andrenepomuceno/esp_garden/docs/architecture.md

# Project at a glance

ESP32 firmware for an automatic garden: soil moisture + luminosity + DHT11 + optional water level, a watering relay, a local async web dashboard, ThingsBoard MQTT/TLS telemetry, ThingsBoard RPC for remote commands, and browser OTA. **The ThingSpeak uplink and TalkBack are compiled OUT by default** since 2.12.0 — see [ThingSpeak and TalkBack are behind flags](telemetry.md).

| Layer | Path | Role |
|---|---|---|
| Entry point | `src/main.cpp` (108 lines) | Relay safe-init, device id, filesystem, config, logger backup, `webSetup()`, `tasksSetup()` |
| Orchestration | `src/tasks.cpp` (746) | **The single task-registration site.** Every `DECLARE_TASK`, every handler body, `tasksSetup()`, `tasksLoop()`, schedules, connectivity. **Every `g_*Task` object is `static` here**, so the file holding the registration order is also the only file that can arm, park or re-period a task |
| Task events | `src/task_events.cpp` (305), `include/core/task_events.h` | The asynchronous half of the io tick, and the two relay seams that feed it: `relayStartAllowed()`, `relayStartedHook()`, the relay / float / cloud / ET0 event publishers, and the post-watering response check. No `DECLARE_TASK`, no handler, no registration — it is what a handler DOES, not when it runs |
| Relays | `src/relays.cpp` (300) | Relay state under `g_relayMux`, `startRelay`/`stopRelay`/`startWatering`, the 50 ms critical tick |
| Sensors | `src/sensors.cpp` (547) | Every ADC read, the flow ISR, the float switch, the ambient sensor and its plausibility gate, `moistureState()` |
| Ambient — SHT40 | `src/sht4x.cpp` (I2C transport), `include/core/sht4x_protocol.h` (**pure maths, host-tested**) | The carrier's only temperature/humidity part. Hand-rolled: one command byte, a delay, six bytes, two CRC8s. Feeds the SAME accumulators and the SAME `temperature`/`airHumidity` keys as the DHT |
| Telemetry | `src/telemetry.cpp` (587), `include/core/step_publisher.h` | ThingSpeak field constants, `mqttAddField`, the periodic ThingsBoard payload, the change-based step publisher, the publish queue |
| Config | `src/config.cpp` (940), `include/core/config.h` | `ConfigFile` singleton + `g_*` reference aliases for the non-pin fields |
| Config — pins | `src/config_pins.cpp`, `include/core/pin_rules.h`, `include/core/default_pins.h` | What a GPIO can do, and the boot-time audit that applies it. One place, three consumers. Both headers are **per MCU family** and Arduino-free — the rules, and the compiled DEFAULT map a board uses until its `config.json` says otherwise; `config_pins.cpp` and `config.cpp` each pick one from `CONFIG_IDF_TARGET_*` |
| Config — `io` | `src/config_io.cpp` | Parsers for the `io` block, where every entry accepts several shapes so a field device keeps loading after a firmware update |
| Config — save | `src/config_document.cpp` | Whole-document validation before a write: the save-time counterpart of `loadFile()` |
| Logging | `src/logger.cpp` | Level-filtered singleton, 8 KB rolling RAM buffer, LittleFS backup rotating over 4 files |
| Web | `src/web.cpp` (573) | WiFi events, mDNS, `AsyncWebServer`, **the mode decision and the route table**, `/control`, `/logs`, `/history.json` |
| Web handlers | `src/web_data.cpp`, `web_config.cpp`, `web_ota.cpp`, `web_users.cpp` | `/data.json` cache · masked `GET`/`POST /config.json` · browser OTA · `/users.json` |
| Onboarding | `src/web_onboarding.cpp`, `include/core/onboarding.h`, `include/core/onboarding_templates.h` | The first-boot setup AP: the compiled page, the compiled per-family board templates, the captive-portal DNS and `POST /onboarding`. **WHEN it runs is `onboarding::decide()`, Arduino-free and host-tested**; the templates are a second per-family table selected from `CONFIG_IDF_TARGET_*`, exactly as `pin_rules.h` and `default_pins.h` are. See [First-boot onboarding](onboarding.md) |
| Auth | `src/custom_login.cpp`, `src/user_store.cpp` | Nonce + SHA-256 login, role middleware, per-IP lockout, `/users.json`, `/sessions.json` — ported from fullbot |
| MQTT | `src/mqtt.cpp` | Transport only: `PubSubClient` over TLS or plain, reconnect backoff, buffer sizing. `mqtt.backend` picks ThingSpeak `channels/<id>/publish` or ThingsBoard `v1/devices/me/telemetry`; `mqttBackendSupported()` refuses a backend this BUILD has no code for |
| ThingsBoard | `src/thingsboard.cpp` (791) | The downlink half: client/shared attributes, two-way RPC, the chunked `v2/fw` firmware stream |
| Versions | `src/fw_version.cpp` | Semantic-version compare — the check deciding whether a cloud image is flashed. Host-tested |
| TalkBack | `src/talkback.cpp` | Hand-rolled HTTP/1.1 POST to `api.thingspeak.com` (**plain HTTP, port 80**). **The whole translation unit is behind `USE_TALKBACK`, which ships at 0** — it compiles to nothing |
| History | `src/io_history.cpp`, `include/core/segment_index.h` | Append-only segments of I/O snapshots on LittleFS, served by `/history.json` |
| Moisture model | `src/moisture_classifier.cpp` (pure maths, host-tested), `src/moisture_model.cpp` (869; training, persistence) | Gaussian naive Bayes per probe, labelled by watering events. See [Soil moisture](soil-moisture.md) |
| Cloud cover | `src/cloud_cover.cpp` (pure maths, host-tested), `src/cloud_model.cpp`, `include/core/clear_sky_table.h` (**generated**) | Clearness index against an empirical clear-sky envelope. See [Cloud cover](cloud-cover.md) |
| Evapotranspiration | `src/evapotranspiration.cpp` (pure maths, host-tested), `src/et0_model.cpp` | Daily Hargreaves-Samani ET0 from the device's own temperature extremes. See [Evapotranspiration](evapotranspiration.md) |
| Stats | `src/accumulator_v2.cpp` | Fixed-size ring: rolling window mean + variance, allocating once |
| Web sources | `data/` | Plain, diffable, served as-is by the simulator. `index.*`, `login.*`, `config.*`, `users.*`, `update.*`, `auth.js`; vendored `jquery.js`, `sha256.js`, `spark-md5.js`, `bootstrap.css` (all MIT, shipped `.gz`); `favicon.ico`, `*.pem`, `config.template.json` |
| Filesystem image | `scripts/build_assets.py` → `.pio/assets/` | Bundles each page's scripts into one file and gzips everything the web server serves. `data_dir` points the image here, so `-t buildfs` cannot pack the unbundled sources |
| Partitions | `partitions/esp_garden_4mb.csv` | 1.69 MB per OTA slot, 512 KB LittleFS. **Cannot be changed over OTA** |
| Filesystem | `include/core/filesystem.h` | The one line naming the driver. Everything else says `FILESYSTEM`, never `LittleFS` |
| Tooling | `scripts/` | `dev_server.py` + `sim_state.py` / `sim_moisture.py` / `sim_config.py` / `sim_auth.py` (host simulator of the device HTTP API) · `provision_config.py` (turns a board template into that device's own `data/config.json`, reading the `ID:` boot line off the serial port and **refusing every document that would brick the board**, naming the check that refused) · `check_lines.py` (the file-size gate) · `moisture_calibration.py` · `moisture_fit.py` + `moisture_stats.py` + `moisture_thermal.py` + `moisture_thermal_report.py` (PC-side moisture fit; **refuses to emit a parameter the data cannot support**, naming the check that refused. The `thermal` pair asks whether ambient temperature biases a resistive probe and answers that this archive cannot say — it ships two admission GATES and no correction; see [Temperature IS a plausible confound](soil-moisture.md)) · `drying_fit.py` + `drying_models.py` + `drying_evidence.py` (the same shape aimed at the FALL: isolates genuine drying segments, fits linear / exponential / double-exponential / exponential-plus-linear against each other and **refuses an asymptote the data does not constrain** — it ran on the whole archive and refused every segment. `drying_models.py` is the four models and the fit; `drying_evidence.py` is the model comparison, the profile likelihood, the bootstrap and the trim check — split when the pair crossed the 1000-line gate) · `cloud_fit.py` (fits the clear-sky reference, writes the generated header) · `et0_fit.py` (geocodes `postalCode`, scores the device's ET0 against a public station — allowed to answer "do not enable this", and did) · `feeds_plot.py` · `tb_export.py` (incremental ThingsBoard → SQLite archive in `backups/`) · `tb_import.py` + `tb_client.py` (the WRITER, pointing the other way: that archive into a ThingsBoard instance, for the 2026-09-17 move off the Cloud tenant. Backdates through `POST .../timeseries/ANY`, **refuses to write at or after the archive's own newest point**, verifies by COUNTING both sides per key rather than by an HTTP status, and **reports the seam per key without stitching it**. `tb_client.py` is the session and the request body; split when the pair crossed the 1000-line gate. See [The migration off ThingsBoard Cloud](thingsboard-migration.md)) · `tb_swap_keys.py` + `tb_swap_model.py` (the same discipline aimed at a LABELLING error rather than a move: exchanges two telemetry keys over a closed past window, for the 2026-09-21 crossed probes. **Relabelling, not interpolation** — nothing is created or destroyed, the (timestamp, value) multiset is identical afterwards and `--verify` says so; the operation is a permutation and `--probe` proves on a throwaway device that applying it twice restores the original exactly. **Dry run by default**, re-emits each archived literal verbatim so ThingsBoard repeats its own typing decision, and **refuses a window boundary the stored series does not corroborate** — which is what it did to the boundary it was handed. `tb_swap_model.py` is the permutation, every refusal and the boundary evidence, network-free; split when the pair crossed the 1000-line gate) · `history_export.py` + `history_archive.py` + `history_store.py` (the same shape aimed at the DEVICE's own 60 s record: pages `GET /history.json` into `backups/history.sqlite` without duplicating or dropping a record across a segment rotation, and reports every gap rather than stitching it. `history_archive.py` is the walk, the buffer rule and the fit adapter; `history_store.py` is the SQLite half; split when the pair crossed the 1000-line gate. See [The 60 s record](soil-moisture.md)) · `device_http.py` (the nonce + SHA-256 client, shared by `moisture_fit.py` and `history_export.py` instead of copied) · `telemetry_ui.py` + `telemetry_page.py` (local read-only browser for that archive on **:8090**) · `flash_clone.py` + `flash_image.py` (the same discipline aimed at the WHOLE FLASH over USB, because no web endpoint can read one back: `read_flash 0 ALL` into `backups/flash/` with a sha256 manifest and the partitions split out, and `write_flash` the other way. **`--plan` is the default and a write needs `--yes`**; a backup **refuses without relay-safety evidence**, because download mode stops the app and a reset on a board with a running pump is the one thing not to do. It verifies by **re-reading the flash and comparing hashes**, never by esptool's exit code, and `--patch-id` rewrites the four-character `id` inside the image's LittleFS region so a clone boots as the board it replaces instead of into the setup portal — refusing unless the literal occurs EXACTLY ONCE, the length is unchanged, and the diff is provably surgical. `flash_image.py` is the image format and every refusal that is a pure function of an image: the partition-table parser checked against this repo's own CSVs, the `esp_app_desc_t` reader, the id arithmetic, the otadata slot rule and the LittleFS region scan — it opens no port, runs no subprocess and makes no request, which is why the 125-check `--self-test` lives against it; split when the pair crossed the 1000-line gate) |

**No source file exceeds 1000 lines, and `python scripts/check_lines.py` is what says so.** The rule sat here unenforced long enough that two files crossed it unnoticed — the gate exists because the honour system had already failed. It prints the largest files on success too: a failure arrives when the split is expensive, and the useful signal is the file three commits away from crossing. `tasks.cpp` (1123 and again at 998), `web.cpp` (1004), `config.cpp` (1125) and `devices.js` (1155) were all split at that threshold. `tasks.cpp` kept every `DECLARE_TASK` and every handler and `web.cpp` kept `webSetup()`, in both cases because the ordering *inside* those functions is load-bearing.

**`tasks.cpp` crossed a second time, and the second split says something the first did not.** It reached 998 of 1000 because two sessions grew it independently — one adding the `ambient` task for the SHT40, the other `tasksSetupOnboarding()` — and neither could see the other, so the next change to the file would have broken the build for a reason unrelated to that change. The seam is `src/task_events.cpp`: **the io tick's EVENT half plus the two relay seams**, which is everything in the file that was never about scheduling. Not one `DECLARE_TASK`, handler body or `addTask()` moved, `ioTaskHandler()` and `tasksSetup()` are byte-identical, and the registration order is still one readable list in one file. What the move BUYS beyond lines: `g_moistureBeforeWatering` stopped being a file-scope array visible to nine handlers and became `static` beside the hook that fills it and the check that reads it, and **every `g_*Task` object stayed in `tasks.cpp`** — the one reference that had to cross the seam goes through `armMoistureCheck()`, a named function, rather than reaching for a scheduler object from another translation unit.

Host tests live in `test/` and run under **`[env:native]`** (`pio test -e native`). Coverage is `AccumulatorV2`, the history segment arithmetic, firmware-version comparison, the moisture classifier, the probe-health verdict, the cloud-cover classifier, the evapotranspiration maths, the step-publisher change detection, the per-family pin rules, the SHT4x wire protocol and the onboarding decision plus its compiled templates — everything else reaches WiFi, LittleFS, `Arduino_JSON` or FreeRTOS. **The pattern for making something testable is to put the arithmetic in an Arduino-free header** (`segment_index.h`, `step_publisher.h`, `pin_rules.h`) rather than to stub the platform: a stub is small enough to look obviously right and wrong in a way that produces plausible answers instead of failures. See [test/README.md](../test/README.md).
