andrenepomuceno/esp_garden/docs/soil-moisture-sampling.md

# Soil moisture sampling period

`io.soilMoisturePeriodSec` — seconds between reads of the probe bank.
Default **1**. Editable in `/config.html`, under the **Io** tab.

Added in firmware 2.21.0. The two-phase read and the removal of the 250 ms
settle cap are 2.22.0. Several samples per window, `io.soilMoistureSampleMs` and
`io.soilMoistureTailSamples`, are 2.23.0. The value at exactly the settle and
the `timing` block are 2.24.0.

---

## The value at the settle, not at the wake (2.24.0)

**The problem.** No probe on `cfd0` reaches a plateau within the window. At
2000 ms the reading still climbs 2 to 19 counts per 100 ms, so a final sample
taken late reads drier.

The task is cooperative, and other tasks hold the scheduler:

- **`checkInternet` held it for ~1.06 s every 15 s.** It called
  `Ping.ping(addr, 2)`, and ESP32Ping waits `PING_DEFAULT_INTERVAL` (1 s)
  between the two pings.
- **Something else holds it for 180–400 ms, about every 1.2 s.** Not
  identified yet.

On Espada, 22 % of 2.22.0's published samples sat more than 0.6 points below
their neighbours (median 0.94 points, up to 3.98). A probe repeats to ±1–3
counts, so that is timing, not noise.

**Two fixes.**

- **`Ping.ping(addr, 1)`.** The three addresses are already the retry, so the
  1 s wait between two pings to the same address bought nothing. On a dead
  link the cost is now three of the library's 1 s ping timeouts instead of
  six plus three 1 s waits. That is arithmetic from the library source; a dead
  link has not been timed. A link is declared lost after three missing replies
  instead of six.
- **The published value is read at exactly `settleMs`.** It is the linear
  interpolation between the last sample at or before the settle and the late
  final (`probe_sampling::valueAt`). An on-time final is returned unchanged. A
  window with nothing before the settle cannot be interpolated and is
  published raw, as before. That is the default, `soilMoistureSampleMs` 0; the
  correction needs a window. With a tail above 1, the median runs over the
  last N samples with the final replaced by its value at the settle
  (`settledValue`).

The near-linear creep at the end of the window is what makes a straight line
the right model there. Over a 1 s gap on Espada the error is a few counts,
against the 40–160 the late reading cost.

**What is visible.** Each probe's `capture` block carries `rawAdc`, the
uncorrected final sample, beside `settledAdc`, the published value. A
top-level `timing` block covers the window as a whole:

| key | meaning |
|---|---|
| `settleMs` | the settle the last window was read at |
| `lastLateMs` | how far past it the last final sample landed |
| `windows` | windows completed since boot |
| `lateWindows` | how many of them were late |
| `lateMaxMs` | the latest one |
| `lateTotalMs` | the sum, so a mean is `lateTotalMs / lateWindows` |

**A settle under the 50 ms floor is late on every window, by design.** The
compiled 10 ms is read at 50 ms, so it reports 40 ms late each time. That is
true, and there is nothing to correct it with: there is no sample before the
settle to interpolate from.

**A spike in the bracketing sample leaks in only when the final is late**, and
then in proportion to how late. An on-time window publishes the final sample
alone. A tail above 1 is the guard against spikes.

**Probe health still sees the raw final sample**, for the reason given below.

---

## Several samples per window (2.23.0)

| key | default | meaning |
|---|---|---|
| `io.soilMoistureSampleMs` | **0** | a conversion every N ms while the bank is energised. 0 is a single one at the end of the settle, which is 2.22.0 exactly |
| `io.soilMoistureTailSamples` | **1** | the reading is the MEDIAN of the last N samples of the window. 1 is the last sample, which is 2.22.0 exactly |

With `settleMs` 2000 and a sample every 100 ms the bank is read at 100, 200, …,
2000 ms: twenty samples, the last on the settle. An interval that does not
divide the settle still ends on it (2000 / 300: 300 … 1800, 2000), and one
longer than the settle is a single sample. A bank with no power pin, or held up
by `powerAlways`, has no window and is read once, as before.

**Why it exists.** On `cfd0` every change of the acquisition time stepped all
four probes at once, by up to ~420 ADC counts, and a longer powered time always
read drier (the table is in [What has actually run](verification-log.md),
2026-11-09). Nobody knew where
the output stops moving, and every config experiment cost a reboot and a seam in
the data. The window answers it at every reading for no extra powered time.

**What is reported.** The median of the tail, not the mean of the window: the
reading is still rising during the window, so a mean would mix the transient in
and depend on the curve's shape. With the defaults nothing about the published
value changes. Turning the curve on (`soilMoistureSampleMs` alone) does not start
a new calibration epoch. From 2.24.0 it changes only the windows whose final
sample was late, and moves each back to what an on-time sample would have read. Raising `soilMoistureTailSamples` does. A tail
longer than the window uses every sample it holds, and `/moisture.json` says how
many (`tailUsed`).

**Timing is recorded, not assumed.** The task is cooperative, so a wake can land
late behind a ping or an MQTT drain. Each sample carries the milliseconds since
the bank came up as actually measured; a late wake takes one sample at the late
time and goes on to the next point of the schedule, it does not burst to catch
up, and the window still ends at the first wake at or after the settle. The
50 ms task floor is the finest real spacing: an interval below it is accepted
and simply measured at 50 ms (2000 / 10 is forty samples, not two hundred).
**The final sample is the one wake NOT held to the floor**, when samples came
before it: with a 199 ms grid the last one is at 1990 and the final still lands
on 2000, where a floored wait would have read at ~2040 and moved the published
value. With no window samples the floor applies exactly as in 2.22.0, so a
10 ms settle is still energised for 50 ms. The whole schedule —
`begin`/`step`/`waitMs` in `probe_sampling.h` — is host-tested against the floor;
`moistureTaskHandler()` only calls it.

**Probe health still sees one raw conversion**, the window's last, whatever the
tail. Its 400-count floating-pin threshold was measured on single conversions,
and a median of twenty would shrink a floating pin's spread under it.

**Refusals.** Either key that is not a JSON number, or out of range, is a boot
warning that names the value received, and the previous value is kept — a
string `"100"` does not become 0 in silence. A tail larger than the window can
produce is accepted and warned about at boot with the count the median will
actually use.

**Capacity is 64 samples per probe**, `probe_sampling::kCapacity`, and it is
storage, not a judgement: 4 probes x 64 x 4 bytes, held twice (the working
window and the snapshot other threads read), is ~2 KB of static RAM. A window
with more samples keeps the NEWEST 64 — the end of the curve, where the reading
is taken — and `dropped` counts the rest. The tail is refused outside 1..64 at
boot, with the previous value kept, because it cannot exceed what is stored.
The interval accepts 0..65535 like `settleMs`.

**`/moisture.json` carries it per probe** under `capture`: `intervalMs`,
`tailSamples`, `tailUsed`, `settledAdc` (the reported value in ADC counts,
before the polarity flip), `rawAdc` (the final sample as read, 2.24.0),
`dropped` and `count`. The window-level `timing` block is described in the
2.24.0 section above. The curve itself — the
parallel arrays `ms` and `adc`, `[]` before the first window — is added only
with **`?capture=1`**: at 64 samples on four probes it is ~512 cJSON nodes, tens
of KB of small allocations on a WROOM-32 whose largest free block is ~53 KB,
and the moisture page polls this endpoint. It is the last completed window,
published under the same spinlock as the reading. Telemetry and the history
record are unchanged: one value per reading.

The boot log now names the acquisition actually performed, e.g. `Soil moisture
every 60 s, settle 2000 ms, 20 sample(s) per window (every 100 ms), median of
the last 1` — the coalesced settle of the pins that switch, not every probe's
configured one, so a bank with no power pin logs `settle 0 ms, 1 sample(s)`.
Until 2.23.0 only the period was logged, so the 10-02 and 10-16 changes on
`cfd0` could not be read back from the device's own logs.

---

## The task sleeps until the next event, and is reentrant

It does **not** tick at the sampling period, and it does not poll. `delay()`
inside a task is forbidden here — background tasks are cooperative, so a
handler that sleeps stalls every other one for its duration — and the probe
bank needs a settle between energising its power pin and reading it.

So the handler carries its state in statics and does a little each call:

| state | what happens |
|---|---|
| the sample is due | energise the bank, note when it came up, return |
| still settling, a window sample is due | read the probes into the window, return |
| still settling, nothing due | return |
| the settle has elapsed | read once more, take the tail median, de-energise, return |
| nothing due | return |

and then sets its own period to the time until whichever deadline is next, so
the scheduler wakes it once per window sample plus once to power up, rather
than polling — twice per reading with the default single sample. **The
reentrancy is the contract and the period is only an optimisation**: woken
early it returns, woken late it acts, and a config change takes effect at the
next wake-up either way.

`g_moistureTaskPeriod` (50 ms, the tick the relays run at) is the floor, which
keeps the task from spinning when something is already overdue.

Measured on the state machine over 600 s, with the scheduler polled every 1 ms:

| period | settle | reads | wake-ups | gap | duty |
|---|---|---|---|---|---|
| 1 s | 50 ms | 600 | 1201 | 1000 ms | 5.00 % |
| 1 s | 10 ms | 600 | 1201 | 1000 ms | 5.00 % |
| 1 s | none | 601 | 601 | 1000 ms | 0 % |
| 5 s | 50 ms | 120 | 241 | 5000 ms | 1.00 % |
| 60 s | 50 ms | 10 | 21 | 60000 ms | 0.08 % |

Two wake-ups per sample, one when the settle is zero, and the gap is exactly
the configured period every time. A fixed 50 ms tick would have been 12 000
wake-ups in each of those rows; at a 60 s period this is **21 instead of
12 000**.

`nextSample` is stamped at the **power-up**, not at the read, which is what
makes the gap exactly `io.soilMoisturePeriodSec` rather than that plus the
settle.

**The 50 ms floor is also the settle's granularity.** A settle below it is
rounded up, so the compiled default of 10 ms energises the bank for 50 ms and
measures 5.00 % duty rather than 1.00 %. It is more settle than asked for,
which harms the reading not at all, and five times the power-on, which is
still twenty times better than the ungated 100 %. The carrier asks for 50 ms,
so the board this runs on is unaffected.

**`setPeriod()` is what the scheduler honours from inside a handler, and
`enableDelayed()` is not** — `Task::run()` calls the callback and then
overwrites `_nextRunTime = endTime + _period`, discarding anything the handler
set through `enableDelayed()`. That is why this sets the period.

## Why it is its own task

The probe read used to live in the `io` task, at 1 Hz. That task also:

- rebuilds the `/data.json` cache,
- publishes the relay, float, cloud and ET0 events,
- runs the step publisher,
- flushes the deferred `/sessions.json` write,
- computes the flow rate, which divides by the io period.

None of that may slow down because somebody wanted the ADC read less often, so
the probe block moved to a `moisture` task that takes its period from the
config. `sensorsReadIo()` keeps luminosity, water level, flow and the float.

Both are background tasks and the scheduler runs at most one per `execute()`,
so `webUpdateDataCache()` reading accumulators the moisture task writes is the
arrangement the `ambient` task has had since 2.14.0 — not a new race.

Background task count went 11 of 16 (12 with `USE_TALKBACK`).

## Accepted range

**1..10000 s.** Zero and negatives are refused because the value divides; the
upper bound only rejects absurd input. Out of range is a boot warning and the
previous value is kept — the same shape `history.periodSec` has. It is **not**
refused at save time, for the same reason the history capacity clamp is not:
the stored document is the operator's intent.

## What follows the period

The moisture accumulator window is `mqttPublishPeriodMs() / period`, floored
at 1. The floor is load-bearing: `AccumulatorV2::setMaxLen(0)` is a silent
no-op that would leave the window at whatever the constructor set.

`mqtt.publishSec` is clamped to 60..300. A sampling period longer than the
publish period therefore makes the window bottom out at 1, and the published
`moistureN` stops being a mean over a publish interval and becomes a single
sample. That is a consequence to know about, not a refusal.

## `settleMs` is 0..65535 and that is the storage, not a judgement

It used to be capped at 250 ms, on the argument that the delay ran inside the
1 Hz io task and a probe needing more was one to read less often. Moving the
read to its own task made the first half of that false, and removing the delay
made the second half moot. The range is now the one its `uint16_t` holds.

A settle longer than the sampling period is accepted. It degrades rather than
breaking: 2000 ms against a 1 s period measures 292 reads over 600 s, a
2050 ms cadence, and the bank powered 97 % of the time — which is the
continuous-power condition that dissolves a resistive electrode. That is a
consequence to know, not a value to refuse.

## What does NOT follow the period

`g_probeHealthMinSamples` (120) and `g_probeHealthWindow` (600) in
`src/sensors.cpp` are counted in **samples**, not seconds. At 1 Hz they are
2 min and 10 min; at 30 s they are 1 h and 5 h. The statistic is unaffected —
the wait for a first verdict grows, and the evidence ages more slowly.

### The 400-count threshold does not bound this setting

`g_probeHealthMaxSd` = 400 ADC counts flags a probe whose reading jumps further
between consecutive conversions than soil can. A slower period concentrates a
physical event into fewer, larger steps, so it is fair to ask whether a
watering starts to look like a floating pin.

It does not. Measured against the real `src/probe_health.cpp`, a synthetic
1200-count rise over 5 minutes in a 600-sample window:

| period | ramp only | ramp + sd-80 white noise |
|---|---|---|
| 1 s | 2.0 | 113.7 |
| 5 s | 6.0 | 113.8 |
| 10 s | 8.7 | 114.0 |
| 30 s | 15.4 | 114.5 |
| 60 s | 21.8 | 115.3 |
| 100 s | 28.2 | 116.8 |
| 300 s | 49.0 | 122.1 |

Noise alone, no watering: **113.7**. Threshold: **400**.

`probeHealthStepSd()` is the *mean-subtracted* standard deviation of
consecutive differences, so a steady ramp cancels almost entirely; what
survives is its edges, spread across the window.

**A correction worth keeping.** An earlier version of this change capped the
period at 60 s on the argument that a watering contributes `1200/300 = 4`
counts per sample at 1 Hz and `4 × P` at period P, crossing 400 at ~100 s.
That reads the `4` in `probe_health.h`'s table — a mean *step* — as if it were
the statistic. The real figure at 100 s is 28, not 400. The scaling direction
was right; the magnitude was wrong by more than an order of magnitude, and the
cap it justified was invented.

## The snapshot lock

`sensorsFinishMoisture()` computes its values **outside**
`g_moistureSnapshotMux`; the critical section is copies only — 32 bytes of
readings, the health reports, and since 2.23.0 the four windows (~1.1 KB in
all). `moistureCapture()` copies one ~270-byte window out under the same lock.
That is the largest interrupt-off copy on this core, and it is still a copy:
the tail median, the health update and the accumulator all run before it. The first version called
`getAverage()` inside it — four probes at a 60-sample window, walked twice
each, with interrupts disabled on that core — and the board panicked with
`InterruptWDTTimoutCPU1`. `probeHealthVerdict()` and `probeHealthStepSd()` are
outside for the same reason.

## Why `GET /config.json` fills the key in

`/config.html` generates its form from whatever the GET returns rather than
from a schema. A key absent from the stored document has no field, so on a
board provisioned before this key existed the setting would be unreachable
through the UI it was added for. `handleConfigGet()` therefore emits
`io.soilMoisturePeriodSec` with the value in force when the document has none,
and a save writes it back explicitly.

`?secrets=1` is unaffected — it returns the file verbatim, because a backup has
to restore what was actually stored.

## The 1 s every 60 s setting

`io.soilMoisturePeriodSec: 60` with `settleMs: 1000` on every probe energises
the bank for one second a minute: a 1.67 % duty cycle, and the reading taken at
the end of that second, when the module has had a full second to come up. The
old 250 ms cap forbade exactly this.

**Measured on `espgarden-s3` (device `cfd0`), firmware 2.22.0, 2026-09-28:**
`Soil moisture every 60 s` in the boot log, and the probe sample counter moved
at **60.2, 60.8 and 60.5 seconds**. Four probes reading 89.26 / 80.10 / 90.43 /
52.60 with the history intact at 9233/10000 across the update.

**What that does NOT establish is the second of power itself.** Nothing here
watched GPIO 14. The 1.67 % duty is arithmetic from the state machine, and this
project has never put a meter or a scope on that pin — the same gap the
`powerAlways` entry in the verification log records.

**Two consequences of a 60 s period, both real:** every moisture accumulator
window becomes `mqttPublishPeriodMs() / 60000` = **5 samples** at the 300 s
publish period, where a 1 s period gives 300, so the published `moistureN` is a
mean of five readings and `Sd` beside it is correspondingly noisy; and the
probe-health sample counts do not follow the rate, so a first verdict takes
120 samples = **2 hours** and the evidence halves over 600 samples = 10 hours.

## What has run, and what has not

**Not run on hardware. Nothing was flashed and no board was touched.**

Verified on the host and against `scripts/dev_server.py`:

- six envs build, `pio test -e native` 211/211, `check_lines.py` green;
- `GET /config.json` → edit → `POST` → re-read returns the new value;
- the simulator's `DeviceState` takes the period and stops sampling the probes
  on every tick;
- Chrome against the simulator renders a number input labelled
  *Soil Moisture Period Sec* in the `Io` tab.

Not verified:

- **any period other than the 1 s default, on a device.** At 1 s the behaviour
  is identical to 2.20.0 — same tick rate, same window, same health constants;
- the save button from a browser. Three clicks failed to register through the
  automation's coordinate frame and it was abandoned; the save path is covered
  by the HTTP round trip above and by nothing a browser did;
- `handleConfigGet()`'s fill branch on hardware — which is the branch every
  existing board will take.

Cost against 2.20.0: `espgarden2` **+1 004 B flash, +40 B static RAM**;
`espgarden_s3` +1 032 B and the same +40 B.
