andrenepomuceno/esp_garden/docs/filesystem.md

# Filesystem — LittleFS, and why the name appears once

`include/core/filesystem.h` is the only file that says `LittleFS`. Every other source says `FILESYSTEM`, so changing driver again is one line instead of the sixty substitutions across nineteen files it took to leave SPIFFS.

- **`board_build.filesystem = littlefs` in `platformio.ini` is the matching half.** Without it `-t buildfs` still runs mkspiffs, the image is a SPIFFS one, and the device formats it away on first mount — silently, because `begin(true)` formats on failure and the boot then looks normal apart from every file being gone. A build still producing `spiffs.bin` means the flag did not apply.
- **The migration cannot be done over the air, in either order.** Firmware first mounts a SPIFFS partition as LittleFS, fails, formats, and takes `/config.json` — and the WiFi credentials with it — on a device that is now unreachable. Filesystem first is erased by the old firmware's own format at the next boot. It is a USB job with a verified `?secrets=1` backup in hand.
- **It costs space rather than saving it.** Measured on 9e7c: SPIFFS 333 of 463 usable KB (72 %), LittleFS 388 of 512 KB (76 %) — 4 KB blocks against 256 B pages, so thirty small web assets pay ~55 KB of internal slack and free space went 130 → 124 KB. What was bought is the removal of SPIFFS's degradation cliff past ~75 % full, which this partition was about to reach.
- **The URL prefix is still `/spiffs/`** and stays that way. It is a contract with `data/*.js` and with anything scripted against the device; renaming a route to match an internal driver change is a breaking change bought for nothing.

## The ring buffer does not survive the move, and the reason generalises

**`IoHistory::append()` panicked the board every 60 s under LittleFS**, from the first history write after every boot, deterministically — verified 2026-08-24 on 9e7c, three consecutive `IntegerDivideByZero` panics 73-76 s apart with the same PC in `lfs_alloc` under `lfs_file_close`, called from `IoHistory::append`'s `close()`. Block allocation, sequential writes at any size (4 KB and 69 136 B uploaded and read back byte-identical) and the image itself were each measured on the device and were fine.

What IS wrong is the access pattern, and it is a design mismatch rather than a bug to patch. **LittleFS stores file data as a copy-on-write CTZ skip-list, built for appending.** Rewriting bytes in the MIDDLE of a file makes it copy the chain forward from that point: `append()` seeked to `16 + head * 48`, wrote 48 bytes, then seeked to 0 and rewrote the header — so with `head` near the start it rewrote **the whole 69 KB file, every minute, forever**. Fatal twice over: it crashed, and 69 KB of rewrite per 48-byte record is ~100 MB of flash writes a day on blocks rated for ~100 000 erases, which would have destroyed the partition in weeks while looking like it worked. **The design was correct for SPIFFS** (a 256-byte page per in-place overwrite) **and wrong for LittleFS. The lesson is not about littlefs: any copy-on-write filesystem turns random writes into whole-file rewrites, so in-place mutation of a large file is the thing to design out, not a knob to tune.** The fix is append-only segments, below.

`history.records` was set to 0 through `POST /config.json` to stop the panic loop without a reflash — that is what a panicking garden controller costs, because every reset floats the GPIOs and on these active-low boards pulses every pump for the length of a boot. It went back to 1440 the same day, once the rewrite was flashed.
