andrenepomuceno/esp_garden/docs/relays.md

# Relay seams — why `startRelay()` is the only door

`src/relays.cpp` owns switching and nothing else. Two seams connect it to the rest of the firmware, both declared in `include/core/relays.h` and both implemented in **`src/task_events.cpp`** (they were in `tasks.cpp` until that file hit the 1000-line gate a second time; the declarations never moved, so no caller changed):

- **`relayStartAllowed(index, reason)`** — asked BEFORE the relay is claimed. Today it is the reservoir interlock (`io.floatSwitch.interlock`): it refuses a pump while the float reads empty, and exempts `fillRelay`, because blocking the only thing that fixes an empty tank would deadlock the interlock against itself. **Put a new veto here, never at a call site** — there are five paths to a pump (web `/control`, TalkBack, a schedule, a ThingsBoard RPC, `checkMoisture`) and the one that gets forgotten is the one that runs dry.
- **`relayStartedHook(index, duration)`** — called after energising, for the watering bookkeeping (ThingSpeak field 2, the pre-watering moisture snapshot, arming `checkMoisture`) that switching itself knows nothing about. `startRelay()` returns `bool`. A refusal used to be a log line and silence; every caller can now say why nothing happened, which is what makes the RPC answer `{"ok":false,"error":...}` instead of a lie. **The interlock defaults to off** and must stay that way: an unwired float sits at the internal pull-up, which reads as empty, so a default-on interlock would stop every watering on every board that declares `io.floatSwitch` without a sensor wired to it. There is deliberately no auto-refill — one float failing toward "empty" would hold the fill relay on, and that failure mode is a flood.
