andrenepomuceno/esp_garden/docs/sensors.md

# Sensors, accumulators & telemetry

Every sensor compiles into every image; `config.*Fitted` and `config.moistureCount` decide which are read. See [Runtime hardware](configuration.md).

**Adding a sensor KIND = 8 edits** (adding an *instance* of an existing kind is now a web-UI edit): `config.h` pin field + fitted flag → `config.cpp` default, parse and `validatePins()` role → `config.template.json` → `sensors.cpp` accumulator + read → `sensors.h` extern → `telemetry.cpp` payload → `web_data.cpp` `Inputs` block (gated on the fitted flag) → `web_capabilities.cpp` kinds list → `dev_server.py` mock. Miss the last one and the simulator lies.

**A kind on a BUS costs more than that, and the SHT40 is the first one.** It has no pin of its own, so "`config.h` pin field" becomes a bus block shared with every future device on it; `validatePins()` needed a role that permits sharing rather than one that forbids it; and the template slot lands on `templates/config.espgarden_s3.json` rather than `data/config.template.json`, because the generic template declares a DHT and adding an `sht4x` beside it would silently disable that template's own sensor. The two are mutually exclusive by design — see [Two ambient sensors](ambient-sensors.md).

- Accumulator windows are sized as `mqttPublishPeriodMs() / g_<source>TaskPeriod`, so each average covers exactly one publish interval: at the 5 min default that is **300 samples** for luminosity, moisture, water level, flow and the DHT, and 20 for the ping. **`sensorsSetup()` sizes EVERY accumulator, scalars included**, and `tasksSetup()` sizes `g_pingTime`; see the `mqtt.publishSec` trap under Configuration. Arithmetic, not a measurement: the windows cost ~**10.6 KB of heap at 300 s against 2.1 KB at 60 s**, allocated once at setup.
- Conversions live in macros at the top of **`sensors.cpp`**: `ADC_TO_PERCENT(x) = x*100/4095`, and the water level uses a fitted curve `9 - 12*sin(4.04 - 1.61*V)`. Moisture is **inverted per probe, not per board** — `100 - pct` only when `moisture[i].invert` is set, which it is by default. It used to be unconditional, and that was one sign for a board that can carry a capacitive probe and a resistive one at once.
- **`AccumulatorV2` is a fixed-size ring buffer** and allocates exactly once, when its window is sized. It used to be a `std::list<float>` doing a push/pop per sample at 1 Hz forever, contradicting the "no dynamic allocation in steady state" rule and fragmenting the heap without end; `test_steady_state_does_not_allocate` counts array `operator new` and asserts zero across 5000 samples, so the rule is a red test rather than a note. **`getAverage()` is O(1)** — the running `sum`/`sumSq` are maintained by `add()`. It used to walk the list TWICE per read, and putting that inside a spinlock is what panicked the board with an interrupt watchdog. Incremental sums drift, so `resync()` recomputes once per full window. A non-finite sample is dropped rather than poisoning the sums permanently.
- **A DHT reading outside the part's RATED RANGE is a bad read, not weather, and is counted as one.** The device published `airHumidity` down to **15.1 %** while `dhtErrorRate` read 0.00 throughout: two failures compounding, since the out-of-range sample was averaged into every stored point *and* counted as a successful read, so the one counter that exists to say the sensor is misbehaving said the opposite. `sensorsReadDht()` now discards it **and increments `g_dhtReadErrors`** — dropping it silently would fix the first and keep the second. *(The bounds have since been widened to a 5 % humidity floor, because those sub-20 % readings turned out to be real Brasília dry-season air; see the DHT-gate entry under [What has actually run](verification-log.md). A rated range describes ACCURACY, not what the sensor can physically report.)*
- **The DHT is placement-`new`ed into `g_dhtStorage` inside `tasksSetup()`**, not constructed at file scope. `DHT_Unified` copies the pin in its constructor, and at static-init time `config.json` has not been read — a file-scope instance permanently ran on the compiled default and silently ignored `io.dht`. Keep the construction late; the storage buffer exists so this costs no heap.
- The MQTT payload is accumulated into a global `String g_mqttMessage` by `mqttAddField()` / `mqttAddStatus()` **called from several tasks** and flushed by `mqttTaskHandler`. Safe today only because one background task runs at a time; a critical task must not call it without a lock.
- The publish queue holds an hour of buffer at whatever period is configured — **60 messages at the 60 s floor, 12 at the 300 s ceiling** — **in RAM**, dropped oldest-first, lost entirely on reboot. **Backing it to flash was looked at and deliberately NOT done; read this before implementing it.** fullbot's `/telemetry_backup.json` writes to an **SD card**, appends a line per spilled message, and carries its own TODO about being unbounded. None of that transplants: this board has no SD, so the file would land on the same 512 KB LittleFS partition as the web assets, the history segments and the moisture model, with ~124 KB free — and a flash writer on that partition is exactly what [reboot-looped this board](filesystem.md), which is now reachable only over the air. A safe version would have to be **append-only**, **written only while the link is DOWN**, **bounded in bytes** with the oldest dropped, and drained by publishing then deleting the file wholesale. What it buys is 12 payloads of slow-moving levels across a reboot — step values already left the queue — which is a poor trade against a second writer on the partition that has bricked this garden once.
- **TalkBack is plain HTTP on port 80** with the API key in the request body (there is a `// TODO use HTTPS` in `talkback.cpp`). The only command parsed is `watering:<ms>`, capped at 20 000 ms by `startWatering()`.
- **`data/thingspeak.pem` pins the CA for MQTT TLS, and a stale pin fails silently for years.** It used to hold an *intermediate*; ThingSpeak rotated under it, so every connect returned `-9984 X509 - Certificate verification failed` and channel 1348790 received nothing between **2023-03-07 and 2026-08-19**. Nothing surfaced it. It now pins **roots**, not intermediates — roots last until 2038+, intermediates rotate. Verify with `openssl s_client -connect mqtt3.thingspeak.com:8883 -showcerts` before assuming the file is current.
- **There are TWO pem files, one per backend, and crossing them fails silently.** `data/thingspeak.pem` holds ONE root, DigiCert Global Root G2, which is what `mqtt3.thingspeak.com` chains to; `data/thingsboard.pem` holds the five below. A `thingsboard` backend pointed at `/thingspeak.pem` presents DigiCert to validate a Let's Encrypt chain and never connects — `templates/config.espgarden_s3.json` shipped exactly that until 2026-09-16, and the bullet above named the wrong file, which is where it came from.
- **`data/thingsboard.pem` is five roots**: ISRG Root X1 (to 2035), X2 (2040), USERTrust ECC (2038), and ISRG Root YR and YE (both 2045). `mbedtls_x509_crt_parse` accepts a concatenated PEM bundle, which is what makes pinning several roots one file. YR and YE were added because the live `thingsboard.cloud:8883` chain terminates in **`ISRG Root YR` cross-signed by X1**, and that cross-signature is transitional by design: pinning X1 alone worked *because of it*, and would have failed silently the day it was withdrawn — the exact signature of the 2023-2026 outage. **Verified, not assumed** (`openssl s_client -CAfile`): the live chain validates against the new bundle and — the check that matters — against **ISRG Root YR ALONE**. Both new roots are self-signed, so they are trust anchors and not cross-signed copies wearing the same name.
- **`/data.json` reports the LINK, not just the switch.** `MQTT` is the operator's toggle; `MQTT Link` is `connected` or `down (rc=N)` from PubSubClient, and `Last Publish` is the age of the last publish the broker accepted. Conflating the two is what made the three-year outage invisible: the dashboard said `MQTT: enabled` throughout, and only `Packages Sent` staying at 0 gave it away — a counter that resets every boot, so on a device up for an hour it reads the same whether the broker took everything or nothing.

## The `String` churn in the publish path was measured, and it is not there

**One periodic ThingsBoard publish makes 87 heap operations and asks for 5 131 bytes. Three of those operations and 48 of those bytes are the key `String`s.** The premise this was going to fix — "about twenty `String` allocations per publish" — is false, and the reason is that **the ESP32's `String` has a small-string buffer and every telemetry key fits inside it**: `SSOSIZE` is `sizeof(struct _ptr) + 4 - 1` = 15 on a 32-bit chip, so a key of 13 characters or fewer costs nothing at all. The three that do allocate — `temperatureNow`, `airHumidityNow`, `moisture1State` — are each exactly **14** characters and take one 16-byte block apiece, because a freshly constructed `String` is not yet in SSO mode and `changeBuffer(14)` fails `14 < 14`; the concatenation temporary that produced them stays inline. **Nothing in `telemetry.cpp` builds a longer key** (`moistureNFault` and `<key>State` are 14, `relayNRan` is 10, the rest shorter), so the whole key set sits one character inside the free tier — and a channel name two characters longer would quietly leave it.

Measured on the host against device 6224's fitted set (2 probes, luminosity, DHT, ping — 19 keys, a 578-byte payload):

| phase | heap ops | bytes |
|---|---|---|
| key `String`s | 3 (3.4 %) | 48 (**0.9 %**) |
| the `JSONVar` tree | 78 (90 %) | 2 014 (39 %) |
| `JSON.stringify` | 5 (6 %) | 3 037 (59 %) |
| the queue node | 1 | 24 |

**The tree dominates because `telemetry[k] = v` allocates FOUR times per key, not two.** `operator[]` calls `cJSON_AddNullToObject` — one item plus a `strdup` of the key — then `operator=` builds a *second* item and `cJSON_ReplaceItemInObjectCaseSensitive` `strdup`s the key *again* before deleting the first. That is the real inefficiency and it is deliberately not touched: it is inside `Arduino_JSON`, every payload builder goes through it, and that library has already caused one live incident here. The only reallocation-growth is cJSON's print buffer (256 → 534 → 1 076, trimmed to 579), the shape that condemned `AsyncResponseStream` — but three small blocks freed microseconds later, not tens of KB held under parallel load. **And the whole path is noise on this heap.** `webUpdateDataCache()` builds `/data.json` from the same io task on the same heap and measures **592 heap ops / 17 965 bytes** once a *second*, against 87 / 5 131 once per 300 s — 51.1 M allocator operations a day against 25 056, so publishing is **0.06 %** of the io task's own churn and the key `String`s are **0.002 %**. The step heartbeat allocates **no** key `String` at all. (The ThingSpeak branch really is built by concatenation — 13 ops, 720 bytes, 11 of them `String` — and this board does not take it.)

**Method, and what it cannot say.** Not the linked firmware: `buildThingsBoardPayload()` reaches sensors, relays, config and FreeRTOS. A host replay of its statement sequence against the **real** ESP32 `WString.cpp` and the **real** `Arduino_JSON`/cJSON, with `malloc`/`realloc`/`free`/`calloc` wrapped (`-Wl,--wrap=`) and global `operator new` replaced. Two corrections make the byte column the chip's and not the host's: `SSOSIZE` pinned to 15, and `sizeof(cJSON)` counted as **40**, read off the target with `xtensa-esp32-elf-g++`. A realloc counts at its new size, so the column is bytes *requested*, not peak. **Fragmentation is not measurable from here at all** — largest-free-block exists only on the device. **Nothing was changed**: no C++, no `FW_VERSION` bump, no flash.
