andrenepomuceno/esp_garden/tasks-inbox/009-devices-page-cannot-edit-sht40.md

# `/devices.html` cannot add or remove the SHT40

Surfaced by 001 rather than hidden. The page is pin-centric and this kind has no
pin of its own, so `devices_model.js` filters it out via `hasKind()`. Editing it
means `/config.html`.

Not a hazard: a save from that page carries `io.sht4x` / `io.i2c` through
untouched, and a relay wrongly placed on GPIO 8 is still refused at save time by
`documentPinsAreUsable()`. The page just will not *warn* first.

**Done means:** either the page learns to render a bus-attached kind, or the
limitation is accepted and the page says so where an operator will read it — not
only in CLAUDE.md.

Low priority. Nothing is wrong, something is missing.
