andrenepomuceno/esp_garden/docs/imgs/local_server.png

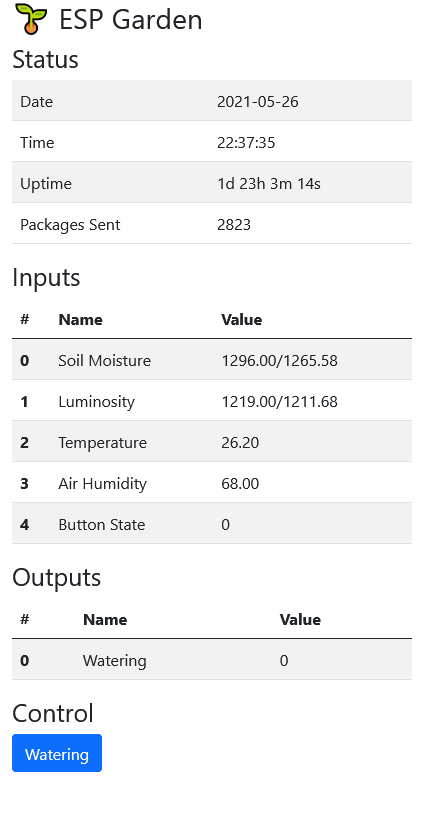
docs/imgs/local_server.png
