andrenepomuceno/esp_garden/docs/imgs/nodemcu_32s_pin.png

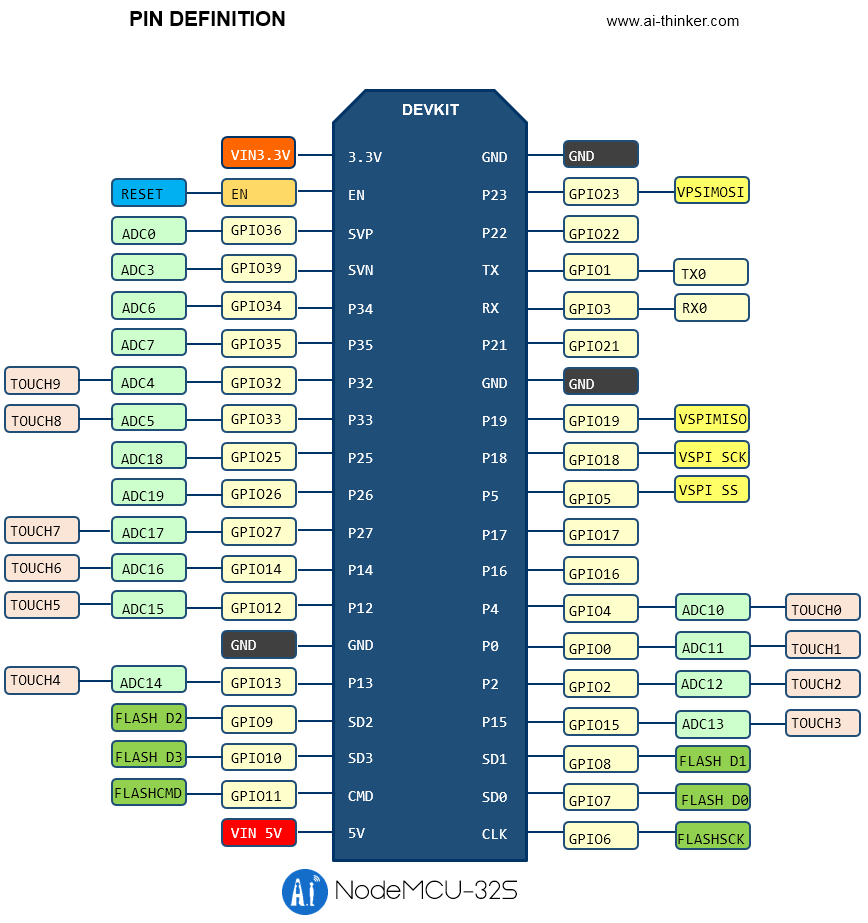
docs/imgs/nodemcu_32s_pin.png
