andrenepomuceno/esp_garden/docs/imgs/prototype0.jpg

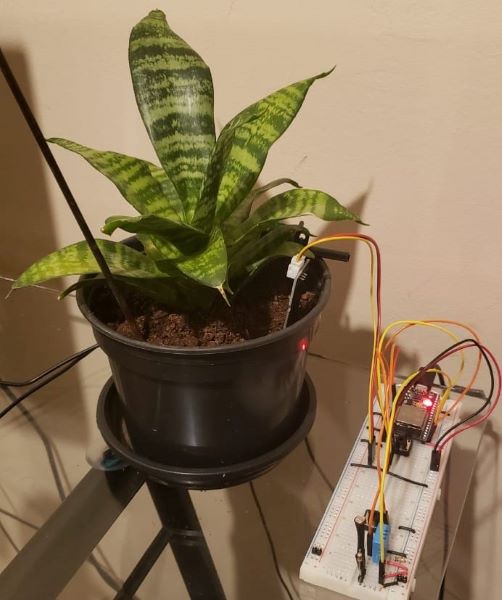
docs/imgs/prototype0.jpg
