andrenepomuceno/esp_garden/docs/imgs/prototype1.jpg

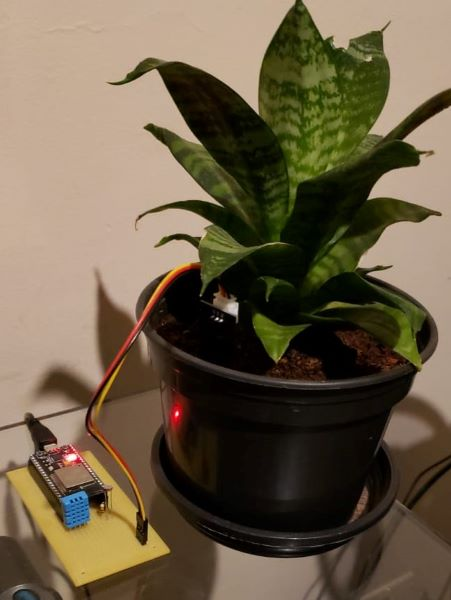
docs/imgs/prototype1.jpg
