andrenepomuceno/esp_garden/docs/imgs/prototype3.jpeg

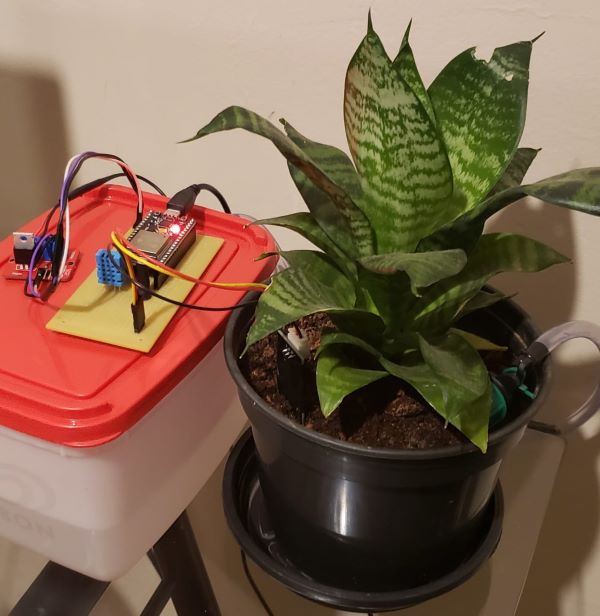
docs/imgs/prototype3.jpeg
