andrenepomuceno/esp_garden/docs/verification-log.md

# What has actually run

Every claim below this line is either **verified** — executed on the hardware or in a test, with the date — or **unverified**, which means it was written and compiles and nothing more. Move a line up only after running it. Adding a section to this file does not promote anything.

This exists because this document has been wrong: it claimed no page loaded a CDN script while all nine pulled Bootstrap from jsdelivr, claimed no source file exceeded 1000 lines while two did, and recorded `FW_VERSION` as `1.1.0` long after it was `2.1.0`. All three were found by a reader, not by the project. **A number without an execution behind it is a guess that has been formatted to look like a fact.**

**A hardware fault worth knowing before blaming firmware:** every boot prints `flash read err, 1000` and reboots once via `rst:0x10 (RTCWDT_RTC_RESET)` before coming up fine. The ROM bootloader fails its first flash read; that is marginal supply — a long USB cable, a hub, a sagging regulator — not code. It costs a few seconds of every boot and becomes a real boot loop if the supply gets worse.

- **Getting the board back after serial work:** `esptool.py --port COM7 run`. Hand-rolled DTR/RTS toggling left it in `DOWNLOAD_BOOT` — off the network, silent on serial, looking exactly like a hang.
- **Reading serial:** `pio device monitor` under a `timeout` truncates its buffer unpredictably, which made one healthy boot look like it stopped at three different places. Read the port directly and flush per line when the answer matters.
- **Keep the ELF of every image you flash** (`backups/elf/`). A core dump only decodes against the exact binary that produced it — a rebuild from the same sources does not match, because the app image embeds its own hash — and without it `espcoredump` refuses and the backtrace is garbage.
- **`open(): /littlefs/<asset> does not exist` on every page load is NOISE.** AsyncFileResponse probes the plain name before falling back to `.gz` and the ESP-IDF VFS logs that miss at error level whatever happens next. Verified on 6224: `/index.html` 200 gzip 1694 B while the log called it missing three times.

**THE S3 MODULE WAS REPLACED ON 2026-09-26, AND EVERYTHING BELOW THAT SAYS `b580` NOW DESCRIBES THE RETIRED ONE.** The garden runs the same carrier with a different ESP32-S3-DevKitC-1 in its socket: **device id `cfd0`**, MAC `d0:cf:13:1e:22:9c`, at **192.168.1.35**, on **COM5** rather than COM12. Address it as **`espgarden-s3.local`**, which is unchanged and is the point — the replacement is a full-flash clone of `b580` with the four-character `id` patched, so the hostname, the ThingsBoard access token, the calibration, the probe and relay names and the stored 60 s history all carried across, and the cloud device and its series are still the same one (confirmed on both sides; see the 2026-09-26 entry). The two modules are the same part — QFN56 rev v0.2, 8 MB flash, 8 MB AP_3v3 PSRAM — so **nothing about the readings, pins or timings changed with it**, exactly as the WROOM-32 swap below. What DID change is the id, the IP and the serial port.

**The board was replaced on 2026-08-31.** The NodeMCU-32S died; the garden now runs an **ESP32 DevKit v1 built by `[env:espgarden2]`, device id `6224`**, at **192.168.1.242** — address it as **`espgarden1.local`**, which is what the device's own mDNS publishes and the only name that survived the DHCP lease moving it off the 192.168.1.55 this line used to give (found 2026-09-17; see the live-archiver entry below). Everything below that says `9e7c` was measured on the dead board and still describes this firmware — same ESP32-WROOM-32, so nothing about the readings, pins or timings changed with it.

## Swapping the board

**No pin changes were needed between the WROOM-32 boards, and that is worth knowing before anyone invents some.** `espgarden1` and `espgarden2` differ by exactly one line — `board = nodemcu-32s` against `esp32doit-devkit-v1` — and the `-D ESPGARDENn` flags they carry are read by nothing in the tree. Same module, same 4 MB, same `LED_BUILTIN` on GPIO 2; every pin the config uses exists on both.

**What DOES have to change is `id`, and getting it wrong bricks the board.** `ConfigFile::loadFile()` rejects the whole document when `id` does not match `ESP.getEfuseMac() % 0x10000`, so the old config on a new chip means compiled defaults, `ssid "undefined"`, and a device that cannot associate or be reached to fix. Read the id from the firmware's own `ID:` boot line rather than deriving it from esptool — that line is by definition the number the check compares against. Every other field carries over, and carrying the ThingsBoard credentials over is what keeps the cloud device, and its telemetry history, the same one. **Do it with the relay board DISCONNECTED**: every reset floats the GPIOs and these relays are active-low.

**Verified on hardware (devices `9e7c` and, from 2026-08-31, `6224`):**

- Nonce + SHA-256 login, roles, per-IP lockout, persistent sessions.
- ThingSpeak *and* ThingsBoard MQTT over TLS. Channel 1348790 entry 304860 was the first publish since 2023-03-07, after the CA pin was corrected (2026-08-23); ThingsBoard connected on `thingsboard.cloud:8883` the same day.
- ThingsBoard downlink **subscriptions** — all four topics confirmed in the device log at debug level (2026-08-24).
- Browser OTA of both firmware and filesystem, including recovery from a half-written filesystem via serial.
- `GET /config.json?secrets=1` → edit → `POST` round trip, verified by byte count (1267 sent, 1267 written). The masked-secret restore path.
- The I/O history **ring** and `/history.json`, under SPIFFS. (The append-only segments that replaced it have since run on the device — see below.)
- Relay switching, the 30 s ceiling, the sticky mask in the history record.
- Probe readings: three probes at 42.9 / 57.0 / 52.6 with variances ≤ 0.10.
- **Heap under load** (2026-08-24, firmware 2.2.1). Six endpoints hammered in parallel — including `/history.json?limit=200` — eight rounds, zero failures. 269 KB free at boot, ~115 KB steady, **76 KB at the low-water mark**. Memory is not the constraint it was assumed to be; the number to watch is the largest free block, which drifts 53 → 49 KB while free stays flat. **A String was NOT enough, and the failure is silent — chunked generation is what fixed it.** With 548 records stored, `GET /history.json?limit=200` — what the history page requests on every load — answered **200 OK with a Content-Length of ZERO**: ~35 KB of String plus the ~35 KB copy `beginResponse` makes do not fit beside a 53 KB largest free block, and the page just shows nothing. The handler now emits one record per filler callback, so peak is independent of `limit`. Verified at 5 / 100 / 200 records and with `window=86400`. **`AsyncResponseStream` was tried as the fix, made it worse, and is withdrawn — do not re-introduce it.** Same eight-round parallel load: largest free block **53 → 33 KB** (once to 16), low-water heap **76 → 60 KB**. Its buffer grows by reallocation and leaves a hole at every step, where one `reserve()` is a single allocation. The double copy costs PEAK; the stream costs FRAGMENTATION, and fragmentation is what bites a device that stays up for months.
- **Runtime hardware.** Firmware 2.2.0 boots off `config.json` alone and logs what it decided: `Sensors: 3 moisture, luminosity, DHT, water level, flow, float switch`, `DHT11 on GPIO 23`, `Flow sensor on GPIO 27`. No `HAS_*` flag exists any more (2026-08-24).
- **`GET /capabilities.json`** — `relayMax 8`, `moistureMax 4`, `analogPins [32,33,34,35,36,39]`, `reservedPins [1,3]`, from the same predicates `validatePins()` uses.
- **`GET /moisture.json`** — answers on the device, reports the gates and `blockedBy: "not trained yet"` for all three probes. The endpoint and the refusal path are exercised; the FIT is not.
- **`POST /spiffs/delete`** (2026-08-24). All four refusals fired: `/users.json`, `/config.json` (use the validating endpoint), `..` in the path, and a 404 for a path that is not there — deliberately, so a wrong path is reported rather than silently succeeding.
- **`POST /spiffs/upload`** (2026-08-24). A 48-byte file written and read back byte-identical, 139 KB still free; all four refusals fired (wrong MD5, `/config.json`, `/users.json`, `..`).
- **The relay guard on the browser OTA** (2026-08-24). With Zona 2 energised, `/updateEnable` answered **409 "Zona 2 is running. Updating reboots the device, and a relay is energised across a reset."**; 200 once the relay expired.
- **The vendored `bootstrap.css.gz`** — served from the device at 29 899 bytes. No page reaches a CDN any more.
- **The moisture classifier's TRAINING pass, on real data** (2026-08-24 08:22). One watering of Zona 2 was detected as a single rising edge and the 33 readings in the 60-minute window before it were labelled DRY (`probe 1: +1 events (1 total), J=0.0, dry/humid/wet = 57.1/0.0/0.0`, `trained on 56 records, 33 samples, 0 outliers dropped`). Humid and wet stayed empty, which is the consumption window working: the cycle is not complete until the NEXT watering bounds it. The gates then refused the probe at 1 of 6 events. **Verified: the labelling, the window, the refusal. Still not: a complete cycle, and with it the first non-empty WET class.**
- **The `IoRecord` layout change** — the 40 → 48 byte growth was detected by the header check and the buffer reformatted rather than misread.
- **The SPIFFS → LittleFS migration** (2026-08-24, firmware 2.5.0, over USB). After it: `/config.json` intact at 1219 masked bytes with `id 9e7c`, all six credentials present, admin login working against the migrated `/users.json`, every asset serving, `/history.json` answering, and the three `/spiffs/` 403 shadows still firing under an ADMIN token. History and moisture model were reformatted, as expected. **A one-off panic on the FIRST boot after it, not reproduced since.** `Core 1 panic'ed (LoadProhibited)`, `EXCVADDR 0x00000028`, return address `0x400933ac` = `multi_heap_internal_lock` — heap corruption raised inside `webSetup()`. Five deliberate resets afterwards produced zero panics. Recorded rather than dismissed because a boot panic on an active-low relay board pulses every pump for the length of a reset. **No cause is established**: one sample, corrupted backtrace, and a board that already prints `flash read err, 1000`. If it recurs, take a core dump (`esptool read_flash 0x3F0000 0x10000`) against `backups/elf/firmware-2.5.0-littlefs.elf`.
- **The append-only history, on the device** (2026-08-24, firmware 2.6.0, over the air). Uptime passed ten minutes where the ring panicked at ~60 s every boot; `hist0.bin` was **492 bytes — a 12-byte header plus exactly 10 records of 48** — while `hist1..7` were still 404 (lazy creation). Deleting the legacy ring freed 69 KB: filesystem 392 → 332 KB. **Flash usage is flat, which is the number that condemned the ring.** Over eight consecutive appends `hist0.bin` grew 972 → 1356 bytes, exactly 48 per record, while the filesystem stayed at 336 KB. Copy-on-write reuses the last block until it fills, so a 48-byte append costs one 4 KB block rewrite rather than the ~69 KB the ring paid — roughly 1440 block erases a day against blocks rated for ~100 000. (That erase count is arithmetic from the measurement; nothing here reads the wear counters.) **A rotation is NOT yet exercised.**
- **The firmware OTA path, end to end** (2026-08-24). 1.2 MB uploaded to a board with no USB attached, `/updateEnable` armed against idle relays, version confirmed by polling until it changed — the upload's own connection timed out after 420 s, which is not a verdict. Two web assets then went up individually through `/spiffs/upload` and read back byte-identical.
- **The page-load fix** (2026-08-25). Before: `devices.html` pulled 7 requests and **1 of 3 loads** returned a truncated asset, largest free block collapsing 45 → 1 KB. After bundling and gzipping: **4 requests, 10/10 clean loads, largest free block steady at 53 KB.** Nine pages were deployed one file at a time through `/spiffs/upload`, so `/config.json` was never at risk; filesystem 392 → 320 KB. **Two reboots were self-inflicted and are recorded as such.** Eight parallel requests in back-to-back rounds tripped an **interrupt watchdog** once; a second reboot logged `software (ESP.restart)`. Between them the board ran **15 hours** unattended with no reboot. Load-testing an active-low relay board is not free: every reset pulses every pump.
- **Firmware 2.6.1, over the air** (2026-08-25): the five-root CA bundle validated **on the device** (uploaded before the OTA on purpose, so the update's own reboot was the test — `mqttSetup()` reads the CA once at boot, so a bad bundle would surface only at the next reset, silently); `MQTT Link` and `Last Publish` answering; the superseded-twin deletion logged four times (`[upload] removed the superseded /config.js`); the exact upload guard unblocking `/config.*` and `/users.*`; all nine pages serving gzipped at 4 requests (5 with a vendored sha256/SparkMD5); and the history surviving the OTA reboot at `1139/1440 records across 7 of 8 segments`.
- **The board swap, end to end** (2026-08-31, device `6224`). A virgin DevKit v1 took the firmware, printed `ID: 6224`, and the config rewritten with that one field loaded: WiFi up, `MQTT Link: connected`, a publish accepted 9 s later — so the ThingsBoard device and its history survived the hardware. Login worked against a `/users.json` seeded from `ota.*` on first boot.
- **The polarity default, against ground truth** (2026-08-31). With the soil reported wet by the operator, both connected capacitive probes read 128 ADC counts (0.10 V) and the dashboard showed 96.87 — the wet end. `invert` true is right for the capacitive v2, confirmed against the pot rather than a datasheet, and it is the first end-to-end check that the conversion, the polarity and the displayed number agree.
- **The probe health check, on the device** (2026-08-25, firmware 2.7.0, over the air). All three unplugged probes flagged within minutes: `/data.json` carries `fault: "noisy"`, `/moisture.json` names the spread — 1113, 1773, 1753 ADC counts in one window. Every connected sensor passed: temperature 4 counts, air humidity 20, luminosity 164 while the light was changing.
- **The probe health check, on a second chip** (2026-08-31). `fault` absent while `samples < 120` — no evidence is not health — and all three unplugged probes flagged `noisy` from 3 minutes in, at sd 885/1745/885 against temperature at 0.00-0.03. One probe read `var 0.00` in the instant it was still flagged, which is the decayed evidence deciding rather than the current window.
- **The OTA fixes and the honest upload report** (2026-08-31, firmware 2.7.3). The three faults below were found because `/update.html` reported `ERR_CONNECTION_RESET` on every attempt while the flash was in fact landing. After 2.7.3 both a firmware image and `update.js.gz` went up through the page (`[upload] wrote /update.js.gz (5085 B)`).
- **Firmware 2.8.0's telemetry change, over the air** (2026-09-03, device 6224). One clean boot, `software (ESP.restart)`, no panic; the board was unreachable for **21 s**. Heap 110 KB free, 93 KB low-water at 16 minutes with the larger accumulator windows already allocated. **`mqtt.publishSec` = 300 holds** — publishes 300 s apart, the first 301 s after boot, so `setPeriod()`/`enableDelayed()` take the configured value and not the compiled 60 s. **The instantaneous twins are stored and the averages kept their meaning.** All six `*Now` keys arrive beside the original names, which still carry `getAverage()`; the ThingsBoard key count went 37 → 43 and no stored series changed meaning. **Step values are off the periodic tick.** A periodic payload carried exactly 12 continuous keys; the nine step keys appeared once at the **900 s heartbeat**, 902 s after boot. `firmware` published once at boot and not since. **Composition, both sides measured:** 12 continuous × 288 ticks + 9 step × 96 heartbeats = **~4 320 datapoints/day**, against the **25 100/day** measured on 2.7.3 — about **-83 %**, on a board with two probes and no water level.
- **The resistive probes' transfer curve, and the first working two-point calibration** (2026-09-03, device 6224). Five conditions measured by hand and converted to raw ADC, the units the physics is in:

  | condition | shown | ADC |
  |---|---|---|
  | wet soil, Zona 3 (archive mean, n=1099, undisturbed) | 75.52 | 1002 |
  | wet soil, Zona 1 (archive mean, n=1099, undisturbed) | 73.48 | 1086 |
  | air — a still-damp probe, mid-transit | 59.32 | 1666 |
  | **dry soil**, Zona 1, a different pot | 53.11 | 1920 |
  | water, submerged | 0.00 | 4095 | **Four of the five are monotonic in the direction physics predicts** — wetter reads lower — which confirms `invert: true` for these resistive probes at both ends of soil rather than by inference. The "air" point is a consistency check, not an anchor: a still-damp probe should land between wet and dry soil, and does. **Submersion is out of domain**: a submerged divider should read the extreme WET end and read the opposite rail; comparator saturation or shorted electrodes are both plausible and neither was established. Soil is never submerged in tap water, so it is excluded by irrelevance, not by mystery. Applied as `moisture[0] = {dry 53.1, wet 73.5, kind "resistive"}`. Sent 1020 bytes, device wrote **1060** — the +40 is five 8-character masks replaced by real credentials, and since the handler REFUSES a document still carrying a mask, the 200 is itself proof the restore worked. After the reboot `/data.json` carries `state: "Wet"` on Zona 1.
 **Zona 3 was deliberately left uncalibrated** (`dry == wet == 0`), so `moistureState()` returns empty and the field is absent rather than invented. Its wet end is measured; its dry end never was. The two wet ends differ by only 2.0 points, so borrowing was tempting — and is exactly what this file forbids, because a threshold is per-probe. **`dry` is an UPPER BOUND, not the dry value.** The probe was still falling at ~0.15 per 30 s when it came out of the dry pot. That narrows the span and makes the badge say "humid" slightly earlier, which for a garden is the right side to err on. Redo it when a zone dries on its own.

- **A segment RECYCLE, and the retention swing** (2026-09-11, device 6224, firmware 2.13.1). Four days of uptime at the 60 s period is ~6 300 records written against a capacity of **3 000**, and `Status.History` reads **2 628 / 3 000** — three records above `7/8 × 3000 = 2625`, i.e. a whole segment has just been truncated and reused and the buffer is starting to refill it. The boot log's `ready, 2712/3000 records across 8 of 8 segments (375 each)` is the same band a reboot earlier. **The oldest unverified item in this file, and the swing between 7/8 and 8/8 was until now tested only on the host.**
- **ThingsBoard RPC, end to end through a dashboard widget** (2026-09-11). A **Command button** on a ThingsBoard Cloud dashboard, target device `espgarden1`, two-way RPC, method `getRelays` — the round trip answered. So the subscription, the request routing, the method dispatch and the response publish all work on the device, which this file recorded as *"no command has been sent"* since the downlink was written. **`getRelays` reads state and energises nothing, which is why it was the first one sent**; which of the WRITE methods have been exercised beyond it is not established here. Two settings matter and are not defaults: the widget must be **two-way**, or `{"ok":false,"error":...}` is invisible and a refused command looks like a successful one; and its **5 000 ms timeout is tight** — the reply leaves from `tbLoop()` inside `loop()`, which a blocking background task (three pings, a model training pass) can stall for seconds, so a timeout there is not a failure.

- **The first boot of ANY esp-garden code on ESP32-S3 silicon** (2026-09-16, a bare ESP32-S3-DevKitC-1-N8R8 on USB, no carrier, nothing wired, firmware 2.15.0). `chip_id` reported **ESP32-S3 (QFN56) revision v0.2, embedded PSRAM 8 MB**; the app flashed at 0x10000, **1 261 200 bytes, hash verified**, and it booted. Six things this file listed as unverified are now measurements:

  - **`partitions/esp_garden_8mb.csv` has been written to a flash and booted from.** It had never been. `SPI_FAST_FLASH_BOOT`, and — unlike every WROOM-32 board here — **no `flash read err, 1000` and no RTCWDT reset**: that fault is those boards' supply, not this firmware.
  - **`ID: b580`**, so `ESP.getEfuseMac() % 0x10000` answers on this family. LittleFS mounted on the 2.375 MB partition and is writable (`Current log: log1.txt`).
  - **`ioHistoryFitCapacity()` ran on a device for the first time, and took the branch that could not be taken before.** The reserve is `max(64 KB, partition/8)`, and on 6224's 512 KB partition both terms are 64 KB so **the "larger of" had never chosen**. Here the partition is 2424 KB, so it chose the proportional term: *"1440 records fit ~96 KB of the 2424 KB available once the 304 KB reserve is taken out"*, then `ready, 0/1440 records across 0 of 8 segments (180 each)`. The arithmetic this file carried as host-only is now a device's own answer.
  - **The onboarding portal's arm 1 fired, end to end.** `SETUP PORTAL: /config.json is missing, unparseable, addressed at another chip, or short of a required field` → `Raising AP 'espgarden-b580'` → `Web setup done (setup portal)`. The AP's security property is stated in the boot log itself, not only here.
  - **`tasksSetup()`'s portal path works and the 120 s block is gone.** `Tasks setup done (setup portal: relays and blink only)` — **boot to portal in 5 s**, where the normal path would have spent up to 60 s pinging and 60 s on NTP with no internet to find.
  - **The `No users defined` FATAL still prints**, which is correct and is now answered by the portal rather than being the end of the road.

  **Three of the four caveats this entry first carried were withdrawn within the hour, and the withdrawal is the interesting part** — see the entry below. The one that stands: **no ADC has been read, no relay switched and no I²C transaction attempted**, because nothing is wired to this module. *(The original text also said this workstation has no WiFi radio, on the strength of `netsh wlan show networks` printing nothing. It has an Intel AX211; the adapter was merely disconnected. A command that returns nothing is not a command that answers no.)*

- **Eleven review findings, fixed (firmware 2.17.0).** Six envs build, 201 host cases pass, `check_lines` green. Flashed to `b580` and `login.js` redeployed through `/spiffs/upload`; `/device.json` re-read from the board, carrying `Cache-Control: no-store` and parsing. **The one that mattered was a guard this session had weakened.** `config_guard()` was relaxed to allow a filesystem image with no `data/config.json`, which is right for `buildfs` and wrong for the other two targets in `FS_TARGETS`: `data/config.json` is gitignored, so "absent" is the normal state of a fresh checkout and says nothing about the board on the cable — and `-t uploadfs` would then have erased a PROVISIONED board's config, history and moisture model and brought it back raising the open setup AP. Previously refused outright. The guard now takes a `deploying` flag; all four paths were exercised (no config + buildfs ALLOWED, no config + uploadfs REFUSED, WROOM document + buildfs REFUSED, `espgarden2` untouched). **The permission classifier flagged that original edit as a security weakening and was right in spirit; the argument overriding it only covered `buildfs`.**

  The rest: `/device.json` and the onboarding success body **built with `JSONVar` instead of concatenation** — `hostname` and an 802.11 SSID are operator text checked only for length, and a quote in either emitted a body no client could parse; `/device.json` moved OUTSIDE `#if USE_CUSTOM_LOGIN` (the login page it serves is registered unconditionally, and the simulator answered unconditionally — mirror drift), built ONCE per boot rather than per request, and given `Cache-Control: no-store` like every other JSON route, since a cached hostname names the wrong board; `beginResponse()` null checks added to `handleInfo()` and `handleSubmit()`, and **the existing one in `handleCaptive()` changed from a bare return to `request->abort()`** — returning does not avoid the panic, because the library then builds its own 501, allocates again on the same exhausted heap and dereferences the result unconditionally; and `login.js`'s private `setStatus()` replaced by the shared `espUI.setStatus`, so the one page handling credentials is no longer the one page opted out of the escaping rule.

  **Neither escaping fix has been exercised.** No hostname and no SSID containing a quote has been through either path; `JSONVar` is trusted here on the strength of every other payload in this firmware going through it, not on a test. The `abort()` paths are likewise unreached — they need a heap too exhausted to build a 302, which has not happened.

  **And a convention this session broke:** `c540dcb` changed the compiled portal page without bumping `FW_VERSION`, which arrived one commit later. Two different images therefore identify as 2.15.0. Harmless in fact — 2.15.0 only ever reached `b580` over USB and was never offered as a package — but the rule exists because `fwVersionDiffers()` would answer false and the broker would report a successful update that never flashed. History is pushed and is not being rewritten to hide it.

- **The carrier board arrived, and the SHT40 answered** (2026-09-17, device `b580` on COM12, firmware 2.17.0 and then 2.18.0). An ESP32-S3-DevKitC-1 in the `esp-garden-hardware` carrier's socket, on a bench with **nothing on the relay outputs and nothing planted**. Every line below is a serial line or an HTTP response.

  - **`validatePins()` has now run against real carrier wiring, and it said NOTHING.** That is the clean verdict and not a filtered one: the audit logs only at `ERROR` and `WARNING`, this board's `log.level` is 4 (`LOG_INFO`) which prints both, and the call sits between `Loaded 0 schedule(s).` and `Loading done.` — two lines present in every boot log of this session. It covered 4 relays on 10-13, 4 probes on 1/2/4/5, one shared probe power pin on 14, the LDR on 6, flow 15, float 16, the button on 18, and — once declared — the I²C bus on 8/9.
  - **No `flash read err, 1000` and no RTCWDT reset on any of the eight boots.** `rst:0x1 (POWERON)`, `boot:0x8 (SPI_FAST_FLASH_BOOT)`, `Free heap at boot: 299 KB`, `ID: b580` every time. That fault is the WROOM-32 boards' supply and not this firmware — now on eight boots rather than the one 2026-09-16 had.
  - **THE COMPILED ONBOARDING TEMPLATE DID NOT DECLARE THE SHT40, WHICH IS WHY THE PART HAD NEVER BEEN ASKED.** `kJsonCarrier` in `onboarding_templates.h` carried no `io.i2c` and no `io.sht4x` while `templates/config.espgarden_s3.json` carried both, and nothing but that string decides what a portal-onboarded board reads. So `b580` came up `Sensors: 4 moisture, luminosity, flow, float switch` — no `Temperature`, no `Air Humidity`, no `Ambient Sensor` row at all. **The template's own comment said why**: it was written while "this firmware has no driver for" the part, and was not revisited when 2.14.0 added one. Fixed in 2.18.0, and `test_onboarding` now holds the carrier template to declaring both and the WROOM-32 templates to declaring neither (203 host cases, up from 201). The fix costs **+96 B flash and +0 B static RAM** on `espgarden_s3` — a clean A/B against the archived 2.17.0 ELF, `text` byte-identical at 1 019 626 and the whole delta in `.data`, which is the two JSON fragments and a longer summary string.
  - **The SHT40 answers.** With the two blocks added by hand through `GET /config.json?secrets=1` → edit → `POST` and a reboot: `SHT40 at 0x44 on I2C SDA 8 / SCL 9 at 100 kHz`, and `Sensors: 4 moisture, luminosity, SHT40, flow, float switch`. `/data.json` carries `Status."Ambient Sensor": "SHT40"`, `Status."Ambient Error Rate": "0.00"`, and `Temperature` / `Air Humidity` under exactly those unprefixed keys. **30.37–30.79 °C and 35.97–38.21 %RH** over half an hour on an indoor bench in Brasília in September: plausible for the room, and quiet the way a digital part is — temperature `var 0.00` throughout, humidity `var 0.03–1.60`. So `sht4xBegin()`, the `0x94` soft reset, the `0xFD` high-repeatability command, the wait, the six-byte frame and **both CRC8s** have executed against silicon, and the conversions returned numbers a room can have. **What this does NOT establish is ACCURACY**: there was no reference instrument on the bench, so the datasheet's ±0.2 °C and ±1.8 %RH are exactly as untested as before.
  - **The failure paths ran too, and they were the cheap half.** `io.sht4x.address` set to a wrong-but-valid **0x45**: `No I2C device acknowledged address 0x45 on SDA 8 / SCL 9. Temperature and humidity will not be read.` — so `sht4xBegin()`'s false branch and the message naming the address are real. The consequence is the documented "fitted and broken" signature rather than "not fitted": `Ambient Sensor: SHT40` still present, `Temperature` and `Air Humidity` at `0.00`, and **`Ambient Error Rate: 100.00`** once a read had been attempted, which is `kNotReady` climbing on the ambient task. Set to an out-of-range **0x50**: `io.sht4x.address 0x50 is not an SHT4x address (0x44..0x46); keeping 0x44.`, and the part then answered at the kept address — refuse-rather-than-clamp AND its fallback, both exercised. **`kShortRead` and a mid-read `kNoAck` were not reached**, and neither was the ~10 ms read cost, which is still arithmetic: nothing has timed the `ambient` task.
  - **The DHT/SHT40 mutual exclusion has fired on a device.** A document declaring `io.dht` on GPIO 7 beside `io.sht4x` logged `Config declares both io.dht and io.sht4x. Reading the SHT40 and ignoring the DHT on GPIO 7; remove io.dht to silence this.`, was **not refused** — which is the load-bearing half — and cleared `dhtFitted`: the `Sensors:` line still read `SHT40` with no DHT, and `/data.json`'s keys stayed `Temperature` / `Air Humidity` rather than taking the DHT's `Ar` prefix. The SHT40 won the fitted flag, the task, the audit and the label together, from one veto at one place.
  - **`Wire.begin()` has been called and I²C transactions have happened on GPIO 8 and 9**, so this file's "no I²C transaction has happened on any pin" is withdrawn. **`ROLE_I2C`'s sharing exemption is still unreachable**: one bus registers its two pins once, and there is still no second I²C kind to repeat one.
  - **The ADC reads, and the probes are NOT reported as working sensors.** Four channels return four distinct, stable values, so the mux selects individual channels rather than repeating one. `probe_health` calls all four `connected` once past its 120-sample floor, at **stepSd 1.37–4.58 ADC counts** against the 400-count threshold, and `/data.json` carries no `fault` key on any of them. **That is "nothing found", not "a sensor is in soil"** — this file's own rule is that the check deliberately does not catch a disconnected pin that sits quiet, and nothing is planted. Two observations say so out loud: the four readings **drift upward together by about 3 points over the first three minutes of every boot and converge**, and they land in a **different place on each boot** — Zona 1 read 70.40 at 3m16s of one boot and 79.84 at 2m43s of the next, a 9-point difference at comparable uptime with nothing touched in between. That is exactly the floating-input signature this file already records: quiet at any instant and free to be somewhere else later. **The LDR on GPIO 6 is the one analog channel with positive evidence** — its variance moved 0.15 → 35.65 → 0.40 across the session while the probes stayed flat, which is a channel responding to a room.
  - **`/history.json` pages on this family, and the sensor change is visible in the stored record.** `capacity 1440, stored 37, returned 5, offset 32, stride 1`, and `offset=0` reaches the oldest record. Records written before the config change carry `"temp": null, "hum": null`; ones after carry `"temp": 30.63, "hum": 37.15` — the SHT40 feeding the same positional slots a DHT would, with no seam needed in the series.
  - **The 8 MB partition in service, and the heap.** `io_history: 1440 records fit ~96 KB of the 2185 KB available once the 304 KB reserve is taken out` — the proportional reserve term choosing again, now against a filesystem with content on it rather than the empty one of 2026-09-16. `Filesystem 248 / 2432 KB`, `History 42 / 1440 records`, and the 60 s period confirmed by watching the count tick. With the I²C stack started and the bus running: **Free Heap 179–185 KB, Min Free 98–123 KB, Largest Block 151–167 KB.** Still a different machine from the WROOM-32's 53 KB largest block.
  - **The documented restore round trip ran thirty-nine times in one session** and never lost a credential; the seven whose bodies were read all answered `{"saved":true,"restartRequired":true,"reauth":false}`. **`reauth:false` on an unchanged `ota.password` is the check this file listed as not repeated since 2.11.1**, and it is now exercised well past the single 2.16.0 run.
  - **No panic, no watchdog, no core dump** — there was nothing to take one of. *(Of this session. A full flash read on 2026-09-26 found **10 756 bytes of real core dump** in the `coredump` partition, so this board has panicked or tripped a watchdog at some point; nothing read there dates it, so it is not known whether it predates or postdates this session. See the 2026-09-26 entry.)*

  **NOT done, deliberately: no relay was energised, and no relay claim moved.** Nothing is known to be wired to the relay outputs, so `startRelay()`, `POST /control`, `relayStop`, the 30 s ceiling, the sticky mask, `relayStartedHook()`, the relay-idle guard on `/updateEnable`, every ThingsBoard RPC method that writes, and the schedules are all exactly as unverified as they were. **The carrier's inverted relay safe state is likewise still reasoning about a schematic**: eight resets happened with the config's `on: 0` and nobody put a scope on a coil, so what `J200` and the module's own pull-up do through a reset remains read off a netlist.

  **And one anomaly, recorded rather than dismissed.** At some point in this session `/config.json` on this board changed **`cloud.enabled` from `false` to `true`**, and nothing ever sent `true`. What is established: the file held `false` at 17:02:48 and `true` at 17:10:03; every document this session's tooling sent is on disk and every one carries `false`; only `POST /config.json` and the onboarding handler call `saveFile()`, and the portal's routes are not registered on a board in normal mode; and the device log proves no save happened between 17:08:43 and 17:10:13, so the write was one of the three POSTs at 17:03–17:05. **It did not reproduce**: 20 byte-identical round trips plus 12 replays of the exact three candidate documents, 32 in all, flipped nothing. The `Saved /config.json (N bytes)` line that would name the guilty write is gone — the 8 KB RAM buffer rolled, and `/log0..3.txt` hold only boot-time lines because `Logger::backup()` is hourly and this board never stayed up an hour. **A browser on this workstation saving `/config.html` in that window cannot be excluded**, because every session in the log comes from this machine's IP. The consequence was visible and is worth knowing: with the flag true, `/data.json` served `Luminosidade.state: "partly cloudy"` from the compiled clear-sky table — which describes ONE WROOM-32 board's sensor at ONE mounting in one season and means nothing on this LDR. It was set back to `false` and the badge is absent again.

- **The ThingsBoard Cloud archive was migrated into the self-hosted instance, and counted on both sides** (2026-09-17, `scripts/tb_import.py` + `tb_client.py`, ThingsBoard CE **4.3.1.4** at `2.25.232.134.sslip.io`). **No C++ changed, nothing was flashed, and neither board was touched.** Every number below is an HTTP response.

  - **Which device the archive holds, established rather than assumed.** `backups/telemetry.sqlite` has **no device column** — one file is one device by construction — and its `meta` table names `espgarden1`, cloud uuid `cc42e320-9f7d-11f1-bc5c-91593e9e4b18`, with a `CLIENT_SCOPE` attribute `deviceId 6224`. The target's `espgarden1` reports the same `deviceId 6224`, so the archive and the destination are the same WROOM-32 board. **There is no `espgarden2` data and there could not be**: the schema cannot express a second device, and a second device would have been a second file. Nothing was written to `espgarden-s3` (`b580`), whose series starts at the cutover and has no archive behind it.
  - **The archive:** 404 142 datapoints, **60 keys**, 23 792 distinct timestamps, **2026-08-24 04:00:28 .. 2026-09-17 17:19:40** local. 44 of those keys are also live on the new server; **16 are retired** (`moisture3`, `relay4*`, `waterLevel`, `flowRate`, `flowTotalLitres`, `reservoir*`, `et0*`, `relay`, `relay1Event`, `relay3Event`) and end where the hardware or the firmware changed.
  - **The limits were measured against the instance, on a device the tool creates and deletes** (`--probe`), because a limit read off a blog post is not a measurement. **A backdated write is accepted and read back** — 2026-08-24 04:00:28 went in and came out. **A re-write of the same `(entity, key, ts)` is an OVERWRITE**: the same point written three times with two different values left exactly one point holding the last one. **The batch ceiling is far above what this needs** — 200 000 points in one **10.5 MB** body answered 200, and 50 000 points took **2.6-2.9 s**. On the READ side this instance has **no 50 000 threshold** (ThingsBoard Cloud does, and `tb_export.py` records what trusting one costs): `limit=60000` returned 60 000 of 60 000. And **`endTs` is EXCLUSIVE**, printed as a check on every `--census`.
  - **The bulk run: 404 142 datapoints in 21 POSTs (24 requests including the login), 32.3 s, 10.0 MB sent.** Batches of up to 20 000 datapoints, whole timestamps only.
  - **Verified by COUNTING, per key, on both sides — all 60 agree.** 404 142 rows in SQLite inside the migrated window against **404 142** points the server returns for the same window, with **0** points pre-existing there. Plus **240 sampled values fetched back and compared to the archive text character by character** (first, last, middle and the longest literal per key): every one identical. `--verify` exits non-zero on any disagreement and exited 0.
  - **The idempotency claim was tested on the real payload, not only on a probe.** The whole archive was written a second time, all 21 batches, and the counts did not move: still 404 142, still every key equal. The ledger's skip path was exercised too — a third run wrote **0 bytes in 3 requests**.
  - **The seam is measured and empty.** Device level: last archived point **2026-09-17 17:19:40.449**, first self-hosted point **17:21:40.011**, **119.562 s**. Per key it is larger and for a structural reason worth knowing: the 12 continuous keys resume at **17:26:39 (7.0 min)**, because the first periodic payload lands 300 s after boot; the step keys resume at **17:21:40 (15.6 min)** on the boot event; and event keys wait for an event — `relay2Event`, `relayName`, `wateringMs` and `durationMs` gap by **33.8 h to 2.05 days**. **Zero points were written into the seam**, confirmed by counting the window `(last archived, first self-hosted)` for all 44 keys after the import. Nothing was interpolated.
  - **The value TEXT is re-emitted as a raw JSON literal, and that is what keeps the types right.** ThingsBoard types a datapoint from the literal the publisher sent: `0` is a long, `66.62857055664062` a double, and **`0.47609522938728333` — seventeen significant digits — is a STRING**. **74 702 of the 404 142 rows are in that third class**, and the live post-cutover series holds them as strings too, because the same firmware published both. Since the archive stores the server's own stringification, feeding it back verbatim reproduces the original decision without modelling it — whereas `float(text)` then `repr()` shortens 17 digits to 16 and silently turns a string series into a double one. Confirmed on the instance for all six shapes with `useStrictDataTypes=true`, and again by the character-identical read-back above, which is the check that catches it: a 17-digit literal stored as a double would come back 16 digits long.
  - **A ThingsBoard type is a property of the POINT, not of the key**, which is why the verification does not compare types against the live series. 18 of the 60 keys hold both integer and decimal texts in the archive — `luminosity` is a long at one instant and a double at the next — and the live series does the same. Two sampled keys duly disagreed with their live twin's type (`cloudTransientPeak`, `temperatureSd`) and both are the platform reproducing itself faithfully, not a defect.
  - **Attributes: 10 refused, 2 carried.** All five CLIENT_SCOPE keys (`ambient_sensor`, `current_fw_title`, `current_fw_version`, `deviceId`, `hostname`) were **already on the target with identical values**, republished by the device on its first connect — an attribute is current state that overwrites, so backdating one is at best a no-op and after an OTA would put `2.17.0` back over the version that just flashed. The five SERVER_SCOPE platform keys (`active`, `lastActivityTime`, `lastConnectTime`, `lastDisconnectTime`, `inactivityAlarmTime`) are written by ThingsBoard's own device-state rule node; forging them is lying about connectivity. **`wateringMs` (10000) and `wateringTime` (10) were absent on the new server, are operator settings nothing else holds, and were written to SERVER_SCOPE and read back.**
  - **Gates:** `tb_import.py --self-test` **51 checks, 0 failed**, offline and with no credential; `check_lines.py` green at 838 + 332 lines after the pair was split at the 1000-line gate (it reached 1132 as one file). `pio test -e native` is untouched by this change and nothing in `src/` moved, so `FW_VERSION` was deliberately not bumped.

- **`GET /device.json`, the config round trip and `POST /spiffs/upload`, on the S3** (2026-09-16, firmware 2.16.0). `/device.json` answers `{"hostname":"espgarden-s3"}` unauthenticated, and `/login.html` and `/login.js` were replaced **one file at a time** through `/spiffs/upload` — 774 B and 2 040 B, MD5 verified by the device, `{"ok":true,...,"free":2248704}` — so the login page names its board without the filesystem deploy that would have wiped `/config.json` again. The documented `GET /config.json?secrets=1` → edit → `POST` round trip also ran here for the first time on this family (1 609 chars, `{"saved":true,"restartRequired":true,"reauth":false}`), and the `ota.password` push into `UserStore` was confirmed by logging in with the new credential immediately, before any reboot. **`POST /config.json` takes the document in a form parameter named `config`, not as a JSON body** — a raw body answers `400 missing 'config' parameter`, which is worth knowing before writing a client.

- **The onboarding portal, end to end on the S3, driven from this session** (2026-09-16, device `b580`, firmware 2.15.0). The workstation joined the board's own AP over its Wi-Fi adapter and ran the whole flow; **every step below is an HTTP response or a serial line, not an argument.**

  - **`GET /` answered 200, 4 372 B of `text/html`** with the reveal checkbox in it, and **`GET /whatever-does-not-exist` redirected to `http://192.168.4.1/`** — the catch-all works. The AP associated a client **2 s** after `netsh wlan connect` returned.
  - **`GET /onboarding.json` reported `id b580`, `chip esp32s3`, `firmware 2.15.0`** and **exactly one template, `s3-carrier`.** The per-family filter is a chip's answer now, not a `#if` read in a diff: the two WROOM-32 templates are absent from an S3 image.
  - **`POST /onboarding` answered `{"saved":true,"restarting":true,"marker":true,"ssid":"…"}`**, the board rebooted, joined the LAN at **192.168.1.77**, and the next boot logged `open(): /littlefs/provisioned.pending does not exist` — **the marker was written by the POST and deleted by the first successful association.** The whole lifecycle, in one pass.
  - **`validatePins()` HAS now run on an S3.** `Sensors: 4 moisture, luminosity, flow, float switch`, and `/data.json` carries four probes and four relays off the carrier template. **`templates/config.espgarden_s3.json`'s pin map has been through `ConfigFile::loadFile()`** — via the compiled copy of it, with a real `id` rather than the `1a2b` placeholder.
  - **`/capabilities.json` answered from the chip**: `analogPins [1..10]`, `reservedPins [19,20,43,44]`, and `kinds` carrying `sht4x`. This file said of the S3 pin rules that *"a table is not a chip"*. The firmware running on the chip now reports the same table.
  - **Nonce + SHA-256 login worked on this family**, and the normal UI serves from the 2.375 MB LittleFS (`Filesystem 220 / 2432 KB`).
  - **The heap is a different machine.** `Free Heap 294 KB`, **`Largest Block 271 KB`** at idle, settling to 184/159 KB once the network was up — against the WROOM-32's 53 KB largest block, which is the number that forced `/history.json` to stream and killed `AsyncResponseStream`. Those constraints should be re-derived on this board rather than assumed.

  **A 501 that was not a bug, and is worth recording because it will happen again.** With the app flashed and **no filesystem**, every page answered `501 Handler did not handle the request` and MQTT failed at `rc=-1` on `open(): /littlefs/thingsboard.pem does not exist`. `servePublicFile()` cannot build a response from a file that is not there, and ESPAsyncWebServer's `_send()` reports exactly that. It reads like a routing fault and it is an empty partition. **After `-t uploadfs` the same board answered every route, and `MQTT Link` moved `rc=-1` → `rc=5`** — the TLS handshake now completes against the pinned CA and the broker refuses the credentials, because all three templates ship `mqtt.username` EMPTY on purpose. **Still unexercised: a ThingsBoard session from this board**, which needs a device token pasted into `/config.html`.

- **The 60 s history archiver, against the live garden, for the first time** (2026-09-17, device `6224`, firmware 2.13.3). `scripts/history_export.py` had never sent a byte to the board; it has now, and **the first thing it found was that this file's own address for the garden was wrong.**

  - **The board is not at 192.168.1.55, and it moved without anything saying so.** The first run timed out at TCP connect. The workstation was on the right LAN (192.168.1.246 wired, .248 wireless, gateway answering) and there was no ARP entry for .55 at all. What identified the board is arithmetic this file already documents: `ESP.getEfuseMac()` stores `mac[0]` in the LEAST significant byte, so `% 0x10000` is `mac[0] | mac[1] << 8`, and the ARP table's `24-62-AB-FA-08-18` is therefore id **`0x6224`** — the garden — while `80-B5-4E-E8-AC-88` is `0xb580`, the S3. Confirmed two ways: `espgarden1.local` resolves to **192.168.1.242**, and `GET /device.json` there answers **404**, which is exactly right for a board on 2.13.3 since that route landed in 2.16.0 (the S3, at 192.168.1.28, answers it with `{"hostname":"espgarden-s3"}`). **A DHCP lease is a number nobody re-derives**, so `DEFAULT_DEVICE` in `history_export.py` and `moisture_fit.py` is now the mDNS NAME the device publishes itself — measured through Python's own resolver rather than assumed: `socket.getaddrinfo("espgarden1.local", 80)` → 192.168.1.242 in **0.148 s**.
  - **`--plan` predicted the run and was right to the request.** `buffer 3000 records at 60 s, 8 segments of 375`; `retention 2625-3000 records held (43.75 h GUARANTEED, 50.00 h at best)`; `cadence every 6.25 h tolerates 6 consecutive failed runs`; `first run 16 history pages + login + config + logout = 19 requests, ~445 KB`. The run cost **19 requests and 455.4 KB** — 15 history pages rather than 16 because the buffer held 2787 and not 3000, and login is two requests (`/nonce` then `/login`) rather than the one the plan counts. The two errors cancel exactly, which is luck and is said here so nobody reads 19 = 19 as a validated model.
  - **The walk held together on a real buffer at the first attempt.** `device buffer: 2787 / 3000 records at 60 s` · **2787 new, 0 already held, 0 conflicting, 0 refused** · `15 history pages, 0 restarts` · **~4.9 s** from the session row to the commit. **Neither guard fired**: `stored` never decreased, and `_pages_abut()` — the exact-overlap-by-timestamp check that replaced one a fault injector walked straight through — accepted all fourteen page boundaries. That is the guard meeting a real device's eviction and having nothing to say, which is an outcome and not a test of it: **no rotation happened inside the 4.9 s walk**, and at 60 s a rotation is a once-per-6.25-h event, so a clean walk is what the arithmetic predicts rather than evidence the guard works.
  - **`2787 / 3000` is the retention swing again**, between the `7/8 × 3000 = 2625` floor and capacity — the same band 2026-09-11 measured at 2628.
  - **The predicted clock-outage hole is there, and this run can attribute it where the tool declines to.** One gap: **2026-09-15 14:58:13 .. 2026-09-16 08:41:26, 17.72 h (1063 min), ~1062 records.** `coverage_gaps()` prints that it "cannot tell apart" records nobody collected from records the device never wrote — correct in general, and decided here by structure. The archive was EMPTY before this run, so nothing could have gone uncollected; the gap is INTERIOR to one contiguous walk whose every boundary was verified by timestamp; and **a 3000-record buffer at 60 s spans at most 50.00 h with no skipped appends, while the collected span is 64.41 h.** 2787 × 60 s = 46.45 h of record inside 64.41 h leaves **17.96 h unaccounted**, which is that one gap plus 0.24 h of ordinary jitter across 2787 intervals. The device did not write them, and `historyTaskHandler()` skipping the append while the clock is unsynced is the only mechanism in this firmware that produces that shape.
  - **Five relay activations are in the record, and `consumedUntil` is NON-ZERO for the first time.** `relay 1` (Zona 3) at 09-15 09:22:46 and 10:37:06; `relay 0` (Zona 1) at 09-16 09:01:17; `relay 2` (Reservatorio) at 09-16 09:03:18 and 09:06:18. `consumed_until()` answers **1789560077 = 2026-09-16 09:01:17**, the relay-0 edge — correctly ignoring the two NEWER Reservatorio edges, because no probe maps to that pump. This file recorded `0` as *"correct precisely when no edge exists — which is this garden today"*; that is no longer today.

  **The fit still refuses, and the refusal has moved.** `moisture_fit.py --history-db` ends in `Nothing was fitted`. Per probe:

  | | probe 0 `Umidade Zona 1` pin 36 relay 0 | probe 1 `Umidade Zona 3` pin 32 relay 1 |
  |---|---|---|
  | model `blockedBy` | `only 1 watering events, 6 needed` | `only 2 watering events, 6 needed` |
  | dry | n=19 w=15.7 mean **68.22** sd 0.10 | n=103 w=56.8 mean **74.14** sd 0.10 |
  | humid | n=0 | n=0 |
  | wet | n=29 w=27.0 mean **68.15** sd 0.10 | n=58 w=54.0 mean **74.16** sd 0.19 |
  | J | **0.252** (needs 4) | **0.008** (needs 4) |
  | two-point `blockedBy` | `no wet anchor: no settled plateau follows a watering of this probe's own pump` | the same |

  - **The binding gate is the same gate and its number is no longer zero.** The 300 s ThingsBoard archive said *"zero watering events on either probe's own pump"*. The device's own 60 s record says **1 and 2**. The labels exist now; six is still six.
  - **The event count is no longer the interesting refusal, and that is what this record bought.** `wet` sits 0.07 points BELOW `dry` on probe 0 and 0.02 above it on probe 1 — **the pumps move the probes by nothing.** Measured directly against the preceding hour's mean: relay 1 → probe 1 **+0.16** then **-0.21** points; relay 0 → probe 0 **-0.07** points. Against a 20.4-point calibration span and a 6.8-point badge band that is noise with a sign on it. Six more waterings do not repair a J of 0.008: **nothing in this garden currently separates wet soil from dry soil, because the soil is never dry.**
  - **100 % of 2787 records fall in the WET third for both probes**, and 17.1 % (probe 0) and 26.7 % (probe 1) sit **above the wet anchor entirely**. That is the 2026-09-16 ThingsBoard finding — *all three classes above the wet anchors, the pots never dry* — reproduced from an independent source at a different sample rate, and it is the physical reason `humid` is empty on both probes: the consumption window never closes because there is no dry end to close it.
  - **The soil is being wetted by something the relay record cannot see.** Both probes rise monotonically from the moment the record resumes — probe 0 **68.22 → 75.00**, probe 1 **72.17 → 80.78** over ~32 h, with one 2-minute relay-0 run inside it. `moisture_fit` flags the sharpest stretch as a drift segment: probe 1 **+2.73 points over 09-17 15:25..16:39, +0.216 / 5 min**. This file already names the class — *"this garden is also watered by hand, so the relay record is not a complete label source"* — and what is new is watching one happen in the device's own record, at a resolution the 300 s publish blurs.
  - **`moisture[1]` now carries `dry: 53.1`, borrowed from probe 0.** The live document has `{dry 53.1, wet 75.5}` on Zona 3, where this file records it as deliberately left at `dry == wet == 0` because *"a threshold is per-probe"* and borrowing is *"exactly what this file forbids"*. Read off the device by this run, not written by it; recorded because the badge Zona 3 shows today rests on an anchor measured in a different pot.
  - **The thermal pass produced 0 of 4 windows, and one refusal is a first.** `night 2026-09-16: only 0 placebo days are available, 4 needed: the archive cannot supply its own null` — a 64 h archive holding one usable night cannot be its own placebo, and the check says so instead of quoting a rank it has no shifts for. The other three: two whole-span windows refused because a watering ran inside them (slopes **+0.425** and **+0.382** pts/K, the sign ionic conduction predicts and both uninterpretable for it), and one refused as `unstable: the sign flips with the trend order`.
  - **A SECOND sun patch is in the record, two weeks after the first.** Daily maxima from the device's own thermometer: 09-15 **29.50** at 13:36, 09-16 **30.99** at 15:30, 09-17 **43.16 at 15:27, with 60 minutes above 35 °C** against zero minutes on either other day. This file records 2026-09-03's 45.04 °C as *"the only time in the whole archive the device exceeded 35 °C"* and attributes it to *"a patch of direct sun at one solar azimuth"*. A second occurrence at the same hour of the afternoon is what that explanation predicts and what a random fault does not.

  **Read-only, and what it still has not done.** GETs only — no `POST`, no `--push`, no config write, no relay, one login and one logout for one session slot. **Still unexercised against the device**: the INCREMENTAL path, since every record here was new, so `known_newest`, the duplicate count and the `gap_before` report have run only against the mirror; a real identity SEAM, since one session cannot disagree with another; a conflict row outside `:memory:`; a restart, since no rotation landed inside a 4.9 s walk; and `moisture_fit.py --push`, which remains never run.

- **Both boards left ThingsBoard Cloud for a self-hosted instance, and then moved again onto a real domain** (2026-09-17/18). The broker is now **`tb.espgarden.com.br:8883`** — a Hostinger VPS running ThingsBoard CE 4.3.1.4 behind Traefik, deployed from the sibling `thingsboard-deploy` repo. Every claim here is an HTTP response or a certificate read off the wire.

  - **`mqtt.cacert` DID NOT CHANGE, and that was established before either board was touched.** The self-hosted chain is issued by Let's Encrypt **YR1** and terminates in **ISRG Root YR** — which `data/thingsboard.pem` already pins. `openssl s_client -CAfile data/thingsboard.pem` answers **`Verify return code: 0 (ok)`**, and so does the same test against **ISRG Root YR alone**. So the five-root bundle bought for the Cloud outage paid for itself on a broker it was never chosen for; only `mqtt.server`, `mqtt.username` and `mqtt.password` moved.
  - **`tbctl ca-export` emits the FRAGILE pin and this repo's own bundle is the durable one.** It writes **ISRG Root X1**, which validates the live chain only through a transitional cross-signature; `data/thingsboard.pem` carries YR itself. Using the exported file would reintroduce the exact shape of the 2023-2026 outage. Recorded in the deploy repo, not fixed there.
  - **Access token, not MQTT Basic.** The deploy README recommends MQTT Basic; `espgarden1` had been authenticating with an access token in `mqtt.username` for weeks, so the cutover used the proven shape. **MQTT Basic remains unexercised by this firmware.**
  - **The history came across and was counted on both sides**: 404 142 datapoints, 60 keys, 2026-08-24 → the cutover, every key equal. See the `tb_import.py` entries.
  - **The seam is real and is NOT stitched.** Device-level 119.6 s; per key larger, because the 12 continuous keys resume 300 s after boot and event keys wait for an event — up to 2.05 days. 16 keys are retired and have no successor at all.

- **The garden's address moved twice in one day, and the second time nothing said so.** `192.168.1.55` → **`192.168.1.242`** (2026-09-17), and the S3 `192.168.1.77` → **`192.168.1.28`**. Both were DHCP leases expiring, both broke every default that spelled an IP, and the second was found only because a request timed out. **Address these boards by the mDNS name they publish themselves** — `espgarden1.local` and `espgarden-s3.local` — which is what `history_export.py` and `moisture_fit.py` now default to.

- **Firmware 2.18.1 runs on both families, and the `tasks.cpp` split is no longer unproven.** OTA'd to the S3 first — a bench board with nothing wired, so proving the refactor boots cost nothing — then to the garden. `espgarden1` 2.13.3 → 2.17.0 → 2.18.1, `espgarden-s3` → 2.18.1; MQTT reconnected on both, and the garden's history survived at **2870/3000** because an app-only OTA does not touch the partition. **The S3 OTA was also the first over-the-air flash this project has performed on an ESP32-S3**; every earlier one was over USB.

- **A `history.records` change kept every record, and the buffer now runs at 10000** (2026-09-22, device `b580`, firmware **2.20.0**). Editing that number used to empty the buffer at the next boot: `adoptSegmentLocked()` deleted any segment whose header capacity disagreed. Both halves of the fix executed on the garden, in the order that makes the second one meaningful.

  - **The app OTA first, which proves nothing about the change and is the point.** 2.19.0 → 2.20.0, upload 7 s, board down 4 s later, serving again 10 s after that, and `Status.History` read **4385 / 5000 both sides** — an app-only OTA does not touch the partition, so the segments that the new code would later have to adopt were still the ones 2.19.0 wrote.
  - **Then the resize, which is the test: `history.records` 5000 → 10000, reboot, and `4386 of 4386 records were kept`.** Under any earlier firmware that number is zero. `ioHistoryFitCapacity()` granted the request whole — *"10000 records fit — 480 KB of the 2145 KB available once the 304 KB reserve is taken out"* — and the adoption warning fired for the first time, saying in one line what the old behaviour did silently: *"8 of 8 stored segments were written at 625..625 records each against the 1250 a new one gets. They are KEPT and fully readable — a capacity change is an eviction policy, not a format — and each is recycled to the new size when it ages out, so the buffer converges within one full cycle of the 8 slots."*
  - **The failure mode this component actually has is a REORDER, not a loss, and that is what was measured.** All **4386** records were paged out through `/history.json` in 28 requests and checked end to end: **0 out-of-order timestamps, 0 duplicates**, a contiguous span 09-18 22:22 .. 09-22 00:01, and exactly **four** jumps over 120 s — every one of them an event already in the independently collected archive (the 09-20 14:28 hole, and the three 09-21 handling gaps including the 19:05 → 19:16 rewire reboot). So the absolute-ordinal walk is correct **across mixed-size segments**, which is the case `segment_index.h` had never met on a device and the one where a wrong answer gives right results until the first rotation.
  - **`Status.History` reads `4386 / 5000` and not `/ 10000`, and that is the design rather than a bug.** `capacity()` is `liveCapacity()`, the sum of the slots' own ceilings, so it walks up to 10000 as each 625-record segment is recycled at 1250. The product would have printed `12000 / 3000` after a REDUCTION, which is why it was changed — but an operator watching that row sees a denominator drift for hours with nothing in `/data.json` explaining it. **The explanation is only in the boot log, which is an 8 KB rolling buffer**; the `Status.History` suffix mechanism that already exists for the fit clamp is where it belongs, and it is not done.
  - **Still unrun on a device**: the zero-`records` refusal, the "file holds more than its header allows" clamp (now a genuine corruption signal rather than a routine config change, so newly worth logging and newly never seen), and the convergence itself — the eight slots recycle over roughly a full cycle and nothing has watched one complete. **A SHRINK and its second warning are no longer on this list**: both ran on 2026-09-26, on the CLONE, and by an accident worth keeping — see the 2026-09-26 entry. Nobody had to reduce `history.records` to reach it. **And the training cost at 10000 is arithmetic, not a measurement**: `moistureModelTrain()` makes up to three `forEach` passes, so 30 000 seek-and-reads a day against the 4 320 the existing *"stalls other background tasks for seconds"* note describes. Passes 2 and 3 are skipped when no watering cycle completed, which is every run on this garden today — so the common case is one pass and the number has not been reached.

- **A pot finally dried out, the drying fit read the device's own 60 s record for the first time, and it STILL refuses — for a reason this file did not predict** (2026-09-21, `scripts/drying_fit.py --history-db`, against `backups/history-espgarden-s3.sqlite`). **This is an ANALYSIS of a record a device wrote, not something that ran on a device**: no C++ changed, nothing was flashed, no HTTP request was made, no board was touched and `FW_VERSION` did not move. The archive is 4976 records at 60 s, **2026-09-18 08:59 .. 2026-09-21 23:26 (86.4 h)**, four gaps totalling ~190 records, device `b580`.

  - **`Umidade Zona 4 (Arranjo)` fell 43.4 → 9.0 over 71.4 h with nothing watering it, and no dry anchor came out of it.** Six genuine drying segments across the four probes, **six refusals**: `model` x3, `uninformative` x2, `degenerate` x1. Both Arranjo segments are refused by **`model`** — `linear` wins the held-out extrapolation on both, 1.489 against `explin` 1.951 / `exp2` 2.348 / `exp` 4.351 on the 26.0 h piece and 6.171 against 6.574 / 7.052 / 7.359 on the 42.8 h one — and a straight trend does not end anywhere.
  - **THE CURVE BENT THE WRONG WAY, and that is the finding.** This file's standing claim was that *"the profile is flat because the curvature is absent"* and that one zone drying out would make *"the curve bend where the asymptote lives"*. It bent, and it bent AWAY. Least-squares slope over successive fifths of the fall: **-3.70, -4.43, -11.46, -23.07, -18.04 points/day.** The fall accelerates roughly fivefold and is still running at ~18 points/day at the segment's last sample. An exponential fitted to a curve that steepens puts its asymptote off the bottom of the scale: **-11.85** on the 26 h piece (tau 33.9 h, DEGENERATE against a 26 h window) and **-3.02** on the 42.8 h one (tau 171 h). Both profiles are **unbounded to the floor**, and trimming the first fifth moves the 26 h asymptote by **41.4 points**.
  - **And the BOOTSTRAP agrees with the profile here, which is the first time in this project it has.** This file's standing warning is that the block bootstrap is narrow where the model is wrong, because it resamples around the fitted curve — 55x and 189x tighter than an unbounded profile on two segments of this same run. On the Arranjo it is **[-14.41, 36.38], width 50.79** on the 42.8 h piece and **[-70.50, 0.99], width 71.49** on the 26 h one, against profile widths of 43.5 and 30.1. It is WIDER than the profile, and the tool's own "the bootstrap is Nx tighter" warning does not fire on either. A fit so wrong that resampling its own residuals moves the asymptote seventy points is not a fit anybody has to argue about.
  - **It is not an artefact of where the tool cut.** The fall is split in two at a 10-minute device outage on 09-20 14:28, whose reboot drift is a real discontinuity this file already documents (*"the four readings drift upward together by about 3 points over the first three minutes of every boot"*). Refitted BY HAND as one 71.4 h segment it gets worse, not better: `explin` wins at 1.889 held-out, the exponential's asymptote is **-121.49** with a 285 h tau, the profile is unbounded and the trim spread is 6.4 points.
  - **The fall had not stopped when this was fitted, and the orchestrator's brief said it had — a decimated view read as a fact.** The brief handed to the fit said *"8.92, flat since 09-21 14:46"*. That came off a `window=` query, which **decimates and reports its stride**, and the "flat" stretch is a 2.5-point WETTING BUMP between 16:18 and 17:48 sitting inside a continuing decline. Re-read from the device on **2026-09-22 00:12 the Arranjo is at 5.10**, against 29.16 thirty hours earlier — **-19.37 points/day and still running**. The last archived reading, 9.01, is **ADC 3726 of 4095**: nine points above the rail, not at it. So neither half of the equilibrium-or-floor question the fit was asked to settle is what happened, and the `ASYMPTOTE_MIN_EXTRAPOLATION` gate never fired here — `model` refused three gates earlier. **A decimated row is not a timestamp and a decimated stretch is not a plateau**; the same mistake put the probe-crossing boundary at 19:34 when the record puts it in the 19:05-19:16 reboot.

  - **And it is not an artefact of the sample rate.** The same record resampled to 300 s gives the same six segments, the same held-out winners and the same six refusals, with the Arranjo's numbers agreeing to two decimals — held-out 1.506 against 1.489, asymptote -11.76 against -11.85. The decision is a property of the garden, not of the resolution it was read at.
  - **So the pot was NOT at equilibrium and the probe was NOT at its floor**, which is the confusion `ASYMPTOTE_MIN_EXTRAPOLATION` exists to catch and which never arose here — that gate was never reached, because `model` refused three gates earlier. The segment's last reading is 9.01 points, which under `100 - ADC*100/4095` with `invert` is **ADC 3726 of 4095**, nine points above a rail this channel demonstrably reaches. What was read as "flat since 09-21 14:46" is a 2.5-point wetting bump between 16:18 and 17:48 sitting inside a fall that resumes at about -19 points/day after it.
  - **The two segments that DID reach the equilibrium gate are the other pots, and they are the case it was written for.** Zona 1 (23.9 h, `exp` winning at 0.327 held-out, tau **4.70 h**, profile **BOUNDED [71.01, 71.83]** width 0.8, bootstrap [71.22, 71.63] width 0.41 — the two agreeing within a factor of two, which is what a correctly specified model looks like, trim 0.3 points over 4.8 h) fits an asymptote **0.24 points below its last reading**; Zona 3 fits one **0.07** below. Every statistic green, and both refused as `uninformative` — the level a pot settles at between waterings, which the last sample already gave.
  - **One falsification printed, for the first time on real data.** Zona 2 (Espada)'s single-exponential asymptote of 48.43 is **0.87 points above a reading the same probe produced 4.3 h later with no watering in between**. That segment is refused by `model` anyway, so the hit decided nothing — but the function has now returned one, where this file recorded it as *"NEVER fired"*.

  **What the wiring cost, and the three thresholds that had to follow the rate.** `scripts/drying_sources.py` is a new module holding "which archive, which channels, at what period" — the same split `drying_models`/`drying_evidence` and `history_archive`/`history_store` already use, taken because `drying_fit.py` would otherwise have crossed the 1000-line gate. The 60 s side reuses `history_archive.samples_for_probe()`, the adapter `moisture_fit.py --history-db` already consumes, rather than reading the columns again. Both archives are opened **read-only**, deliberately not through `history_store.open_archive()`, which runs `CREATE TABLE IF NOT EXISTS` and takes a write lock on a file this tool only reads.

  - **`--step` was hard-coded at 300** and now defaults to the source's own observed period. That is what carries `TAU_UNRESOLVED_STEPS` with it: the floor under a reportable time constant moves **10 min -> 2 min**.
  - **`handling_windows()` read `STEP_MIN_POINTS` (5.0, the 300 s number) directly**; it now scales through `moisture_stats.step_threshold(period)`, which is 1.0 at 60 s. Measured on the Arranjo: **16 steps at 5.0 against 43 at 1.0**, and the 27 extra include both ends of the 2026-09-21 rewire and the boot drift after every outage. Read at the 300 s number, the device's own record cannot see a re-seated probe at all.
  - **`drying_evidence.effective_samples()` clamped lag-1 rho at 0.99, and that was a correlation TIME expressed in SAMPLES.** `n(1-rho)/(1+rho)` is scale-invariant on its own — for a process with correlation time T sampled every dt, rho = exp(-dt/T) and the ratio tends to span/(2T) whatever dt was — but capping rho at 0.99 asserts a correlation time of at most ~99 dt, which is 8.2 h at 300 s and 99 min at 60 s. Measured: the Arranjo's long fall read n_eff **12.9 at 60 s against 4.0 at 300 s**, F threshold **1.50 against 52.19**, purely from the clamp. An asymptote must not become identifiable because somebody sampled faster. Only the negative side is clamped now; `max(4.0, ...)` is what keeps it finite.
  - **All three are verified a no-op on the 300 s archive.** `drying_fit.py` and `drying_fit.py --stitch-seam` run against `backups/telemetry.sqlite` at HEAD and at this commit are **byte-identical apart from the four new source-header lines** — 13 segments, same winners, same refusals, same numbers.
  - **`--stitch-seam` is REFUSED with `--history-db`, not ignored.** It names one recorded moment in the ThingsBoard archive; the device's record keys probes by SLOT and carries its own identity stamps, so a flag accepted-but-inert would report a join that never happened.
  - **The archive states NO identity seam, and the report says so out loud.** A seam is a disagreement between two collection sessions and this file holds ONE, so the 2026-09-21 rewire below leaves no trace in it — the tool is not confirming there was no swap, it has nothing to compare against, and it prints that sentence rather than staying quiet. **Probe 3, the Arranjo, was not in that swap** (J7 was not touched), so the curve above is clean; probes 0 and 2 span the crossing and segments [1] and [3] have to be read with that in mind.
  - **Gates:** `drying_fit.py --self-test` ok, with three new rate checks (a 2-point-per-sample jump is soil at 300 s and handling at 60 s; the segmentation acts on that; the UNRESOLVED floor follows the step) plus `drying_sources`'s five, and two new ones in `drying_evidence` — one red against the old rho ceiling, one asserting scale invariance. `moisture_fit.py --self-test` **107/107**. **`pio run` and `pio test` were NOT run and are not affected**: no C++, no `data/`, no `test/` file was touched.

- **The PROFILE GATE has now been reached on real data, and this file's claim that it never had is withdrawn** (found 2026-09-21 by the baseline run taken before the change above; it is a property of the ThingsBoard archive having grown to 13 segments, not of that change). `backups/telemetry.sqlite` segment [13], `moisture1` 2026-09-14 19:29 → 09-17 11:42, **64.2 h**: `exp` wins the held-out test at 2.263, asymptote **69.54** with a **non-degenerate** 9.65 h tau, 0.1 points of trim drift over 12.8 h — every cheap gate passed — and the **profile refuses it**, every level from 83.1 down to 0 fitting within 5119 % of the best SSE at n_eff 4. Beside it the block bootstrap says **[68.57, 70.07], width 1.51**: **55x tighter than a profile that is unbounded**, which is exactly the trap [The gate that decided nothing](soil-moisture.md) describes and the reason this tool never prints the bootstrap alone. **The ACCEPT path is still unreached** — 19 refusals across the two archives, and no segment has ever produced a dry anchor.

- **Two probes were plugged into the wrong terminals on the carrier, and the board's own silkscreen is why** (2026-09-21, device `b580`, firmware 2.19.0). The operator suspected `moisture1` and `moisture3` were crossed. They were. **The firmware and the netlist were never wrong**: `production/netlist.ipc` gives the whole chain, J4-2 → R11 → `SOIL1` → U1 pin 26 → GPIO 1 → probe index 0, and J5/J6/J7 likewise to GPIO 2/4/5, matching `config.json` pin for pin. What was wrong is which probe was in which terminal.

  - **The settling evidence is a controlled stimulus, not a value comparison.** Index 0 and index 2 read **71.7 and 73.2** — 1.5 points apart on a ~20-point span — so no reading could have decided this. What decided it: the operator watered the pot he calls Zona 3 while all four channels were sampled at 2 s, and **only index 0 moved**. Over 118 s it rose 72.01 → 74.53 and fell back to 71.67: a coherent excursion with a peak, not a drift.
  - **Amplitude alone would have got it wrong, which is worth keeping.** The raw ranges were index 0 **3.27** and index 1 **2.49** — close enough to argue about. Index 1 is simply a noisy channel: its mean sample-to-sample step is 0.557 against index 0's 0.195. Dividing a 5-sample-smoothed excursion by that per-channel noise separates them by an order of magnitude — **index 0 at 13.0×, index 1 at 1.2×, index 2 at 2.5×, index 3 at 1.4×**. A range is a statistic a noisy channel can fake; a range measured in that channel's own noise is not.
  - **The cause is the layout plus an empty silkscreen, and it generalises to anyone who builds this board.** The four probe terminals carry **no legend but their reference designators** — the only `fp_text` on each footprint is `${REFERENCE}` — and they sit in a 2×2 grid whose numbering runs backwards to reading order: `J7 J6` on the top row and `J5 J4` on the bottom, i.e. Zona 4 / Zona 3 over Zona 2 / Zona 1. Plugging four probes in from the top left gives **exactly the reverse mapping**, and J4 and J6 — Zona 1 and Zona 3 — are the two stacked in the same column, which is the easiest pair of all to cross.
  - **The consequence was worse than a wrong label on a dashboard.** `moisture[0].relay` is 0 and `moisture[2].relay` is 2, so a probe sitting in the pot that pump 2 waters was bound to pump 0. The classifier labels its training windows from that mapping and `reportWateringResponse()` measures a probe against its own pump — both would have been learning from a pump that does not water the pot they are reading. **Fixed in the wiring, deliberately, not in the config**: swapping the names and the relay indices would also have closed the loop, but `moisture1` and `moisture3` are positional ThingsBoard keys with stored history behind them, and redefining one is the `moisture2` defect this file already records. The operator swapped the two plugs.
  - **NOT yet re-confirmed after the rewire.** Both channels read `var` **52.26** and **88.02** immediately afterwards — the unplug and replug still inside the 300-sample accumulator window, against 0.20 and 0.01 on the two untouched channels. A value read there describes the handling, not the probe, which is the same trap that opened this session. The confirmation is the same stimulus test repeated once they settle, with index **2** expected to be the one that moves.
  - **An unattributed relay event sits in the record at 18:46 and is not explained here.** Two consecutive 60 s records carry `relays: 5` — the sticky mask, bits 0 and 2, so **pumps 0 and 2 both ran**. Across the following eight minutes index 0 fell **11 points** (82.93 → 72.02) while index 2 rose 1.5. That is the opposite direction to the controlled test on the same channel, and the two cannot both be water arriving under one polarity. Nobody has said whether the operator triggered it; it was asked twice and not answered, so it is recorded as **unattributed** rather than guessed at. **It was NOT the first relay activation on this carrier, and an earlier draft of this entry guessed that it might be** — the device's own buffer carries relay masks **15** (all four) at 09-18 15:24, **2** twice that evening, **6** on 09-21 14:46, then this **5**, then **8** at 19:34. So the relays have been running since the day the carrier became the garden, and what is unexplained here is one event's direction, not whether relays run at all.

- **A resistive probe read the garden's first real soil on the S3 carrier, and continuous power took ONE probe to the rail — a result that did NOT reproduce hours later on the same board** (2026-09-18, device `b580`, firmware 2.19.0). **Read the correction at the end of this entry before believing the headline**: this was first written as *"continuous power DESTROYS that reading in under a second"*, and the second run falsified that as a general claim. The operator wired a probe to Zona 1 (GPIO 1) and asked for the bank held permanently up so the reading would be steady. `io.soilMoisture[i].powerAlways` was written for it and flashed. What the A/B measured — one config key moved, everything else held constant, reproduced three times — is that the reading does not survive it:

  | `powerAlways` | Zona 1 | variance |
  |---|---|---|
  | **true** — GPIO 14 held high | **0.00** (ADC 4095, the rail) | **0.00**, and `stepSd` 0 across 38 samples |
  | **false** — switched, 50 ms settle | **44.1**, range 42.78-44.20 over 2 min | **0.01-0.29** |

  - **It is pinned from the FIRST sample after boot, not decayed into.** At 25 s uptime `val`, `avg` AND `var` all read 0.00 — a reading that had fallen 44 → 0 across those 25 samples would leave the mean mid-range and the variance enormous. So the probe is at the rail within roughly one second of the pin going up, which is what rules out the slow electrolysis the hardware repo warns about (*"the anode dissolves and the probe is scrap in weeks"*) as the mechanism here. That warning is about the probe's LIFE and still stands, unmeasured; this is about its READING, and it is a different, much faster effect.
  - **So the 50 ms settle is not a compromise, it is the measurement.** The reading is taken at a point on the electrode's polarisation transient where the divider still sees soil resistance. Held up, the double layer charges, the ionic current collapses and the output walks to the rail — in well under one io tick. **That mechanism is an inference and is NOT established here**: what is measured is the rail, the flatness and the reversibility, not the double layer. What would settle it is sweeping `settleMs` from 10 to 250 and watching where the curve breaks.
  - **`powerAlways` itself works exactly as specified** — the coalesced rule held GPIO 14 up against probes 1-3's turn in the power-down loop, which is the subtlety it was written for, and the reading came back the instant it was set false. The feature is not the defect; the request was.
  - **The probe was already stable, and the number that started this was a transient.** `var 502.70` nine minutes after it was plugged in was the connection event still inside the 300-sample accumulator window; by 41 minutes the same probe read `var 0.08`. **Nothing needed fixing.** A statistic read during a step change describes the step, not the sensor.
  - **AN OBSERVATION THAT IS NOT RECONCILED, AND IT IS THE IMPORTANT ONE.** The operator reports the probe module's power LED **blinking** — a 1 Hz switch — which is what the pin being held high should make impossible. He did not watch it during the always-on window, so it is not known whether it blinked THERE or only while the flag was false, and the two readings say opposite things: the flag demonstrably changes behaviour (0.00 against 44.1, three times), so `moisturePowerDown()` is provably skipping pin 14, yet a blinking LED in that state would mean something else drives it. **Nobody has put a meter or a scope on GPIO 14, and until somebody does, "the pin stays up" is an inference from a reading, not an observation of a pin.** If it does blink while `powerAlways` is true, the 0.00 has some other cause and this whole entry's mechanism is wrong.
  - **The board was left on `powerAlways: true` at the operator's instruction — and within the hour a `/devices.html` save silently deleted the key, which is the predicted footgun firing for real.** The operator renamed two probes (`Umidade Zona 2 (Espada)`, `Umidade Zona 4 (Arranjo)`) and the saved document came back with `powerAlways` **absent** from probe 0. That the rename and the deletion arrived in the same document is what `buildDocument()` does — it rebuilds each probe entry from what it renders and carries nothing else through — so the mechanism is the predicted one; it is INFERRED from the two changes arriving together, not observed in the act. **The key was documented as a known footgun one commit earlier and still cost a live setting the same day**, which is the argument for fixing that page rather than writing it down again.
  - **With the key gone the gating came back and all four probes now read.** Zona 1 **81.90 at `var` 0.08**, and Zonas 2/3/4 at 86.95 / 83.84 / 73.71, `var` 0.03-0.16 — where before only Zona 1 was connected and the other three floated at `var` 15-68. So the board is reading four plausible, quiet channels, and **nothing on it is on `powerAlways` any more**. `templates/config.espgarden_s3.json` still ships `true` on probe 0, so a fresh onboard would re-enter the state that pins the reading; that is recorded in task 020 and deliberately not changed without the operator, since he asked for it on.
  - Flash cost, measured: `espgarden2` **+616 B flash, +32 B static RAM**; `espgarden_s3` +612 and +32. Six envs build, 203 host cases pass, `check_lines` green at 941.

  **THE CORRECTION — the same key, the same board, hours later, and it did not reproduce.** The operator asked for `powerAlways` restored after the `/devices.html` save deleted it. It was set true again on probe 0 and the board rebooted, and **Zona 1 did not go to the rail**: 85.15 falling to 82.32 over 2.5 minutes at `var` 0.08-0.43, then 82.12 at `var` 0.54. So the headline above is **false as a general claim** and is corrected rather than deleted, because the 0.00 was real and reproduced three times when it was measured.

  **What is different, and what that costs the conclusion.** Between the two runs the operator rewired: where one probe was connected and three pins floated, four probes now sit in real soil and two are named for plants. Zona 1 itself moved from 44.1 to ~82 on the gated reading, so **it is not the same probe in the same state**, and nothing here can say whether the rail was that probe, that contact, that soil, or a condition nobody recorded. **The polarisation mechanism proposed above is therefore an inference with one supporting run and one contradicting run, and it should not be repeated as fact.**

  **What the second run DOES show, and it is the more useful half: the readings move under continuous power, downward, and had not settled.** Against the gated values taken ten minutes earlier — Zona 1 81.90, Zona 2 86.95, Zona 3 83.84, Zona 4 73.71 at `var` 0.03-0.16 — the always-on board read **82.12 / 49.23 / 75.29 / 45.08** at `var` 0.54 / 8.16 / 5.74 / 0.78. Zona 2 fell ~37 points and Zona 4 ~28, and the raised variances say both were still moving. **That is the same direction as the rail on a slower timescale**, which is what polarisation would look like, and it is also exactly what an operator handling probes would look like — the two are not separated here. **The consequence for the project is concrete and does not depend on the mechanism: a two-point calibration or a trained class taken while the baseline is walking is precise and wrong**, which is the mistake this file already records from 2026-09-03. Let it sit before anchoring anything.

  **The LED contradiction is probably resolved, and probably is the honest word.** The operator reported the module's power LED blinking and, separately, that the `/devices.html` save had destroyed the key — so for an unknown part of that window the flag was simply ABSENT and blinking was correct behaviour. That fits every observation without needing something else to drive GPIO 14. It is not established: nobody looked at the LED with a known flag state, and nobody has put a meter on the pin. Task 020 holds the one-glance check.

- **The whole 8 MB flash of the live garden was read back over USB, and it verifies against this tree** (2026-09-26, device `b580`, firmware 2.20.0, `esptool.py v4.9.0`). **No C++ changed, nothing was written to the board, and `FW_VERSION` did not move** — `read_flash 0 ALL` at 921600 baud, 8 388 608 bytes in 109.9 s, then one `hard_reset`. The artefacts are in `backups/flash/`, which has its own README carrying the restore procedure.

  - **There is no web path to this, and that is the reason for the cable.** The firmware's OTA endpoints only WRITE (`/update`, `/spiffs/upload`); `GET /spiffs/*` serves LittleFS files but reaches neither the app, the bootloader, nor the partition table. A clone needs serial, and so does the restore, for the reason [Hardware v3](hardware.md) already gives: a partition table cannot be delivered over the air.
  - **The dump is trustworthy because one region can be checked against a known artefact.** `app1` is **byte-identical to `.pio/build/espgarden_s3/firmware.bin`** (1 265 920 B, the 2.20.0 image), `app0` holds 2.19.0, and `otadata`'s `ota_seq 3 / 4` says ota_1 is the running slot — all three agree. The partition table parsed out of 0x8000 **matches `partitions/esp_garden_8mb.csv` entry for entry**. Without that app comparison, "the file is 8 MB long" would have said nothing.
  - **The filesystem came across whole**: 608 of 608 blocks written, 44 files including all eight `hist0..7.bin`, `moisture_model.bin`, `users.json`, `sessions.json` and both `.pem` bundles, and **a whole parseable `/config.json` was recovered out of the raw blocks** (`id b580`, `history.records 10000`, four probes, four relays). `provisioned.pending` is absent, which is correct for a board that has associated.
  - **`Status.History` read `7941 / 8125` before and `7952 / 8125` after**, climbing one a minute — so the read did not touch the partition, and this is also the 2.20.0 denominator caught mid-walk from the old 5000 toward 10000 as segments recycle, which is the convergence [that entry](#what-has-actually-run) records as never having been watched.
  - **The garden was down for the read plus a 6 s reboot, and the relay state was checked FIRST.** No relay was energised; the read would have been refused otherwise, because download mode stops the app and a reset on a board with a running pump is the one thing not to do. **That check is a `/data.json` read, not a scope on a coil** — the carrier's released-at-reset safe state is still the netlist argument it has always been.
  - **`mklittlefs` cannot read this image**, both the 0.2.3 and the `@src-` build in this workstation's PlatformIO install: `Corrupted dir pair at {0x0, 0x1}`. The extraction offset is not the problem — block 1 at 0x591000 carries the `littlefs` superblock magic and readable directory entries — it is a LittleFS version mismatch against the ESP32 Arduino core's lfs. So **there is no unpack/repack path here**, and the restore procedure is written so it does not need one.
  - **A byte-identical clone will NOT come up as a working garden, and that is by design.** `ConfigFile::loadFile()` rejects the document when `id` does not match the new chip's efuse MAC, so the clone raises the setup AP instead — the [`id` trap](#swapping-the-board) this file already documents, arriving through a new door. Three more fields have to change before a clone touches a network: `hostname` (two boards answering `espgarden-s3` over mDNS), `mqtt.username` (**the ThingsBoard access token — two devices on one token both write into the garden's own series**), and `ota.password`.
  - **THE IMAGE IS A CREDENTIAL.** Flash encryption is not enabled on this board — established by reading the dump, where the Wi-Fi password, the ThingsBoard token, `users.json`'s hashes and `sessions.json`'s live bearer tokens are all plain text. `backups/` is gitignored, which stops `git add .` and nothing else.
  - **And it found a core dump nobody knew about**: 10 756 bytes with an ELF at offset 20 in the `coredump` partition. Decoding it needs `espcoredump` and the exact ELF that produced it. **Not investigated** — it is captured now either way, and the 2026-09-17 line claiming no core dump has been qualified rather than left standing.

  **THE CLONE WAS THEN WRITTEN TO A SECOND ESP32-S3, AND IT BEHAVED EXACTLY AS PREDICTED** (2026-09-26, same day, a new board on COM5). The part is the same: ESP32-S3 QFN56 **rev v0.2**, embedded PSRAM 8 MB (AP_3v3), 8 MB flash (GigaDevice `c8`/`4017`, quad, 3.3 V by efuse). `write_flash` with the three `keep` flags took **39.9 s** — 8 388 608 bytes compressed to 2 039 017 — and answered `Hash of data verified.`

  - **The id arithmetic was right, and then the firmware confirmed it.** `d0:cf:13:1e:22:9c` predicts `mac[0] | mac[1] << 8` = **`cfd0`**, and the boot line reads `ID: cfd0`. That is now three MACs this arithmetic has been checked against (`b580`, `6224`, `cfd0`), and it is still not the way to get the number: the boot line is by definition what `loadFile()` compares against, and reading it is what confirmed the prediction rather than the other way round.
  - **The predicted refusal fired and the portal came up**: `Device ID does not match config file ID.` → `SETUP PORTAL: /config.json is missing, unparseable, addressed at another chip, or short of a required field` → `Raising AP 'espgarden-cfd0'`. **So a clone is INERT on the network by construction**, which is the reassuring half: the config is rejected, `ssid` falls back to the compiled `"undefined"`, the board cannot associate, and `tasksSetup()` takes the portal path — no MQTT, so the garden's ThingsBoard token cannot be used by the clone even though the clone is carrying it. The four-fields warning still stands for the moment somebody fixes `id`; it just is not urgent before then.
  - **THE STORED HISTORY CROSSED ONTO DIFFERENT SILICON AND IS READABLE.** `io_history: ready, 7942/7942 records across 8 of 8 segments` on a chip that has never written a record. Nothing in the segment format is chip-specific and nothing needed to be — but that was an argument from reading `io_history.cpp`, and it is now an observation. The 7942 also matches the dump: the garden held ~7941 records when the read started.
  - **A SHRINK and its second warning ran, and the mechanism is an accident rather than a design.** The rejected config took `history.records` with it, so the compiled default **1440** is what `ioHistoryFitCapacity()` was asked for — against stored segments written for 10000. Both warnings printed, including the one this file listed as never having run: *"that is a REDUCTION, so until it has converged the buffer holds more than the configured capacity and each rotation drops a whole old segment — up to 1250 records at once rather than 180. Nothing is discarded to make it happen sooner, so if the point was to FREE SPACE, the flash comes back one segment per rotation and not at this boot."* **A rejected config is a cheap way to reach the shrink path**, and it is worth knowing that it is reachable without anybody deliberately reducing the number.
  - **The adoption warning printed a RANGE for the first time — `625..1250` — and that is the mixed-geometry case caught live.** Every earlier firing said a single value. The garden's eight slots were genuinely mid-convergence when the dump was taken: some already recycled at the new 1250, some still at the old 625. So the frozen image is itself the evidence for the convergence this file records as *"nothing has watched one complete"* — a snapshot of it in progress, not a complete cycle.
  - **One number is not explained here and is flagged rather than guessed at.** The boot log grants **1440** (`io_history: 1440 records fit`) and then reports capacity **7942**, so `Status.History` on this board would read `7942 / 7942` against a configured 1440. `capacity()` is `liveCapacity()`, the sum of the slots' own ceilings, and 8 inherited slots at 625..1250 do sum to about that — which would make it the documented moving denominator at its most extreme, converging down to 1440 over one cycle of the slots. **That is an inference from the design and not something measured**: nothing here watched the denominator move, and `stored == capacity` exactly is the part that deserves a second look before anyone quotes this as the mechanism.

  **AND THEN THE CLONE BECAME THE GARDEN, BY PATCHING FOUR CHARACTERS INSTEAD OF WALKING THE PORTAL.** The onboarding route this file documented would have worked and was not used, because a straight replacement wants the cloned identity kept rather than re-entered. `"id":"b580"` was overwritten with `"id":"cfd0"` inside the image's LittleFS region and **only that partition** was rewritten — 2.375 MB in 13 s. The board then came up as the garden on its first boot with nothing to re-enter.

  - **Three facts make the edit safe, and each was checked rather than assumed.** The literal occurs **exactly once in the whole 8 MB** (flash 0x73100D, block 417) — a second hit would mean a stale copy and patching the wrong one changes nothing while looking like it worked. `config.json` is **1806 B against an inline cap of `min(cache_size, block_size/8)` = 512 B**, so it lives in an ordinary data block, and LittleFS CRCs cover metadata commits and **not** file data — a same-length edit is invisible to the filesystem. And `loadFile()` parses the field with `strtol(id, &endPtr, 16)`, so the value is case-insensitive hex. The diff was then asserted surgical before flashing: **three bytes moved**, not four, because `b580` → `cfd0` shares its trailing `0`.
  - **Writing only the filesystem partition is what makes it cheap to be wrong.** The app is untouched, so a bad patch is a failed mount, `LittleFS.begin(true)` reformatting, and 501 on every route — recoverable by writing the pristine `littlefs.bin` back. Nothing about the app or the bootloader is at risk.
  - **Everything crossed and is READABLE, not merely counted.** `io_history: ready, 7942/8125 records` with the configured 10000 granted again; the oldest record pages back to **2026-09-21 02:44:33** and the newest is **2026-09-26 15:50:05**, the instant of the dump — and the new board's own records append straight onto it, so **the 60 s archive is continuous across a hardware swap** with one 39-minute hole for the read, the write and the reboots. `[moisture] model loaded, 0/4 probes usable`, `Restored 6 persistent session(s)`, `Sensors: 4 moisture, luminosity, SHT40, flow, float switch`.
  - **With the config accepted the adoption warning changed its answer, and that is the convergence quantified**: `3 of 8 stored segments were written at 625..625 records each against the 1250 a new one gets`. So five of the garden's eight slots had already been recycled to 1250 and three had not. Under the rejected config the same line said `8 of 8 ... 625..1250`, because the target was then the compiled 180 and every slot differed from it.
  - **The identity was confirmed on the SERVER, not on the device's own say-so** — this project has already paid three years for a dashboard reporting a healthy link over a broker receiving nothing. Device: `Last Publish 89s ago`, `Packages Sent 1`. Server, same minute: seven keys took a new point at **16:37:28** (`moisture1` 73.34, `moisture2` 30.36, `moisture3` 84.40, `moisture4` 59.43, `temperature` 31.56, `airHumidity` 36.52, `luminosity` 59.59), into `espgarden-s3`'s own series, which still holds **51 telemetry keys**.
  - **`/control` takes the WORD, not a number.** `mqtt=0` is silently ignored — the handler compares against `"enable"` and `"disable"` — and `/data.json` went on reading `MQTT: enabled` after it. That matters because it was the brake on a real hazard: **once `id` is correct the board IS the garden wherever it physically is**, so five minutes on a bench publishes floating-pin values and a `100.00` ambient error rate into the live series, and the 60 s history task writes a junk record a minute into the real archive. `mqtt=disable` landed 2 min into the 300 s first-payload delay and the server received nothing (`Last Publish n/a`, `Packages Sent 0`); only **three** bench records reached the buffer. It is a runtime toggle and does not persist, so the power cycle that moves the module into the carrier re-enables it by itself — which is the right default for exactly this operation.
  - **The probes prove the carrier by their VARIANCE, not their value.** On the bench all four sat at `var` 48–77, the floating-pin signature this file already documents; in the carrier they read `var` **0.65–9.81** and the four values separate properly (77.17 / 33.06 / 88.01 / 63.49) instead of clustering. The SHT40 came back at `Ambient Error Rate 0.00`, 31.49 °C, 36.73 %RH. **The stored record carries the seam itself**: `16:31:00 temp=None` (bench) → `16:33:14 temp=31.5` (carrier), the same `null`-to-value transition in the positional slot that 2026-09-17 recorded when the part was first declared.
  - **NO RELAY CLAIM MOVED, and the tempting reading is the wrong one.** Zero non-zero sticky masks in the 40 records around the swap — but the sticky mask is written by `relaysTick()`, and during a reset the firmware is not running, so **the record cannot see the window the carrier's safe state is actually about.** What is established is that nothing energised after the app came up. `J200` and the module's own pull-up through a reset remain read off a netlist. The float switch reads `Lowered` (an unwired-or-empty float at the internal pull-up) and `floatInterlock` is off, so nothing is being vetoed — worth knowing before anyone enables it.
  - **Heap with TLS up: Free 135–139 KB, Min Free 100–106 KB, Largest Block 101 KB**, against the 179–185 / 98–123 / 151–167 measured on the 2026-09-17 bench where the link was down. Still a different machine from the WROOM-32's 53 KB largest block.
  - **What is NOT established**: that the patched filesystem survives long-term wear the way a `mklittlefs`-built one would (it is the same bytes, so there is no reason it should not, and that is an argument rather than a measurement), and the retired `b580` has not been read back since — it was confirmed off the network before the new board went live and then set aside.

- **The acquisition time is a first-order term in the reading** (2026-11-09, device `cfd0`, measured on the self-hosted ThingsBoard archive, 441 298 rows, 09-17 .. 11-09). The operator confirmed the software restarts below were acquisition-time changes; the delta is the 40 min after minus the 40 min before, in ADC counts (higher is drier):

  | restart | change | Z1 | Espada | Z3 | Arranjo |
  |---|---|---|---|---|---|
  | 09-28 19:49 | settle 50 -> 100 ms | +83 | +155 | +81 | +238 |
  | 09-28 21:04-21:30 | settle 100 -> 1000 ms, period 1 -> 60 s | +18 | +183 | +27 | +219 |
  | 10-02 03:54 | acquisition time, values not recorded | +215 | +423 | +234 | +242 |
  | 10-10 17:54 | period 60 -> 120 -> 60 s (boot log) | ~0 | ~0 | ~0 | ~0 |
  | 10-16 01:56 | acquisition time, ending at settle 2000 ms | -53 | -319 | -42 | -222 |

  **Longer powered time reads drier** both times the direction is known, the period alone moves nothing, and no plateau is in evidence up to 1000 ms. Up to ~420 counts is comparable to a week of drying, so a calibration is valid for ONE acquisition protocol only. **Handling a probe is a step too**: every reinsertion of probes 1 and 3 between 10-02 and 10-30 brought them back wetter (+15 points each in total), and an air test on 10-30 12:16 .. 12:51 pinned both at ADC 4095 with Sd 0, proving probe and channel alive. **Queued MQTT payloads are stamped on arrival**: the 10-17 12:07 .. 12:54 outage arrived as 9 points within 0.5 s at 12:54:04.

- **Several samples per acquisition window, on the device** (2026-11-09, `cfd0`, firmware 2.23.0 from `10bf62e`, ELF in `backups/elf/`). `deploy_ota.py --firmware-only` flashed it in **20 s** of upload with every relay idle; history 9 671 -> 9 675 records and the filesystem at 748 KB on both sides. **The defaults change nothing**: the boot log read `settle 2000 ms, 1 sample(s) per window (every 0 ms), median of the last 1`, every probe's single sample landed at **exactly 2000 ms**, and the readings sat where 2.22.0 had them (Zona 1 96.33 against 96.24, Espada 89.26 against 89.28, Zona 3 92.65 against 92.60). `soilMoistureSampleMs` was then set to 100 through a masked `GET` -> `POST /config.json` round trip — `device_http.post_config()`'s first use against the garden, answered `{"saved":true,"restartRequired":true,"reauth":false}` — and `/control reset=1`; the board was back in 4 s. Six consecutive windows in steady state:

  | | slope at 1500..1900 ms (counts / 100 ms) | final ADC, six windows |
  |---|---|---|
  | Zona 1 | 1.5 .. 2.2 | 149 .. 151 |
  | Espada | 14.2 .. 17.8 | 435 .. 441 |
  | Zona 3 | 3.8 .. 7.0 | 299 .. 302 |
  | Arranjo | 15.6 .. 19.8 | 1054 .. 1071 (still absorbing a watering) |

  - **No probe plateaus by 2000 ms.** Median curve on Espada: 65 @100, 171 @500, 279 @1000, 364 @1500, 437 @2000 — a fast rise and then a near-linear creep, electrode polarisation under DC. A settle "past which the reading stops moving" does not exist below 2 s on this hardware.
  - **The final sample landed at exactly 2000 ms in all six**, the floor exemption working; window samples were skipped behind other tasks (gaps up to 410 ms, one window with 10 of 20), which costs nothing because each carries its measured time. **The first window after boot was 212 ms late** and read Espada ~22 counts drier: scheduler lateness reaches the published value, as it always could in 2.22.0, and is now visible.
  - **Window-to-window repeatability is ±1..3 counts**, so the tail median buys little here; what matters is WHEN the reading is taken.
  - Heap with sampling on: 142 KB free, 110 KB low-water, 119 KB largest block.

- **The value at the settle, on the device** (2026-11-09, `cfd0`, firmware 2.24.0 from `12c94a4`, ELF in `backups/elf/`). `deploy_ota.py --firmware-only`, 11.8 s, history 9 003 -> 9 006. Twenty consecutive windows were polled from 13:32 to 13:52, at settle 2000 ms, interval 100, tail 1.
  - **The 1 s hold is gone.** The largest in-window gap was **573 ms** across 39 gaps, median 334 ms. On 2.23.0 one window in six could not start until 1062 ms.
  - **Late finals are still common, and are now corrected.** `timing` read 9 late of 25 windows since boot: max 230 ms, mean 97 ms. In the polled set six were late, by 7 to 171 ms. Corrected late values against on-time windows:

    | Probe | On-time median (n = 14) | Late, raw | Late, corrected |
    |---|---|---|---|
    | Espada | 425.0 | 431.0 | 423.8 |
    | Zona 3 | 285.5 | 291.5 | 286.7 |
    | Arranjo | 1157.5 | 1160.5 | 1154.6 |

    The 171 ms window read Espada 444 raw and published 421.9.
  - **A ~300 ms hold remains**, twice per window, about 1.2–1.3 s apart: a 1 s task taking ~300 ms. The suspect is `webUpdateDataCache()`, not yet proven. It calls `FILESYSTEM.usedBytes()` and `totalBytes()` every second, and in arduino-esp32 2.0.17 both go through `esp_littlefs_info(&total, &used)`, which traverses the whole filesystem (`lfs_fs_size`). That is read in the source and not timed on the device.
  - **Spikes exist but are rare.** Espada's final step was +56 once, against +12..+14 normally, and Arranjo dipped −29 once mid-window. Each was a single sample. A tail above 1 would reject them.

**Unverified — written, compiles, never run on hardware:**

- **The parts of 2.24.0 that have NOT run.** A dead internet link with one ping per address: three 1 s timeouts is library arithmetic, never timed. A tail above 1 with the interpolated final. A settle under the floor reporting 40 ms late every window, which is exercised only in the simulator. Any WROOM-32 board.

- **The parts of firmware 2.23.0 that have NOT run.** A tail above 1, a window past 64 samples (`dropped` > 0), the boot refusal of a non-numeric or out-of-range key, the tail-exceeds-window warning, and any WROOM-32 board (where the ~2 KB of extra static RAM sits beside a ~53 KB largest free block). The whole schedule — begin/step/wait against the 50 ms floor, the late-wake rule, the final sample that escapes the floor, the 64-sample window and the tail median — is host-tested (`test_probe_sampling`, 18 cases); a review pass found the floor delaying the final sample and probe health being fed the median, both fixed before anything flashed.

- **The configurable moisture sampling period (firmware 2.21.0).** `io.soilMoisturePeriodSec`, and the `moisture` task the probe read moved to. Six envs build, `pio test -e native` passes at **211 cases** (unchanged by this change — neither `sensors.cpp` nor `tasks.cpp` is reachable from `[env:native]`), `check_lines.py` green. **Nothing was flashed and no board was touched, and no period other than the 1 s default has run on a device** — at 1 s the behaviour is identical to 2.20.0. `espgarden2` +1 004 B flash and +40 B static RAM; `espgarden_s3` +1 032 B and the same +40 B. What ran on the host and against the simulator, and what did not, is in [docs/soil-moisture-sampling.md](soil-moisture-sampling.md).

- **`scripts/flash_clone.py` + `scripts/flash_image.py` script an operation that was done BY HAND, and only the reading half of the script has been exercised** (2026-09-26). **No C++ changed, `FW_VERSION` did not move, and the tool has never opened a serial port** — the only esptool it has invoked is `version`, which opens none. `--self-test` passes at **125 checks** offline with no credential, `check_lines.py` is green at 996 and 994 (**4 lines of margin**, so the next change there splits a third module — probably the self-test).
  - **What IS exercised, against the real 8 MB dump:** `--verify` independently reproduces every finding the manual run made — family, `ota_seq 3/4 → ota_1`, app0 2.19.0 and app1 2.20.0, 44 filenames, `config.json id b580`, and the coredump FINDING — and `--patch-id cfd0` as a dry run lands on the same offset the hand-patch used, found independently. All 12 checks pass.
  - **What is NOT:** the whole backup and restore paths, the manifest writer, the partition split, the readback compare, the banner parser against a real banner (only synthesized S3 and WROOM-32 text), and the `--patch-id` WRITE. Every one of those ran by hand on 2026-09-26 and none of them has run through this tool.
  - **It found four real errors in the brief it was given, and two are worth keeping.** A filename regex spelling `(?:html|js|css|json|…)` silently truncates every `.json` to `.js`, because `js` precedes `json` in the alternation and the pattern is not end-anchored — so the manual run's own file list reported `users.js` and `sessions.js`, which is "web asset" where the truth is "credential store". (The claim in `backups/flash/README.md` is unaffected: those four names were established by a byte search for the whole filename, not by the regex.) And `\b\d+\.\d+\.\d+\b` matched `55.255.255` out of this firmware's own `255.255.255.0` netmask string, so the version scan now anchors on strings the firmware prints about itself (`Initializing ESP Garden X.Y.Z`, `"firmware":"X.Y.Z"`) and reports a version as **named** rather than merely found. The other two: the coredump ELF sits at offset 20, so its header is 20 bytes and not 24; and `ota_seq == 0` must count as blank, because the bootloader's `(seq - 1) % n` underflows there.
  - **The credential path is deliberately narrower than the other tools'.** `--device` takes `--password` or `ESP_GARDEN_PASSWORD` and will not read `data/config.json` the way `moisture_fit.py` and `history_export.py` do.

- **Changing `history.records` no longer deletes the stored history, and the ceiling is 10000 (firmware 2.20.0).** Six envs build, `pio test -e native` passes at **211 cases** (8 new, all in `test_segment_index`), `check_lines.py` green. **THIS HAS NOW RUN ON THE GARDEN — see the 2026-09-22 entry in the verified list**, which is the record that counts; what stays here is the design and the parts a device has still not exercised. Two changes in one commit, and they are independent: `adoptSegmentLocked()` stopped treating a segment's own per-segment capacity as a reason to `remove()` the file, and `ConfigFile::loadFile()`'s static ceiling went 5000 → 10000. See [I/O history](io-history.md) for the design and [the ring-buffer entry](filesystem.md) for why this component is the one to be careful with.

  **The line between what was tested and what was not is sharper here than usual, and it is the whole of what this entry is for.** `src/io_history.cpp` reaches Arduino, FreeRTOS and LittleFS and is **not reachable from `[env:native]` at all** — not one line of it executed. What the 8 new host cases exercise is `include/core/segment_index.h` and a **second implementation** of `append()`/`rotateLocked()`'s decisions written against it in the test file. A green suite here is a statement about the arithmetic and about the interaction of `locate()`, `slotToRecycle()`, `buildOrder()` and the fill rule; it is not a statement about the firmware's adoption, its file I/O or its mutex.

  - **What the host cases cover**, and they were chosen for the failure mode this component has already had once — a wrong answer that reorders history instead of failing. Every append in every scenario is checked against one invariant: the held records are exactly the contiguous run of ordinals ending at the newest, in order, so a reorder, a duplicate, a hole and a silent loss are all one assertion. On top of that: a **grow** (5 → 12 per segment) across nine rotations, a **shrink** (12 → 3) across nine, a resize **undone before it converges** so three capacities are live in the eight slots at once, `locate()` across mixed-capacity segments with the slots out of sequence order, the **absolute-ordinal walk** `forEach()` uses crossing a rotation that evicts eleven records where the geometry says four, and that no segment is ever written past its own header in any of them. Both directions converge to a uniform geometry within one cycle of the slots and the test asserts that they do.
  - **`segment_index.h` gained two functions and lost none.** `segmentFillLimit(own, target)` — the `min()` whose two halves each have a reason, stated in the header — and `liveCapacity()`, which replaces `segmentRecords * kSegments` in `IoHistory::capacity()`. **The rest of the index arithmetic was NOT touched**, because `locate()` sums per-slot counts and the walk corrects by `evicted()`: neither ever assumed uniform segments. That is a claim from reading and from the new tests, not from a device.
  - **The new state is 16 bytes**, `segmentCapacity[8]`, and the measured static-RAM delta is exactly that.
  - **The ceiling's two answers are arithmetic on numbers read off the two boards**, not measurements taken after the change. A WROOM-32 with device 6224's figures (512 KB partition, 168 KB free, 1298 records on disk) resolves a request of 10000 to **3408 — identical to what it resolves 5000 to**, because there the fit check refuses and the constant never gets a say. The S3 carrier (2432 KB filesystem, 248 KB used) is granted **10000 whole, at 480 KB**, on a partition that would hold 40 952. Both are asserted in `test_what_each_family_actually_resolves_to_at_the_raised_ceiling`; **neither has been computed by a device.**
  - **THE TRAINING COST IS ARITHMETIC AND NOBODY HAS TIMED IT.** `moistureModelTrain()` makes up to **three** `forEach` passes over the whole buffer (read in `src/moisture_model.cpp`: `collectEvents`, then `accumulate` twice), so a daily run is up to `3 × capacity` seek-and-read operations: **4 320 at 1440, 10 224 at 6224's 3408, and 30 000 at 10000**. This file already records that the walk "stalls other background tasks for seconds" at the current capacity, and that sentence is the ONLY anchor — it is a qualitative note, not a measurement, so the scaling above has nothing to multiply. Two mitigations are real and neither is a number: passes 2 and 3 are skipped entirely when no watering cycle completed since the last run, which is **every run on both gardens today**, so the common case is one pass; and `forEach()` releases the mutex every 64 records, so it does not block `async_tcp` for the whole walk. What it does block is the other background tasks, which are cooperative and run one per `execute()`.
  - **A second unmeasured cost, flagged rather than fixed.** `readDecimatedLocked()` reads EVERY record in the requested span in order to OR the sticky relay mask, so `GET /history.json?window=<large>` over a full buffer is now up to 10000 reads on the `async_tcp` task where the old ceiling put it at 5000. The 200-record response cap and the `static IoRecord buffer[200]` are untouched; the read count is not bounded by them.
  - **Specifically NOT exercised, and mostly unreachable from the host:** `adoptSegmentLocked()` reading a real header off LittleFS, so the refusal of a zero `records` field, the "holds more than its header allows" clamp and the two `reportInheritedGeometry()` warnings have been rendered by nothing; a real boot with segments on disk from a previous capacity; the space argument (peak on-disk = `max(old total, storageBytes(granted))`), which is reasoning about the fit check and not a partition anybody watched; and `scripts/sim_state.py`, which **cannot** reach the mixed-geometry case at all — it builds a fresh `SegmentHistory` on every reconfigure and never re-adopts files across a capacity change, which is exactly the boot this change is about. That is recorded in the mirror's own comment rather than papered over.
  - **The one thing the previous behaviour did better**, said out loud: deleting every segment returned the flash instantly. Shrinking to free space now returns it one segment per rotation. The boot log says so.
  - **Flash and static RAM, a clean A/B against `35c14c6` in a separate worktree:** `espgarden2` **1 312 785 → 1 314 737 = +1 952 B flash**, 67 440 → 67 456 = **+16 B static RAM**; `espgarden_s3` 1 263 493 → 1 265 465 = **+1 972 B**, 66 288 → 66 304 = **+16 B**. Per object with `xtensa-esp32-elf-size` on `espgarden2`: `io_history.cpp.o` **+2 084 text and +16 data** — almost all of it the two `reportInheritedGeometry()` warning strings and the `String` concatenation that builds them — `web.cpp.o` +40 and `web_data.cpp.o` +38, which is `capacity()` expanding from one multiply into an eight-slot loop at each call site, and **`config.cpp.o` +0**, because 10000 and 5000 are the same immediate. The per-object sum is 2 178 B against a 1 952 B image delta; the difference is **not attributed** and is most likely literal pooling at link time.

- **The crossed-probe correction is BUILT and DRY-RUN, and the correction itself has NOT been applied** (`scripts/tb_swap_keys.py` + `tb_swap_model.py`, 2026-09-21). **No C++ changed, `FW_VERSION` was deliberately NOT bumped, nothing was flashed and no ESP32 was touched.** `pio run` and `pio test -e native` were not run and nothing in this change can reach them; `check_lines.py` is green at 978, the tool at 604 and the model at 647 after the pair was split at the 1000-line gate (it reached 1164 as one file). `--self-test` passes at **76 checks**, offline and with no credential.

  **The split between what ran and what did not is the whole point of this entry.** What EXECUTED against the live self-hosted instance is real and is not a mirror — every line below is an HTTP response:

  - **`--probe` holds on a throwaway device the tool creates and deletes** (`zz-swap-probe-<epoch>`, gone from the tenant listing afterwards, checked). A **backdated write** to 2026-09-18 15:04:55 was accepted and read back. The same `(entity, key, ts)` written three times with three values left **one point holding the last**, so a re-write is an OVERWRITE and a dead run is simply re-runnable — re-measured here rather than cited from the migration. **The typing round trip held on 8 of 8 shapes**, character-identical, including the 17-significant-digit literal ThingsBoard stores as a STRING and a quoted string with an embedded quote. And **the self-inverse property was measured, not argued**: a seeded pair swapped once CROSSED and swapped twice came back **identical to the original**. That last one is the cheapest possible proof the permutation is clean, and it is why this is safe to authorise at all.
  - **The whole tool ran end to end on a second throwaway** — `--plan --write-plan` → `--apply --yes` → `--verify` → `--apply --yes` again. 60 timestamps, 360 datapoints, one request. `--verify` counted all six keys 60/60/60 with **every point compared, not a sample**, printed the four judged samples per key character by character, and reported the **(timestamp, value) multiset IDENTICAL before and after** — which is the arithmetic of the word *relabelling*. The second `--apply` wrote **nothing**: `0 pending, 60 already swapped`. So idempotence is an observed property of the classify-then-write design, not a flag.
  - **Six refusals fired for real**, four against the garden's own series (reads only) and two on the throwaway: a partial pair (`moisture1` without its `Now` and `Sd` twins), a pair naming a key the device does not hold, a backwards window, `--apply` with no stored plan, `--apply` without `--yes`, and — after the throwaway had been swapped — the **re-plan guard**, which refuses to record an already-swapped series as the `before` state, because applying that plan would swap it straight back. A deliberately corrupted point was then classified **FOREIGN** and `--apply` refused rather than guessing which of the two states it was looking at.

  **WHAT HAS NOT RUN IS THE CORRECTION.** `--apply` has never been pointed at `espgarden-s3`, no byte has been written to either garden device, and the plan file for it has never been stored. The dry run against the real series is a READ.

  **AND THE DRY RUN REFUSED THE WINDOW IT WAS HANDED, WHICH IS THE FINDING.** The window on record — `2026-09-18 15:04:55 .. 2026-09-21 19:34:00`, 909 points per key, 5454 datapoints — has a START the record corroborates (a **174.8 min hole** in front of it, 35x the 300 s cadence, with all four channels reading 0.00–4.8 before it) and an **END the record contradicts**. The end of a crossed window is by definition a CROSSOVER, and at 19:34 the two series are continuous under their OWN names: `moisture1` 72.23 inside against 70.85 after, `moisture3` 79.28 against 83.63 — same-name continuity **5.74**, crossed continuity **19.83**. The exchange is **earlier**: `moisture1` steps 82.89 → 72.39 between 18:44:06 and 18:54:06, `moisture3` rises 71.36 → 83.5 across the **21.1-minute publish gap at 18:59:06–19:20:15**, and the settled levels either side are 82.93/71.49 before and 70.93/83.54 after — a clean exchange of two levels over about fifty minutes, which is what physically swapping two plugs with a reboot in the middle looks like. **The three samples at 19:20:15, 19:25:15 and 19:30:15 are already POST-rewire**, so the given window would have un-corrected them by roughly the 7.6 points it was meant to fix. At `--to "2026-09-21 18:44:06"` the same test reads CROSSOVER at margin **+14.10** and the plan is **903 points per key, 5418 datapoints, one 199 KB request**. Which boundary is right is the operator's call and the tool will not make it: `--boundary-override` exists and has to be typed.

  **Specifically a judgement rather than a measurement:** `EVIDENCE_SAMPLES` = 3 and `EVIDENCE_SETTLE` = 3 — the second skips the samples just after the boundary, where a hand is still on the hardware, and at this boundary the verdict is the same at every setting tried, but nothing says 3 is the right number on a boundary that is genuinely marginal; and `START_GAP_FACTOR` = 3, against a gap that is 35x, so nothing here turns on it. **Also never exercised:** a retry or a re-authentication (zero 429s, zero 5xx, zero 401s, and the longest write took 0.6 s), a window large enough to need more than one batch, and the tool against `espgarden1`, which it has never been pointed at.

- **`/devices.html` no longer deletes the keys it cannot render** (`data/devices_model.js`, `devices_render.js`, `devices.js`, `devices.html`; `scripts/sim_config.py`). **No C++ changed, `FW_VERSION` was deliberately NOT bumped, nothing was flashed and no board was touched.** Six envs build, `pio test -e native` passes at **203** — unchanged BY THIS CHANGE, because nothing the suite covers moved and none of `data/` is reachable from `[env:native]` — and `check_lines.py` is green at 941, the largest in the tree (`devices_model.js` 762, `devices.js` 471, `devices_render.js` 373 — no split was needed). `build_assets.py --list` still resolves the page's bundle in order (`auth.js + devices_model.js + devices_render.js + devices.js`).

  **What EXECUTED is a real browser against `scripts/dev_server.py`, and that is a stronger claim than this file's usual simulator caveat — but only on one side of the wire.** The simulator serves `data/` **verbatim**, so the assets Chrome loaded are byte-for-byte the ones a device serves gzipped; the page, its DOM, `collect()`, the render markup and `buildDocument()` are the firmware's own files, not a mirror. The DEVICE half is the mirror: `sim_config.config_apply()` stood in for `POST /config.json`, and `ConfigFile::loadFile()` was not in the loop at all. What that half rests on instead is that `loadProbePower()` parsing `powerAlways` **did** run on hardware on 2026-09-18 (the A/B above), so the only untested link is this document reaching that parser unchanged.

  - **The decisive run, in Chrome on 127.0.0.1:8080, reproducing exactly what the operator did:** a fixture serving `io.soilMoisture[1] = {pin 34, name "Bed 2", powerPin 25, powerOn 1, powerAlways true, settleMs 30}`, rename two probes, press Save, re-read `/config.json`. **`powerAlways: true` is still there**, the two names landed, `moisture[]` and `io.relays` are byte-identical, and the checkbox comes back ticked after the page's own reload. The checkbox itself was then driven through the DOM: unticked → the key is **deleted** from the stored document; re-ticked → it returns as a **real boolean**; ticked on a probe with no `powerPin` → the page warns *"names no power pin, so the request is dropped on save"* and the save drops it, which is right because `probe_power::pinIsAlwaysOn()` answers false without one.
  - **The same run against `git show HEAD:data/devices_model.js` FAILS**, which is what makes it a regression test rather than a demonstration: 8 of 19 checks red, the headline one being the key vanishing from a save that only renamed probes. That red/green ran through a Node harness (`vm` sandbox, the model loaded from disk, real HTTP to the simulator) whose only stand-in is **three jQuery statics** — `$.each`, `$.trim`, `$.inArray` — written to jQuery's documented semantics. The harness is in a scratchpad and is not committed; the browser run is what covers the DOM it cannot reach.
  - **The audit behind it, and what it found.** `buildDocument()` rebuilt four kinds of entry, and each rebuild was a delete of everything the page has no control for. Checked against what the firmware actually reads: `io.soilMoisture[]` (`loadSensor` + `loadProbePower`: `pin`, `name`, `powerPin`, `powerOn`, `powerAlways`, `settleMs`) — **`powerAlways` was the one real loss**; `moisture[]` (`dry`, `wet`, `relay`, `invert`, `kind`) — all five rendered, **no loss today**, and `kind` is the one whose loss would silently discard a probe's trained model; `io.relays[]` (`pin`, `on`, `name`) — all three rendered; `io.flow` / `io.floatSwitch` / `io.dht` / `io.luminosity` / `io.waterLevel` — every key the firmware reads is rendered. The top-level `io` block (`io.i2c`, `io.sht4x`, `io.button`) was **already** safe and is confirmed so by the synthetic checks. So exactly one key was being destroyed and the rest of the class was luck: the fix is structural — each entry now carries forward every key of the entry the device served that this page does not own, `powerAlways` included, with the owned sets written down as `RELAY_KEYS` / `PROBE_KEYS` / `CALIBRATION_KEYS` and a per-spec `owns` in `SENSORS`. Rows carry their own keys when they MOVE (a `sourceIndex` taken at load, not the row's index now), and the three deletes the page is entitled to still happen: a cleared name, an unticked `powerAlways`, and an unticked single-instance sensor, which takes its whole key by design.
  - **Specifically NOT exercised:** the device's own `POST /config.json`, `ConfigFile::loadFile()` and a boot with a page-written document; a firefox/safari rendering of anything; and **the `powerAlways` warning text is a judgement about wording, not a measurement** — the two facts in it are (the electrolysis line, from the sibling hardware repo, still unmeasured anywhere) and the 0.00/44.1 pair, which is the 2026-09-18 A/B above.

- **`io.soilMoisture[i].powerAlways` (firmware 2.19.0) has RUN, and the result is that nobody should use it on these probes — see the verified entry above.** Opt-in, **default false**, so every existing board is byte-identical: each new branch is behind the flag and the compiled default is off. Coalesced per PIN in `include/core/probe_power.h`, because the carrier's four probes share GPIO 14. **No host test was added and none of this is reachable from `[env:native]`**, so what holds the coalescing rule together is the A/B on the device and nothing else. **The `/devices.html` footgun this entry first recorded as "untouched deliberately" FIRED THE SAME DAY, on a live board, and is now fixed.** `buildDocument()` rebuilt each `io.soilMoisture` entry from the page's own model, which makes a rebuilt entry a silent DELETE of every key the page does not render — the operator renamed two probes, saved, and the document came back without `powerAlways`. The page now renders it as a checkbox on the probe row and carries it, and every entry it rebuilds carries its unrendered keys forward; see the `data/devices*.js` entry in the unverified list. The record stands that it was written down as a known hazard one commit before it cost a real setting. Still unexercised: **a board where only SOME of the probes sharing a pin ask for it** (the carrier set it on probe 0 of 4, which is the interesting case and DID hold the bank up — but the pin never had to stay up against a probe on a DIFFERENT pin powering down), and the skipped settle has never been timed.

- **The `tasks.cpp` split (firmware 2.18.1).** Six envs build, `pio test -e native` passes at **201 cases** — unchanged BY THIS CHANGE, because nothing the suite covers moved, and nothing in either file is reachable from `[env:native]` at all: `tasks.cpp` and `task_events.cpp` both reach FreeRTOS, WiFi, `Arduino_JSON` and LittleFS. `check_lines.py` green at **746** for `tasks.cpp`, 305 for `src/task_events.cpp`. **Nothing was flashed and no board was touched.**

  **The claim this rests on is a diff, not an execution.** `src/task_events.cpp` lines 24-280 are **byte-identical** to the 252 lines they were cut from, and the whole change to `tasks.cpp` is: one include swapped (`network/thingsboard.h` out — the last `tbPublishEvent()` call left with the publishers — `core/task_events.h` in), the moved block deleted, `armMoistureCheck()` added, and `checkMoistureTaskHandler()`'s loop replaced by a call to the function that now holds it. `ioTaskHandler()`, `tasksSetup()`, `tasksSetupOnboarding()`, `tasksLoop()`, every `DECLARE_TASK` and all 17 `addTask` lines are untouched — counted, not eyeballed. Four functions changed linkage (`static void` → `void`) and one statement became a call making the identical statement.

  **The flash cost is measured and it is NOT zero, which is the honest half.** `espgarden2` 1 311 897 → **1 312 153 = +256 B flash**, 67 416 → **67 408 = −8 B static RAM**; `espgarden_s3` 1 262 529 → **1 262 769 = +240 B**, 66 264 → **66 256 = −8 B**. Per object with `xtensa-esp32-elf-size`: `tasks.cpp.o` 11 798 → 8 012 text, `task_events.cpp.o` 4 172, so **+386 B of text** — four publishers that GCC used to inline into `ioTaskHandler()` are now out-of-line cross-TU calls, plus `armMoistureCheck()`. `bss` is 790 before and 772 + 18 after, i.e. the same bytes in a different file; `data` is 9 both times. The −8 B of static RAM is below section-alignment granularity and is **not attributed** — it is reported because it was measured, not because it is understood.

  **What is specifically NOT evidence:** that the boot order still holds is an argument from an unchanged diff, and no board has booted this image. The `checkMoisture` path is the one place behaviour could have moved and it is **unexercised on hardware either way** — this file already records that no watering has run on a probe's own pump, so `armMoistureCheck()`, `reportWateringResponse()` and the `g_moistureBeforeWatering` baseline have never fired on a device before or after the split.
- **What the migration tool did NOT exercise** (`scripts/tb_import.py` + `tb_client.py`, 2026-09-17). The bulk run, the verification, the idempotency test and the seam are measurements and sit in the verified list above. These are not:

  - **That the imported points SURVIVE.** Nothing here can see a nightly cleanup. The tenant profile is SYS_ADMIN-only on this instance, `/api/usage` reports every tenant limit at 0, and what was measured is a write and a read-back inside one session. ThingsBoard CE's timeseries TTL job runs on its own schedule, so **the only honest statement is that the rows were there minutes after they were written**. Re-running `--verify` in a week is the check, and it costs nothing.
  - **The guard that refuses to write underneath live data.** `upper_bound_refusal()` cannot fire against this migration: the seam is positive, so the branch that stops an older value landing on a newer one is dead code here. It was pulled out as a pure function and every branch is covered by `--self-test` for exactly that reason — the `--upper` past the archive's newest point IS exercised live (it refused, exit 1), the live-data branch is not.
  - **The retry and re-authentication paths.** Zero 429s, zero 5xx and zero 401s across every run; the longest write took 33 s, well inside a JWT's life. So the backoff, the `Retry-After` handling and the one-shot re-login are written and unreached. A run against a rate-limited tenant, or one long enough to outlive a token, is what would reach them.
  - **`tb_export.py` has never been pointed at the self-hosted instance**, so the round trip archive → self-hosted → archive has not been closed as a whole tool. It still reads `thingsboard.cloud` and its credential is a Cloud API key, where this writer logs in with an email and password: the two speak to different servers with different auth and nothing tests them against each other.
  - **No browser has drawn the imported series.** No ThingsBoard dashboard, widget or chart was opened; the evidence is REST counts and REST values. That the history and the live series join into one line on a chart is a structural argument from matching types, not a picture anybody looked at.
  - **`--attributes --write` has only ever written the two operator keys.** The `device` and `platform` classifications refuse by table, and those branches have refused — but nothing has tested what happens if a classified-`operator` attribute is ALSO present on the target, because both were absent.
  - **Nothing was written to `espgarden-s3`.** The archive holds no rows for it and the tool was never pointed at it; its series still begins at the cutover, with nothing behind it and nothing that could be.

- **The two 2.15.0 changes were measured SEPARATELY and shipped TOGETHER.** The SHT40's +25 636 B and the onboarding portal's +27 156 B are each a clean A/B against `bac7ad4`, and neither describes the image anybody will flash. Measured on the merged tree, six envs green: `espgarden2` links at **1 310 213 B flash (74.0 % of the 1.69 MB slot) and 67 392 B static RAM**, `espgarden_s3` at **1 260 833 B (43.7 % of 2.75 MB) and 66 240 B**. The app slot went 71.1 % → 74.0 % in one merge, which is the number to watch rather than either half.

- **The whole SHT40 / I²C driver** (firmware 2.14.0). Six envs build, `pio test -e native` passes at **201 cases** on the merged tree (20 new here: 17 in a new `test_sht4x`, 3 in `test_pin_rules`), `check_lines.py` green at 954/1000. **Most of this ran on hardware on 2026-09-17** — an SHT40 on the `esp-garden-hardware` carrier, board b580, answering at 0x44 on GPIO 8/9; see the verified entry above for what executed. **What is left below is what still has not**, and it is worth reading as a shorter list than it was: the accuracy of the part, the plausibility bounds, the read timing, `kShortRead`, the sharing exemption, and every browser and broker consumer of the two new keys. See [SHT40 on I²C](ambient-sensors.md) for the design. What is and is not evidence:

  - **The arithmetic IS executed, and it is the only half that can be.** `test_sht4x` holds `crc8()` to Sensirion's own published check value — `crc8(0xBE, 0xEF) == 0x92`, the one number in this change that comes from outside the repo — and the two conversions to the endpoints their formulae define (`0x0000` → -45.00 °C / -6.00 %RH, `0xFFFF` → 130.00 / 119.00, `0x6666` → exactly 25.00 / 44.00). Every frame test is built with that same `crc8()`, so **without the vendor check value they would only prove the code agrees with itself.** **Everything else about the part is READ FROM A DATASHEET**: that it answers at 0x44, that it ACKs `0xFD`, that 8.2 ms is the high-repeatability maximum, that `0x94` is a soft reset, that the B and C suffixes sit at 0x45 and 0x46. None of it has been confirmed against silicon.
  - **`src/sht4x.cpp` HAS now executed, on board b580 (2026-09-17) — see the entry above.** `sht4xBegin()` both ways, the no-ACK error naming the address, `kNotReady`, the `0x94` soft reset, the `0xFD` command and a CRC-checked frame are all measurements now. **What remains unreached is `kShortRead`, a mid-read `kNoAck`, and the TIMING.** The read cost — ~10 ms, of which ~9.1 is the datasheet's measurement time and ~0.8 is two transactions at 100 kHz — is still **arithmetic from the datasheet and the bus speed**: nothing has timed the `ambient` task on a board with an SHT40 on it, and the claim that this is CHEAPER than the DHT read it replaces still rests on the Adafruit driver's 20-27 ms bit-banged frame, read from that library's source and never timed here.
  - **The plausibility bounds have never rejected anything, and the bounds themselves are a judgement.** `-40..125 °C` is the part's operating range from the datasheet and it can only reject a 5 °C sliver at each rail of a conversion that spans -45..130 — so on any real garden it is dead code, which is exactly the point and exactly why it is unproven. `-5..105 %RH` pre-clip is **arithmetic about the ±1.8 % specification with generous margin, not a fitted threshold**: no part has been observed drifting, and nothing says ±5 is the right amount of room. The clip to 0..100 is Sensirion's own documented instruction, applied to a value the gate already accepted; no reading has been clipped.
  - **The mutual exclusion HAS fired on a device** (b580, 2026-09-17): a document declaring `io.dht` on GPIO 7 beside `io.sht4x` printed `loadFile()`'s warning naming the pin, was not refused, and cleared `dhtFitted` — the SHT40 won the task, the audit and the `/data.json` label together. **What is still a judgement rather than a measurement is that the SHT40 SHOULD win**: that is an argument about intent — a board can only reach that state because somebody added a better part to a board that had a worse one — not a measurement of anything. Deliberately NOT a config refusal, on this file's own record that a rejected document means compiled defaults and an unreachable board; the not-refused half is now observed, the wisdom of the choice is not.
  - **`ROLE_I2C`'s sharing exemption is still unreachable, but the bus is no longer hypothetical.** One bus registers SDA and SCL once, so there is no repeat to exempt until a second I²C KIND exists — the branch that makes two devices on one bus legal has never been taken, by a test or by a board. The rules it enforces are host-tested as a TABLE, and on 2026-09-17 that table was also confirmed against a chip: `validatePins()` ran on b580 with `io.i2c` declared on GPIO 8/9 and reported nothing, and `Wire.begin()` then drove a real transaction on those pins. **This file's earlier claim that no I²C transaction had happened on any pin is withdrawn.**
  - **`Status."Ambient Sensor"` and `Status."Ambient Error Rate"` are now served by a device** — b580, 2026-09-17, reading `SHT40` and `0.00` healthy, and `SHT40` with `100.00` when pointed at an address nothing answers. **The `ambient_sensor` client attribute has still been accepted by no broker**: that board's `mqtt.username` is empty, so the link sits at `down (rc=5)` and `tbOnConnect()` has never run there. **No browser has rendered either row either** — every reading above came from `curl`-shaped HTTP, not from `index.js`. The attribute's key name remains a convention argument (snake_case matches `fw_title`/`fw_version`; named for the question so one key can answer "DHT11"), not a measurement.
  - **The renamed `/data.json` Status label is a contract change nothing has consumed.** `"DHT Error Rate"` → `"Ambient Error Rate"`. `index.js` renders Status generically — verified by reading `formatStatusValue()`, which special-cases only Internet, MQTT, MQTT Link, Last Publish and Signal Strength — so nothing should break; no browser has loaded it. The TELEMETRY key stays `dhtErrorRate` on purpose, so **no stored ThingsBoard series changed**, and that is structural argument rather than a payload diffed against the broker.
  - **`templates/config.espgarden_s3.json`'s `io.i2c` and `io.sht4x` blocks HAVE now been through `ConfigFile::loadFile()`** — byte-for-byte those two blocks (`{"sda":8,"scl":9,"hz":100000}` and `{"name":"","address":68}`), inside b580's own document, on 2026-09-17, and the part answered. **The FILE itself still has not**: its `id` is the `1a2b` placeholder, the one field that bricks a board when wrong, and no filesystem image has been built from it. The guard in `scripts/pio_assets.py` sees the bus (`sda`/`scl` joined `_PIN_KEYS`, and without that a WROOM document's SDA 21 would have passed an S3 template declaring 8); re-verified 2026-09-16 that `espgarden_s3 -t buildfs` still refuses in **0.52 s naming ten foreign pins**, and that `declared_pins()` reads 8 and 9 from the template while reading neither `hz` nor `address` as a pin.
  - **The flash cost IS measured**, a clean A/B on `espgarden2` against `bac7ad4` in a separate worktree: **1 257 533 → 1 283 169 = +25 636 B flash, 66 592 → 66 960 = +368 B static RAM**, taking the app slot 71.1 % → 72.5 %. `espgarden_s3`: 1 209 805 → 1 234 529 = **+24 724 flash**, 65 464 → 65 808 = **+344 static RAM**, 42.0 % → 42.8 %. Attributed from the link map, summing only flash-bearing sections: **18 033 B of the WROOM figure is the Arduino/ESP-IDF I²C stack** — `libdriver.a(i2c.c)` +8 200, `libWire.a(Wire.cpp)` +4 709, `esp32-hal-i2c.c` +2 124, `i2c_hal.c` +1 627 and smaller — against **7 433 B** of this repo's own objects, of which `config_io.cpp.o` +1 923 and `config_document.cpp.o` +1 532 are the two largest and are mostly `String` log and refusal messages. On the S3 the same stack is +17 754. **That five WROOM-32 boards pay 18 KB for a bus they never start is accepted deliberately** and is the same trade the `HAS_*` removal made at 21 KB; that it costs them nothing at RUNTIME is read from the core's `Wire.cpp` — `TwoWire`'s constructor assigns seven fields and touches no hardware — not observed on a board.
- **The whole first-boot onboarding portal (firmware 2.15.0).** Six envs build, `pio test -e native` passes at **201 cases** on the merged tree (12 new here, in `test_onboarding`), `check_lines.py` green. **Superseded in large part on 2026-09-16**, when board `b580` raised its own AP and the whole flow was driven over it — see the verified entry above, which is the record that counts. What is left unverified below is what that run did not touch, and the list is kept because a green mirror is still not a statement about the firmware. See [First-boot onboarding](onboarding.md).

  **What HAS executed is `scripts/dev_server.py --onboarding`, and that is evidence about the simulator**, the same distinction the 2.11.0 and 2.11.2 entries had to be corrected for. Run in process on 2026-09-16: in portal mode `/`, `/onboarding.json` and `POST /onboarding` answered and **`/data.json`, `/config.json`, `/control`, `/users.json`, `/spiffs/config.json`, `/logs`, `/login.html` and `/nonce` all 302'd to `/`** — they are absent, not guarded; all five field refusals fired with their own messages (unknown template, short ssid, short Wi-Fi password, short admin password, short hostname); a good POST merged the template, and the account it created then logged in and read the document back (`id 1a2b`, `hostname horta`, relays 19/16/17/18, probes 36/34, `mqtt.backend thingsboard` with `/thingsboard.pem`). With `ESP_GARDEN_PIN_FAMILY=esp32s3` the dropdown carried **only `s3-carrier`** and `wroom32-v2` was refused by name. The page and the templates the mirror served are **extracted from `src/web_onboarding.cpp` and `include/core/onboarding_templates.h` rather than copied**, so what a browser rendered is the bytes the device would serve; the refusals are a second implementation, which is the point.

  Specifically unexercised, and specifically a judgement rather than a measurement: **`WiFi.softAP()`, WPA2 with a nine-character password, the `DNSServer` wildcard and whether any phone actually opens a sign-in sheet** — none of it has run, and the captive portal is the part with the most platform behaviour in it. **The 60 s probation wait** (`onboarding::kProbationMs`) is `g_bootWaitMaxMs` reused rather than a measured association time; nothing here has timed a DHCP lease on this hardware, and a router still booting after a power cut could exceed it — which on a marked board means one unnecessary portal. **`WiFi.status() == WL_CONNECTED` is taken as "associated with an IP"**; that is what the Arduino core documents and not something observed here. **The marker file has never been written to a real LittleFS partition**, so `markerWrite()`, its 4 KB block cost and the delete on the first successful association are arithmetic and reasoning. **No compiled template has been through `ConfigFile::loadFile()`** — `configDocumentIsUsable()` runs on the merged document at POST time and `test_onboarding` walks every declared pin through its family's rules, but the boot-time parse is a different code path, and all three templates ship `mqtt.username` EMPTY on purpose, so a freshly onboarded board reports `MQTT Link: down (rc=...)` until somebody pastes a token into `/config.html`. **`requestRestart(3000)`**: 3 s rather than `/control`'s 500 ms is a judgement about a client on an AP that is about to disappear, not a measurement of anything.

  **Two changes here touch a board that is NOT being onboarded, and both are behaviour changes to the live path.** `uploadPathIsProtected()` now refuses `/provisioned.pending` — untested on hardware, and unreachable unless somebody deliberately uploads that name. And `main.cpp` no longer passes `config.otaUser`/`config.otaPassword` into `UserStore::load()` when the config did not load; see [the correction below](web-interface.md).
- **The 60 s history archiver, and the fit that reads it** (`scripts/history_export.py` + `history_archive.py` + `history_store.py`, `moisture_fit.py --history-db`, 2026-09-16). **No C++ changed and nothing was flashed.** When this was written not one byte had been sent to the device; **the live run happened on 2026-09-17 and is the verified entry above** — what stays here is the part of it the mirror exercised and the device still has not. `pio test -e native` passes at 201 on the merged tree — unchanged BY THIS CHANGE, because nothing it covers moved; `moisture_fit.py --self-test` went **50 → 107 checks**; `check_lines.py` green, which is why `history_archive.py` was split at 1049 lines. What ran is `scripts/dev_server.py`, and **that is evidence about the simulator, not about the device** — the same distinction the session-persistence entries are worded for.
  - **Against the mirror, over HTTP:** a first run collected **1440 records in 8 pages / 12 requests / 272 KB**; a second immediately after collected **0 new and 200 already held**, which is the primary key doing its job on an ordinary run rather than only in a test; the whole chain (collect → SQLite → `--history-db`) ACCEPTED both probes of a seeded garden at **J = 8.83**; `--csv`, `--stats` and `--identity` answer.
  - **The eviction and gap classes were reproduced deliberately, and needed the mirror to be FIXED first.** `sim_state.py`'s history was a `deque` dropping ONE record per append while the device recycles a whole SEGMENT; its own comment called that "close enough for a frontend mock", and it was, until something had to page the endpoint. It now uses `history_archive.SegmentHistory`. With a 24-record buffer run past the archive, the collector reported `GAP: ... about 16 records were recycled before anything collected them`. With `--history-rotate-every 2` (fault injection, off by default) the walk gave up after 3 restarts, wrote **nothing**, and exited 1; at `--history-rotate-every 9` it restarted once and completed.
  - **A weak guard was caught by that fixture and replaced.** "Do consecutive pages share ANY record" passes a rotate-and-refill — `stored` lands back where it was while every index moved by a segment, and the shifted page overlaps its predecessor by 185 records instead of 5. The walk sailed on, collected a shorter range than the buffer held and reported no gap: the exact silent loss the tool exists to prevent. `_pages_abut()` now checks the EXACT overlap the two responses' own offsets imply, by timestamp.
  - **Specifically a judgement rather than a measurement:** `PAGE_OVERLAP` = 5 (a self-verification device, not a margin — a rotation is bigger than any page); `MAX_RESTARTS` = 3; `GAP_PERIODS` = 3; the recommended cadence's "six tolerated failures", which lands 6224 on 6.25 h against a **43.75 h guaranteed retention** that is itself arithmetic from `recordsPerSegment × 7 × period` and not a measured eviction; and `STEP_MIN_POINTS` scaling to 1.0 point at 60 s, which is arithmetic on the rate the 300 s number already asserted and **is not fitted to 60 s data, because none exists**.
  - **`SegmentHistory` is shared between the mirror and the archiver's own tests**, so a wrong belief about the device's rule would be invisible in both at once. That is taken deliberately and said out loud: `test_segment_index` is what pins the FIRMWARE's arithmetic; this is a second implementation in another language, read off `io_history.cpp` and `segment_index.h`.
  - **Unexercised even against the mirror:** `--history-db` has never met a real identity SEAM (no session has disagreed with another), no conflict row has been written outside `:memory:`, and `moisture_fit.py --push` remains never run.

- **Seven review fixes (firmware 2.13.1).** Six envs build, `pio test -e native` passes at **169 cases** (7 new here), `check_lines.py` green. **Nothing has run on the device**, which is on 2.11.1, and two of the seven change what a board does at boot. **The compiled pin defaults are now ONE per-family table** (`include/core/default_pins.h`) rather than a relay table beside six scalars: `6387c46` made the relay table per-family because *"a table from the wrong chip drives whatever else is on those numbers"* and did not carry that to `dhtPin`, `flowPin` and `floatPin`, which stayed at the WROOM-32's 23, 27 and 26 — **and on an S3, 27 and 26 are SPI_HD and SPI_CS1**, the octal flash/PSRAM bus, reached by `"flow": {"name": "Fluxo"}` alone, because `loadSensor()` only overwrites a pin when the entry carries a `"pin"` key. That hazard is REASONING about a netlist and a datasheet: no S3 exists, nothing has driven those pins, and nothing has confirmed what happens if something does. `luminosityPin`/`waterLevelPin` left the Arduino aliases `A3`/`A6` in the same change — an alias resolves per board VARIANT, which looks chip-relative and is not: on `esp32s3` `A3` is GPIO 4, this firmware's third probe, while the carrier's LDR is GPIO 6. **On a WROOM-32 every value is byte-identical to what shipped**, except that the probe table gains a fourth entry: both tables were three long against a `MOISTURE_MAX` of four, so slot 3 fell through to `A0` — GPIO 36 here and GPIO 1 on an S3, probe 0's own pin on both. It gains **GPIO 33**, the sixth ADC1 channel and the one `espgarden1` leaves free, reachable only by a config declaring a fourth probe with no pin, which no device here does — so **nothing has read that pin**; a `static_assert` makes raising `MOISTURE_MAX` a compile error until somebody names the pins. **The history fit check now runs on a FAILED config load**: `ioHistoryFitCapacity()` sat below `loadFile()`'s four early returns, so the constructor's 1440 reached `ioHistory.begin()` unchecked — exactly the state after a filesystem deploy that dropped `/config.json`, partition at its fullest and the one check against filling it skipped. The call moved up into `loadConfigFile()`; what is tested is the ARITHMETIC and not the move (1440 on a 130 KB-free partition is reduced to 1360), because no host test can reach `loadFile()`. **`IoHistoryFit::checked` was DROPPED rather than rendered** — set on one path, read nowhere, and the case it named (`totalBytes()` 0, request granted unchecked) cannot reach `/data.json` at all: a filesystem that will not answer its own size has no `/users.json`, so no session exists to serve the row to. It is still said in `ioHistoryFitCapacity()`'s own warning on the serial log, which is the only place anyone could read it in that state — an argument, not a measurement, since no mount has failed here. **`validateThingSpeakFields()`'s conflict check now runs with `USE_THINGSPEAK` off**: the `#if` returned above the `claims[]` loop, so the comment's claim that *"the check below survives the flag"* was false and a colliding `thingSpeak.moisture2Field` was never normalised to 0. Unreachable on any config in this repo, where the key is 0. Plus **`mqttSubscribe(long)` deleted** (no declaration, no callers) and **`pinMaxGpio()` hoisted out of `/capabilities.json`'s loop condition** (~49 out-of-line calls per request on `async_tcp`); neither changes an answer, and the endpoint has not been re-fetched from a board. **Measured on `espgarden2`, a clean A/B against `0c4d1b5` in a separate worktree: +836 B flash (1 256 533 → 1 257 369), −8 B static RAM (66 600 → 66 592)**; on `espgarden_s3` +864 and −8 (1 208 757 → 1 209 621; 65 472 → 65 464). Per object with `xtensa-esp32-elf-size`: `config.cpp.o` **+683**, mostly the `claims[]` table and its loop no longer being dead-code-eliminated behind that early return; `config_pins.cpp.o` **+315**, the new "declared with no pin" message; `io_history.cpp.o` −4 flash and −4 RAM; `web_capabilities.cpp.o` −6; `mqtt.cpp.o` **0**, because the deleted function was already inside `#if USE_THINGSPEAK`.
- **The whole `espgarden_s3` board** (firmware 2.13.0). Six envs build, `pio test -e native` passes at 161 cases (23 new), `check_lines.py` green, the LittleFS image builds at exactly its partition size. **No such board has been built, so not one line of this has executed on an ESP32-S3** — see [Hardware v3](hardware.md). What is and is not evidence:

  - **The S3 pin rules are host-tested against a table, and a table is not a chip.** `test_pin_rules` proves the predicates return what this repo believes; it cannot prove the belief. The belief comes from ESP-IDF headers and Espressif's documentation, named per rule, and the hardware repo agrees on both claims it makes — but **no ADC has been read on GPIO 1, no relay switched on GPIO 10, and `validatePins()` has never run on an S3.** **The WROOM-32 half of that suite is the real regression guard** and the one claim with teeth: a golden table over every `uint8_t` for all six predicates, so answers five shipped envs and one live garden depend on cannot move by a pin. It went green on the first run, which means it caught nothing — as intended.
  - **The relay safe-state inversion is REASONING about a schematic, not a measurement.** That the module's own pull-up holds IN high through a reset is read off `J200` and the vendor's documented 3.3 V configuration; nobody has put a scope on a relay coil through a boot. The firmware behaves identically either way, which is precisely why it was safe to leave `relayPinsSafeInit()` alone. **The default-pin-table hazard it replaces is likewise unobserved** — that the WROOM-32 table would drive `BTN_USER` into `SW150`'s short is read from the netlist; it has not happened, and now cannot.
  - **`pinMaxGpio()` fixes three bugs nothing has ever hit**: a literal `39` in `/capabilities.json`'s walk, in `documentPinsAreUsable()` and in the probe power-pin clamp is correct on every board that exists; on an S3 it hides GPIO 40-48, refuses them at save time and silently turns a valid power pin into `kNoPin`. All three are dead code on a WROOM-32 and untested on anything else.
  - **`partitions/esp_garden_8mb.csv` has never been written to a flash.** `mklittlefs` produced exactly 0x260000 bytes, which says the sizes are self-consistent and nothing about whether an S3 boots from it; the 2.75 MB slot and 2.375 MB filesystem are headroom, not measurements — the app would have fitted the 4 MB table. **`templates/config.espgarden_s3.json` has never been loaded by `ConfigFile::loadFile()`**: its `id` is the `1a2b` placeholder, the one field that bricks a board when wrong, and its `invert: true` / `kind: "resistive"` are carried over from 6224's measured probes rather than measured on these modules (`dry`/`wet` are 0, so no badge until somebody calibrates). **No filesystem image has been built from `templates/config.espgarden_s3.json` at all**, so the CI provisioning split's ACCEPT half is unexercised. Its REFUSAL half has run: `-t buildfs` used to pack the *existing* WROOM-32 `data/config.json` into an S3 image — relays on that carrier's `FLOW_PULSE`, `FLOAT_SW` and `BTN_USER`, probes on its flash and PSRAM bus — because the template was wired up only in CI, which is the one place a developer never runs. `config_guard()` in `scripts/pio_assets.py` refuses it now, verified 2026-09-04 on this tree: refused in **0.54 s naming ten foreign pins**, while `espgarden2 -t buildfs` still succeeded. What that does NOT say is that the template is right — nothing has loaded it, and the guard compares it against `data/config.json` rather than judging it.
  - **Two S3 platform behaviours are noted and unexercised.** `LED_BUILTIN` on the `esp32s3` variant is the RGB-LED encoding (`SOC_GPIO_PIN_COUNT + 48`), so the error blink drives an addressable LED through RMT rather than a plain GPIO — and the DevKitC-1 **v1.1** carries that LED on GPIO 38, not 48, so it may simply not light. And the S3's usable ADC range at 12 dB is **2900 mV** against the ESP32's ~3100, which the two-point calibration absorbs but which means a probe spanning the full 3.3 V rail saturates at the dry end; take the dry anchor below 2.9 V rather than in open air.

- **The I/O history fit check** (firmware 2.12.1). *(The ceiling in this entry is superseded: 2.20.0 raised it to **10000**, and every "5000" below describes what was written and measured at 2.12.1. The fit check itself is unchanged.)* `history.records` topped out at **5000** and a runtime check clamps it to what the partition can hold. Host-tested in `test_segment_index` (11 new cases, 138 total pass), built in all five envs, mirrored in `scripts/sim_state.py`. **Nothing here has run on the device**, which is on 2.11.1 — and the interesting half cannot run there, because 6224's configured 1440 fits and the clamp never fires. Specifically unexercised, and specifically a judgement rather than a measurement: **the reserve `max(64 KB, partition/8)`**, where on this 512 KB partition both terms are 64 KB so the "larger of" has never chosen, and the floor is arithmetic over three named consumers rather than a measurement of any of them — **no board has been run down to the reserve**, so nothing says 64 KB is enough or too much; **`segment::kBlockBytes` = 4096**, a constant because LittleFS's erase block is reported by no public API, and it decides whether 5000 records is 235 KB of data or **256 KB** of blocks — that it cannot be under a 4 KB sector is reasoning about the part, not a number read off this chip; **`ioHistoryBytesOnDisk()`**, never called on a device, so ~60 KB for 6224's 1298 records is arithmetic (7 × 8652 + 1836) and not a directory listing, deliberately under-crediting the history by its own block slack; **the clamp itself**, never true outside a test — the `Status.History` row, the boot log and the "holding between 2982 and 3408" warning have been rendered by the simulator and nothing else, and while a configured 5000 resolves on 6224's numbers (344/512 KB, 1298 stored) to **3408 records, 160 KB, leaving 68 KB free**, those inputs were read off `/data.json` by hand and the device has never computed it; **`totalBytes() == 0` granting the request unchanged**, since no mount has failed; and **the clamp is not applied at SAVE time**, deliberately — `POST /config.json` still accepts 5000 and writes it, because the stored document is the operator's intent and freeing space should be all it takes to get the records back, at the cost of the refusal only being visible after a reboot.

- **The whole ThingSpeak/TalkBack removal** (firmware 2.12.0, 2026-09-04). `USE_THINGSPEAK` added at 0, `USE_TALKBACK` moved 1 → 0 and honoured for the first time. Builds in all five envs with the flags off AND in `espgarden2` with both back on; `pio test -e native` and `check_lines.py` green. **Nothing has run on the device, which is on 2.11.1.** Measured on `espgarden2`, both flags off against the pre-change build: **-4 832 B flash (1 257 017 → 1 252 185) and -236 B static RAM (66 804 → 66 568)**. Specifically unexercised: **the backend-mismatch refusal, which is the whole point of the change** — no board has booted with `mqtt.backend: "thingspeak"` against a `USE_THINGSPEAK 0` image, so the FATAL in `mqttSetup()` has never printed, `mqttLoop()`'s early return has never been taken, `telemetryPublish()` has never declined to queue, and no browser has seen `MQTT Link: unsupported backend`; the live device sets `"thingsboard"` explicitly, so on 6224 every one of those paths is dead code, which is exactly why the refusal is worth having and exactly why it is unproven. **That the ThingsBoard path is byte-for-byte what it was** is structural argument — `mqttIsThingsBoard()` unchanged, every `#if` bracketing a ThingSpeak-only statement — not a payload diffed against the broker. **`/data.json` without `Channel`**, and `index.js` hiding the link rather than leaving a dead `href="#"`, have been rendered by no browser; `sim_state.py` mirrors it behind its own `USE_THINGSPEAK = False`, and **that is evidence about the simulator, not about the firmware**, the same distinction the session entries are worded for. **`validateThingSpeakFields()`'s new warning** fires only when `thingSpeak.moisture2Field` is non-zero, which it is not here, so the branch is unreachable on any config in this repo. **A flags-ON image has been BUILT and never RUN** — `espgarden2` compiles at 1 257 277 B with both on, 260 B above the pre-change baseline, which is the refusal machinery present in both positions; nothing says the restored ThingSpeak path still publishes, and the last accepted ThingSpeak publish was 2026-08-23. **Deliberately a judgement rather than a measurement:** that refusing to publish is safer than refusing the config, resting on this file's own record that a rejected document means compiled defaults and an unreachable board, plus the COMPILED default of `mqtt.backend` still being `"thingspeak"` — so a load-time refusal would brick any device whose document omits the key. No device was made to demonstrate that.

- **That the publish path's allocations do not fragment anything** (2026-09-04). The counts and bytes in [The `String` churn](sensors.md) are a HOST measurement of a replay, and they are the only half that can be measured from here: largest-free-block exists on the device, which this session may not touch. The verdict — don't do the work — rests on a 0.9 % byte share and on a path that is 0.06 % of the io task's churn, both measured; the further claim that three 16-byte blocks allocated and freed inside one function on one task cost no fragmentation is REASONING, not a number. **No code changed, so there is nothing here to flash or to regress.**
- **Four review findings, fixed (firmware 2.11.2). Nothing here has run on the device**, which is still on 2.11.1 — and two of the four are running there right now.

  - **The role overwrite through the config door.** `handleConfigPost` now calls `UserStore::setPassword()`; host-tested only in the sense that nothing tests `UserStore` at all — it reaches LittleFS and mbedtls. What was executed is the MIRROR: `sim_config.config_apply` on an admin called `garden` and an operator called `helper`, where the operator's role survived a password write and an unknown name was created ADMIN. **That is evidence about `scripts/sim_config.py`, not about the C++**, exactly as the 2.11.0 entry above had to be corrected for claiming otherwise. Specifically unexercised on hardware: `setPassword()` returning false and the create branch logging `had no account; created it as ADMIN`.
  - **The blocking flash write on the authorization path.** The purge marks and `ioTaskHandler` writes. `test_session_slots` gained 8 cases (127 total pass) covering the purge verdict and the queue's supersede/clear behaviour — **but the queue is arithmetic, and what has never been observed is the deferral itself**: no request has been served on the board without a `savePersistentSessions()` behind it, and the io task has never actually written the file. It fires only on a 30-day expiry or the one-off stamping of a 2.11.0 entry, so it may be **months before it runs even once**, and it will run silently when it does. The reordered slot fill in `handleLogin()` is likewise unobserved: single-threaded behaviour is identical, which is precisely why nothing on the board can confirm it.
  - **The restart notice on `/config.js`'s reauth path.** Rendered by no browser yet. The dwell before the redirect went 2500 → 5000 ms, which is a judgement about reading speed and not a measurement.
  - **The three simulator drifts.** `sim_auth.py` rewrites `/sessions.json` per token, `_purge_locked()` saves, and credentials are per account. Verified in process against the mirror: dropping one of five remembered tokens now rewrites the file (**the old code left all five, with the expired one still on flash — the mirror could not reproduce the resurrection class of bug it exists to catch, and now can**), the seventh remembered device forgets the first on flash, and a `?secrets=1` restore on a non-`admin` admin answers `reauth:false` where it used to invalidate. Live over HTTP on the simulator: login → `GET ?secrets=1` → unchanged POST (`reauth:false`) → changed POST (`reauth:true`) → the caller's token 401s. **`AuthSim` still does not idle out ordinary sessions at 24 h the way the firmware does** — a fourth drift, left alone as out of scope and recorded here rather than fixed quietly.
- **Several sessions per user, the bounds that had to replace the old one, and the revocation that had to come with it** (firmware 2.11.0, corrected in 2.11.1). Host-tested in `test_session_slots` (17 cases), built in all five envs. **Nothing here has run on the device.**

  **A correction to this file's own claim, which is why the rest of this entry is worded carefully.** The 2.11.0 entry said the behaviour was *"verified end to end against `scripts/dev_server.py`"*. That was **false for the half that mattered**: the simulator's `/login` did not read the `remember` parameter at all, `AuthSim` had no persistent flag, no session file and no restore path, so **the persistence half was never executed anywhere** — and a code review found two token-resurrection bugs living in exactly the code that claim covered. The claim was the reason they stayed invisible. What had actually run in 2.11.0 was four concurrent tokens over HTTP, and nothing about `remember=true`.

  The simulator now implements the whole contract — `remember`, the cap, tiered eviction, a `/sessions.json` equivalent under `.pio/`, the TTL — and seven reboot and eviction properties were executed against it in process (a remembered token surviving a reboot; forty plain logins evicting no remembered device; the seventh remembered device forgetting the first and it staying dead across a reboot; a 20-entry file pruned to 6 on load; a token past the TTL dropped; a revoked remembered token staying revoked). **That is evidence about `scripts/sim_auth.py`, not about the firmware** — the two are separate implementations, which is the entire point of keeping the mirror, and a green mirror has never been a statement about the C++. Specifically untested on hardware:

  - **`kMaxSessions` = 8 and `kMaxPersistentSessions` = 6 on the real chip.** The RAM figure is a build number (`espgarden2`, 66 412 → 66 796 static), not a measurement of the device holding eight live sessions.
  - **Every `/sessions.json` path.** The file has never been written with more than one entry on the device, so the `"c"` timestamp, the load-time prune, the restore cap and the rewrite-on-eviction have run only in the mirror. A 2.11.0 file carries no `"c"`; those entries load and are stamped at the first purge with a synced clock, which has also never happened on a board.
  - **The 30-day persistent TTL.** It cannot be exercised in under 30 days by definition, and its wall-clock anchor depends on NTP having answered before a remembered login — `customLogin.begin()` runs in `webSetup()`, step 8, *before* the NTP wait in step 9, so a session created while the clock is down stores 0 and is stamped later.
  - **`invalidateUserSessions()` on the board.** Neither password door has been walked on hardware; the warning it logs has never printed there.
  - **The unchanged-password check on a real restore.** `GET ?secrets=1` → POST against 6224 has not been repeated since 2.11.1.
  - **The two pages signing themselves out.** No browser has been redirected to the login page by a device response.
- **The two thermal admission gates** (`scripts/moisture_thermal.py`, 2026-09-04). Host-tested in `moisture_fit.py --self-test` (50 checks, up from 24) and run end to end against the whole archive, where **31 windows produced 2 coefficients and neither is usable** — see [Temperature IS a plausible confound](soil-moisture.md). **No C++ changed and no gate has ever fired on real data**: `anchor_thermal_refusal()` is unreachable today because no probe reaches a proposed anchor at all, and `class_thermal_refusal()` because both probes have **zero** watering events on their own pump. Both are therefore exercised only by synthetic series, and the synthetic ones are the *easy* cases — a 15 K gap and a pump that runs at the hottest hour, not the 3-5 K edge where the threshold actually decides. Specifically a judgement rather than a measurement: **`WORST_CASE_SENSITIVITY` = 0.2 points/K**, an upper bound from the fact that no in-soil window in this archive exceeds it — it is not a fitted coefficient and there is none; **`MAX_THERMAL_SHARE` = 0.10**, arithmetic about a 20.4-point span and its 6.8-point thirds, not a measurement of what a badge can absorb; and **`COLLINEARITY_MAX_R2` = 0.90**, the textbook VIF-10 rule of thumb, **borrowed and labelled as borrowed** rather than fitted, because a threshold tuned on this archive would be a threshold chosen to produce this archive's answer. The **placebo** null is the check the verdict rests on and it runs on **4-8 shifts** here, so it is quoted as a rank and never as a p-value. `MIN_NIGHT_HOURS` = 6 and the `--self-test`'s eleven synthetic days are both conveniences of the fixture, not properties of the garden.
- **The PC-side drying fit's ACCEPT path** (`scripts/drying_fit.py`, 2026-09-04). The tool has run end to end against the real archive and every branch it took was a REFUSAL, which is the outcome the data supports and is recorded as a result rather than a failure — see [Drying IS a decay](soil-moisture.md). No segment has ever produced a proposed dry anchor, so the acceptance path is exercised only by `--self-test`'s synthetic curves — **19 refusals now, across two archives and a pot that genuinely dried out**. **The PROFILE GATE is no longer in that list: it was reached on real data on 2026-09-21** and its refusal is in the verified section above, so what remains unexercised here is the ACCEPT branch and nothing else. It was unreached for a long time — every segment refused by `model`, `uninformative` or `degenerate` first — which is how two bugs in the profile survived a full archive run with the verdict still correct; see [The gate that decided nothing](soil-moisture.md). **`falsified_by_later()` has also now returned a hit on real data** (Zona 2 (Espada), 0.87 points below its own single-exponential asymptote 4.3 h later with no watering between) and the report printed `FALSIFIED`, where this entry recorded it as never having fired. **Precisely: the FUNCTION fired and the line printed; the `falsified` REFUSAL in `judge()` still has not decided a segment**, because it sits below the profile and stability gates and that segment was refused by `model` three gates earlier. Specifically unexercised, and specifically a judgement rather than a measurement: **`HANDLING_SETTLE_SEC` = 2 h**, which DECIDES THE ANSWER and is therefore a `--settle-hours` flag rather than a constant — at 2 h the two longest segments are won on held-out error by `linear`, at 0 by `exp + linear` with tau 1.87 and 1.93 h, so the exponential everybody can see in the trace lives largely inside the window a just-handled probe is not to be trusted in (re-confirmed 2026-09-04: at 0 the two longest are won by `exp + linear` at tau 1.87 and 1.93 h); the archive cannot settle it, because the last handled probe was still falling 0.3 points per five minutes 105 minutes after the final step and then the archive ends, so two hours is the observed minimum and not a measured settling time. **`ASYMPTOTE_MIN_EXTRAPOLATION` = 2.0 points** is arithmetic about the 20.4-point two-point span and its 6.8-point thirds, not a measurement of what a badge can absorb. **The falsification check has NEVER fired** — zero segments in both the eight- and the ten-segment runs, re-checked 2026-09-04. *(An earlier version of this line said it fired once at 0.29 points. That 0.29 is segment [3]'s `uninformative` margin, a different gate; the two were conflated.)* The decisive case is one the tool conservatively declines to call: segment [7] fits an asymptote of 78.65 and the same probe's next segment STARTS at 77.66, but a 2.4-point transient sits between them and any 2-point rise is treated as a wetting. **`--stitch-seam` rests on `tb_export.SEAM_MS`**, not on a measurement of identity; the join is at least continuous, +0.08 points across 76 s.
- **The whole evapotranspiration model** (firmware 2.10.0). Host-tested, built in all five envs, **shipped OFF** (`et0.enabled` false): no day has closed on the device, no `et0` key has reached ThingsBoard, `Status.ET0` has never rendered. It ships off for a stronger reason than the cloud model — validated against a public station it **had no demonstrated skill on this device**; see [Evapotranspiration](evapotranspiration.md). Specifically untested: the day rollover against the real clock (`localtime_r`, `tm_year * 366 + tm_yday`, host-tested on synthetic keys only); the 22-of-24-hour coverage refusal in the field; any `et0.scale` other than 1.0, so its warning has never printed; and `publishEt0Event()` itself, so the four keys have never been seen in a payload.
- **The whole cloud-cover model** (firmware 2.9.0). Fitted on the archive, host-tested, built in all five envs, **shipped OFF** (`cloud.enabled` false). Not one minute of it has run on the device — no clear-sky lookup against the real clock, no state, no episode. Specifically untested: that the device's minute mean matches the archive's (the argument is structural, not a measurement); the local clock path, where a whole-bin error at the morning ramp is eight points of reference; every class boundary, fitted to six days of one sensor and never confirmed against a sky somebody looked at; the episode rate in the field; and `cloudVariability`/`cloudState` in a real payload. **The standing warning is the reason for the default:** the compiled clear-sky table describes ONE sensor at ONE mounting in ONE season, the archive already contains a mounting change six days before the fit, and **nothing on the device can detect the next one**.
- **The `Sd` error bars** (firmware 2.9.1). Six extra keys per publish, one per continuous channel, from a variance the accumulator already maintained. Never published from the device, so neither the values nor the datapoint cost has been observed — the cost is arithmetic from the measured 288 ticks/day.
- **`relayStop` on the device** (firmware 2.8.1). The contract is verified against the simulator and `index.js` parses, but the firmware's own `stopRelay()` path has never been reached from `/control`. Exercising it means energising a real pump.
- **The parts of firmware 2.8.0 that have NOT run.** The periodic path, the heartbeat, the twins and the accumulator re-sizing are verified above. These are not:
  - **A relay transition through `tbPublishEvent()`.** No relay has been switched since the flash, so the change-driven half of step publishing — the whole reason it is asynchronous — has never fired. The heartbeat has; they are different code paths.
  - **The deadbands.** `flowRate` 0.05, `flowTotalLitres` 0.005, `dhtErrorRate` 0.5 are host-tested as arithmetic only; `dhtErrorRate` has published on the heartbeat alone, at a constant 0.
  - **`moistureNFault`.** Both probes read healthy, so neither the key nor the single publish when a fault CLEARS has been seen.
  - **The DHT plausibility gate.** No out-of-range reading has been rejected on hardware, and the gate has been **corrected twice over**. Both original justifications were wrong: the 45.04 °C reading is INSIDE the rated 0-50 °C band and was never going to be rejected, and the 15.1 % RH reading it *would* have rejected is **real** — this garden is in Brasília, where the dry season takes the afternoon below 20 % routinely (261 archive points, 2.0 %, minimum 15.00). The floor is now 5 %, low enough to catch only garbage. **A datasheet's rated range describes ACCURACY, not what the sensor can physically report**, and clamping to it discards the true extremes, which on a garden controller are the readings that matter most. *(Refined later, decision unmoved: of those 261 points **243 are ambient and 18 are not** — the 18 fall inside a 38-minute patch of direct sun on 2026-09-03 whose dewpoint collapses and recovers, so they measure a cooked sensor. The 15.00 minimum is on 09-01 and is real.)*
  - **The dropped bare `relay` key.** Nothing here is known to read it, but no consumer was checked.
- **The PC-side moisture fit's ACCEPT path** (`scripts/moisture_fit.py`, 2026-09-03). The tool has run end to end against the real archive and the live device's `GET /config.json`, and every branch it took was a REFUSAL — the outcome the data supports, recorded as a result and not a failure. No real probe has ever produced a proposed `dry`/`wet` pair; the acceptance path is exercised only by `--self-test`'s synthetic garden. Also unexercised: **`--push`** (written, off by default, never run — no byte has ever been WRITTEN to the garden by this tool, at any address; the 2026-09-17 collection was GETs only); the **`WET_ANCHOR_MAX_LAG_SEC` = 2 h** window, which is arithmetic about two thresholds rather than a measurement of a real pot; and **`DRIFT_MIN_CHANGE` = 1.0 point / 30 min**, which has margin on both sides but has only been tested against a spring week.
- **Per-probe polarity and probe power gating** (firmware 2.7.0). The config keys parse, the five envs build, and the save/load round trip is verified against the simulator — but **no probe has yet been read with `invert` false, and no `powerPin` has ever been driven.** Specifically untested is the settle time: 10 ms is a default chosen from how a divider and an LM393 behave, not from a measurement.
- **The history boot-loop interlock.** The RTC strike counter compiles and ships and the path that clears it after ten minutes has run — but no panic has been counted against it, so the refusal itself has never fired. It exists because the board is now reachable only over the air, where a writer that panics before the web server answers is unrecoverable.
- **ThingsBoard FOTA.** No package has ever been assigned. The chunk stream, the MD5 verification, the relay-idle deferral and the 409 interlock against the browser path are all unexercised.
- **The absorption time constant, on real soil.** `moistureTimeConstant()` is covered by six host tests against synthetic first-order rises and the estimator, fold and confidence feedback all ship. What has never happened is a watering whose following 30 minutes are in the history buffer when training runs — the one watering on record was a manual relay test, and the history was reformatted by the migration anyway. Until a real cycle completes every probe reports `tau` 0 and the 5-minute linear ramp is what runs.
- **The reservoir interlock.** `floatInterlock` is off, and the float switch is not wired.
- **The flow meter.** Not wired. `flowPulsesPerLitre` is a datasheet number, not a measured one.
- **Scheduled watering.** Four schedules exist, all disabled. None has fired.

**Measured, and contradicting something this file used to say:**

- A **disconnected** probe on GPIO 32 does not sit at a rail, and does not sit anywhere in particular. Two readings hours apart in one session: **52.6 (variance 0.01)** and **86.7** — quiet at any instant and free to be somewhere else later, which is worse than a rail because each sample looks like plausible soil. *(An earlier version reported only the 52.6 as characteristic; withdrawn, as was the "~94 here" it replaced. One sample of a floating input describes that minute.)* The consequence gets stronger: 3σ outlier rejection fires on none of these, so what rejects a disconnected probe is the SEPARATION gate — a floating pin does not respond to its pump, so dry, humid and wet collapse onto one number and J goes to 0.
