andrenepomuceno/esp_garden/src/main.cpp

#include "core/filesystem.h"
#include "BuildConfig.h"
#include "core/config.h"
#include "core/io_history.h"
#include "core/moisture_model.h"
#include "core/logger.h"
#include "core/tasks.h"
#include "core/user_store.h"
#include "network/web.h"
#include "network/web_onboarding.h"
#include <Arduino.h>
#include <esp_system.h>

// esp_reset_reason() returns an enum; the names are worth spelling out because
// the number alone sends the reader to a header. Not static: the ThingsBoard
// connect publishes it too, so the cloud gets a timeline of reboots rather than
// a line in an 8 KB log that rotates.
const char*
resetReasonName()
{
    switch (esp_reset_reason()) {
        case ESP_RST_POWERON:  return "power-on";
        case ESP_RST_EXT:      return "external reset pin";
        case ESP_RST_SW:       return "software (ESP.restart)";
        case ESP_RST_PANIC:    return "PANIC or exception";
        case ESP_RST_INT_WDT:  return "interrupt watchdog";
        case ESP_RST_TASK_WDT: return "task watchdog";
        case ESP_RST_WDT:      return "other watchdog";
        case ESP_RST_DEEPSLEEP:return "deep sleep wake";
        case ESP_RST_BROWNOUT: return "BROWNOUT (supply dipped)";
        case ESP_RST_SDIO:     return "SDIO";
        default:               return "unknown";
    }
}

// RTC slow memory: NOINIT so it survives a panic reset, which is exactly the
// event being counted. It does NOT survive a power cut, and that is the right
// behaviour — someone who pulls the plug and puts it back is entitled to a
// fresh attempt.
RTC_NOINIT_ATTR static uint32_t g_historyGuardMagic;
RTC_NOINIT_ATTR static uint32_t g_historyGuardStrikes;

static const uint32_t kHistoryGuardMagic = 0x48475244UL; // "HGRD"
static const uint32_t kHistoryGuardLimit = 3;

bool
historyGuardTripped()
{
    return g_historyGuardStrikes >= kHistoryGuardLimit;
}

void
historyGuardClear()
{
    g_historyGuardStrikes = 0;
}

// Counts this boot against the guard if the last one ended badly. Called once,
// before anything opens the history.
static void
historyGuardBoot()
{
    if (g_historyGuardMagic != kHistoryGuardMagic) {
        // Uninitialised RTC memory is whatever the RAM powered up as.
        g_historyGuardMagic = kHistoryGuardMagic;
        g_historyGuardStrikes = 0;
        return;
    }

    switch (esp_reset_reason()) {
        case ESP_RST_PANIC:
        case ESP_RST_INT_WDT:
        case ESP_RST_TASK_WDT:
        case ESP_RST_WDT:
            ++g_historyGuardStrikes;
            break;
        default:
            // A clean restart, a power cut or a brownout says nothing about
            // the history writer, so the count is left alone rather than
            // cleared: a panic loop punctuated by a brownout is still a panic
            // loop.
            break;
    }
}

void
setup(void)
{
    bool error = false;

    // First statement on purpose. Until a pin is driven it floats, and an
    // active-low relay board reads that as "energise" — everything below
    // (SPIFFS mount, config load, WiFi association) takes seconds, which is
    // long enough to run a pump dry. Uses the compiled defaults; loadConfigFile
    // parks the pins again once the real assignment is known.
    relayPinsSafeInit();

    pinMode(LED_BUILTIN, OUTPUT);
    digitalWrite(LED_BUILTIN, 0);

    logger.info("");
    logger.info("Initializing ESP Garden " FW_VERSION "...");

    digitalWrite(LED_BUILTIN, 1);

    // Why the last boot happened. A panic, a watchdog and a power cut are
    // three completely different investigations, and without this line all
    // three look identical: "it restarted".
    logger.info(String("Reset reason: ") + resetReasonName());
    logger.info("Free heap at boot: " + String(ESP.getFreeHeap() / 1024) + " KB");

    unsigned id = ESP.getEfuseMac() % 0x10000;
    logger.info("ID: " + String(id, 16));

    // Mount without formatting FIRST, so that a partition which fails to mount
    // is named before it is erased.
    //
    // begin(true) formats on failure, and that is the recovery path for a
    // factory-blank partition — but it is also what happens on the first boot
    // of a LittleFS firmware flashed over the air onto a board whose partition
    // is still SPIFFS. The mount fails, the partition is formatted, and
    // /config.json goes with it: the device comes up on compiled defaults it
    // cannot associate with, has no users, and is unreachable without USB. The
    // hazard is documented in core/filesystem.h; this at least makes the boot
    // that caused it say so, which is the one thing someone recovering over
    // serial actually needs.
    if (!FILESYSTEM.begin(false)) {
        logger.error("FILESYSTEM did not mount. If this firmware was just "
                     "updated over the air onto a board that still had a "
                     "SPIFFS partition, the next line ERASES it — including "
                     "/config.json and every credential. Recover by flashing "
                     "the filesystem image over USB.");
        if (!FILESYSTEM.begin(true)) {
            logger.error("Failed to initialize FILESYSTEM.");
            error = true;
        } else {
            logger.error("FILESYSTEM was reformatted; stored files are gone.");
            error = true;
        }
    }

    const bool configLoaded = loadConfigFile(id);
    if (!configLoaded) {
        error = true;
    }

#if USE_CUSTOM_LOGIN
    // Seeded from the legacy ota.{username,password} pair on first boot, so a
    // device that already had a config gets an account without any password
    // being compiled into the firmware.
    //
    // NOTHING is seeded when the config did not load, and that is a fix rather
    // than a precaution. loadFile() returns false without clearing what it
    // parsed, so otaUser/otaPassword are then whatever the CONSTRUCTOR set:
    // "admin"/"password". On a board with no /users.json — the same filesystem
    // wipe that loses /config.json — this migrated a compiled default pair into
    // a real ADMIN account, which contradicts the claim that no default
    // password is compiled into this firmware. It mattered little while such a
    // device was simply unreachable; it matters now that the same device raises
    // a setup AP with a published password.
    const bool haveCredentials = configLoaded && !config.otaUser.isEmpty();
    if (!userStore.load(FILESYSTEM,
                        haveCredentials ? config.otaUser : String(),
                        haveCredentials ? config.otaPassword : String())) {
        error = true;
    }
#endif

    // Set before tasksSetup(): that call blocks until the device has internet
    // and a valid clock, which never happens when the config failed to load and
    // the compiled WiFi defaults cannot associate. Assigning it afterwards left
    // the only failure indicator unreachable in exactly the case it exists for.
    g_ledBlinkEnabled = error;

    // After the config load so the capacity is the configured one, and before
    // webSetup() so /history.json never sees a half-open buffer.
    historyGuardBoot();
    if (historyGuardTripped()) {
        // Deliberately NOT a config change: the device stays reachable, the
        // configured capacity is left alone, and the next clean power cycle
        // gives it another go. What must not happen is a third panic turning
        // into a fourth on a board nobody can reach.
        logger.error("io_history: DISABLED after three consecutive panic "
                     "reboots. The last boots ended in a panic or a watchdog, "
                     "and the history writer is the most likely cause. "
                     "history.records is unchanged; power-cycle to retry.");
        error = true;
    } else {
        ioHistory.begin((uint16_t)config.historyRecords);
    }

    // After the config load, because it reports per configured probe, and
    // before webSetup() so /moisture.json never answers from a zeroed model
    // that has not been read off flash yet.
    moistureModelSetup();

    logger.backupSetup();
    webSetup(configLoaded);

    // A board serving the setup portal is a board that needs attention, and the
    // blink is the only thing that says so where there is no network to ask.
    // Arm 1 already lit it through `error`; arm 2 did not, because there the
    // config loaded perfectly and only the credentials in it are wrong. Still
    // before tasksSetup(), which is what the ordering rule is about.
    if (onboardingActive()) {
        g_ledBlinkEnabled = true;
    }

    tasksSetup();

    digitalWrite(LED_BUILTIN, 0);
}

void
loop(void)
{
    tasksLoop();
}
