andrenepomuceno/esp_garden/src/sensors.cpp

#include "core/probe_health.h"
#include "core/sensors.h"
#include "BuildConfig.h"
#include "core/config.h"
#include "core/logger.h"
#include "core/moisture_model.h"
#include "core/probe_power.h"
#include "core/sht4x.h"
#include "core/tasks.h"
#include <new>
#include <string.h>
#include <Adafruit_Sensor.h>
#include <DHT.h>
#include <DHT_U.h>

#define ADC_TO_PERCENT(x) ((x * 100.0) / 4095.0)

// Constructed in tasksSetup(), not at static-init time: DHT_Unified copies the
// pin in its constructor, and at static-init config.json has not been read yet,
// so a file-scope instance permanently runs on the compiled default pin.
alignas(DHT_Unified) static uint8_t g_dhtStorage[sizeof(DHT_Unified)];
static DHT_Unified* g_dht = nullptr;
AccumulatorV2 g_temperature(g_mqttTaskPeriod / g_ambientTaskPeriod);
AccumulatorV2 g_airHumidity(g_mqttTaskPeriod / g_ambientTaskPeriod);
unsigned g_ambientReadErrors = 0;
unsigned g_ambientTotalReads = 0;

AccumulatorV2 g_soilMoisture[MOISTURE_MAX];

// core/probe_power.h answers every question about a power pin that several
// probes share, and it is free of Arduino so a host test can reach it — so it
// cannot read a ConfigFile. This is the copy it reads instead, taken once in
// sensorsSetup(). Nothing re-reads config.json at runtime (a config change
// carries restartRequired for exactly that reason), so a snapshot cannot go
// stale; taking it per tick would rebuild the same four entries at 1 Hz.
static probe_power::Probe g_probePower[MOISTURE_MAX];

// The header spells kNoPin itself rather than including config.h, which would
// drag Arduino in behind it. This is what keeps the two honest.
static_assert(probe_power::kNoPin == ConfigFile::kNoPin,
              "probe_power::kNoPin must match ConfigFile::kNoPin");

static void
probePowerSnapshot()
{
    for (unsigned i = 0; i < MOISTURE_MAX; ++i) {
        const bool fitted = (i < config.moistureCount);
        g_probePower[i].powerPin =
          fitted ? config.soilMoisturePowerPin[i] : probe_power::kNoPin;
        g_probePower[i].settleMs = fitted ? config.soilMoistureSettleMs[i] : 0;
        g_probePower[i].always =
          fitted ? config.soilMoisturePowerAlways[i] : false;
    }
}

AccumulatorV2 g_luminosity(g_mqttTaskPeriod / g_ioTaskPeriod);

#define ADC_TO_WATER_LEVEL(v) (9.0 - 12.0 * sin(4.04 - 1.61 * (3.3 * v / 4095.0)))
AccumulatorV2 g_waterLevel(g_mqttTaskPeriod / g_ioTaskPeriod);

// The ISR does nothing but count. Everything else — rate, totals, logging —
// happens in the io task, because an ISR that allocates or takes a lock is how
// an ESP32 ends up in a reset loop.
static volatile uint32_t g_flowPulses = 0;
static portMUX_TYPE g_flowMux = portMUX_INITIALIZER_UNLOCKED;

static void IRAM_ATTR
flowPulseISR()
{
    portENTER_CRITICAL_ISR(&g_flowMux);
    ++g_flowPulses;
    portEXIT_CRITICAL_ISR(&g_flowMux);
}

AccumulatorV2 g_flowRate(g_mqttTaskPeriod / g_ioTaskPeriod);
// Cumulative volume since boot, in litres. Not an accumulator: a running total
// has no window.
static double g_flowTotalLitres = 0.0;

// A contact, not a level: one bit, debounced by requiring two agreeing reads.
static bool g_floatRaised = false;

// Published by the io task, read by anyone. A spinlock rather than a mutex
// because both sides are microseconds and one of them is a request handler.
static portMUX_TYPE g_moistureSnapshotMux = portMUX_INITIALIZER_UNLOCKED;
static MoistureReading g_moistureSnapshot[MOISTURE_MAX] = {};

static ProbeHealth g_probeHealth[MOISTURE_MAX];
static ProbeHealthReport g_probeHealthSnapshot[MOISTURE_MAX] = {};

static probe_sampling::Window g_moistureWindow[MOISTURE_MAX];
static MoistureCapture g_moistureCaptureSnapshot[MOISTURE_MAX] = {};
static MoistureTiming g_moistureTiming = {};
static MoistureTiming g_moistureTimingSnapshot = {};

// Enough readings to regress on before a verdict, and how the evidence ages.
// At the 1 Hz io task a window of 600 with a half-life every 600 keeps roughly
// twenty minutes of it in hand: long enough to be sure, short enough that a
// probe plugged back in clears its own accusation while somebody is still
// standing at the pot.
static const uint32_t g_probeHealthMinSamples = 120;
static const uint32_t g_probeHealthWindow = 600;
static const double g_probeHealthDecay = 0.5;

// Sample-to-sample spread, in ADC counts, above which this stops being soil.
//
// Both sides are measured on this board, and the margin is narrower than the
// first reading of it suggested. A connected channel is not always quiet: the
// luminosity input sits at 6 counts at midday but reached 164 while the light
// was actually changing. The three unplugged probes hold 1113-1773.
//
//   worst CONNECTED observed     164 counts
//   threshold                    400 counts   (2.4x above, 2.8x below)
//   lowest FLOATING observed    1113 counts
//
// 400 is close to the geometric mean of those two extremes (428), which is
// where a one-sided threshold belongs when both sides are known. Soil moisture
// cannot change like sunset light, so the real headroom for a probe is larger
// than the luminosity figure implies — but the figure is what was measured,
// and it is the one quoted.
static const double g_probeHealthMaxSd = 400.0;

ProbeHealthReport
probeHealthReport(unsigned index)
{
    ProbeHealthReport out = { 0, 0.0f, 0 };
    if (index >= MOISTURE_MAX) {
        return out;
    }
    portENTER_CRITICAL(&g_moistureSnapshotMux);
    out = g_probeHealthSnapshot[index];
    portEXIT_CRITICAL(&g_moistureSnapshotMux);
    return out;
}

uint16_t
sensorsMoistureSettleMs()
{
    return probe_power::settleMsForTick(g_probePower, config.moistureCount);
}

MoistureCapture
moistureCapture(unsigned index)
{
    MoistureCapture out = {};
    if (index >= MOISTURE_MAX) {
        return out;
    }
    portENTER_CRITICAL(&g_moistureSnapshotMux);
    out = g_moistureCaptureSnapshot[index];
    portEXIT_CRITICAL(&g_moistureSnapshotMux);
    return out;
}

MoistureTiming
moistureTiming()
{
    portENTER_CRITICAL(&g_moistureSnapshotMux);
    const MoistureTiming out = g_moistureTimingSnapshot;
    portEXIT_CRITICAL(&g_moistureSnapshotMux);
    return out;
}

MoistureReading
moistureReading(unsigned index)
{
    MoistureReading out = { 0.0f, 0 };
    if (index >= MOISTURE_MAX) {
        return out;
    }
    portENTER_CRITICAL(&g_moistureSnapshotMux);
    out = g_moistureSnapshot[index];
    portEXIT_CRITICAL(&g_moistureSnapshotMux);
    return out;
}

String
moistureState(unsigned index)
{
    // Past the fitted count is a probe that does not exist, not one that is
    // merely uncalibrated — both return "", but for different reasons.
    if (index >= config.moistureCount) {
        return String();
    }

    // The trained model first, the two-point calibration second, nothing
    // third. Deliberately in that order: the model is built from this probe's
    // own watering history and knows the spread of each band, where the
    // two-point anchors know only two readings and split the span in equal
    // thirds. When the model has not earned its gates yet, the anchors are
    // still better than a guess.
    // The snapshot, not the accumulator: this is called from the /moisture.json
    // handler on async_tcp as well as from the io task.
    const MoistureReading reading = moistureReading(index);
    if (reading.samples == 0) {
        return String();
    }

    double confidence = 0.0;
    const int inferred = moistureModelClassify(index, reading.average, &confidence);
    if (inferred != MOISTURE_UNKNOWN) {
        return String(moistureClassName(inferred));
    }

    const float dry = config.moistureDry[index];
    const float wet = config.moistureWet[index];
    const float span = wet - dry;

    // Uncalibrated. Reporting a band from an unknown scale would be a guess
    // dressed as a measurement, so the probe reports no state at all.
    if (fabsf(span) < 1e-3) {
        return String();
    }

    // Ordering is not assumed: with the 100-ADC% conversion the air reading is
    // the smaller number, but a different probe or conversion can invert that.
    float fraction = (reading.average - dry) / span;
    if (fraction < 0.0) {
        fraction = 0.0;
    } else if (fraction > 1.0) {
        fraction = 1.0;
    }

    if (fraction < 1.0 / 3.0) {
        return String("Dry");
    }
    if (fraction < 2.0 / 3.0) {
        return String("Humid");
    }
    return String("Wet");
}

double
flowTotalLitres()
{
    return g_flowTotalLitres;
}

bool
floatRaised()
{
    return g_floatRaised;
}

void
sensorsSetup()
{
    const unsigned publishMs = mqttPublishPeriodMs();
    const unsigned ioWindow = publishMs / g_ioTaskPeriod;
    const unsigned ambientWindow = publishMs / g_ambientTaskPeriod;
    const unsigned moistureMs = (unsigned)config.moisturePeriodSec * 1000u;
    const unsigned moistureWindow =
      (publishMs / moistureMs > 0) ? (publishMs / moistureMs) : 1;

    for (unsigned i = 0; i < MOISTURE_MAX; ++i) {
        g_soilMoisture[i].setMaxLen(moistureWindow);
    }
    g_luminosity.setMaxLen(ioWindow);
    g_waterLevel.setMaxLen(ioWindow);
    g_flowRate.setMaxLen(ioWindow);
    g_temperature.setMaxLen(ambientWindow);
    g_airHumidity.setMaxLen(ambientWindow);

    for (unsigned i = 0; i < MOISTURE_MAX; ++i) {
        probeHealthReset(g_probeHealth[i]);
    }

    pinMode(config.buttonPin, INPUT);

    probePowerSnapshot();

    // A probe's power pin is driven to its parked level BEFORE pinMode() and
    // again after. Until a pin is configured it floats, and a floating gate on
    // whatever switches the sensor is an undefined amount of time at an
    // undefined level — which for a gated probe is the electrodes live, the
    // exact thing power gating exists to avoid.
    //
    // The parked level is OFF, unless some probe on that pin asked for
    // permanent power, in which case it is ON. Parking an always-on pin off
    // and letting the first read switch it up would put a 1 Hz square wave on
    // the bank for the length of boot and hand the first conversion an
    // unsettled rail — and the pin is meant to be up from here to the next
    // reset, so the honest thing is to write that level once and never again.
    for (unsigned i = 0; i < config.moistureCount; ++i) {
        const uint8_t pin = config.soilMoisturePowerPin[i];
        if (pin == ConfigFile::kNoPin) {
            continue;
        }
        const bool energised = probe_power::pinIsAlwaysOn(
          g_probePower, config.moistureCount, pin);
        const int level =
          config.soilMoisturePowerOn[i] ? (energised ? HIGH : LOW)
                                        : (energised ? LOW : HIGH);
        digitalWrite(pin, level);
        pinMode(pin, OUTPUT);
        digitalWrite(pin, level);
    }

    // Only peripherals config.json declares get their pins touched. Attaching
    // an interrupt to a pin nothing is wired to would count noise as flow.
    if (config.flowFitted) {
        pinMode(config.flowPin, INPUT_PULLUP);
        attachInterrupt(
          digitalPinToInterrupt(config.flowPin), flowPulseISR, FALLING);
        logger.info("Flow sensor on GPIO " + String(config.flowPin) + ", " +
                    String(config.flowPulsesPerLitre, 1) + " pulses/litre");
    }

    if (config.floatFitted) {
        pinMode(config.floatPin, INPUT_PULLUP);
        logger.info("Float switch on GPIO " + String(config.floatPin) +
                    ", active " + String(config.floatActiveLevel));
    }

    logger.info("Sensors: " + String(config.moistureCount) + " moisture" +
                (config.luminosityFitted ? ", luminosity" : "") +
                (config.ambientFitted() ? (String(", ") +
                                           config.ambientSensorName())
                                        : String("")) +
                (config.waterLevelFitted ? ", water level" : "") +
                (config.flowFitted ? ", flow" : "") +
                (config.floatFitted ? ", float switch" : ""));
}

// Energises every probe that has a power pin, waits the longest settle among
// the pins that actually had to come UP, and reports whether anything is
// powered at all.
//
// Coalesced on purpose: two probes on one MOSFET is the normal wiring, and
// powering them one at a time would pay the settle delay twice for no reason.
//
// The write to an always-on pin is a no-op electrically — it is already at that
// level and has been since sensorsSetup() — and it is kept rather than skipped
// because it costs nothing and puts the pin back where it belongs if anything
// else ever moved it.
uint16_t
sensorsMoisturePowerUp()
{
    for (unsigned i = 0; i < MOISTURE_MAX; ++i) {
        probe_sampling::reset(g_moistureWindow[i]);
    }

    for (unsigned i = 0; i < config.moistureCount; ++i) {
        const uint8_t pin = config.soilMoisturePowerPin[i];
        if (pin == ConfigFile::kNoPin) {
            continue;
        }
        digitalWrite(pin, config.soilMoisturePowerOn[i] ? HIGH : LOW);
    }

    return probe_power::settleMsForTick(g_probePower, config.moistureCount);
}

// De-energises every power pin EXCEPT the ones some probe asked to keep up.
//
// The exemption is per PIN and not per probe, which is the whole subtlety: the
// four probes on the carrier share GPIO 14, so asking probe 0 alone for
// permanent power has to keep the pin up through probes 1..3's turn in this
// loop. Answered per probe, the last index wins and writes the pin back down.
static void
moisturePowerDown()
{
    for (unsigned i = 0; i < config.moistureCount; ++i) {
        const uint8_t pin = config.soilMoisturePowerPin[i];
        if (probe_power::pinPowersDown(
              g_probePower, config.moistureCount, pin)) {
            digitalWrite(pin, config.soilMoisturePowerOn[i] ? LOW : HIGH);
        }
    }
}

void
sensorsSampleMoisture(uint32_t elapsedMs)
{
    for (unsigned i = 0; i < config.moistureCount; ++i) {
        const uint8_t pin = config.soilMoisturePin[i];

        (void)analogRead(pin);
        const int second = analogRead(pin);
        probe_sampling::add(g_moistureWindow[i], elapsedMs, (uint16_t)second);
    }
}

void
sensorsFinishMoisture(uint32_t settleMs)
{
    float settled[MOISTURE_MAX] = {};
    uint16_t used[MOISTURE_MAX] = {};
    uint16_t raw[MOISTURE_MAX] = {};
    uint32_t late = 0;

    for (unsigned i = 0; i < config.moistureCount; ++i) {
        unsigned tailUsed = 0;
        const double adc = probe_sampling::settledValue(
          g_moistureWindow[i], config.moistureTailSamples, settleMs, &tailUsed);
        settled[i] = (float)adc;
        used[i] = (uint16_t)tailUsed;
        if (tailUsed == 0) {
            continue;
        }

        const probe_sampling::Window& window = g_moistureWindow[i];
        raw[i] = window.adc[window.count - 1];
        late = probe_sampling::lateMs(window, settleMs);
        probeHealthAdd(g_probeHealth[i], raw[i]);

        if (g_probeHealth[i].samples >= g_probeHealthWindow) {
            probeHealthDecay(g_probeHealth[i], g_probeHealthDecay);
        }

        const double pct = ADC_TO_PERCENT(adc);
        g_soilMoisture[i].add(config.moistureInvert[i] ? (100.0 - pct) : pct);
    }

    moisturePowerDown();

    MoistureReading fresh[MOISTURE_MAX];
    for (unsigned i = 0; i < MOISTURE_MAX; ++i) {
        fresh[i].average = g_soilMoisture[i].getAverage();
        fresh[i].samples = g_soilMoisture[i].getSamples();
    }

    ProbeHealthReport health[MOISTURE_MAX];
    for (unsigned i = 0; i < MOISTURE_MAX; ++i) {
        health[i].verdict = probeHealthVerdict(g_probeHealth[i],
                                               g_probeHealthMinSamples,
                                               g_probeHealthMaxSd);
        health[i].stepSd = (float)probeHealthStepSd(g_probeHealth[i]);
        health[i].samples = g_probeHealth[i].samples;
    }

    g_moistureTiming.settleMs = settleMs;
    g_moistureTiming.lastLateMs = late;
    ++g_moistureTiming.windows;
    if (late > 0) {
        ++g_moistureTiming.lateWindows;
        g_moistureTiming.lateTotalMs += late;
        if (late > g_moistureTiming.lateMaxMs) {
            g_moistureTiming.lateMaxMs = late;
        }
    }

    portENTER_CRITICAL(&g_moistureSnapshotMux);
    memcpy(g_moistureSnapshot, fresh, sizeof(fresh));
    memcpy(g_probeHealthSnapshot, health, sizeof(health));
    for (unsigned i = 0; i < MOISTURE_MAX; ++i) {
        g_moistureCaptureSnapshot[i].window = g_moistureWindow[i];
        g_moistureCaptureSnapshot[i].tailUsed = used[i];
        g_moistureCaptureSnapshot[i].settledAdc = settled[i];
        g_moistureCaptureSnapshot[i].rawAdc = raw[i];
    }
    g_moistureTimingSnapshot = g_moistureTiming;
    portEXIT_CRITICAL(&g_moistureSnapshotMux);
}

void
sensorsReadIo()
{
    if (config.luminosityFitted) {
        g_luminosity.add(ADC_TO_PERCENT(analogRead(config.luminosityPin)));
    }

    if (config.waterLevelFitted) {
        g_waterLevel.add(ADC_TO_WATER_LEVEL(analogRead(config.waterLevelPin)));
    }

    if (config.flowFitted) {
        portENTER_CRITICAL(&g_flowMux);
        const uint32_t pulses = g_flowPulses;
        g_flowPulses = 0;
        portEXIT_CRITICAL(&g_flowMux);

        const double litres = (double)pulses / (double)config.flowPulsesPerLitre;
        g_flowTotalLitres += litres;
        g_flowRate.add((float)(litres * 60000.0 / (double)g_ioTaskPeriod));
    }

    if (config.floatFitted) {
        static bool lastRead = false;
        const bool raised =
          (digitalRead(config.floatPin) == config.floatActiveLevel);
        if (raised == lastRead) {
            g_floatRaised = raised;
        }
        lastRead = raised;
    }
}

void
sensorsSetupAmbient()
{
    // At most one of these is true: loadFile() clears dhtFitted when a document
    // declares both, so the choice was made once, at load, where it could be
    // logged with the pin it was giving up.
    if (config.sht4xFitted) {
        // The ONLY place the I2C bus is started, and only because a device on
        // it is declared. A board with no I2C part never reaches this line and
        // never touches SDA or SCL.
        if (sht4xBegin(config.i2cSdaPin,
                       config.i2cSclPin,
                       config.i2cHz,
                       config.sht4xAddress)) {
            logger.info("SHT40 at 0x" + String(config.sht4xAddress, HEX) +
                        " on I2C SDA " + String(config.i2cSdaPin) + " / SCL " +
                        String(config.i2cSclPin) + " at " +
                        String(config.i2cHz / 1000) + " kHz");
        }
        // sht4xBegin() has already logged an error if it failed, and
        // sht4xRead() answers kNotReady from here on — so the task stays
        // enabled and the error rate climbs, which is what says "fitted and
        // broken" rather than "not fitted".
        return;
    }

    if (!config.dhtFitted) {
        return; // leaves g_dht null, which sensorsReadAmbient() handles
    }

    g_dht = new (g_dhtStorage) DHT_Unified(config.dhtPin, DHT11);
    g_dht->begin();
    logger.info("DHT11 on GPIO " + String(config.dhtPin));
}

// The DHT11's rated measuring range, from its datasheet.
//
// A reading outside it is a BAD READ, not weather. The part cannot resolve
// anything beyond these bounds, so a number that lands there came from a
// mistimed single-wire frame, not from the air — and this device published
// exactly that: airHumidity bottomed at 15.1 %, ten points below anything the
// sensor can measure, while dhtErrorRate read 0.00 the whole time.
//
// Two things were wrong with that, and they compound. The out-of-range sample
// was averaged into the window every dashboard and every stored point is drawn
// from, so it moved a number nobody could trace back to a fault. And it was
// counted as a SUCCESSFUL read, so the one counter that exists to say the
// sensor is misbehaving said the opposite. Discarding it without counting it
// would fix the first and keep the second, which is why it is counted as an
// error rather than merely dropped.
//
// The bounds say "the sensor cannot have measured this", which is NOT the same
// as the datasheet's rated range -- and confusing the two cost real data here.
//
// The humidity floor was the DHT11's rated 20 %, and this garden is in
// Brasilia, where the dry season routinely takes the afternoon below it. In the
// archive: 261 points (2.0 %) under 20 %, a minimum of 15.00, on the two driest
// days of the record. The gate would have discarded genuine readings on exactly
// the afternoons a garden most needs them. A rated range describes ACCURACY;
// outside it the reading is less trustworthy, not impossible. The floor is now
// low enough to catch only garbage -- the driest air ever recorded on earth is
// around 1 % -- and NaN from a checksum failure is caught separately, above.
static const float g_dhtMinTempC = 0.0f;
static const float g_dhtMaxTempC = 50.0f;
static const float g_dhtMinHumidityPct = 5.0f;
static const float g_dhtMaxHumidityPct = 100.0f;

// The SHT40's own plausibility gate is in core/sht4x_protocol.h, next to the
// CRC and the conversions, because all three are arithmetic a host test can
// reach. Its bounds are WIDER than the DHT's above and that is not laziness:
// they are the part's full operating range, so they can only reject a code
// pinned at a rail, while the CRC — two of them, per frame — does the work the
// DHT's weak 8-bit sum could not.
static void
readSht4x()
{
    float celsius = 0.0f;
    float humidity = 0.0f;
    const sht4x::Status status = sht4xRead(celsius, humidity);

    ++g_ambientTotalReads;
    if (status != sht4x::kOk) {
        ++g_ambientReadErrors;
        // Logged at debug: a single failed frame on a bus is ordinary, and a
        // persistent fault is what dhtErrorRate is for. Printing every one at
        // error level would bury the boot lines in an 8 KB rolling buffer.
        logger.debug(String("SHT40 read failed: ") + sht4x::statusName(status));
        return;
    }

    g_temperature.add(celsius);
    g_airHumidity.add(humidity);
}

static void
readDht()
{
    if (g_dht == nullptr) {
        return;
    }

    sensors_event_t event;
    bool error = false;

    g_dht->temperature().getEvent(&event);
    if (isnan(event.temperature)) {
        error = true;
    } else if (event.temperature < g_dhtMinTempC ||
               event.temperature > g_dhtMaxTempC) {
        error = true;
    } else {
        g_temperature.add(event.temperature);
    }

    g_dht->humidity().getEvent(&event);
    if (isnan(event.relative_humidity)) {
        error = true;
    } else if (event.relative_humidity < g_dhtMinHumidityPct ||
               event.relative_humidity > g_dhtMaxHumidityPct) {
        error = true;
    } else {
        g_airHumidity.add(event.relative_humidity);
    }

    ++g_ambientTotalReads;
    if (error) {
        ++g_ambientReadErrors;
    }
}

void
sensorsReadAmbient()
{
    // Exactly one arm can be taken. The other flag was cleared at load, which
    // is the whole reason no consumer of either sensor has to know the conflict
    // case exists.
    if (config.sht4xFitted) {
        readSht4x();
        return;
    }
    readDht();
}
