andrenepomuceno/esp_garden/src/config_io.cpp

// Parsers for the `io` block of config.json, where every entry accepts more
// than one shape so that a device already in the field keeps loading after a
// firmware update.

#include "core/config_io.h"
#include "core/config.h"
#include "core/logger.h"
#include "core/probe_sampling.h"
#include "core/sht4x_protocol.h"
#include <Arduino_JSON.h>

// Reads `io.relays` (array of {pin, on, name}) when present, otherwise falls
// back to the legacy scalar `io.watering` / `io.wateringOn` pair so a config
// written for a single-relay device still loads unchanged.
void
loadRelays(ConfigFile& cfg, JSONVar& io)
{
    JSONVar relays = io["relays"];

    if (JSON.typeof(relays) == "array") {
        const unsigned count = relays.length();
        // The array LENGTH is how many relays this board has. That is the
        // whole point of the change: adding a row in /devices.html adds a
        // relay, with no rebuild and no flag to keep in step.
        if (count > RELAY_MAX) {
            logger.warning("Config declares " + String(count) + " relays; " +
                           String(RELAY_MAX) +
                           " is the firmware maximum. The rest are ignored.");
        }
        cfg.relayCount = (count > RELAY_MAX) ? RELAY_MAX : count;
        cfg.clearUndeclaredRelayPins();

        for (unsigned i = 0; i < cfg.relayCount; ++i) {
            JSONVar relay = relays[i];

            // An absent key must keep the compiled default, not become 0.
            // Without these checks a relay entry written without "pin" — which
            // a config editor can produce for a row the user left blank — parks
            // the relay on GPIO 0, the boot strapping pin, and "on" silently
            // becomes active-high on a board wired active-low.
            if (relay.hasOwnProperty("pin")) {
                cfg.relayPin[i] = (int)relay["pin"];
            }
            if (relay.hasOwnProperty("on")) {
                cfg.relayPinOn[i] = (int)relay["on"];
            }

            // An absent name keeps the compiled default rather than blanking
            // the label the dashboard renders.
            // Non-empty, like loadSensor(). "" is a string, so without the
            // length check a row saved with the name cleared blanks the label:
            // /data.json then emits Outputs keyed by "", two unnamed relays
            // collide onto one JSON key and one of them vanishes from the
            // dashboard, and every log line reads "Starting  for 5000 ms".
            const String label = (const char*)JSONVar(relay["name"]);
            if (label.length() > 0) {
                cfg.relayName[i] = label;
            }
        }
        return;
    }

    if (JSON.typeof(io["watering"]) != "undefined") {
        // Pre-2.0 scalar form: exactly one relay.
        cfg.relayCount = 1;
        cfg.clearUndeclaredRelayPins();
        cfg.relayPin[0] = (int)io["watering"];
        cfg.relayPinOn[0] = (int)io["wateringOn"];
        return;
    }

    // No relays declared at all. Not an error — a sensor-only node is a
    // legitimate configuration — but it has to be said, because every relay
    // button in the UI disappearing otherwise looks like a bug.
    cfg.relayCount = 0;
    cfg.clearUndeclaredRelayPins();
    logger.warning("No io.relays in config: this device drives nothing.");
}

// Reads a sensor entry that may be a bare pin number or {pin, name}. Both
// shapes exist in the wild: the pin-only form predates naming, and a device in
// the field must keep loading after a firmware update.
void
loadSensor(JSONVar node, uint8_t& pin, String& name)
{
    const String type = JSON.typeof(node);
    if (type == "number") {
        pin = (int)node;
        return;
    }
    if (type != "object") {
        return;
    }

    JSONVar entry = node;
    if (entry.hasOwnProperty("pin")) {
        pin = (int)entry["pin"];
    }
    // An absent or empty name keeps the compiled default rather than blanking
    // the label the dashboard renders.
    if (JSON.typeof(entry["name"]) == "string") {
        const String label = (const char*)JSONVar(entry["name"]);
        if (label.length() > 0) {
            name = label;
        }
    }
}

// With exactly one probe fitted, and no name given for it, the label stays the
// unsuffixed "Soil Moisture" it has always been. /data.json keys Inputs by this
// string, so suffixing it on a one-probe board silently renames the channel
// every existing dashboard reads.
static void
applySingleProbeLabel(ConfigFile& cfg)
{
    if (cfg.moistureCount == 1 && cfg.soilMoistureName[0] == "Soil Moisture 1") {
        cfg.soilMoistureName[0] = "Soil Moisture";
    }
}

// The optional power-gating half of an `io.soilMoisture` entry:
// {pin, name, powerPin, powerOn, powerAlways, settleMs}. Absent keys leave the
// defaults, which are "the firmware never drives a power pin" — what every
// board did before this existed. Whether the probe is then powered is the
// BOARD's business: wired to 3V3 it runs permanently, and on the
// esp-garden-hardware carrier R9 holds SOIL_PWR_EN low, so it is permanently
// off. `powerAlways` is the only way to say "declared, and permanently on".
static void
loadProbePower(JSONVar node, ConfigFile& cfg, unsigned i)
{
    if (JSON.typeof(node) != "object") {
        return; // a bare pin number: no room for any of this
    }

    JSONVar entry = node;
    if (entry.hasOwnProperty("powerPin")) {
        const int pin = (int)entry["powerPin"];
        // -1 is how the UI says "none" without having to send kNoPin. The
        // upper bound is the chip's: a literal 39 turned every S3 pin from 40
        // up into "no power pin", so the probe bank would simply never be
        // energised and nothing would say why.
        cfg.soilMoisturePowerPin[i] =
          (pin < 0 || pin > (int)pinMaxGpio()) ? ConfigFile::kNoPin
                                               : (uint8_t)pin;
    }
    if (entry.hasOwnProperty("powerOn")) {
        cfg.soilMoisturePowerOn[i] = ((int)entry["powerOn"] != 0) ? 1 : 0;
    }
    // Both spellings, for the reason moisture[i].invert takes both: a plain
    // (bool) cast on a JSONVar is true only for the JSON literal `true`, so
    // `"powerAlways": 1` — the obvious hand-edit for "yes" — would read as
    // FALSE and the bank would keep being switched with nothing said. This one
    // fails in the safe direction when it gets it wrong, which is why it warns
    // rather than being read permissively and silently.
    if (entry.hasOwnProperty("powerAlways")) {
        JSONVar flag = entry["powerAlways"];
        const String kind = JSON.typeof(flag);
        if (kind == "boolean") {
            cfg.soilMoisturePowerAlways[i] = (bool)flag;
        } else if (kind == "number") {
            cfg.soilMoisturePowerAlways[i] = ((double)flag != 0.0);
        } else {
            logger.warning(
              "io.soilMoisture[" + String(i) +
              "].powerAlways is not a boolean; keeping " +
              String(cfg.soilMoisturePowerAlways[i] ? "true" : "false"));
        }
    }
    if (JSON.typeof(entry["settleMs"]) == "number") {
        const long ms = (long)entry["settleMs"];
        if (ms < 0 || ms > 65535) {
            logger.warning("Ignoring out-of-range io.soilMoisture[" +
                           String(i) + "].settleMs " + String(ms) +
                           "; keeping " +
                           String(cfg.soilMoistureSettleMs[i]) + " ms");
        } else {
            cfg.soilMoistureSettleMs[i] = (uint16_t)ms;
        }
    }
}

// `io.soilMoisture` is a bare pin number (legacy, one probe), an array of pins,
// or an array of {pin, name}.
void
loadSoilMoisture(ConfigFile& cfg, JSONVar& io)
{
    if (io.hasOwnProperty("soilMoisturePeriodSec")) {
        const int period = (int)io["soilMoisturePeriodSec"];
        if (period >= 1 && period <= 10000) {
            cfg.moisturePeriodSec = period;
        } else {
            logger.warning("Ignoring out-of-range io.soilMoisturePeriodSec " +
                           String(period) + "; keeping " +
                           String(cfg.moisturePeriodSec) + " s");
        }
    }

    if (io.hasOwnProperty("soilMoistureSampleMs")) {
        JSONVar node = io["soilMoistureSampleMs"];
        const bool number = JSON.typeof(node) == "number";
        const double interval = number ? (double)node : -1.0;
        if (number && interval >= 0.0 && interval <= 65535.0) {
            cfg.moistureSampleMs = (uint16_t)interval;
        } else {
            logger.warning(
              "Ignoring io.soilMoistureSampleMs " + JSON.stringify(node) +
              ": expected a number of ms in 0..65535; keeping " +
              String(cfg.moistureSampleMs) + " ms");
        }
    }

    if (io.hasOwnProperty("soilMoistureTailSamples")) {
        JSONVar node = io["soilMoistureTailSamples"];
        const bool number = JSON.typeof(node) == "number";
        const double tail = number ? (double)node : 0.0;
        if (number && tail >= 1.0 && tail <= (double)probe_sampling::kCapacity) {
            cfg.moistureTailSamples = (uint16_t)tail;
        } else {
            logger.warning(
              "Ignoring io.soilMoistureTailSamples " + JSON.stringify(node) +
              ": a window holds 1.." + String(probe_sampling::kCapacity) +
              " samples; keeping " + String(cfg.moistureTailSamples));
        }
    }

    JSONVar pins = io["soilMoisture"];

    if (JSON.typeof(pins) == "array") {
        const unsigned count = pins.length();
        if (count > MOISTURE_MAX) {
            logger.warning("Config declares " + String(count) +
                           " moisture probes; " + String(MOISTURE_MAX) +
                           " is the firmware maximum (the history record has "
                           "that many slots). The rest are ignored.");
        }
        cfg.moistureCount = (count > MOISTURE_MAX) ? MOISTURE_MAX : count;

        for (unsigned i = 0; i < cfg.moistureCount; ++i) {
            loadSensor(pins[i], cfg.soilMoisturePin[i], cfg.soilMoistureName[i]);
            loadProbePower(pins[i], cfg, i);
        }
        applySingleProbeLabel(cfg);
        return;
    }

    if (JSON.typeof(pins) != "undefined") {
        // Legacy scalar: exactly one probe.
        cfg.moistureCount = 1;
        loadSensor(pins, cfg.soilMoisturePin[0], cfg.soilMoistureName[0]);
        applySingleProbeLabel(cfg);
        return;
    }

    cfg.moistureCount = 0;
}

// `io.i2c` is {sda, scl, hz}, every key optional.
//
// It is NOT a fitted flag and there is deliberately no `io.i2cFitted` to drift
// out of step with it: this block says what the bus IS, and whether the bus
// comes up is answered by whether any I2C device is declared. Presence is still
// the key — it is just the device's key, not the bus's. Declaring `io.i2c` on a
// board with nothing on the bus changes nothing and drives no pin.
//
// A pin outside the chip's range is refused rather than truncated. uint8_t
// takes 264 to 8 silently, and 8 is SDA on the carrier this exists for, so a
// typo would land the bus on top of itself with nothing said.
void
loadI2c(ConfigFile& cfg, JSONVar& io)
{
    if (JSON.typeof(io["i2c"]) != "object") {
        return; // family defaults; see include/core/default_pins.h
    }

    JSONVar entry = io["i2c"];

    struct BusPin
    {
        const char* key;
        uint8_t* field;
    };
    const BusPin pins[] = { { "sda", &cfg.i2cSdaPin }, { "scl", &cfg.i2cSclPin } };

    for (unsigned i = 0; i < sizeof(pins) / sizeof(pins[0]); ++i) {
        if (!entry.hasOwnProperty(pins[i].key)) {
            continue;
        }
        const int pin = (int)entry[pins[i].key];
        if (pin < 0 || pin > (int)pinMaxGpio()) {
            logger.warning("io.i2c." + String(pins[i].key) + " GPIO " +
                           String(pin) + " is not a pin on this chip; keeping " +
                           String(*pins[i].field) + ".");
            continue;
        }
        *pins[i].field = (uint8_t)pin;
    }

    if (JSON.typeof(entry["hz"]) == "number") {
        const double hz = (double)entry["hz"];
        // Standard mode through fast mode plus. Below 10 kHz the SHT4x's own
        // clock stretching becomes the limit rather than the bus; above 1 MHz
        // is past what the part is specified for, and past what a bus brought
        // off the board on a header will carry.
        if (hz >= 10000.0 && hz <= 1000000.0) {
            cfg.i2cHz = (uint32_t)hz;
        } else {
            logger.warning("io.i2c.hz outside 10000..1000000; keeping " +
                           String(cfg.i2cHz) + ".");
        }
    }
}

// `io.sht4x` is {name, address}, or any object at all — presence is the key.
//
// No pin: the part is on the bus, which is the one structural difference
// between this kind and every other one in the io block. A `pin` here would be
// a number nothing reads, so it is not accepted rather than silently ignored in
// a shape that looks like it works.
void
loadSht4x(ConfigFile& cfg, JSONVar& io)
{
    cfg.sht4xFitted = io.hasOwnProperty("sht4x");
    if (!cfg.sht4xFitted) {
        return;
    }

    if (JSON.typeof(io["sht4x"]) != "object") {
        return; // "sht4x": true and friends: fitted, all defaults
    }

    JSONVar entry = io["sht4x"];

    // Same non-empty rule loadSensor() applies: a row saved with the name
    // cleared must keep the compiled default rather than blanking the label
    // /data.json keys its Inputs by.
    if (JSON.typeof(entry["name"]) == "string") {
        const String label = (const char*)JSONVar(entry["name"]);
        if (label.length() > 0) {
            cfg.sht4xName = label;
        }
    }

    if (entry.hasOwnProperty("address")) {
        const int address = (int)entry["address"];
        if (sht4x::addressIsValid(address)) {
            cfg.sht4xAddress = (uint8_t)address;
        } else {
            // Refused rather than clamped, for the reason et0.latitude is:
            // a clamped typo hides which number was wrong, and here the wrong
            // number produces a bus that answers nothing with no clue why.
            logger.warning("io.sht4x.address 0x" + String(address, HEX) +
                           " is not an SHT4x address (0x44..0x46); keeping 0x" +
                           String(cfg.sht4xAddress, HEX) + ".");
        }
    }
}
