andrenepomuceno/esp_garden/src/web.cpp

#include "core/filesystem.h"
#include "BuildConfig.h"
#include "core/config.h"
#include "core/io_history.h"
#include "core/logger.h"
#include "core/onboarding.h"
#include "core/role.h"
#include "core/tasks.h"
#include "network/custom_login.h"
#include "network/web.h"
#include "network/web_capabilities.h"
#include "network/web_onboarding.h"
#include "network/web_config.h"
#include "network/web_data.h"
#include "network/web_files.h"
#include "network/web_moisture.h"
#include "network/web_ota.h"
#include "network/web_users.h"
#include <Arduino_JSON.h>
#include <AsyncTCP.h>
#include <ESPAsyncWebServer.h>
#include <ESPmDNS.h>
// 3.7.x no longer pulls WiFi.h in transitively the way the old fork did.
#include <WiFi.h>
#include <freertos/FreeRTOS.h>
#include <freertos/semphr.h>
#include <time.h>

static AsyncWebServer g_webServer(80);

bool g_wifiConnected = false;
bool g_hasNetwork = false;

void
handleControl(AsyncWebServerRequest* request)
{
    digitalWrite(LED_BUILTIN, 1);

    bool restartRequested = false;

    // relay + relayTime address any relay; watering / wateringTime are the
    // legacy spelling for relay 0 and stay supported.
    if (request->hasParam("relay", true)) {
        const unsigned index =
          request->getParam("relay", true)->value().toInt();
        // An explicit stop, never a zero duration. String::toInt() answers 0
        // for anything it cannot parse, so "relayTime == 0 means stop" would
        // turn a malformed field into a silent pump shutdown and leave the
        // handler unable to tell the two commands apart.
        if (request->hasParam("relayStop", true)) {
            stopRelay(index);
        } else {
            unsigned duration = g_wateringDefaultTime;
            if (request->hasParam("relayTime", true)) {
                duration =
                  request->getParam("relayTime", true)->value().toInt();
            }
            startRelay(index, duration);
        }
    }

    for (int i = 0; i < request->params(); ++i) {
        const AsyncWebParameter* param = request->getParam(i);
        if ((param->name() == "watering") && (param->value() == "enable")) {
            startWatering();
        } else if (param->name() == "wateringTime") {
            startWatering(param->value().toInt());
        } else if (param->name() == "mqtt") {
            if (param->value() == "enable") {
                mqttEnable(true);
            } else if (param->value() == "disable") {
                mqttEnable(false);
            }
        } else if ((param->name() == "reset") && (param->value() == "1")) {
            restartRequested = true;
        }
    }

    request->send(200);

    digitalWrite(LED_BUILTIN, 0);

    // Handed to loop() rather than done here: request->send() only queues the
    // response, and rebooting (or blocking) on the async_tcp task kills the
    // connection before it flushes, so the caller could never tell a reboot
    // from a failure.
    if (restartRequested) {
        logger.warning("Restart requested over /control.");
        requestRestart();
    }
}

void
handleLogs(AsyncWebServerRequest* request)
{
    digitalWrite(LED_BUILTIN, 1);

    String output = logger.read();
    request->send(200, "text/plain", output);

    digitalWrite(LED_BUILTIN, 0);
}

// Hard cap on one response. 1440 records is 57 KB of raw struct and roughly
// 170 KB rendered as JSON — more than half this chip's DRAM, with WiFi already
// holding a large share. Callers page with ?limit=.
static const size_t g_historyMaxResponse = 200;

// NaN marks a channel this board does not have; JSON has no NaN literal and
// null is the honest encoding. isfinite() rather than isnan(): an infinity
// serializes as `inf`, which is not valid JSON, so one bad sample would make
// the browser throw on the whole response instead of on one field.
static void
appendFloatValue(String& out, float value)
{
    if (isfinite(value)) {
        out += String(value, 2);
    } else {
        out += "null";
    }
}

static void
appendFloat(String& out, const char* key, float value)
{
    out += "\"";
    out += key;
    out += "\":";
    appendFloatValue(out, value);
}

static void
handleHistoryJson(AsyncWebServerRequest* request)
{
    if (!ioHistory.ready()) {
        request->send(503, "text/plain", "history buffer not available");
        return;
    }

    size_t limit = 100;
    if (request->hasParam("limit")) {
        const long asked = request->getParam("limit")->value().toInt();
        if (asked > 0) {
            limit = (size_t)asked;
        }
    }
    if (limit > g_historyMaxResponse) {
        limit = g_historyMaxResponse;
    }

    // ?window=<seconds> selects by time and DECIMATES to fit. Without it a 24 h
    // window is 1440 records against a 200-record cap, so the page could only
    // ever show the newest 3 h — asking for a day and getting three hours,
    // silently.
    static IoRecord buffer[g_historyMaxResponse];
    size_t count = 0;
    uint32_t stride = 1;
    uint32_t offset = IoHistory::kNewest;
    long window = 0;

    if (request->hasParam("window")) {
        window = request->getParam("window")->value().toInt();
    }

    if (window > 0) {
        const time_t now = time(NULL);
        // A clock that has not synced would make every record look in-window;
        // fall back to "everything stored" rather than inventing a range.
        const uint32_t since =
          (now > (time_t)window) ? (uint32_t)(now - window) : 0;
        uint32_t from = 0;
        // One call: locating the window and reading it have to happen under the
        // same lock, or an append() between them shifts every logical index.
        count = ioHistory.readWindow(since, buffer, limit, &stride, &from);
        offset = from;
    } else {
        if (request->hasParam("offset")) {
            const long asked = request->getParam("offset")->value().toInt();
            if (asked >= 0) {
                offset = (uint32_t)asked;
            }
        }
        count = ioHistory.read(buffer, limit, offset);
    }

    // CHUNKED generation: one record per callback, never the whole payload in
    // RAM at once.
    //
    // Two earlier shapes are recorded here because both were measured and both
    // were wrong:
    //
    //   String + beginResponse — beginResponse COPIES the string, so a
    //   200-record window needed ~35 KB twice on a heap whose largest free
    //   block is 53 KB. It did not merely peak: `limit=200` returned 200 OK
    //   with a Content-Length of ZERO, which is what the history page asks for
    //   on every load. Silent, and the page just showed nothing.
    //
    //   AsyncResponseStream — fixed the double copy and made fragmentation
    //   worse, because its buffer grows by reallocation: largest free block
    //   53 KB -> 33 KB, low-water heap 76 KB -> 60 KB on the same load.
    //
    // This one holds a header, one serialised record, and nothing else. Peak is
    // independent of `limit`, which is the only property that makes the 200-
    // record window safe on a board with 320 KB of DRAM and no PSRAM.
    String header;
    header.reserve(160);
    header += "{\"capacity\":";
    header += String(ioHistory.capacity());
    header += ",\"stored\":";
    header += String(ioHistory.stored());
    header += ",\"returned\":";
    header += String(count);
    header += ",\"offset\":";
    header += String(offset == IoHistory::kNewest
                       ? (ioHistory.stored() > count ? ioHistory.stored() - count : 0)
                       : offset);
    // The page needs the stride to say "1 point per 8 minutes" rather than
    // implying every sample is shown.
    header += ",\"stride\":";
    header += String(stride);
    header += ",\"window\":";
    header += String(window);
    header += ",\"records\":[";

    // Serialisation state, carried across callbacks. One request at a time is
    // already this handler's contract — `buffer` is a static too — and the
    // filler runs on async_tcp, the same task that populated both.
    static String pending;
    static size_t nextRecord = 0;
    static size_t emitted = 0;

    pending = header;
    nextRecord = 0;
    emitted = 0;

    const size_t total = count;

    AsyncWebServerResponse* response = request->beginChunkedResponse(
      "application/json",
      [total](uint8_t* out, size_t maxLen, size_t) -> size_t {
          // Top the buffer up one record at a time until it can satisfy this
          // call. A record is ~155 bytes and maxLen is typically over 1 KB, so
          // this is a handful of appends, never a full payload.
          while (pending.length() < maxLen && nextRecord < total) {
              const IoRecord& r = buffer[nextRecord];
              if (nextRecord) {
                  pending += ",";
              }
              pending += "{\"t\":";
              pending += String(r.timestamp);
              pending += ",\"relays\":";
              pending += String(r.relayMask);
              pending += ",\"moisture\":[";
              for (unsigned m = 0; m < IO_HISTORY_MAX_MOISTURE; ++m) {
                  if (m) {
                      pending += ",";
                  }
                  appendFloatValue(pending, r.moisture[m]);
              }
              pending += "],";
              appendFloat(pending, "lum", r.luminosity);
              pending += ",";
              appendFloat(pending, "temp", r.temperature);
              pending += ",";
              appendFloat(pending, "hum", r.airHumidity);
              pending += ",";
              appendFloat(pending, "water", r.waterLevel);
              pending += ",";
              appendFloat(pending, "flow", r.flowRate);
              pending += ",";
              appendFloat(pending, "flowTotal", r.flowTotal);
              // Three states, not two: null means the board has no float
              // switch, so the page can leave the row out rather than draw a
              // permanently empty reservoir.
              pending += ",\"float\":";
              pending += (r.flags & IO_HISTORY_FLAG_FLOAT_VALID)
                           ? ((r.flags & IO_HISTORY_FLAG_FLOAT_RAISED) ? "1" : "0")
                           : "null";
              pending += "}";
              ++nextRecord;

              if (nextRecord == total) {
                  pending += "]}";
              }
          }

          if (pending.length() == 0) {
              return 0; // done: an empty chunk ends the response
          }

          const size_t take =
            (pending.length() < maxLen) ? pending.length() : maxLen;
          memcpy(out, pending.c_str(), take);
          pending.remove(0, take);
          emitted += take;
          return take;
      });

    response->addHeader("Cache-Control", "no-store");
    request->send(response);
}

// Refuses a path outright. Used to shadow files that a serveStatic below would
// otherwise expose.
static void
handleForbidden(AsyncWebServerRequest* request)
{
    request->send(403, "text/plain", "Forbidden");
}

static void
servePublicFile(const char* route, const char* path, const char* contentType)
{
    g_webServer.on(
      route, HTTP_GET, [path, contentType](AsyncWebServerRequest* request) {
          digitalWrite(LED_BUILTIN, 1);
          request->send(FILESYSTEM, path, contentType);
          digitalWrite(LED_BUILTIN, 0);
      });
}

static void
wifiConnected(WiFiEvent_t event, WiFiEventInfo_t info)
{
    logger.info("Wifi connected.");
    g_wifiConnected = true;
}

static void
wifiGotIP(WiFiEvent_t event, WiFiEventInfo_t info)
{
    logger.info("IP address: " + WiFi.localIP().toString());
    g_hasNetwork = true;
}

static void
wifiDisconnected(WiFiEvent_t event, WiFiEventInfo_t info)
{
    if (g_wifiConnected) {
        logger.warning("Wifi disconnected. Reconnecting...");
    }

    g_wifiConnected = false;
    g_hasNetwork = false;

    // The portal owns the radio. onboardingBegin() calls WiFi.disconnect(true),
    // which raises exactly this event, so without the guard the reconnect below
    // would drag the STA back up underneath the soft AP — on the stored
    // credentials that have just been shown not to work.
    if (onboardingActive()) {
        return;
    }

    WiFi.begin(g_ssid.c_str(), g_wifiPassword.c_str());
}

// Spent ONLY on a board carrying the marker — i.e. between onboarding and its
// first successful association, and never again. A configured board does not
// call this at all, so nothing here can delay a normal boot.
//
// It polls rather than waiting on the events above because it has to answer
// "did we associate" even when it is about to hand the radio to the AP, and an
// event-driven flag would then need clearing on a path that no longer exists.
static bool
waitForAssociation()
{
    logger.info("Setup marker present: proving the stored credentials, up to " +
                String(onboarding::kProbationMs / 1000) + " s...");

    const unsigned long start = millis();
    while (millis() - start < onboarding::kProbationMs) {
        if (WiFi.status() == WL_CONNECTED) {
            return true;
        }
        delay(250);
    }
    return false;
}

void
webSetup(bool configLoaded)
{
    logger.info("Web setup...");

    g_dataMutex = xSemaphoreCreateMutex();
    webUpdateDataCache();

    // ------------------------------------------------------------------
    // THE MODE DECISION. It is made here, exactly once, and it is the only
    // thing in the tree that can register the onboarding routes.
    //
    // Everything below the early return is the normal route table; everything
    // the portal serves is in onboardingBegin(). A reader who wants to know
    // whether an unauthenticated /config.json writer exists on a configured
    // device checks this one branch, not a middleware chain.
    //
    // decide() itself is in core/onboarding.h, Arduino-free and held to its
    // truth table by test_onboarding. The property it exists for: a board whose
    // config loaded and which carries no marker gets Mode::Normal
    // unconditionally, with `associated` never read — so the live garden cannot
    // reach the portal however long the router stays down.
    // ------------------------------------------------------------------
    bool associated = false;
    const bool markerPresent = configLoaded && onboardingMarkerPresent();

    if (configLoaded) {
        WiFi.mode(WIFI_STA);
        WiFi.setHostname(g_hostname.c_str());
        WiFi.onEvent(wifiConnected, ARDUINO_EVENT_WIFI_STA_CONNECTED);
        WiFi.onEvent(wifiGotIP, ARDUINO_EVENT_WIFI_STA_GOT_IP);
        WiFi.onEvent(wifiDisconnected, ARDUINO_EVENT_WIFI_STA_DISCONNECTED);
        WiFi.begin(g_ssid.c_str(), g_wifiPassword.c_str());

        if (onboarding::mustProbeAssociation(configLoaded, markerPresent)) {
            associated = waitForAssociation();
        }
    }

    const onboarding::Decision decision =
      onboarding::decide(configLoaded, markerPresent, associated);

    if (decision.clearMarker) {
        onboardingMarkerClear();
    }

    if (decision.mode == onboarding::Mode::Portal) {
        onboardingBegin(g_webServer, decision.reason);
        g_webServer.begin();
        logger.info("Web setup done (setup portal).");
        return;
    }

    if (MDNS.begin(g_hostname.c_str()) == false) {
        logger.warning("Error starting mDNS!");
    }

    // Public assets: the pages themselves carry no data, and the login page has
    // to be reachable before a token exists. Everything that reads or changes
    // state is guarded below.
    servePublicFile("/", "/index.html", "text/html");
    servePublicFile("/index.html", "/index.html", "text/html");
    servePublicFile("/index.js", "/index.js", "application/javascript");
    servePublicFile("/login.html", "/login.html", "text/html");
    servePublicFile("/login.js", "/login.js", "application/javascript");
    // Vendored so the pages work with the WAN down. The config page in
    // particular exists to fix a device that cannot reach the internet, and
    // with jQuery on a CDN it rendered blank in exactly that situation.
    // Bootstrap, vendored. Every page used to pull it from jsdelivr, which
    // made the dashboard degrade to unstyled HTML exactly when it matters — on
    // a device whose whole purpose is surviving a connectivity loss. The
    // bundle's JS went away entirely: nothing here uses a modal, a dropdown or
    // any other component that needs it.
    //
    // Only the .gz exists on the filesystem; AsyncFileResponse finds it and
    // sets Content-Encoding itself, which is the same trick jquery.js uses.
    servePublicFile("/bootstrap.css", "/bootstrap.css", "text/css");
    servePublicFile("/jquery.js", "/jquery.js", "application/javascript");
    servePublicFile("/spark-md5.js", "/spark-md5.js", "application/javascript");
    servePublicFile("/sha256.js", "/sha256.js", "application/javascript");
    servePublicFile("/auth.js", "/auth.js", "application/javascript");
    servePublicFile("/config.html", "/config.html", "text/html");
    servePublicFile("/config.js", "/config.js", "application/javascript");
    servePublicFile("/users.html", "/users.html", "text/html");
    servePublicFile("/users.js", "/users.js", "application/javascript");
    servePublicFile("/history.html", "/history.html", "text/html");
    servePublicFile("/history.js", "/history.js", "application/javascript");
    servePublicFile("/devices.html", "/devices.html", "text/html");
    // The bundled image no longer CONTAINS these two: build_assets.py folds
    // devices_model.js and devices_render.js into devices.js, and the markup it
    // ships loads only the bundle. The routes stay for a device whose
    // filesystem predates the bundling — where the files are still there and
    // the old devices.html still asks for them by name — and cost nothing on
    // one where they are not: the allow-list is exhaustive, so an unregistered
    // path 404s just as an absent file does.
    servePublicFile("/devices_model.js", "/devices_model.js", "application/javascript");
    servePublicFile("/devices_render.js", "/devices_render.js", "application/javascript");
    servePublicFile("/devices.js", "/devices.js", "application/javascript");
    servePublicFile("/schedules.html", "/schedules.html", "text/html");
    servePublicFile("/schedules.js", "/schedules.js", "application/javascript");
    servePublicFile("/moisture.html", "/moisture.html", "text/html");
    servePublicFile("/moisture.js", "/moisture.js", "application/javascript");
    servePublicFile("/update.html", "/update.html", "text/html");
    servePublicFile("/update.js", "/update.js", "application/javascript");
    servePublicFile("/favicon.ico", "/favicon.ico", "image/x-icon");

    // PUBLIC, and deliberately carries one field. The login page has to say
    // WHICH board is being signed into — there is more than one of these on a
    // LAN now, and an operator reaching one by IP has nothing on screen to tell
    // them apart — but it runs before there is any session to authorise with,
    // so the answer has to be public. The hostname already is: mDNS broadcasts
    // it to the whole segment. The firmware version is NOT here: an
    // unauthenticated reader learning the exact build is a fingerprint, and it
    // is on /data.json for anyone who has logged in.
    //
    // OUTSIDE the USE_CUSTOM_LOGIN block on purpose. /login.html and /login.js
    // are served unconditionally above, so a build with that flag off would
    // still serve a page asking for this route — and scripts/dev_server.py
    // answers it unconditionally, so gating it here is exactly the mirror drift
    // this repo keeps correcting itself for.
    //
    // Built ONCE. The hostname is fixed for the life of the boot (nothing
    // re-reads config.json at runtime), and the alternative is a String
    // concatenation per request on the single async_tcp task that also carries
    // OTA uploads — the heap already measured fragmenting under parallel loads.
    // JSONVar rather than concatenation because `hostname` is operator text,
    // checked only for length: a quote in it would otherwise emit JSON the
    // login page cannot parse, which fails as a page that never names the
    // board — the exact thing this route exists to prevent.
    g_webServer.on("/device.json", HTTP_GET, [](AsyncWebServerRequest* request) {
        static String body;
        if (body.length() == 0) {
            JSONVar doc;
            doc["hostname"] = g_hostname.c_str();
            body = JSON.stringify(doc);
        }
        AsyncWebServerResponse* response =
          request->beginResponse(200, "application/json", body);
        if (!response) {
            // Allocation-free exit. Returning without sending does NOT avoid a
            // panic: the library then builds its own 501, which allocates
            // again on the same exhausted heap and dereferences the result
            // unconditionally.
            request->abort();
            return;
        }
        response->addHeader("Cache-Control", "no-store");
        request->send(response);
    });

#if USE_CUSTOM_LOGIN
    customLogin.begin();

    g_webServer.on("/nonce", HTTP_GET, [](AsyncWebServerRequest* request) {
        customLogin.handleNonce(request);
    });
    g_webServer.on("/login", HTTP_POST, [](AsyncWebServerRequest* request) {
        customLogin.handleLogin(request);
    });
    g_webServer.on("/logout", HTTP_POST, [](AsyncWebServerRequest* request) {
        customLogin.handleLogout(request);
    });

    auto& authenticated = customLogin.authenticationMiddleware;
    auto* adminOnly = customLogin.requireRole(Role::ADMIN);
    auto* operatorOnly = customLogin.requireRole(Role::OPERATOR);

    g_webServer.on("/data.json", HTTP_GET, handleDataJson)
      .addMiddleware(&authenticated);
    g_webServer.on("/history.json", HTTP_GET, handleHistoryJson)
      .addMiddleware(&authenticated);
    g_webServer.on("/capabilities.json", HTTP_GET, handleCapabilitiesJson)
      .addMiddleware(&authenticated);
    g_webServer.on("/moisture.json", HTTP_GET, handleMoistureJson)
      .addMiddleware(&authenticated);
    g_webServer.on("/control", HTTP_POST, handleControl)
      .addMiddleware(operatorOnly);
    g_webServer.on("/logs", HTTP_GET, handleLogs).addMiddleware(adminOnly);
    g_webServer.on("/config.json", HTTP_GET, handleConfigGet)
      .addMiddleware(adminOnly);
    g_webServer.on("/config.json", HTTP_POST, handleConfigPost)
      .addMiddleware(adminOnly);
    g_webServer.on("/users.json", HTTP_GET, handleUsersJson)
      .addMiddleware(adminOnly);
    g_webServer.on("/users", HTTP_POST, handleUsersPost).addMiddleware(adminOnly);
    g_webServer.on("/updateEnable", HTTP_POST, handleUpdateEnable)
      .addMiddleware(adminOnly);
    g_webServer
      .on("/update", HTTP_POST, handleUpdateRequest, handleUpdateUpload)
      .addMiddleware(adminOnly);

    // Registered above the /spiffs prefix handlers below, which are GET-only
    // and would not match a POST anyway — but keeping every /spiffs route
    // together is what makes the shadow ordering readable.
    g_webServer
      .on("/spiffs/upload", HTTP_POST, handleFileUploadRequest, handleFileUpload)
      .addMiddleware(adminOnly);
    g_webServer.on("/spiffs/delete", HTTP_POST, handleFileDelete)
      .addMiddleware(adminOnly);

    // MUST be registered BEFORE the serveStatic they shadow: handlers are
    // matched in registration order, and the matcher is a PREFIX, so the
    // rotated users.bak.json variants are covered too. /config.json carries the
    // WiFi and MQTT passwords in plaintext, /users.json the password hashes and
    // salts, /sessions.json live bearer tokens — none of them may ever be
    // served, even to an admin.
    g_webServer
      .on(AsyncURIMatcher::prefix("/spiffs/users"), HTTP_GET, handleForbidden)
      .addMiddleware(adminOnly);
    g_webServer
      .on(AsyncURIMatcher::prefix("/spiffs/sessions"),
          HTTP_GET,
          handleForbidden)
      .addMiddleware(adminOnly);
    g_webServer
      .on(AsyncURIMatcher::prefix("/spiffs/config"), HTTP_GET, handleForbidden)
      .addMiddleware(adminOnly);
    g_webServer.serveStatic("/spiffs", FILESYSTEM, "/").addMiddleware(adminOnly);
#else
    g_webServer.on("/data.json", HTTP_GET, handleDataJson);
    g_webServer.on("/history.json", HTTP_GET, handleHistoryJson);
    g_webServer.on("/capabilities.json", HTTP_GET, handleCapabilitiesJson);
    g_webServer.on("/moisture.json", HTTP_GET, handleMoistureJson);
    g_webServer.on("/control", HTTP_POST, handleControl);
    g_webServer.on("/logs", HTTP_GET, handleLogs);
    g_webServer.on("/updateEnable", HTTP_POST, handleUpdateEnable);
    g_webServer.on(
      "/update", HTTP_POST, handleUpdateRequest, handleUpdateUpload);
    g_webServer.on(
      "/spiffs/upload", HTTP_POST, handleFileUploadRequest, handleFileUpload);
    g_webServer.on("/spiffs/delete", HTTP_POST, handleFileDelete);
#endif

    g_webServer.onNotFound(
      [](AsyncWebServerRequest* request) { request->send(404); });

    g_webServer.begin();

    logger.info("Web setup done!");
}
