andrenepomuceno/esp_garden/src/web_files.cpp

#include "core/logger.h"
#include "core/onboarding.h"
#include "network/web_files.h"
#include <ESPAsyncWebServer.h>
#include <MD5Builder.h>
#include "core/filesystem.h"

// Written to first, moved into place only once the whole body arrived and the
// checksum matched. Writing straight to the target would let a dropped Wi-Fi
// connection replace a working index.html with half of one.
static const char* const g_uploadTempPath = "/upload.tmp";

static File g_uploadFile;
static MD5Builder g_uploadMD5;
static size_t g_uploadBytes = 0;
static String g_uploadTarget;
static String g_uploadError;

// The same set the /spiffs browse handler shadows with a 403, for the same
// reason: they hold the salted password hashes, the live bearer tokens and the
// plaintext WiFi and MQTT credentials. Uploading over them would be a way to
// install a known password, or to wipe every live session, through a route
// whose entire job is to accept arbitrary bytes.
//
// /config.json is refused too, but for a different reason: POST /config.json
// validates the document, checks the device id and restores masked secrets. A
// raw upload bypasses all three, and an invalid config only fails at the next
// boot — on a device that then cannot reach the network to be fixed.
// EXACT, not a prefix. The three files this protects are the credential store,
// the live bearer tokens and the validated config document — and nothing else.
//
// It used to be startsWith(), which reads as the cautious choice and is not: it
// also refused /config.html, /config.js, /users.html and /users.js, which are
// ordinary web assets. That surfaced the moment the assets started being
// deployed one at a time instead of by rewriting the whole partition — the
// upload answered 400 for four files whose only sin was their name, and the
// only way to update them became the whole-image path that wipes /config.json.
// A guard that pushes you toward the more destructive tool is worse than the
// one it replaced.
//
// The /spiffs BROWSE shadows stay prefix matches deliberately. Refusing to read
// /spiffs/config.html.gz costs nothing — the same bytes are served from its own
// public route — while a prefix there is one less thing to get exactly right on
// the side where a mistake exposes WiFi passwords and live session tokens.
//
// The marker is in the list for a fourth reason. Its ABSENCE is what keeps a
// board that has ever reached the network out of the setup portal for ever, so
// putting the file back would re-arm that path on a working device: the next
// boot would probe for 60 s and, if the router happened to be down, raise an AP
// with a published password and an unauthenticated /config.json writer. Only an
// ADMIN can reach this endpoint and an ADMIN can already rewrite the whole
// config — but a config write is visible and this would not be.
static bool
uploadPathIsProtected(const String& path)
{
    return path == "/users.json" || path == "/sessions.json" ||
           path == "/config.json" || path == onboarding::kMarkerPath;
}

static bool
uploadPathIsUsable(const String& path, String& reason)
{
    if (path.length() < 2 || path[0] != '/') {
        reason = "path must start with a slash";
        return false;
    }
    if (path.indexOf("..") >= 0) {
        reason = "path must not contain ..";
        return false;
    }
    // LittleFS collapses repeated slashes and resolves "." segments, so
    // "//config.json" and "/./config.json" both land on /config.json — while
    // an exact-string guard sees three different paths and lets two of them
    // through. Refused rather than normalised: rewriting the caller's path and
    // then writing somewhere else is its own surprise, and nothing legitimate
    // spells an asset this way.
    if (path.indexOf("//") >= 0 || path.indexOf("/./") >= 0 ||
        path.endsWith("/") || path.endsWith("/.")) {
        reason = "path must not contain empty or . segments";
        return false;
    }
    // SPIFFS_OBJ_NAME_LEN is 32 including the terminator. A longer name is
    // truncated silently, so the file lands somewhere the caller did not ask
    // for and every later read misses it.
    if (path.length() > FILESYSTEM_MAX_PATH) {
        reason = "path longer than " + String(FILESYSTEM_MAX_PATH) +
                 " characters";
        return false;
    }
    if (path == g_uploadTempPath) {
        reason = "reserved path";
        return false;
    }
    if (uploadPathIsProtected(path)) {
        if (path == "/config.json") {
            reason = "use POST /config.json, which validates the document";
        } else if (path == onboarding::kMarkerPath) {
            reason = "writing this re-arms the first-boot setup portal";
        } else {
            reason = "credential store";
        }
        return false;
    }
    return true;
}

void
handleFileUpload(AsyncWebServerRequest* request,
                 String filename,
                 size_t index,
                 uint8_t* data,
                 size_t len,
                 bool final)
{
    if (index == 0) {
        g_uploadError = "";
        g_uploadBytes = 0;
        g_uploadTarget = filename.startsWith("/") ? filename : ("/" + filename);

        String reason;
        if (!uploadPathIsUsable(g_uploadTarget, reason)) {
            g_uploadError = "refused " + g_uploadTarget + ": " + reason;
            logger.warning("[upload] " + g_uploadError);
            return;
        }

        // Both files exist at once until the rename, so the check has to cover
        // the incoming size on top of everything already stored.
        //
        // Rounded UP to the allocation block, plus one block for the CTZ chain
        // metadata: LittleFS allocates in 4 KB blocks where SPIFFS used 256 B
        // pages, so a raw byte comparison passes for a file that then does not
        // fit, and the caller learns it only after sending the whole body.
        const size_t freeBytes = FILESYSTEM.totalBytes() - FILESYSTEM.usedBytes();
        const size_t raw = request->contentLength();
        const size_t incoming =
          ((raw + FILESYSTEM_BLOCK_SIZE - 1) / FILESYSTEM_BLOCK_SIZE + 1) *
          FILESYSTEM_BLOCK_SIZE;
        if (incoming > freeBytes) {
            g_uploadError = "not enough space: " + String(incoming) +
                            " B incoming, " + String(freeBytes) + " B free";
            logger.error("[upload] " + g_uploadError);
            return;
        }

        FILESYSTEM.remove(g_uploadTempPath);
        g_uploadFile = FILESYSTEM.open(g_uploadTempPath, FILE_WRITE);
        if (g_uploadFile == false) {
            g_uploadError = "could not open " + String(g_uploadTempPath);
            logger.error("[upload] " + g_uploadError);
            return;
        }

        g_uploadMD5.begin();
        // `raw`, not `incoming`: the latter is rounded up to whole LittleFS
        // blocks with a margin for the space CHECK, and printing it made a
        // 5 KB asset announce itself as 12288 B. A log line that overstates by
        // 2.4x is a log line somebody will one day debug against.
        logger.info("[upload] receiving " + g_uploadTarget + " (" +
                    String(raw) + " B)");
    }

    if (g_uploadError.length() > 0) {
        return; // already refused; drain the body without writing it
    }

    if (len > 0) {
        if (g_uploadFile.write(data, len) != len) {
            g_uploadError = "write failed at byte " + String(g_uploadBytes);
            logger.error("[upload] " + g_uploadError);
            g_uploadFile.close();
            FILESYSTEM.remove(g_uploadTempPath);
            return;
        }
        g_uploadMD5.add(data, len);
        g_uploadBytes += len;
    }

    if (!final) {
        return;
    }

    g_uploadFile.close();
    g_uploadMD5.calculate();

    if (request->hasParam("MD5", true)) {
        const String expected = request->getParam("MD5", true)->value();
        const String actual = g_uploadMD5.toString();
        if (!expected.equalsIgnoreCase(actual)) {
            g_uploadError =
              "checksum mismatch: expected " + expected + ", got " + actual;
            logger.error("[upload] " + g_uploadError);
            FILESYSTEM.remove(g_uploadTempPath);
            return;
        }
    }

    // Only now is the old file replaced, and under LittleFS that is a single
    // atomic rename over the existing destination: the target is either the old
    // version or the new one, never absent.
    //
    // It used to remove the target first, because SPIFFS.rename refused an
    // existing destination. That left a window — short, but real — in which the
    // file did not exist, and losing power inside it while replacing
    // /index.html or /auth.js leaves an unbootable web UI. This board prints
    // `flash read err, 1000` on every boot from a marginal supply, so that is
    // not hypothetical. Do not reintroduce the remove.
    if (!FILESYSTEM.rename(g_uploadTempPath, g_uploadTarget)) {
        g_uploadError = "could not move into place as " + g_uploadTarget;
        logger.error("[upload] " + g_uploadError);
        FILESYSTEM.remove(g_uploadTempPath);
        return;
    }

    // An asset and its compressed twin must never both exist: AsyncFileResponse
    // prefers the uncompressed one, so a device still holding the plain file
    // from an older whole-image deploy would keep serving THAT after a
    // per-file upload of the .gz — reporting {"ok":true} while the page stays
    // broken. Whichever was just written wins, in both directions.
    const String twin = g_uploadTarget.endsWith(".gz")
                          ? g_uploadTarget.substring(0, g_uploadTarget.length() - 3)
                          : (g_uploadTarget + ".gz");
    if (FILESYSTEM.exists(twin)) {
        FILESYSTEM.remove(twin);
        logger.info("[upload] removed the superseded " + twin);
    }

    logger.warning("[upload] wrote " + g_uploadTarget + " (" +
                   String(g_uploadBytes) + " B) from " +
                   request->client()->remoteIP().toString());
}

void
handleFileUploadRequest(AsyncWebServerRequest* request)
{
    if (g_uploadError.length() > 0) {
        AsyncWebServerResponse* response = request->beginResponse(
          400,
          "application/json",
          String("{\"ok\":false,\"error\":\"") + g_uploadError + "\"}");
        response->addHeader("Cache-Control", "no-store");
        request->send(response);
        // ALL of it, not just the error. Leaving g_uploadTarget set meant the
        // next request without a file part — an empty file input, a retry after
        // a client-side abort — skipped the index==0 reset, found no error and
        // a non-empty target, and answered 200 {"ok":true,"path":"/users.json"}
        // for a write to the credential store that had just been refused.
        g_uploadError = "";
        g_uploadTarget = "";
        g_uploadBytes = 0;
        return;
    }

    // A request with no file part reaches here with nothing recorded, which is
    // a caller error rather than a device one.
    if (g_uploadTarget.isEmpty()) {
        request->send(400,
                      "application/json",
                      "{\"ok\":false,\"error\":\"no file in request\"}");
        return;
    }

    AsyncWebServerResponse* response = request->beginResponse(
      200,
      "application/json",
      String("{\"ok\":true,\"path\":\"") + g_uploadTarget +
        "\",\"bytes\":" + String(g_uploadBytes) +
        ",\"free\":" + String(FILESYSTEM.totalBytes() - FILESYSTEM.usedBytes()) + "}");
    response->addHeader("Cache-Control", "no-store");
    request->send(response);
    g_uploadTarget = "";
    g_uploadBytes = 0;
}

// ---------------------------------------------------------------------------
// Single-file delete
// ---------------------------------------------------------------------------

// The counterpart to the upload, and the reason it exists: a test upload of
// mine (`/probe.js`) sat on the filesystem with no way to remove it short of
// rewriting the whole partition — which is precisely the operation the per-file
// upload was built to avoid.
//
// Same refusals as the upload, for the same reasons: deleting /users.json locks
// every account out, /sessions.json signs everyone out, and /config.json makes
// the device unreachable at its next boot. Nothing here may remove the file
// that lets you fix a mistake made here.
void
handleFileDelete(AsyncWebServerRequest* request)
{
    if (!request->hasParam("path", true)) {
        request->send(400, "application/json",
                      "{\"ok\":false,\"error\":\"missing path\"}");
        return;
    }

    String path = request->getParam("path", true)->value();
    if (!path.startsWith("/")) {
        path = "/" + path;
    }

    String reason;
    if (!uploadPathIsUsable(path, reason)) {
        logger.warning("[delete] refused " + path + ": " + reason);
        request->send(400,
                      "application/json",
                      String("{\"ok\":false,\"error\":\"refused ") + path +
                        ": " + reason + "\"}");
        return;
    }

    // Refusing a path that is not there, rather than reporting success, is what
    // tells a caller their path was wrong instead of leaving them to wonder why
    // the file is still being served.
    if (!FILESYSTEM.exists(path)) {
        request->send(404,
                      "application/json",
                      String("{\"ok\":false,\"error\":\"") + path +
                        " does not exist\"}");
        return;
    }

    if (!FILESYSTEM.remove(path)) {
        request->send(500,
                      "application/json",
                      String("{\"ok\":false,\"error\":\"could not remove ") +
                        path + "\"}");
        return;
    }

    logger.warning("[delete] removed " + path + " from " +
                   request->client()->remoteIP().toString());

    AsyncWebServerResponse* response = request->beginResponse(
      200,
      "application/json",
      String("{\"ok\":true,\"path\":\"") + path + "\",\"free\":" +
        String(FILESYSTEM.totalBytes() - FILESYSTEM.usedBytes()) + "}");
    response->addHeader("Cache-Control", "no-store");
    request->send(response);
}
