andrenepomuceno/esp_garden/data/devices.js

// ESP Garden — sensor and actuator inventory.
//
// A real editor for what this board drives and reads: peripherals are declared
// in config.json and counted at runtime, so adding a relay or a probe is a row
// here plus a restart. There is no RELAY_COUNT or MOISTURE_SENSOR_COUNT to
// rebuild against any more.
//
// Every pin rule and every ceiling comes from GET /capabilities.json rather
// than being restated here. A page that hardcodes "GPIO 32-39 are analog" keeps
// saying so after the firmware changes, and the first sign of the drift is a
// channel reading noise — which is exactly what that endpoint exists to
// prevent.
(function () {
  var TEST_MS = 3000;

  var caps = null;    // GET /capabilities.json — pin rules and per-kind maxima
  var live = null;    // GET /data.json — live readings, matched at load time
  var doc = null;     // GET /config.json — posted back whole, io/moisture apart
  var model = null;   // the editable view of doc.io and doc.moisture
  var esc = null;     // bound in $() once auth.js has run
  var ready = false;  // false blocks every edit and the save button

  // The page state above is the only copy. devices_model.js and
  // devices_render.js read it through these getters rather than holding it,
  // because load() replaces caps, live, doc and model outright and a captured
  // reference would go on painting the previous device.
  var ctx = {
    caps: function () { return caps; },
    live: function () { return live; },
    doc: function () { return doc; },
    model: function () { return model; },
    ready: function () { return ready; },
  };

  // Imported under the names they had while this was one file.
  var M = espDevicesModel;
  var R = espDevicesRender;
  var SENSORS = M.SENSORS;
  var text = M.text;
  var plural = M.plural;
  var capsUsable = M.capsUsable;
  var pinAllowed = M.pinAllowed;
  var relayDefaultName = M.relayDefaultName;
  var probeDefaultName = M.probeDefaultName;
  var buildModel = M.buildModel;
  var takenPins = M.takenPins;
  var suggestedPin = M.suggestedPin;
  var buildDocument = M.buildDocument;
  var validate = M.validate;
  var renderRelays = R.renderRelays;
  var renderProbes = R.renderProbes;
  var renderSensors = R.renderSensors;
  var renderPinMap = R.renderPinMap;

  function render() {
    renderRelays();
    renderProbes();
    renderSensors();
    refresh();
  }

  // ---------- form state ----------

  function pinValue(raw) {
    var s = $.trim(String(raw === undefined || raw === null ? '' : raw));
    if (s === '') return null;
    var v = parseInt(s, 10);
    return isNaN(v) ? null : v;
  }

  // DOM back into the model. Runs before every structural change and before
  // every save, so an edit in progress is never dropped by a re-render.
  function collect() {
    if (!model) return;

    $('.rl-name').each(function () {
      model.relays[$(this).data('row')].name = $.trim(String($(this).val()));
    });
    $('.rl-pin').each(function () {
      model.relays[$(this).data('row')].pin = pinValue($(this).val());
    });
    $('.rl-on').each(function () {
      model.relays[$(this).data('row')].on =
        (parseInt($(this).val(), 10) === 1) ? 1 : 0;
    });

    $('.ms-name').each(function () {
      model.probes[$(this).data('row')].name = $.trim(String($(this).val()));
    });
    $('.ms-pin').each(function () {
      model.probes[$(this).data('row')].pin = pinValue($(this).val());
    });
    $('.ms-dry').each(function () {
      model.probes[$(this).data('row')].dry = $.trim(String($(this).val()));
    });
    $('.ms-wet').each(function () {
      model.probes[$(this).data('row')].wet = $.trim(String($(this).val()));
    });
    $('.ms-kind').each(function () {
      model.probes[$(this).data('row')].kind = $.trim(String($(this).val()));
    });
    $('.ms-invert').each(function () {
      var probe = model.probes[$(this).data('row')];
      var now = $(this).is(':checked');
      // Flipping polarity makes the two-point anchors meaningless: they were
      // measured under the other sign, and nothing downstream can tell. Left
      // alone they report a saturated pot as Dry. Clearing them is the same
      // "no badge rather than an invented one" the firmware already applies to
      // an uncalibrated probe, and it is visible — the fields go blank, which
      // is the prompt to measure again.
      if (probe.invert !== now) {
        probe.dry = '0';
        probe.wet = '0';
      }
      probe.invert = now;
    });
    $('.ms-power-on').each(function () {
      model.probes[$(this).data('row')].powerOn =
        (parseInt($(this).val(), 10) === 0) ? 0 : 1;
    });
    $('.ms-power').each(function () {
      model.probes[$(this).data('row')].powerPin = pinValue($(this).val());
    });
    $('.ms-power-always').each(function () {
      model.probes[$(this).data('row')].powerAlways = $(this).prop('checked');
    });
    $('.ms-settle').each(function () {
      model.probes[$(this).data('row')].settleMs = $.trim(String($(this).val()));
    });
    $('.ms-relay').each(function () {
      var relay = parseInt($(this).val(), 10);
      model.probes[$(this).data('row')].relay = isNaN(relay) ? -1 : relay;
    });

    $('.sn-fit').each(function () {
      model.sensors[$(this).data('key')].fitted = $(this).prop('checked');
    });
    $('.sn-name').each(function () {
      model.sensors[$(this).data('key')].name = $.trim(String($(this).val()));
    });
    $('.sn-pin').each(function () {
      model.sensors[$(this).data('key')].pin = pinValue($(this).val());
    });
    $('.sn-ppl').each(function () {
      model.sensors.flow.pulsesPerLitre = $.trim(String($(this).val()));
    });
    $('.sn-level').each(function () {
      model.sensors.floatSwitch.activeLevel =
        (parseInt($(this).val(), 10) === 1) ? 1 : 0;
    });
    $('.sn-interlock').each(function () {
      model.sensors.floatSwitch.interlock = $(this).prop('checked');
    });
    $('.sn-fill').each(function () {
      model.sensors.floatSwitch.fillRelay = parseInt($(this).val(), 10);
    });
  }

  // Runs on every edit and returns the report, so the save handler and the
  // warning list can never disagree about what is wrong.
  function refresh() {
    if (!model) return null;
    var report = validate();

    $('#tbody-relays, #tbody-probes, #tbody-sensors')
      .find('.is-invalid').removeClass('is-invalid');
    $.each(report.flagged, function (selector) {
      $(selector).addClass('is-invalid');
    });

    renderPinMap(report);

    var html = '';
    if (report.problems.length) {
      html += '<div class="alert alert-danger hint"><strong>These have to be ' +
              'fixed before saving.</strong><ul class="mb-0">';
      $.each(report.problems, function (_, problem) {
        html += '<li>' + esc(problem) + '</li>';
      });
      html += '</ul></div>';
    }
    if (report.warnings.length) {
      html += '<div class="alert alert-warning hint"><strong>Allowed, but worth ' +
              'reading.</strong><ul class="mb-0">';
      $.each(report.warnings, function (_, warning) {
        html += '<li>' + esc(warning) + '</li>';
      });
      html += '</ul></div>';
    }
    $('#warnings').html(html);

    $('#button-save').prop('disabled', !ready || report.problems.length > 0);
    return report;
  }

  // ---------- transport ----------

  function blockEditing(message) {
    ready = false;
    model = null;
    // 8 spans the widest of the three tables (probes); a short colspan just
    // leaves a ragged cell, which reads as a rendering bug in the one state
    // that is supposed to look deliberate.
    var empty = '<tr><td colspan="8" class="text-muted small">Editing is ' +
                'blocked until the page loads completely.</td></tr>';
    $('#tbody-relays, #tbody-probes, #tbody-sensors').html(empty);
    $('#pin-map').empty();
    $('#warnings').empty();
    $('#caps-note').empty();
    $('#button-save, #button-add-relay, #button-add-probe').prop('disabled', true);
    espUI.setStatus('danger', message);
  }

  // Nothing is editable until all three payloads are in. Rendering the form
  // from half a model is how a save rewrites fields the user never touched: an
  // unread capability list would offer every GPIO, and an unread /data.json
  // would show every peripheral as missing.
  function load(keepStatus) {
    ready = false;
    $('#button-save, #button-add-relay, #button-add-probe').prop('disabled', true);
    if (!keepStatus) espUI.setStatus('info', 'Loading…');

    $.getJSON('/capabilities.json')
      .done(function (payload) {
        if (!capsUsable(payload)) {
          blockEditing('/capabilities.json did not return the pin rules this ' +
                       'page needs. Reload before editing — without them every ' +
                       'GPIO would look valid.');
          return;
        }
        caps = payload;
        loadLive(keepStatus);
      })
      .fail(function (xhr) {
        blockEditing('Could not read /capabilities.json (' +
                     (xhr.status || 'no response') + '). Editing is blocked: ' +
                     'the pin rules come from the device, and guessing them ' +
                     'here is how a probe ends up on ADC2.');
      });
  }
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
