andrenepomuceno/esp_garden/(commit log)

2021-04-12 First working version on nodemcu esp32s
2021-05-02 Added last ThingSpeak error timestamp
    [main.cpp]
2021-05-08 Added retry on communication error; code formatting
    [main.cpp]
2021-05-08 Added temperature and humidity measures
2021-05-08 Updated prototype image
2021-05-09 Fix sensors task stack
    [main.cpp]
2021-05-23 Added Watering button
2021-06-14 Updating tsTake time to 2 min; updated prototype image
2021-06-21 Added water pump control
2021-07-11 Added multiple board support
2021-07-18 nodemcu-32s renamed to firmware; minor fixes
    [accumulator.cpp, logger.cpp, main.cpp, talkback.cpp, tasks.cpp]
2021-08-04 Using Arduino_JSON library
2021-09-12 Added more build customization for sensors
2021-09-13 Board pinout moved to config.h file
2023-01-06 Added led blink on error
    [main.cpp, tasks.cpp, tasks.h]
2023-01-09 Added RSSI Accumulator; minor fixes
    [tasks.cpp, web.cpp]
2023-01-09 Added ping time to UI; minor fixes
    [mqtt.cpp, tasks.cpp, tasks.h, web.cpp]
2023-01-09 WIP log in disk bugfix
    [logger.cpp]
2023-01-13 Added water level sensor support (WIP)
2026-08-19 feat(hardware): support 4 relays and 2 moisture probes on espgarden5
    Relay and probe counts become compile-time (RELAY_COUNT,
    MOISTURE_SENSOR_COUNT), defaulted to 1 so the four existing
    environments keep their exact shape. config.json gains array forms for
    io.relays and io.soilMoisture, both falling back to the pre-2.0 scalar
    spelling so a config written for a single-relay device still loads.
    Relay timing moves to a critical task on a dedicated FreeRTOS runner:
    the cooperative pump runs one task per loop() call, so a blocking Ping,
    TalkBack or MQTT drain used to delay switching a pump off.
    Also fixes five defects found while mapping the code:
    - relay pins floated from reset until tasksSetu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
    [BuildConfig.h, accumulator_v2.cpp, config.cpp, dev_server.py, main.cpp]
2026-08-19 feat(auth): nonce + SHA-256 login with roles, ported from fullbot-firmware
    Every endpoint that reads or changes state used to be open to anyone on
    the LAN: /control watered the garden and rebooted the device, /logs was
    readable, and /updateEnable + /update accepted arbitrary firmware. Only
    the static file handler carried HTTP Basic.
    Ports CustomLogin, UserStore and Role from fullbot-firmware. The
    password never crosses the wire — the device issues a one-shot 30 s
    nonce and the browser answers sha256(nonce + ":" + sha256(salt + ":" +
    password)). Sessions idle out after 24 h, five failures from one address
    return 429 for a minute, and remember=true persists the token to
    /sessions.json.
    Unl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
    [esp_garden_4mb.csv]
2026-08-19 fix(mqtt): pin the current DigiCert root so ThingSpeak TLS verifies again
    data/thingspeak.pem pinned the intermediate DigiCert TLS RSA SHA256 2020
    CA1. ThingSpeak now serves its chain under DigiCert Global G2 TLS RSA
    SHA256 2020 CA1 / DigiCert Global Root G2, so every MQTT connect failed
    with -9984 X509 certificate verification failed and channel 1348790
    received no data between 2023-03-07 and today.
    Nothing surfaced the failure: /data.json keeps reporting MQTT enabled and
    only Packages Sent stuck at 0 gives it away, while mqttLoop() retries on
    every loop() iteration and floods the log.
    Pins the root rather than the intermediate — roots run to 2038, and it is
    the intermediate that rotate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
2026-08-19 feat(config): read and write /config.json over HTTP without exposing secrets
    Settings previously required rebuilding and deploying the whole filesystem
    image, which also wipes the log files and the user store.
    GET /config.json (ADMIN) returns the document with wifi.password,
    ota.password, thingSpeak.apiKey, talkBack.apiKey and mqtt.password
    replaced by a mask; POST /config.json restores any field still carrying
    the mask from the copy on disk. fullbot serves its raw config to any
    authenticated session, plaintext credentials included — this does not.
    The handler rejects a document whose id does not match the device.
    Writing another garden's config would pass validation here and then be
    ref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
    [config.cpp, dev_server.py, web.cpp]
2026-08-19 feat(tasks): publish telemetry every minute and sample the DHT every second
    Shortens the MQTT and TalkBack periods to 1 min and the DHT period to 1 s.
    The DHT now sits at the sensor's sampling floor: the Adafruit driver
    returns its cached reading rather than an error when polled faster than
    once per second.
    Every scalar accumulator derives its window from the MQTT period at
    construction, so each average covers exactly one publish interval. An
    array cannot pass a constructor argument, so g_soilMoisture kept the
    120-sample default and its averages silently spanned two minutes while
    every other channel spanned one. AccumulatorV2 gains setMaxLen() and the
    probes are sized in tasksSetup().
    Also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
    [accumulator_v2.cpp, tasks.cpp]
2026-08-19 feat(io): drive four relays on espgarden1 and check the pin map at boot
    Raises RELAY_COUNT to 4 for espgarden1 and assigns the three new relays to
    GPIO 16, 17 and 18. Relay 0 stays on GPIO 15 because that is how the board
    in the field is wired, even though it is a strapping pin. GPIO 16 and 17
    are free on the ESP32-WROOM-32 that NodeMCU-32S carries; only WROVER
    modules spend them on PSRAM.
    Adds ConfigFile::validatePins(), which logs every GPIO claimed by two
    peripherals and every relay parked on an input-only pin (34-39). Neither
    is a compile error or a runtime fault today — the symptom is a peripheral
    that quietly reads or drives garbage and looks like a dead sensor.
    The dashboard alrea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
    [config.cpp]
2026-08-19 feat(webui): edit the configuration from the browser
    Adds a Config page that reads GET /config.json, renders a form and writes
    the whole document back with POST /config.json. Settings no longer need a
    filesystem deploy or a hand-built HTTP request.
    The form is generated from the document the device returns rather than
    from a hardcoded schema. The configuration differs per board — RELAY_COUNT
    and which sensors are compiled in change which keys exist — and a fixed
    form would silently drop the fields it did not know about on save. Saving
    starts from the fetched document and overwrites only what has an input, so
    unrendered keys survive the round trip.
    Types are preserved per field: a port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
    [config.js, dev_server.py, web.cpp]
2026-08-19 fix(webui): stop the config editor from writing a config that bricks the device
    Review findings on the config page. The severe ones all end the same way:
    a write that succeeds, reports success, and only fails at the next boot,
    by which point the device is unreachable without USB.
    - POST /config.json now refuses any document loadFile() would reject at
    boot. Clearing a password or shortening a hostname used to save, return
    200 and leave the device on compiled defaults it cannot connect with.
    The rule and its minimum live in configDocumentIsUsable() so the write
    and boot paths cannot drift apart. A short ota.password no longer
    reaches UserStore either, because validation runs before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
    [config.cpp, config.js, dev_server.py, tasks.cpp, tasks.h]
2026-08-19 feat(sensors): second soil probe on espgarden1, and tabs in the config page
    Raises MOISTURE_SENSOR_COUNT to 2 for espgarden1 and puts the new probe on
    GPIO 35 — ADC1, unused, and input-only, which is fine for an analog
    channel. All four analog inputs (36, 35, 39, 34) stay on ADC1 because
    ADC2 cannot be read while WiFi is associated.
    The ThingSpeak slot for the second probe is now an explicit build flag
    rather than an implicit reuse of field 4. Field 4 is free only on a board
    without a water level sensor; espgarden1 has one, and renumbering would
    rewrite the meaning of three years of stored data. Unset, the probe shows
    on the dashboard and stays out of the cloud, and the build says so: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
2026-08-19 test: add a host test harness and cover AccumulatorV2
    The repo had no tests. Every change so far was verified by building and
    poking the live device, which is how a config editor shipped that wrote
    eight asterisks over the real WiFi credentials.
    Adds [env:native] (Unity, no board, no data/config.json) and a first
    suite for AccumulatorV2 — the only production class that compiles without
    the Arduino core. It backs every sensor channel: the value, the rolling
    average and the variance shown on the dashboard and published to
    ThingSpeak.
    Two of the eight cases are regressions for bugs fixed earlier in this
    branch: getLast() dereferencing an empty std::list when /data.json is
    polled before the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
    [runner.cpp]
2026-08-19 feat(users): manage accounts from the browser
    Ports fullbot's user handlers and adds a Users page. Until now the device
    had exactly one account, migrated from ota.*, and the OPERATOR role could
    not be created at all — the role system existed but nothing exercised it.
    GET /users.json returns usernames and roles only; the salt and the hash
    never leave the device. POST /users takes action=upsert|delete.
    Three guards fullbot does not have:
    - Demoting the last admin is refused. fullbot blocks deleting it but not
    demoting it, and both close the same door: every administrative route,
    including the one that would undo the change.
    - A new password must meet the same minimum the config path e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
2026-08-19 feat(moisture): per-probe dry/humid/wet classification, plus the analysis that says history cannot provide it
    A month of channel 1348790 was fitted to answer whether the history
    defines dry/humid/wet states. It does not, and the evidence is worth
    keeping:
    - A linear drying trend alone explains 86.4% of the variance over 29.7
    days (-0.323 points/day). The series is one slow decay, not three
    states.
    - With that trend removed, BIC on the residuals prefers k=2, and the
    second component sits at -24.5 — the handful of near-zero readings from
    a disconnected probe, not a soil state. Effectively k=1.
    - Clustering the RAW series does return three groups, at 8.3, 35.9 and
    41.3. Those are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
2026-08-19 docs: cover the config editor, user management and moisture calibration
    README described a device that no longer exists: no web configuration, no
    account management, no per-probe moisture classification, and it still
    implied the pages depend on a CDN.
    Adds a calibration section that states plainly why the thresholds come
    from two readings per probe rather than from channel history, and a table
    of what each page does and which role it needs.
2026-08-20 feat(moisture): derive calibration anchors from watering events
    Watering is a labelled transition: the soil is at its driest just before
    one and at its wettest shortly after. --from-events reads the anchors off
    those events, so a probe never has to leave the soil, and the span it
    returns is operational — this soil in this pot — rather than the probe's
    physical range.
    Activations arrive in bursts that share one wetting response, so they are
    grouped into sessions first. Counting each activation separately reports
    the same peak repeatedly and passes it off as independent evidence: the
    24 events on the live device are 4 sessions.
    Two things this got wrong on the first run, both fixed:
    - A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
    [moisture_calibration.py]
2026-08-20 feat(sensors): third soil probe on espgarden1
    ADC1 is the scarce resource here, not GPIO count: every analog input must
    be on it because ADC2 cannot be read while WiFi is associated, and a
    WROOM-32 bonds out six of its channels (32-36, 39 — 37 and 38 are on the
    die but not on the module). Four were taken, so a third probe fits on
    GPIO 32 and leaves GPIO 33 for a fourth.
    GPIO 32/33 double as XTAL_32K_P/N. The WROOM-32 a NodeMCU-32S carries
    ships without that crystal, so they are ordinary ADC1 inputs; a module
    with one fitted could not use them.
    The firmware already sized its arrays from MOISTURE_SENSOR_COUNT, so this
    is a flag and a pin. The compiled defaults did need fixing: the second
    e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
    [config.cpp]
2026-08-20 feat(relay): increase maximum relay activation time from 20s to 30s
2026-08-24 feat(history): fixed-size ring buffer of the last N I/O records
    /io_history.bin keeps a snapshot of every input and output — moisture
    probes, luminosity, temperature, humidity, water level and a relay
    bitmask — across reboots. Capacity and period are both config-driven
    (history.records, history.periodSec) and range-checked at load, since a
    typo here asks for a file larger than the partition. Defaults: 1440
    records at 60 s, which is 24 h in 57.6 KB of the 512 KB SPIFFS.
    The file is preallocated at begin() and never grows: appends overwrite
    the oldest slot in place. Flash usage is therefore exactly
    16 + capacity * 40 bytes forever, with none of the rotation logic the
    logger needs. The per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
    [config.cpp, dev_server.py, io_history.cpp, main.cpp, runner.cpp, tasks.cpp]
2026-08-24 feat(webui): history charts, and fix what the review found in the buffer
    Adds /history.html: small multiples over a shared time axis, one plot per
    measure. Temperature and humidity get separate plots because they cannot
    share a y-scale honestly, and relay activity is a state strip rather than
    a line — drawing a binary as a line implies values in between.
    Drawn as inline SVG, not with a charting library: the pages load nothing
    from a CDN, and the smallest usable library is larger than everything
    else in SPIFFS put together. Crosshair, tooltip, direct series labels and
    a table view; the three-series palette was run through the validator and
    passes every gate on both surfaces (the light-mode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
    [config.cpp, dev_server.py, io_history.cpp, tasks.cpp, web.cpp]
2026-08-24 fix(history): bound the boot waits, and fix what the review found
    The live board was found stuck in tasksSetup() printing "Syncing clock..."
    every 2 s for minutes. WiFi was up, the web server was answering and the
    network was fine — NTP just did not reply. Because both waits there were
    unbounded, no sensor was read, no history was written and no MQTT was
    published for as long as that lasted. Neither wait needs to finish before
    loop() starts: checkInternet and clockUpdate are periodic tasks that keep
    retrying. Both are now capped at 60 s, clockUpdate re-arms at one minute
    instead of one day while the clock is unset, and a history record is
    skipped rather than stamped 1970.
    Review findings,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
    [config.cpp, dev_server.py, io_history.cpp, tasks.cpp]
2026-08-24 feat(mqtt): ThingsBoard backend, and names for sensors
    Adds ThingsBoard alongside ThingSpeak, selected by mqtt.backend. The
    broker connection is the same block — only the topic and the payload
    format differ: v1/devices/me/telemetry with a JSON object, against
    channels/<id>/publish with form-encoded fields. ThingsBoard authenticates
    with the device access token in mqtt.username and an empty password, and
    mqtt.useTLS=false selects a plain WiFiClient for a self-hosted broker on
    1883, since TLS costs 30-45 KB of heap for the handshake.
    This is the way out of the eight-field ceiling. That limit is why soil
    probes 2 and 3 are dashboard-only on ThingSpeak and why MOISTURE2_FIELD
    is still an open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
    [config.cpp, dev_server.py, mqtt.cpp, tasks.cpp, web.cpp]
2026-08-24 feat(webui): device management page
    Adds /devices.html: one row per sensor and actuator, with the name and the
    GPIO editable and a Test button that pulses a relay for three seconds.
    Built by a subagent against a written contract; I reviewed and corrected
    it before merging.
    The page deliberately does NOT offer Add/Delete. The number of relays and
    probes is fixed at compile time (RELAY_COUNT, MOISTURE_SENSOR_COUNT), so
    buttons implying otherwise would lie — it shows the compiled count and
    says a change needs a rebuild. It warns on an analog pin outside ADC1, a
    relay on an input-only pin, and duplicate pins, mirroring what
    validatePins() logs at boot.
    Fixes a real bug the subagent found whi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
    [config.cpp, devices.js]
2026-08-24 feat(io): flow meter, float switch, schedules, history time windows
    Four things, plus the compression that turned out to be required to fit
    them.
    FLOW METER (HAS_FLOW_SENSOR, GPIO 27). Pulse output counted by an
    IRAM_ATTR ISR that does nothing but increment; rate and totals are
    computed in the io task, because an ISR that allocates or takes a lock is
    how an ESP32 ends up in a reset loop. pulsesPerLitre is configuration,
    not a constant — it is the datasheet K factor and varies with model and
    plumbing. Reports litres/minute and a running total.
    FLOAT SWITCH (HAS_FLOAT_SWITCH, GPIO 26). A contact, not a level, so it
    reports Raised/Lowered rather than a number that would invite a chart of
    0s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
    [BuildConfig.h, dev_server.py, io_history.cpp, tasks.cpp]
2026-08-24 feat(webui): schedule editor, and a config backup that can be restored
    The schedules array was reachable only through the generic config editor,
    which renders a top-level array of objects as a read-only text field — so
    there was nowhere to edit a schedule. /schedules.html is the real page:
    enable, name, relay picker fed by /data.json's Relays array, time, seven
    day checkboxes, and duration in seconds because nobody schedules a pump in
    milliseconds.
    Add and Delete are real here, unlike the devices page: the schedule list
    is data, not a reflection of how many peripherals were compiled in. It
    refuses a duration outside 1-30 s, since startRelay() caps at 30 and a
    longer schedule would fire an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
2026-08-24 feat(thingsboard): remote commands and firmware updates over MQTT
    Adds the ThingsBoard downlink half, and splits the two files that had grown
    past 1000 lines while it was being written.
    ## Commands (RPC)
    Two-way RPC on v1/devices/me/rpc/request/+: getStatus, getRelays, startRelay,
    startWatering, stopRelay, getFirmware, checkFirmware, restart. Every one goes
    through the same startRelay() as the web UI, so the cloud gets no privileged
    path to the pumps — the 30 s ceiling, the range check and the already-running
    guard all still apply. startRelay() now returns bool so a refusal comes back
    as {"ok":false,"error":"..."} instead of silence, and stopRelay() is new.
    ## Firmware (FOTA)
    Assigned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
    [config.cpp, dev_server.py, fw_version.cpp, io_history.cpp]
2026-08-24 chore(version): 2.1.0, and drop a comment the refactor left stale
    FW_VERSION is what fwVersionDiffers() compares an offered package against and
    what the device publishes as current_fw_version, so it has to move before a
    ThingsBoard package can be a real update rather than a reflash loop. The
    device in the field is running 2.1.0's code as 2.0.0, which is exactly the
    state needed to test the download end to end.
    The g_scheduleLastFired comment still described the minute-of-epoch key the
    catch-up window replaced with a day-of-epoch one.
    [BuildConfig.h, tasks.cpp]
2026-08-24 feat(reservoir): interlock on the float switch, and flow in the history
    ## Interlock
    startRelay() now asks relayStartAllowed() before claiming the relay, and
    refuses a pump while the float reads empty. The check is in startRelay()
    rather than at the call sites because there are five paths to a pump — web
    /control, TalkBack, a schedule, a ThingsBoard RPC, checkMoisture — and the one
    that gets forgotten is the one that runs dry. All five now inherit it and all
    five get the same refusal back, which startRelay() returning bool made
    possible.
    io.floatSwitch.fillRelay names the relay that refills the reservoir and is
    exempt: blocking the only thing that fixes an empty tank would deadlock the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
    [config.cpp, dev_server.py, relays.cpp, tasks.cpp]
2026-08-24 docs: correct task periods and the numbers derived from them
    Audited the docs against the tree rather than against memory, and three task
    periods were wrong in both files: dht is 1 s (documented 10 s), mqtt is 1 min
    (documented 2 min) and talkBack is 1 min (documented 5 min). Everything
    derived from the publish period was wrong with them — the accumulator windows
    are 60 samples, not 120 and 12, and the in-RAM publish queue holds 60 messages
    an hour, not 30. A period is exactly the kind of number someone reads instead
    of measuring, so a wrong one is worse than no table.
    The history and schedules tasks were never in either table at all, and the
    scheduler-cap note still said 10 registered wh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
2026-08-24 feat(web): replace one file instead of rewriting the whole partition
    POST /spiffs/upload (ADMIN) writes a single file to SPIFFS. This exists
    because uploadfs and the filesystem OTA both overwrite /config.json with
    whatever the build directory held, which is how a device loses its WiFi and
    broker credentials over a one-line change to a stylesheet — it nearly cost
    this one its ThingsBoard token, and the only reason it did not is that a
    backup was taken first.
    The target path is the multipart filename, the same trick handleUpdateUpload
    uses to tell firmware from filesystem. Bytes land in /upload.tmp and are moved
    into place only after the whole body arrived and the MD5 matched, so a dropped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
    [dev_server.py, web.cpp, web_files.cpp]
2026-08-24 feat(moisture): a classifier trained on watering events, and no more build flags
    Two changes that turned out to be one. Making the peripheral set runtime-driven
    is what let the classifier know which pump feeds which probe.
    ## The classifier
    Gaussian naive Bayes, one Gaussian per class per probe, trained daily.
    Clustering the history does not work and this repository already proved it:
    the drying trend explains 86.4% of the variance and BIC on the residuals
    prefers k=2 with the second component at -24.5, which is a disconnected probe,
    not a soil state. The relay record is what changes the problem. A watering is
    an EVENT and an event is a label -- wet shortly after the pump runs, dry just
    b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
    [BuildConfig.h, check_lines.py, config.cpp, config_document.cpp, config_io.cpp, config_pins.cpp]
2026-08-24 fix(moisture): the review caught me violating my own documented trap
    Fifteen findings; these are the ones that were real, and the first is the one
    that matters.
    ## Reading accumulators from async_tcp
    handleMoistureJson called g_soilMoisture[p].getAverage() and getSamples() from
    the request handler. CLAUDE.md names this trap explicitly -- "Never read an
    accumulator from a request handler" -- and I did it anyway, three weeks of
    comments later. ESPAsyncWebServer runs handlers on async_tcp while the io task
    does push_back/pop_front on that std::list at 1 Hz; walking a list across a
    pop_front dereferences a freed node.
    /data.json avoids it with a cached string, but /moisture.json needs live
    va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
    [config_pins.cpp, dev_server.py, devices.js, devices_model.js, io_history.cpp, moisture_model.cpp]
2026-08-24 chore(version): 2.2.1, and record the OTA trap that cost an hour
    FW_VERSION moves so /data.json can tell the reviewed firmware from the one it
    replaced. The device now runs it, and the training pass ran with it.
    The trap: an OTA client that times out has NOT necessarily failed. A 1.2 MB
    upload takes minutes; the device writes, verifies the MD5 and reboots, and the
    HTTP connection the client was waiting on is long gone by then. Reading the
    version 30 seconds after arming reports the OLD firmware, because the old
    firmware is still the one running. I read that as a failed flash and spent an
    hour proving the binary was fine -- it was, and the flash had worked.
    Confirm by polling until the vers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
    [BuildConfig.h]
2026-08-24 feat(diagnostics): heap telemetry and the reset reason
    The board stopped responding while someone browsed and there was nothing to
    reason from: no heap number anywhere in the firmware, and every restart looked
    identical in the log whether it was a panic, a watchdog or a power cut.
    /data.json now carries Free Heap, Min Free Heap and Largest Block. Min Free is
    the one that matters — the spike that kills the device is over by the time
    anyone asks. Largest Block separates 'out of memory' from 'fragmented', which
    on a board running TLS plus Arduino_JSON payloads are different problems.
    Boot logs esp_reset_reason() by name and the free heap at boot.
    This is the gap the WSL survey named and I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
    [main.cpp, web_data.cpp]
2026-08-24 fix(sensors): the spinlock that panicked the board, and what the dump said
    The board hung while someone was browsing. The coredump partition had a real
    ELF in it:
    exccause 0x46 (InterruptWDTTimoutCPU1)
    Interrupt watchdog: interrupts masked too long on one core. I had written
    portENTER_CRITICAL(&g_moistureSnapshotMux);
    for (i) { snapshot[i].average = g_soilMoisture[i].getAverage(); ... }
    portEXIT_CRITICAL(...);
    and getAverage() walks the sample list TWICE -- once for the mean, once for the
    variance -- and writes a member on the way. Four probes at a 60-sample window is
    ~480 pointer-chased list nodes with interrupts off, each a potential cache miss
    that fetches from flash. CLAUDE.m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
    [sensors.cpp]
2026-08-24 feat(spiffs): per-file delete, and a fragmentation fix that measured worse
    ## Delete
    POST /spiffs/delete (ADMIN) removes one file, refusing exactly what the upload
    refuses: /users*, /sessions*, /config* and any path with "..". Nothing here may
    remove the file that lets you undo a mistake made here.
    It exists because a 48-byte test upload of mine sat on the filesystem with no
    way to remove it short of rewriting the whole partition — which is the
    operation the per-file upload was built to avoid. A path that is not there
    answers 404 rather than reporting success, so a wrong path is visible instead
    of leaving the caller wondering why the file is still served.
    Verified on the device: all fou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
    [web.cpp, web_files.cpp]
2026-08-24 perf(accumulator): fixed-size ring, O(1) average, and a test that counts allocations
    AccumulatorV2 was a std::list<float> doing a push_back and a pop_front on every
    sample, at 1 Hz, for the life of the device. CLAUDE.md carried that as an open
    contradiction of the "no dynamic allocation in steady state" rule for as long
    as nothing measured it.
    The second cost was worse and less obvious: getAverage() walked the list TWICE
    -- once for the mean, once for the variance -- so reading a channel was O(n) in
    pointer-chased heap nodes. Putting that call inside a spinlock is what panicked
    this board with an interrupt watchdog two commits ago. It is now O(1), which
    removes the class of mistake rather t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
    [accumulator_v2.cpp, runner.cpp]
2026-08-24 feat(moisture): weight each label by confidence, and report the watering response
    Two things the watering record was carrying that the model was throwing away.
    ## Confidence, not just a label
    gaussianAdd() has always taken a weight and every sample was fed at 1.0, so a
    reading taken at the instant the pump started counted as firmly "wet" as one
    taken twenty minutes later. Boundary samples are exactly what blurs the class
    means together, and blurred means are what fails the separation gate.
    - Wet ramps 0 -> full over 5 minutes. Soil does not become wet when a pump
    starts; for the first minutes the probe is still reading the old soil.
    - Dry ramps up as the next watering approaches: moistu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
    [moisture_model.cpp, web_moisture.cpp]
2026-08-24 chore(version): 2.3.0
    The confidence-weighted labelling and the watering response are on the device;
    FW_VERSION moves so /data.json can tell this build from the one before it, and
    so a ThingsBoard package would compare against something real.
    Verified after the flash: firmware 2.3.0, MQTT reconnected, heap 119 KB free
    with a 96 KB low-water and a 51 KB largest block, all assets serving, and the
    ThingsBoard token intact through the filesystem write.
    The model reports 'not trained yet' by design: MoistureProbeModel grew a
    response field, so the stored /moisture_model.bin failed its size check and was
    discarded rather than reinterpreted, and uploadfs reformatted the history ring
    along with th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
    [BuildConfig.h]
2026-08-24 docs: two operational rules this session paid for
    A filesystem deploy wipes the history ring and the moisture model along with
    the web assets — the whole partition is rewritten. That reset the
    watering-event counter three times in one day. Changed only files under data/?
    Use POST /spiffs/upload; the whole-image path is for when the firmware changed
    too.
    Keep the ELF of every flashed image. A core dump only decodes against the exact
    binary that produced it — a rebuild from identical sources does not match,
    because the app image embeds its own hash — and without it espcoredump refuses
    and the backtrace is nonsense. backups/elf/ holds one per version.
2026-08-24 feat(telemetry): relays as events, not samples
    You were right that sampling loses events. The payload read relayIsOn() once a
    minute, so a five-second watering was invisible: the sample landed between the
    events. The history record fixed this with a sticky mask long ago and the
    telemetry never got it.
    Three things now, and they answer different questions:
    - An EVENT the moment a relay starts, stops or is REFUSED, published through
    the outbox tbLoop() already drains every loop() iteration — milliseconds, not
    a minute. A refusal is an event in its own right: "the pump was asked to run
    and did not" is exactly what an operator needs, and it existed only as a log
    line on a device nobo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
    [BuildConfig.h, main.cpp, relays.cpp, tasks.cpp, tasks.h, telemetry.cpp, thingsboard.cpp]
2026-08-24 docs: drop the prototype snapshots, document the file endpoints
    The two phone photos of the breadboard showed a tangle of jumper wires and
    told a reader nothing they could act on. Gone. The UI screenshot stayed but
    moved next to the page table, where it illustrates what the table describes
    instead of sitting in a gallery at the bottom. The image files are still in
    docs/ — only the references were removed, which is the reversible half.
    POST /spiffs/upload and /spiffs/delete had no README entry, and the upload is
    the answer to the question this session kept paying for: how to change a
    stylesheet without losing the device's credentials, its 24 h of history and its
    watering-event count. A fil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
2026-08-24 fix(concurrency): the event work introduced three races; the review found them
    Fourteen findings, twelve of them real and most of them mine from adding relay
    events. Three could corrupt the heap.
    ## The races
    g_outbox is a std::vector with three producers on two tasks — tbLoop() and the
    PubSubClient callback on loop(), and relay/reservoir events on the io task —
    while tbLoop() erases from the front. A push_back that reallocates during an
    erase corrupts the heap or double-frees a String, surfacing as a panic with no
    relation to the request that caused it. It has a mutex now, and the header no
    longer claims safety it did not have. A FreeRTOS mutex and not a spinlock:
    push_back allocates.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
    [BuildConfig.h, config_document.cpp, config_io.cpp, dev_server.py, moisture_model.cpp, mqtt.cpp, relays.cpp]
2026-08-24 fix(history): limit=200 answered 200 OK with zero bytes
    The history page requests /history.json?limit=200 on every load. With 548
    records stored it got a Content-Length of ZERO and rendered nothing — silently,
    because the status was 200.
    ~35 KB of String plus the ~35 KB copy beginResponse makes do not fit beside a
    53 KB largest free block. This is the peak I identified two commits ago,
    measured, and then set aside: I wrote "the double copy costs PEAK; the stream
    costs FRAGMENTATION, and fragmentation is what bites a device that must stay up
    for months" and chose fragmentation. The reasoning was right and the conclusion
    was wrong, because I never tested the peak at the configuration the pa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
    [BuildConfig.h, web.cpp]
2026-08-25 feat(fs): move from SPIFFS to LittleFS behind a single FILESYSTEM name
    SPIFFS is in maintenance mode, has no power-loss guarantee, and degrades
    sharply past ~75 % full. This partition was at 72 % and this board prints
    `flash read err, 1000` on the first flash read of every boot before the RTC
    watchdog restarts it — a marginal supply writing a history record every 60 s
    and rotating a log every hour is exactly the combination SPIFFS loses. A
    corrupted SPIFFS then meets `begin(true)`, which FORMATS, taking /config.json
    and the WiFi credentials on a device that can no longer be reached to fix it.
    Every source now says FILESYSTEM; only include/core/filesystem.h says
    LittleFS. That is what make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
    [BuildConfig.h, config.cpp, custom_login.cpp, dev_server.py, io_history.cpp]
2026-08-25 feat(moisture): weight wet samples by a measured absorption curve, not a guess
    Water reaching a probe is diffusion through soil, and how long it takes depends
    on the soil, the pot and how well the probe touches either. g_absorptionLagSec
    treated it as five minutes for every probe on the board — one guess, applied
    four times.
    Modelled as first order, the reading approaches its new level as
    m(t) = baseline + rise * (1 - e^-(t-T)/tau), and tau is now estimated per probe
    from its own rises at the 63.2 % crossing, interpolated between the straddling
    samples. moistureAbsorptionConfidence(dt, tau) then IS the weight a wet-window
    sample carries, so a fast probe reaches full confidence in three mi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
2026-08-25 docs: the history ring is incompatible with LittleFS, and why
    IoHistory::append() panicked the board every 60 s under LittleFS -- three
    consecutive IntegerDivideByZero panics in lfs_alloc, 73-76 s apart, reached
    through the close() at io_history.cpp:178.
    Measured what is NOT wrong before blaming anything: a 1256-byte config save
    allocates and commits, 4 KB and 69 KB sequential uploads read back
    byte-identical, and the image superblock is correct. What fails is the access
    pattern. LittleFS stores data as a copy-on-write CTZ skip-list built for
    appending, so rewriting 48 bytes near the START of the 69 KB ring copies the
    chain forward -- the whole file, once a minute.
    Fatal twice: it crashed,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
2026-08-25 fix: the defects the review found in the LittleFS and absorption work
    CI first, because it was broken for every push: `board_build.filesystem`
    renamed the artefact to littlefs.bin and the release step still copied
    spiffs.bin, so all five matrix jobs failed at the artifact stage and tagged
    releases would have published no filesystem image at all.
    **The absorption estimator never measured anything in the case it was written
    for.** accumulate() skipped every record at or before consumedFrom, so
    lastValue was never set for them. With one watering a day and a daily training
    run the window is (C_prev, C_new), the only watering edge inside it is C_prev
    at the very first record, and its baseline si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
    [config.cpp, dev_server.py, main.cpp, moisture_classifier.cpp, moisture_model.cpp, sim_moisture.py]
2026-08-25 fix(history): append-only segments, because in-place writes are fatal on LittleFS
    The ring rewrote 48 bytes in the middle of a 69 KB file every 60 s. That is one
    256-byte page on SPIFFS and the whole file on LittleFS, which stores data as a
    copy-on-write CTZ skip-list built for appending. On device 9e7c it divided by
    zero inside lfs_alloc and panicked the board every 75 s, from the first history
    write after every boot; even had it not crashed, ~100 MB of flash writes a day
    on blocks rated for 100k erases would have destroyed the partition in weeks
    while appearing to work.
    Records now go to the END of the newest of eight segment files, and when it
    fills the oldest is truncated and reused. No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
    [io_history.cpp, main.cpp, runner.cpp, sim_state.py, tasks.cpp, tasks.h]
2026-08-25 fix(history): drop the legacy ring even when history is disabled
    begin() returned at the capacity check before reaching the removal, so a device
    that had turned history OFF kept the 69 KB file forever — which is exactly the
    device that turned it off, because the panicking ring is why it did.
    Also records what ran on the board. The append-only history survived the append
    that killed its predecessor: ten minutes of uptime where the old design panicked
    at ~60 s every boot, hist0.bin at 492 bytes (a 12-byte header plus exactly ten
    48-byte records), hist1..7 still absent, /history.json answering with records
    60 s apart, and the filesystem down from 392 to 332 KB as the legacy ring went.
    histor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
    [BuildConfig.h, io_history.cpp]
2026-08-25 fix(web): bundle and gzip the page assets, because requests are the scarce resource
    devices.html stopped loading with ERR_CONTENT_LENGTH_MISMATCH. Not a corrupt
    file: served one at a time every asset came back byte-identical. Under the six
    parallel requests a browser makes for one page, the largest contiguous free heap
    block collapsed from ~45 KB to as little as 1 KB and ESPAsyncWebServer truncated
    whichever response it was filling — so the victim changed on every reload.
    LittleFS pushed it over. Every open file carries a 4 KB cache where SPIFFS used
    256 B pages, so the 2.2.1 load test in CLAUDE.md — six parallel endpoints, zero
    failures, largest block never under 49 KB — does not car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
    [build_assets.py, pio_assets.py, web_files.cpp]
2026-08-25 fix(assets): make the asset build refuse what it cannot do exactly right
    Review of 908497b. The build was silently correct only for the markup that
    happens to be in the tree today.
    - `--out` erased its target with no containment check, and `--out DIR` is an
    advertised flag: `python scripts/build_assets.py --out data` would have
    recursively deleted data/, taking data/config.json — gitignored, holding a
    real device's Wi-Fi and broker credentials, unrecoverable from a masked GET.
    It now erases a directory only when every entry in it is a file this build
    would write anyway, so data/ refuses on the first plain source and the repo
    root on the first subdirectory. A marker file was tr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
    [build_assets.py, pio_assets.py, web.cpp, web_files.cpp]
2026-08-25 feat(mqtt): report the link, not just the switch
    Audit of the telemetry path. It is healthy — 18 packets in 18.9 minutes of
    uptime, exact 1/min cadence, no errors in the log, TLS on 8883 against a CA
    bundle that verifies the live chain — but it is healthy in a way the device
    cannot tell you about.
    /data.json reported `MQTT: enabled`, which is the operator's switch and says
    nothing about the broker link. That is precisely what made the 2023-2026 outage
    invisible: the dashboard said enabled for three years while the channel received
    nothing, and the only tell was `Packages Sent` staying at 0 — a counter that
    resets every boot, so on a device up for an hour it reads identically whether
    t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
    [mqtt.cpp, sim_state.py, telemetry.cpp, web_data.cpp]
2026-08-25 fix(mqtt): pin the roots the chain will end at, not only the one it does today
    thingsboard.cloud:8883 serves cert <- Let's Encrypt YR2 <- ISRG Root YR <- ISRG
    Root X1. It validated against the pinned X1 only through that last hop, a
    cross-signature that exists because the new root is not yet widely trusted and
    which goes away when it is. On the day it does, the chain ends at a root this
    device does not carry and MQTT stops — silently, in the exact way this channel
    already lost three years of data while /data.json reported "MQTT: enabled".
    Adds ISRG Root YR and YE (both self-signed, valid to 2045). They mirror X1 and
    X2: Let's Encrypt's gen-y hierarchy has an RSA root and an ECDSA one, and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
2026-08-25 docs: what firmware 2.6.1 proved on the device
    The CA bundle was uploaded BEFORE the OTA on purpose, so the reboot the update
    needs anyway became its test: the board came back with MQTT Link connected and
    a 31-second-old publish. That is the check that matters, because mqttSetup()
    reads the CA once at boot -- a bad bundle would have surfaced only at the next
    reset, silently, which is the failure mode this whole change exists to remove.
    Also verified: the superseded-twin deletion (logged four times by the device),
    the exact upload guard unblocking /config.* and /users.*, all nine pages serving
    gzipped at 4-5 requests with no truncation, and the history surviving the reboot
    at 1139/1440 recor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
2026-08-30 feat(moisture): make the probe's polarity and power the probe's own, not the board's
    Ready for a resistive sensor without another firmware round trip. Two things
    about a soil probe were compiled in, and a board can carry one of each.
    POLARITY. sensorsReadIo() did `100 - ADC_TO_PERCENT(...)` — one sign for every
    probe. It is right for the capacitive v2 modules these were built around, whose
    555 output falls as the soil wets, and backwards for a resistive divider, where
    wet soil conducts and the node rises. The classifier never cared: the two-point
    calibration and the ordering gate both accept either direction. What cared is
    the number on the dashboard and in the stored history, which would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
2026-08-30 docs: the probe polarity and power work is unverified until the sensors arrive
    The config parses, five envs build and the save/load round trip holds against
    the simulator, but no probe has been read with invert false and no power pin has
    ever been driven. The settle default of 10 ms comes from how a resistive divider
    and an LM393 behave, not from a measurement on the sensor that is coming.
2026-08-30 fix(moisture): close the holes the probe review found
    Twelve findings, all of them in the change from an hour ago.
    **The layout guard did not fire, and would not have.** sourceTag and
    sourceInvert both fit inside padding MoistureProbeModel already carried before
    its 8-byte-aligned GaussianStats array, so sizeof(MoistureModelState) did not
    move and moistureModelLoad() would have accepted a 2.6.1 file and read its old
    padding as the new fields — the exact "discarded on a layout change, not
    reinterpreted" contract the header claims. It survived only by accident: the
    padding is zero and probeTag("") happens to be non-zero, so the identity check
    caught it. The magic is now MOI2. The size check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
    [config.cpp, config_document.cpp, config_io.cpp, devices.js, devices_model.js, devices_render.js, moisture_model.cpp]
2026-08-30 feat(moisture): tell a disconnected probe from soil by its source impedance
    Three probes unplugged at once gave the measurement this needed. 200 history
    records over 4.3 h, and every obvious statistic fails:
    probe 0 mean 87.2 sd 4.37 median step 1.00 176 distinct values
    probe 1 mean 61.1 sd 2.65 median step 0.02 30 distinct values
    probe 2 mean 50.2 sd 1.29 median step 0.03 96 distinct values
    - Not the VALUE: all three sit mid-scale, as an earlier disconnected probe did
    at 52.6 and later at 86.7.
    - Not the VARIANCE: probe 2 is quieter than wet soil, and a disconnected probe
    has been measured at variance 0.01. "Too noisy" and "too quiet" are both
    wrong t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
    [probe_health.cpp, runner.cpp, sensors.cpp, sim_moisture.py]
2026-08-30 fix(moisture): the variance does separate, measured against a connected control
    I read the wrong statistic and reported the wrong conclusion. The history stores
    each minute's AVERAGE, and I computed the spread of those averages — which is
    precisely what averaging removes. On that number the probes looked quiet and I
    wrote that variance cannot separate a floating pin from soil.
    Sampled live instead, with the luminosity channel as a connected control on the
    same ADC at the same moment:
    Luminosidade (CONNECTED) var 0.02 sd 0.14
    Umidade 1 (floating) var ~800 sd 27.9
    Umidade 2 (floating) var ~1990 sd 44.6
    Umidade 3 (floating) var ~1980 sd 44.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
    [probe_health.cpp, sensors.cpp, sim_moisture.py, web_moisture.cpp]
2026-08-30 docs: separate the measured threshold from the guessed one
    The variance line has a control on the same ADC at the same moment and is
    calibrated; the coupling line does not and is a bound chosen to avoid false
    accusations. Calling both 'provisional' understated one and overstated the
    other.
2026-08-30 feat(web): flag a probe that is not measuring, on the page you actually look at
    The health verdict existed only in /moisture.json, which nobody opens until
    they already suspect something. The dashboard is where a dead probe should
    announce itself, so /data.json's Inputs entry now carries `fault` — noisy,
    floating, railed or stuck — and index.js renders it as a red badge beside the
    reading, with the reason in the tooltip.
    Sent ONLY when there is a fault, the same way `state` is absent rather than
    empty. A column that reads "connected" on every healthy probe trains the eye to
    skip the one case that matters, and the badge's presence is then the whole
    message. Red rather than amber: a probe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
    [sim_state.py, web_data.cpp]
2026-08-30 fix(moisture): quote the margin that was measured, not the one I hoped for
    The variance threshold works on the device — all three unplugged probes flagged
    within minutes, at 1113, 1773 and 1753 ADC counts, with every connected sensor
    clean. But the margin around it is narrower than I wrote, because a connected
    channel is not always quiet: the luminosity input sits at 6 counts at midday
    and reached 164 while the light was actually changing.
    worst CONNECTED observed 164 counts
    threshold 400 counts (2.4x above, 2.8x below)
    lowest FLOATING observed 1113 counts
    400 is close to the geometric mean of the two (428), which is where a one-sided
    threshold belongs w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
    [sensors.cpp]
2026-08-31 docs: the garden runs a DevKit v1 now, and swapping the board needed one field
    The NodeMCU-32S died. The replacement is an ESP32 DevKit v1 built by
    [env:espgarden2], device id 6224, and it took the dead board's entire
    configuration.
    No pin changes were needed, which is worth writing down before someone invents
    some: the two envs differ by exactly one line, board = nodemcu-32s against
    esp32doit-devkit-v1, and the -D ESPGARDENn flags they also carry are read by
    nothing in the tree. Same ESP32-WROOM-32, same 4 MB, same LED_BUILTIN. Every pin
    the config uses exists on both. GPIO 0 is off the header on a 30-pin DevKit v1
    and does not matter, because io.button is a pinMode(INPUT) nothing reads.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
2026-08-31 docs: the probe health thresholds have a connected control at last
    Two capacitive probes connected in wet soil and a third pin tied to 3V3, on
    device 6224:
    Zona 1 connected connected sd 40.5 coupling +0.0054 t +0.8
    Zona 2 pin tied to 3V3 RAILED sd 0.0 coupling 0.0000 t 0.0
    Zona 3 connected connected sd 60.4 coupling -0.0170 t -2.8
    That is the measurement the coupling threshold was missing. A healthy probe
    couples within ±1.7 %, so the 5 % line has about three times the headroom over
    the worst of them. It is deliberately NOT tightened: a resistive divider in dry
    soil is genuinely higher impedance than these capacitive modules, and the WD-3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
2026-08-31 fix(moisture): judge the jump between readings, not the spread of the level
    The operator lifted a healthy probe out of wet soil into the air and the
    detector called it noisy at sd 1889. It was measuring the spread of the LEVEL
    across a twenty-minute window, and the probe had genuinely gone 287 -> 4095
    counts inside it. That is a real change in a real quantity.
    Worse than a bad diagnosis on a hand-moved probe: a WATERING does the same
    thing more gently, so the most important event in the system was on course to
    look like a fault.
    What a floating pin actually does is swing between CONSECUTIVE conversions, and
    soil cannot, however fast it is watered. Switching the statistic to the
    sample-to-s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
    [BuildConfig.h, probe_health.cpp, sensors.cpp, sim_moisture.py, web_moisture.cpp]
2026-08-31 fix(moisture): flag a probe only when it is disconnected, and nothing else
    With two probes connected and a third pin tied to 3V3, the detector got two of
    three wrong:
    Umidade Zona 1 railed <- healthy, simply lifted out of the soil
    Umidade Zona 2 railed <- a real fault
    Umidade Zona 3 floating <- healthy, sitting in wet soil
    A capacitive module in air reads full scale and is genuinely indistinguishable
    from a pin shorted to 3V3 — there is nothing there for a statistic to separate.
    And the source-impedance regression, whose 5 % threshold I had already recorded
    as a bound with no healthy control behind it, crossed that line on a probe that
    was working.
    A detector that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
    [BuildConfig.h, probe_health.cpp, sensors.cpp, sim_moisture.py]
2026-08-31 fix(ota): a failed upload rebooted the board and then poisoned every retry
    Found while an operator was trying to flash from /update.html and getting
    ERR_CONNECTION_RESET on every attempt. Three faults in one path.
    **It restarted on an upload that never finished.** handleUpdateRequest rebooted
    whenever Update.hasError() was false — and that is false when Update.begin() was
    never reached at all. So an upload that died partway landed there looking clean
    and reset the device on a half-written partition. The reset then killed the next
    attempt's connection, which is how one bad upload became a run of five
    `software (ESP.restart)` boots with the firmware unchanged. On an active-low
    relay board e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
    [BuildConfig.h, web_ota.cpp]
2026-08-31 fix(web): report what the device did, not what the upload returned
    An operator watched /update.html say "Upload failed: error" at 100 % three times
    while the firmware on the board had in fact changed. The page was believing the
    XHR, and a finished flash ends in a reboot that kills the connection the browser
    is still waiting on — so success and failure arrive identically.
    fullbot-firmware solved the server half the same way this repo now does
    (controller.needRestart consumed a second later from another task, rather than
    delay(500) + ESP.restart() inside the handler), but its page reports
    `errorThrown` just like ours did. The client half is new here.
    update.js reads the version before send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
    [dev_server.py, sim_state.py]
2026-08-31 fix(upload): log the size that arrived, not the space reserved for it
    The device announced a 5 KB asset as `receiving /update.js.gz (12288 B)`. The
    number printed was `incoming`, which the block-granularity space check rounds up
    to whole 4 KB LittleFS blocks plus a margin — correct for deciding whether the
    file fits, and a 2.4x overstatement of what is actually being received. A log
    line that overstates by that much is one somebody will eventually debug against.
    Also records 2.7.3 as verified: the OTA path and the honest upload report both
    went up through /update.html on device 6224, which is what the whole change was
    for. The three faults were only found because the page kept saying
    ERR_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
    [BuildConfig.h, web_files.cpp]
2026-09-01 docs: a slow OTA is self-inflicted, and this file said so once already
    The web UI pushes a 1.2 MB image in under a minute. A script here took ~7
    minutes for the same image and I was on the verge of writing that up as a defect
    in ESPAsyncWebServer's multipart parser. It was that script's own wait loop from
    an earlier run, still logging in every 5 s while the upload was in flight: the
    board serves HTTP from one async_tcp task, so anything polled during an upload
    competes with it, and kMaxSessions is 4, so a loop that authenticates evicts
    whoever is using the browser as well.
    This file already recorded the same trap under the filesystem upload. Recording
    it again, next to the OTA section where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
2026-09-03 chore: keep the ThingsBoard read credential out of git
    Untracked is not protection: one careless stage publishes it to a remote. The
    trailing-newline guard is there because appending to this file without one
    already produced `include/config.backup.hbackups/` once, silently un-ignoring
    a directory of plaintext credential exports.
2026-09-03 feat(scripts): archive ThingsBoard telemetry to SQLite
    The free tenant ages telemetry out and the device publishes ~1400 points
    per key per day, so the only durable copy of what the garden measured has
    to be one we hold. tb_export.py pulls it into backups/telemetry.sqlite and
    exports a wide CSV from there.
    Incremental by default: per key it resumes from MAX(ts) + 1, and every
    insert is INSERT OR IGNORE against PRIMARY KEY(key, ts), so a re-run adds
    only what arrived. Values stay TEXT because several keys are genuinely not
    numbers -- bootReason, relayName, firmware, moisture1State, relayNEvent --
    and casting is the caller's business at export time.
    The page cap was measured, not read off a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
2026-09-03 fix(gitignore): three of five deploy rules matched nothing
    Git has no inline comments in a .gitignore — `#` only starts a comment at the
    start of a line — so every pattern in deploy/.gitignore carried its own
    explanation as part of the pattern and matched nothing. `git check-ignore -v`
    confirms traefik/dynamic/, .tb-installed-version and *.pem were unprotected:
    `./tbctl ca-export` and `./tbctl install` drop a CA pem and a state file
    straight into an unignored tree. .env and backups/ looked covered but were
    caught by the root file, so deleting either root line on the reasonable
    grounds that deploy/ already handled it would have unprotected the secrets.
    The credential patterns are widened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
2026-09-03 feat(telemetry): publish step values on change, and both the mean and the instant
    Every ThingsBoard key was restated once a minute whether or not it had
    moved, and a value re-sent unchanged carries no information. Relay state,
    the sticky masks, the counters, the flow totals and the reservoir contact
    now leave through tbPublishEvent() the moment they change -- milliseconds
    rather than up to a whole period late -- with mqtt.heartbeatSec (default
    900) as the floor under a key that never moves, so an operator reading
    "latest" can still tell a stable value from a dead device. Floats are
    compared against a deadband and never with !=, because two doubles holding
    the same measurement differ in their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
2026-09-03 fix(sim): mirror the two new mqtt keys into the simulator
    CLAUDE.md calls the simulator a second implementation of the device's HTTP
    contract: a key that exists in config.template.json and not here means the
    config editor is exercised against a document the firmware would not produce.
    mqtt.publishSec and mqtt.heartbeatSec landed in 968f6e0 without this half.
    [sim_config.py]
2026-09-03 docs: 2.8.0 ran, so it moves up — and the client called it a failure again
    Verified on 6224 over the air: publishSec 300 gives publishes 300 s apart, the
    six Now twins reach the cloud beside averages that kept their meaning, and the
    nine step keys appear only on the 900 s heartbeat. 12 x 288 + 9 x 96 is about
    4320 datapoints/day against the 25100 measured on 2.7.3.
    What stays unverified is now smaller and named: no relay has been switched
    since the flash, so the change-driven half of step publishing has never fired
    — the heartbeat is a different path. Both probes are healthy, so moistureNFault
    is unseen. And the DHT gate would not have rejected the 45.04 C reading that
    prompted it, whic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
2026-09-03 feat(control): a running relay's button stops it
    There was no way to interrupt a pump from the dashboard: /control only ever
    called startRelay(), so an activation ran to its ceiling whatever happened in
    front of it. The button for a running relay now turns danger-red, reads "Stop
    <name> — Ns" and posts the stop.
    The stop is an explicit `relayStop` parameter rather than a zero `relayTime`.
    String::toInt() answers 0 for anything it cannot parse, so a zero-means-stop
    spelling would let a malformed field silently shut a pump down, and the
    handler could not tell the two commands apart.
    No confirmation dialog on the stop. Stopping is the safe direction, and a
    dialog between a person and a runn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
2026-09-03 docs: relayStop is simulator-verified, not device-verified
    The contract round-trips against dev_server: started for 20 s, stopped on
    demand, and a repeated stop on an idle relay accepted rather than refused.
    The firmware's own stopRelay() path has not been reached from /control,
    because doing so means energising one of three wired pumps — the relay 4 that
    used to be the test slot left the config on 2026-09-02.
2026-09-03 feat(scripts): a local browser for the telemetry archive
    tb_export.py --stats answers one question -- how much is stored. The ones
    actually asked of a field device's archive are pictures: what did moisture2 do
    last week, which keys STOPPED arriving, how often did the board reboot, where
    are the holes.
    scripts/telemetry_ui.py serves those on :8090 (not dev_server.py's 8080, so both
    run at once), stdlib only, read-only on the archive -- mode=ro plus query_only,
    because a browser refresh is not a reason to risk the record of everything the
    garden has measured. The page is split into telemetry_page.py for the reason
    check_lines.py gives for every other split here.
    Four things it refuses to do,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
    [telemetry_page.py, telemetry_ui.py]
2026-09-03 feat(telemetry-ui): remember the view across a reload
    View, window, key selection, gap threshold and sort survive a refresh in
    localStorage. The URL still wins whenever it carries any of them: a link
    saying ?win=30d&keys=temperature is someone saying "look at THIS", and
    restoring the reader's own last window over it would answer a different
    question than the one they were sent.
    Every localStorage touch is wrapped: private windows and blocked site-data
    throw on access, not merely return null, so this has to be caught rather than
    tested for. A failure there is not worth failing a render over.
    [telemetry_page.py]
2026-09-03 feat(cloud): read cloud cover from the light sensor's own clear-sky envelope
    A clearness index k = measured / clearSkyReference(time of day) becomes
    clear / partly cloudy / overcast, and how far k moves from minute to minute
    opens and closes a cloud-transient EPISODE on the event path. The reference
    is empirical, fitted by scripts/cloud_fit.py from backups/telemetry.sqlite
    into include/core/clear_sky_table.h: 144 ten-minute bins holding the 98th
    percentile of everything measured in each, 288 bytes of flash.
    It is empirical rather than astronomical because this sensor peaks near
    15:00 local, three hours after solar noon, and its 07:00 reference is a
    fifth of its 15:00 one. Solar geometry wou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
2026-09-04 feat(telemetry): publish each channel's spread as an error bar
    A standard deviation, not the variance the accumulator stores: an error bar is
    drawn in the measurement's own units, and units-squared does not overlay a
    chart.
    The archive could not answer "had this reading settled?". A probe calibration
    tonight had to be run by polling the live device every 30 s, because every
    stored number was a mean with no spread beside it — and nothing already past
    could be re-examined at all. A mean of 74.0 at sd 0.05 and a mean of 74.0 at
    sd 30 are different claims.
    Not to be confused with cloudVariability, which is a normalised sample-to-
    sample step. This is the spread of the level. Over 5-minute wi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
    [BuildConfig.h, telemetry.cpp]
2026-09-04 fix(dht): the 20% humidity floor would have discarded real data
    This garden is in Brasilia, where the dry season takes the afternoon below
    20% RH as a matter of course. Measured in the archive: 261 points (2.0%)
    under the floor, minimum 15.00, concentrated on the two driest days of the
    record — exactly the afternoons a garden most needs a reading.
    The gate was built from the DHT11's rated range on the reasoning that it
    would mean "the sensor cannot have measured this". A rated range describes
    ACCURACY. Outside it a reading is less trustworthy, not impossible, and
    clamping to it throws away the true extremes. The floor is now 5%, below
    anything ever recorded on earth, so it catches garbage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
    [BuildConfig.h, config.cpp, sensors.cpp, sim_config.py]
2026-09-04 docs: the OTA reboot is six seconds, and the client bug was mine
    Measured with absolute timestamps: upload complete 22:33:13, board down
    22:33:17, serving again 22:33:19, uptime 6 s. Three OTAs tonight reported
    failure while the flash had landed.
    handleUpdateRequest answers 200 and only then calls requestRestart(), which
    reboots ~500 ms later from loop(). The client's first liveness probe therefore
    caught the OLD firmware still serving, the wait loop never ran an iteration,
    and the second probe caught the reboot. The two calls straddled it.
    This retracts the intermediate diagnosis recorded earlier tonight, that the
    board was taking five minutes to return. That assumed a loop which had run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
2026-09-04 feat(et0): a daily evapotranspiration estimate, and the fit that says not to trust it
    Hargreaves-Samani ET0 from the device's own daily temperature extremes, with
    extraterrestrial radiation as a closed form in latitude and day of year, so the
    firmware never calls a weather API. The maths is pure and host-tested; the
    Arduino half owns the local clock, the day rollover and the snapshot.
    scripts/et0_fit.py is the off-device counterpart: it geocodes the device's
    postalCode, pulls the public daily record for that spot and scores the estimate
    against a station's FAO-56 Penman-Monteith. Run against this garden it answered
    three things, in this order:
    - 2.4 mm of rain in eleven days, one day reach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
2026-09-04 feat(moisture): fit the parameters on the PC, and refuse to invent any
    The device holds 24 h of history and trains inside a cooperative background
    task; the archive here holds every point it has ever published. So the
    expensive half moves to the workstation and the board keeps the incremental
    half it is good at — moistureModelTrain() still decays and folds, so a seed
    ages out rather than freezing anything.
    scripts/moisture_fit.py reads backups/telemetry.sqlite and GET /config.json,
    and proposes moisture[i].dry/.wet as JSON in a dry run. scripts/moisture_stats.py
    holds the arithmetic, split at the 1000-line gate along the same seam as
    telemetry_ui.py + telemetry_page.py.
    Run against the l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
2026-09-04 docs: the resistive probes have a measured curve, and Zona 1 a calibration
    Five conditions measured by hand and converted to raw ADC. Four are monotonic
    in the direction physics predicts — wetter reads lower — which confirms
    invert:true for these probes at both ends of SOIL rather than by inference
    from air and water, where an earlier reading of the same question flip-flopped
    twice.
    The "air" point turned out not to be an anchor at all: the probe was still
    damp and it lands between wet and dry soil, exactly where a drying probe
    should. That makes it a consistency check. Submersion is the lone outlier and
    is excluded by irrelevance rather than explained away — soil is never
    submerged i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
2026-09-04 feat(auth): one user on several devices, and revoke on a password change
    Ordinary sessions were always multi-device; the remembered one was not.
    handleLogin() deactivated every other persistent session of the same user,
    so "remember me" on a phone silently un-remembered a laptop. That eviction
    is gone and kMaxSessions goes 4 -> 8, because four slots shared across every
    account runs out at two people with two devices each — and a script that
    authenticates in a loop then evicts whoever is using the browser, which this
    repo has already paid for once during an OTA.
    The eviction was also doing security work nothing else did. invalidateAllSessions()
    was called from exactly one place, the user D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
2026-09-04 fix(auth): a remembered token was resurrectable, unbounded and immortal
    Five defects from a review of c35655a, all in the session table that commit
    opened up.
    An evicted persistent token came back to life. handleLogin() overwrites the
    token of whatever slot it is given, but /sessions.json was rewritten only when
    the NEW login was itself remember=true. A plain login that displaced a
    remembered slot therefore left the dead token on flash, loadPersistentSessions()
    restored it active, and nothing expired it. The file is now rewritten whenever a
    remembered token is created OR destroyed.
    Nothing bounded persistent sessions once the per-user eviction was removed, and
    they are exempt from the idle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
    [BuildConfig.h, custom_login.cpp, dev_server.py, runner.cpp, sim_auth.py, sim_config.py]
2026-09-04 feat(scripts): fit the drying curve, and refuse the asymptote it cannot pin
    The soil drying trace does look like a decay, and if it decays towards an
    asymptote then fitting it estimates the `dry` anchor without waiting for a zone
    to dry out - which is the blocker this project is stuck on, since the anchor on
    record is an upper bound taken by carrying a probe into a different pot.
    drying_fit.py + drying_models.py ask, off the archive, with the same shape as
    moisture_fit.py + moisture_stats.py: statistics on one side, the archive and
    the report on the other, standard library only, read-only on the database.
    Ten genuine drying segments were isolated, 8.0 to 61.4 h. All ten were refused
    an asy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
    [drying_fit.py, drying_models.py]
2026-09-04 fix(drying): the stated autocorrelation range was narrower than the tool's own
    The docstring claimed "measured here, lag-1 rho of 0.92 to 0.99". Running
    drying_fit.py over the current archive gives 0.53, 0.85, 0.85, 0.88, 0.97,
    0.98 across its eight segments — the low end is nearly half the stated floor.
    A range that the tool contradicts on its first run is worse than no range.
    Replaced with what a run actually produces, and anchored on one concrete
    segment rather than a span: 737 samples at rho 0.969 is n_eff 11.6, which is
    the number that makes the point about BIC counting 737 where there are twelve.
    Found because a compaction pass refused to copy figures it could not locate in
    any fil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
    [drying_models.py]
2026-09-04 fix(auth): a config restore could promote an operator, and every request wrote flash
    Four review findings, two of them running on the board.
    UserStore::upsert() writes the whole entry, so handleConfigPost's hardcoded
    Role::ADMIN meant a POST /config.json naming an existing OPERATOR in
    ota.username, with a changed password, silently promoted that account. Only an
    ADMIN reaches that endpoint and an ADMIN can already promote through POST
    /users, so this was never a path to privilege — what it lost was that
    endpoint's role validation and last-admin guard, and the visibility, since the
    response says only "saved". The realistic failure is an admin promoting
    somebody by accident while restoring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
    [BuildConfig.h, config.js, custom_login.cpp, dev_server.py, sim_auth.py, sim_config.py]
2026-09-04 fix(drying): the fit sorted its taus and left the coefficients behind
    Two bugs corrupted the model comparison the tool's conclusions rest on,
    both confirmed by running it.
    fit() returned sorted(taus) beside coefficients fitted against the
    UNSORTED order. The refinement loop walks taus[0] past taus[1], after
    which sorting re-pairs every amplitude with the wrong exponential:
    predict() draws a curve the fit never saw while sse describes one no
    longer reachable. residuals(), criteria(), holdout(), choose() and
    block_bootstrap() all read the wrong one. Measured, one exp2 fit stored
    sse 0.361 while predict() gave 10 618. Taus and amplitudes now sort
    together.
    profile_asymptote() fitted level + a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
    [drying_evidence.py, drying_fit.py, drying_models.py]
2026-09-04 docs(telemetry): the publish path's String churn is three 16-byte blocks
    The claim was about twenty String allocations per periodic publish, and it
    had never been measured. It is three, because Arduino's ESP32 String keeps
    up to 13 characters inside the object and every telemetry key is 14 or
    fewer -- so only temperatureNow, airHumidityNow and moisture1State spend a
    heap byte, one 16-byte block each.
    Measured by replaying buildThingsBoardPayload()'s statement sequence on the
    host against the real WString.cpp and the real Arduino_JSON, with malloc,
    realloc, free, calloc wrapped and operator new replaced: 87 heap operations
    and 5131 bytes per publish, of which the keys are 3.4 % and 0.9 %. Th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
2026-09-04 feat(scripts): test the temperature confound, and gate on it rather than correct
    These probes are resistive and soil conduction is ionic, so warmer soil should
    read wetter - a falsifiable +0.37 to +0.50 points/K of SOIL temperature, and a
    positive sign. The archive was asked and cannot answer.
    Overnight, the natural experiment, air temperature IS elapsed time: r(T, t)
    runs -0.81 to -0.97 across the ten nights, so all four in-soil probe-nights are
    refused on collinearity alone. Longer windows are identified and are killed by
    a placebo instead - the same window against ANOTHER DAY's temperature at the
    same clock time explains as much on 6 of 7 and 8 of 8 shifts. The default run
    produces 2 coe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
    [moisture_fit.py, moisture_stats.py, moisture_thermal.py, moisture_thermal_report.py]
2026-09-04 feat(build): put ThingSpeak and TalkBack behind flags, both off
    USE_THINGSPEAK is new and ships at 0. USE_TALKBACK already existed at 1
    and was honoured at exactly ZERO call sites -- the task was declared,
    registered, enabled and polling whatever it said. A flag read nowhere is
    worse than no flag: it reads as "the feature is off" while the socket
    opens once a minute anyway. Every site is now behind it, registration
    included, because a no-op task still takes one of the 16 slots in its
    bucket and addTask() past the cap drops silently.
    Turning TalkBack off is a security fix, not a flash saving. talkback.cpp
    speaks plain HTTP/1.1 on port 80 with the API key in the request body and
    carried a sta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
    [BuildConfig.h, config.cpp, mqtt.cpp, sim_state.py, talkback.cpp]
2026-09-04 feat(history): raise the record cap to 5000, and measure whether it fits
    The static ceiling on history.records goes 2500 -> 5000, which is what the
    RECORD costs: 256 KB of segment files once every segment has filled, LittleFS's
    4 KB blocks included. That ceiling has been 20000, 6000, 5000 and 2500, and
    every one of those moves was somebody re-deriving one device's free space by
    hand and writing the answer down as a constant -- necessarily wrong for every
    other device, and stale on that one after the next deploy.
    So the ceiling keeps only the question it can answer, and a runtime check
    answers the other. ioHistoryFitCapacity() runs at config load, adds the bytes
    the current segments hold bac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
    [BuildConfig.h, config.cpp, io_history.cpp, sim_state.py, web_data.cpp]
2026-09-04 feat(board): add the ESP32-S3 esp-garden-hardware carrier
    The first board here that is not an ESP32-WROOM-32. src/config_pins.cpp
    encoded one chip's rules as if they were the rules, and booting an S3
    against them produced a page of errors about correct assignments and
    silence about wrong ones.
    The rules move to include/core/pin_rules.h, Arduino-free, one namespace
    per family and both always compiled so test_pin_rules can hold both to
    their answers in one host binary. config_pins.cpp is now only the seam
    that picks one, from CONFIG_IDF_TARGET_*, which the framework sets from
    the env's `board` line -- so platformio.ini still carries no hardware
    flags and the family cannot drift from the toolc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
    [esp_garden_8mb.csv]
2026-09-04 docs: compact the operating guide back to 997 lines
    Nine commits since the last compaction took CLAUDE.md from 926 to 1135
    lines, mostly because the material they added was written at full length:
    the S3 board, the history fit check, the ThingSpeak/TalkBack flags, the
    String-churn measurement, the thermal confound and the drying-fit audit.
    This compresses the narrative around them and leaves the traps at strength.
    - Every section survives; all 15 internal anchors resolve.
    - The verified / unverified split is untouched. Nothing moved up, no caveat
    was softened, and the three "evidence about the simulator, not about the
    firmware" distinctions are preserved verbatim.
    - 30 load-bearing trap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
2026-09-04 docs: say where the 8289-byte log figure came from
    The compaction carried it in as "measured on the live device" because I
    asserted it, and the agent flagged that it could not verify the number from
    anything in the repo. It is real — all five files fetched over /spiffs/ on
    6224 today — but a document whose central rule is that a number has an
    execution behind it should say which execution.
2026-09-04 fix: correct the record-cost figures and guard the S3 filesystem image
    Seven review findings. None changes firmware behaviour, so FW_VERSION is
    untouched; two of them are wrong numbers in records people re-derive from and
    one was a foot-gun that only a local build could reach.
    The 5000-record ceiling comment in config.cpp said 235 KB beside the formula
    that gives 256 KB -- the unrounded figure next to the rounding that corrects
    it. storageBytes(5000, 12, 48) is 262 144, which test_segment_index has
    asserted all along and which README.md already said.
    partitions/esp_garden_8mb.csv argued its 2.375 MB filesystem was generous from
    a cap of 2500 records (~120 KB) that 3230d96 had raised to 500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
    [esp_garden_8mb.csv]
2026-09-04 docs: the S3 provisioning split has a refusal now, and it has run
    The unverified list said "the CI provisioning split is untested -- `-t buildfs`
    ran locally against the existing data/config.json". That sentence described the
    defect rather than a test: packing the WROOM-32 document into an S3 image was
    what the local build DID, silently, because templates/config.espgarden_s3.json
    was wired up only in CI.
    0786248 put config_guard() in scripts/pio_assets.py, and the refusal half is
    now executed: refused in 0.54 s naming ten foreign pins on this tree, while
    `espgarden2 -t buildfs` still succeeded. The accept half is not -- nothing has
    put that template in data/config.json and packed it, and th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
2026-09-04 fix(config): give every compiled pin default a family, and fit the history on a failed load
    Seven review findings. Two change what a board does at boot and one re-enables a
    check that was compiled past; FW_VERSION goes to 2.13.1 in the same commit.
    6387c46 made g_defaultRelayPin per-family because "a table from the wrong chip
    drives whatever else is on those numbers", and did not carry that to dhtPin,
    flowPin and floatPin, which stayed at the WROOM-32's 23, 27 and 26. On an S3,
    pin_rules::esp32s3::isFlash(27) and isFlash(26) are both true -- SPI_HD and
    SPI_CS1, the octal flash/PSRAM bus -- and isBonded(23) is false. loadSensor()
    only overwrites a pin when the entry carries a "pin" key, so
    "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
    [BuildConfig.h, config.cpp, config_pins.cpp, default_pins.h, io_history.cpp, mqtt.cpp, test_pin_rules.cpp]
2026-09-11 feat(history): a relay bar says when it ran, and what that time means
    Hovering a run on the relay strip gives its record span. It reports a SPAN OF
    RECORDS rather than a switch-on and switch-off time, because the record does
    not carry one: relayMask is the sticky take OR'd with the live state, so a set
    bit means "ran at some point in this period" and a five-second watering draws
    a bar one whole record wide. Saying "on from 14:03 to 14:05" would invent
    precision the buffer never had; the real edges and durations are in the
    relayNEvent stream. The header comment claiming "set while relay i is
    energised" described the instantaneous reading this field stopped being.
    Also moves two entries up th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
2026-09-16 fix(clock): a slow WiFi boot left the device at 1970 for a day
    Measured on 6224 today: Date/Time 1970-01-01, Internet online, MQTT connected,
    209 packages published — and no clock for 17.6 hours. The history and schedule
    tasks both refuse an unsynced clock, so nothing was recorded that whole time.
    The chain. WiFi took 50 s to associate; the internet budget is counted from
    the start of tasksSetup() rather than from association, so 10 s of it were
    left and checkInternet's 15 s tick missed the window by seconds. The clock
    wait then ran 30 times in 60 s and every one returned at `if (!g_hasInternet)`
    — above the line that shortens the retry to a minute, whose own comment says
    it exists so "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
    [BuildConfig.h, tasks.cpp]
2026-09-16 fix(relays): watering counters only ever saw relay 0
    Reported after a 10 s run of Zona 3 through a ThingsBoard RPC left
    wateringCycles at 0 and published no wateringMs. The RPC was fine; the gate in
    relayStartedHook was `if (index != 0) return`, the single-relay contract from
    when relay 0 WAS the watering relay. On a three-zone board that counts one zone
    and ignores the others.
    A relay now IRRIGATES when some probe names it in moisture[i].relay — the same
    config the classifier uses to label its training data, so there is no new key
    and no second place to keep in step, and the reservoir pump is excluded because
    no probe names it rather than because of its index.
    Two more defects behind th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
    [BuildConfig.h, tasks.cpp]
2026-09-16 fix(s3): the fourth probe pointed at the reservoir pump
    The carrier brings out four probes and four relays, but only three of those
    relays water a zone — the fourth is the reservoir fill. The template had
    moisture[3].relay = 3, which says "Umidade Zona 4 is watered by the
    Reservatorio".
    That was already wrong for the classifier, which would have labelled that
    probe's readings with tank refills, and it became worse with c2df3ad: a relay
    now counts as irrigation when some probe names it, so filling the tank would
    have incremented wateringCycles and published a wateringMs. -1 is the value
    the firmware already defines for a probe no pump feeds; such a probe gets no
    model and falls through to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
2026-09-16 fix(s3): the template pinned the wrong CA for its own backend
    data/thingspeak.pem holds ONE root — DigiCert Global Root G2, what
    mqtt3.thingspeak.com chains to. data/thingsboard.pem holds five — ISRG Root
    X1, X2, YR, YE and USERTrust ECC — and is what the live board uses against
    thingsboard.cloud:8883. The S3 template had backend "thingsboard" with cacert
    "/thingspeak.pem", so it would have presented DigiCert to validate a Let's
    Encrypt chain.
    That fails the way this repo has already paid for once: silently. Every
    connect returns -9984 and the dashboard still says MQTT enabled, which is how
    channel 1348790 received nothing between 2023-03-07 and 2026-08-19. On a brand
    new board nobody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
2026-09-16 feat(scripts): provision a board's config, refusing what would brick it
    The day a board arrives is the worst day to be editing JSON by hand, and every
    field this fills is one loadFile() rejects the WHOLE document over — which
    means compiled defaults, ssid "undefined", and a device that cannot associate
    or be reached to fix.
    So it refuses before writing, naming the check: a placeholder left in, any of
    the seven fields under four characters, a probe pointing past the relay array,
    and a CA that does not match the backend. That last one is not hypothetical —
    the S3 template shipped backend "thingsboard" with cacert "/thingspeak.pem"
    until a2adac2, which fails TLS silently, the way this repo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
    [provision_config.py]
2026-09-16 feat(sensors): read the SHT40 on I2C, behind the same two keys
    The esp-garden-hardware carrier dropped its DHT22 header for an SHT40, so
    that board read no temperature and no humidity at all. It now does.
    The two channels stay `temperature` and `airHumidity`, on the same
    accumulators and the same /data.json rows. Renumbering a relay index or
    moving `moisture2` to another pot gives one name two physical meanings; a
    better thermometer does not - same quantity, same units, so no stored
    series changes meaning and no chart breaks. What changes is accuracy, and
    that is published rather than left to be inferred: `ambient_sensor` as a
    ThingsBoard client attribute and Status."Ambient Sensor" in /dat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
2026-09-16 docs(tasks): track work in tasks-inbox and tasks-done
    Three parallel streams and a board in transit outgrew a backlog that lived
    only in conversation. One file per task, moved rather than deleted when it
    closes, so the reasoning survives with the commit.
    Deliberately NOT a copy of CLAUDE.md's "What has actually run": that list is
    claims waiting for evidence, this one is work waiting for a person, and a
    landing task usually ADDS an entry there rather than clearing one. Two lists
    saying the same thing is how this file has already been wrong three times.
2026-09-16 feat(onboarding): raise a setup AP on a board with no usable config
    An unconfigured board raises its own access point (SSID espgarden-<id>,
    password espgarden), serves a compiled setup page over a captive portal
    and writes its own /config.json from a board template. Everything else
    stays a /devices.html edit once the device is on the LAN.
    The id stops being the field that bricks a board: the firmware knows
    ESP.getEfuseMac() % 0x10000 and writes it itself.
    TWO ARMS, AND A MARKER FILE FOR THE SECOND. A mistyped Wi-Fi password
    produces a perfectly valid document, so loadFile() accepts it and the
    board is unreachable for ever -- association failure has to be able to
    reach the portal too. But "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
    [BuildConfig.h, dev_server.py, main.cpp, runner.cpp, sim_onboarding.py, tasks.cpp]
2026-09-16 feat(scripts): collect the device's own 60 s history into a durable archive
    tb_export.py archives ThingsBoard, which is the 300 s publish. The device's own
    record is GET /history.json at history.periodSec, and nothing has ever collected
    it — so the buffer recycles about every two days and that record is simply gone.
    Two questions CLAUDE.md states outright are blocked on it and on nothing else:
    seeding /moisture_model.bin, where MODEL_FILE_DECLINED names "fit from GET
    /history.json" as the fix, and the three-minute plateau of 2026-09-03 that sits
    below the 300 s sampling.
    The record identity is the record's own timestamp. historyTaskHandler() returns
    above the append while time(NULL) < g_s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
    [device_http.py, history_export.py, history_store.py]
2026-09-16 fix(sim): the history mock dropped one record where the device drops a segment
    The simulated buffer was a deque with maxlen, which evicts ONE record per
    append. The device recycles a whole SEGMENT: IoHistory::append() rotates when
    the newest segment fills, so retention swings between 7/8 and 8/8 of capacity
    and every logical index — which is what ?offset= addresses — moves down by 375
    in one step.
    The old comment called that "close enough for a frontend mock", and it was,
    right up until something had to PAGE this endpoint. An archiver that trusts an
    offset across a rotation loses a whole segment without noticing, and a mock that
    cannot produce that shape cannot catch it. CLAUDE.md alrea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
    [dev_server.py, sim_state.py]
2026-09-16 feat(scripts): fit the moisture model from the device's own 60 s record
    --history-db reads backups/history.sqlite instead of the 300 s ThingsBoard
    archive, and needs no device and no saved config: every collection session
    stamped the (index -> name, pin, relay) binding it was collected under, so a
    seam is a stated disagreement between two sessions rather than the inference
    usable_from() has to make from (relay, relayName) pairs. The rule stays blunt —
    the most recent seam of any kind bounds every probe — because the archive still
    cannot say which SLOT moved, only that the io block was edited.
    Everything downstream of the source is shared: the same analyse_probe, the same
    gates, the same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
    [moisture_fit.py, moisture_stats.py]
2026-09-16 docs: the 60 s record, and the MODEL_FILE_DECLINED reason that was wrong
    A new section under Soil moisture: what fitting from GET /history.json
    unblocked and what it did not. The verdict on seeding /moisture_model.bin has
    not moved and is still no — reason 1 binds, both probes have zero watering
    events on their own pump — but this file's own claim about reason 2 was a
    mis-statement of what the two series are, and that is corrected rather than
    quietly dropped.
    The ledger entry goes in the UNVERIFIED list. No C++ changed, nothing was
    flashed and not one byte reached 192.168.1.55: what ran is scripts/dev_server.py,
    which is evidence about the simulator. Named there: the request and byte co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
2026-09-16 fix(assets): a config-less image is the onboarding path, not an omission
    config_guard() refused an env whose data/config.json was MISSING, on the
    premise that the filesystem image must carry one. Since 2.15.0 that premise
    is false: the onboarding portal compiles its board templates into the
    firmware, so a virgin board with no document raises the espgarden-<id> setup
    AP and writes its own -- carrying the id it read from its own efuse, which is
    the single field that bricks a board when it is wrong.
    Refusing here is what made provisioning circular: the document needed the id,
    and reading the id needed the board flashed.
    The foreign-pin check is UNTOUCHED, and it is the half that was ever
    load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
    [pio_assets.py]
2026-09-16 docs: the first boot on ESP32-S3 silicon, and what it does not say
    Six items left the Unverified list because they ran: the 8 MB partition
    table, the efuse id on this family, ioHistoryFitCapacity() taking the
    proportional branch of its reserve for the first time, the onboarding
    portal's arm 1, the shortened tasksSetup(), and a 5 s boot where the
    normal path would have blocked for up to 120 s.
    Four did not, and are named: the AP has not been shown to broadcast or
    accept a client (this workstation has no WiFi radio), validatePins() still
    has not run on an S3 because no config loaded means no pins to audit, and
    nothing is wired to the module so no ADC, relay or I2C has been touched.
2026-09-16 feat(onboarding): show the passwords, and record the portal running on silicon
    The reveal control is one checkbox for both password fields. Typed on a
    phone next to the board, a mistyped Wi-Fi password is the one error the page
    cannot catch: the document is valid, the board accepts it, reboots, and only
    the provisioning marker keeps it reachable.
    Also keeps a null check on beginResponse() left over from a diagnostic
    session -- a panic on the portal is a board nobody can configure -- and
    withdraws three caveats from the entry written an hour earlier, including
    one that claimed this workstation had no WiFi radio because a command
    printed nothing.
    [web_onboarding.cpp]
2026-09-16 feat(web): name the board on the login screen
    There is more than one of these on a LAN now, and an operator reaching one
    by IP has nothing on screen to tell them apart. The login page runs before a
    session exists, so the answer has to be public -- and the hostname already
    is, because mDNS broadcasts it to the whole segment.
    The firmware version is deliberately NOT in the payload: it is a fingerprint
    for an unauthenticated reader and it is already on /data.json for anyone who
    has logged in.
    The page keeps a blank line when the fetch fails rather than showing an
    error. Not knowing the hostname must not look like not being able to sign
    in.
    [BuildConfig.h, dev_server.py, web.cpp]
2026-09-16 docs: the login-screen change ran on the board, and how the config POST is shaped
2026-09-16 fix(web): eleven review findings, one of them a guard this session weakened
    config_guard() was relaxed to allow a config-less filesystem image. That is
    right for buildfs and wrong for uploadfs/uploadfsota: data/config.json is
    gitignored, so absent is the normal state of a checkout and says nothing
    about the board on the cable -- and the deploy would have erased a
    provisioned board's config, history and moisture model, bringing it back
    raising the open setup AP. It now takes a deploying flag; all four paths
    exercised.
    Also: /device.json and the onboarding success body built with JSONVar rather
    than concatenation, because hostname and SSID are operator text checked only
    for length; /device.js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
    [BuildConfig.h, pio_assets.py, web.cpp, web_onboarding.cpp]
2026-09-17 fix(scripts): address the garden by its mDNS name, not a stale DHCP lease
    The first live run of history_export.py timed out at TCP connect against
    192.168.1.55, which this repo has given as the garden's address since the
    board swap. The board had moved to 192.168.1.242 and nothing anywhere said
    so: an address written down once and re-derived by nobody.
    DEFAULT_DEVICE in history_export.py and moisture_fit.py is now
    espgarden1.local. webSetup() registers mDNS as <hostname>.local, so the
    device publishes the name itself and it tracks the lease. Verified through
    Python's own resolver rather than assumed - socket.getaddrinfo answered
    192.168.1.242 in 0.148 s - because a default nobody tested is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
    [device_http.py, history_export.py, moisture_fit.py]
2026-09-17 docs: the 60 s archiver ran against the live garden, and the fit still refuses
    First live collection, 2026-09-17, device 6224 on firmware 2.13.3: 2787 of
    3000 records in 19 requests, 455.4 KB, 15 pages, 0 restarts, ~4.9 s. Neither
    rotation guard fired - no rotation landed inside the walk, which is what the
    arithmetic predicts rather than evidence the guard works.
    The predicted clock-outage hole is there and this run can attribute it where
    coverage_gaps() declines to: 17.72 h, 2026-09-15 14:58 .. 09-16 08:41. The
    archive was empty beforehand, the gap is interior to one verified walk, and a
    3000-record buffer at 60 s cannot span the collected 64.41 h without skipped
    appends. The device did no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
2026-09-17 refactor(tasks): split the io tick's event half out of tasks.cpp
    tasks.cpp reached 998 of the 1000-line gate. Two sessions grew it
    independently -- one added the ambient task for the SHT40, the other
    tasksSetupOnboarding() -- so the next change to the file would have
    broken the build for a reason unrelated to that change.
    The seam is everything in the file that was never about scheduling:
    the two relay seams (relayStartAllowed, relayStartedHook), the four
    event publishers the io task drains at 1 Hz, and the post-watering
    response check. Not one DECLARE_TASK, handler body or addTask() moved,
    so the registration order stays one readable list in one file, and
    ioTaskHandler(), tasksSetup(), tas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
    [BuildConfig.h, task_events.cpp, tasks.cpp, tasks.h]
2026-09-17 fix(onboarding): declare the SHT40 and its bus in the s3-carrier template
    The esp-garden-hardware carrier arrived and is device b580. It was onboarded
    through its own setup portal and came up with no ambient sensor at all:
    "Sensors: 4 moisture, luminosity, flow, float switch", no Temperature, no Air
    Humidity, no Ambient Sensor row. templates/config.espgarden_s3.json carries
    io.i2c and io.sht4x; the compiled kJsonCarrier the portal actually writes did
    not. Nothing but that string decides what a portal-onboarded board reads.
    The template's own comment said why - it was written while "this firmware has
    no driver for" the part, and was not revisited when 2.14.0 added one.
    Adding the two blocks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
    [BuildConfig.h, test_onboarding.cpp]
2026-09-17 feat(scripts): migrate the ThingsBoard Cloud archive into the self-hosted instance
    The garden left thingsboard.cloud on 2026-09-17 at 17:19:40 and the new
    server starts life holding two minutes of history. tb_export.py was the
    reader and there was no writer; this is the writer.
    scripts/tb_import.py + tb_client.py backdate backups/telemetry.sqlite
    through POST .../timeseries/ANY, and the verdict is never an HTTP status:
    every key is counted on both sides in the same window and the pairs are
    printed, four values per key are fetched back and compared to the archive
    text character by character, and the run exits non-zero on any
    disagreement.
    Ran against the live instance (ThingsBoard CE 4.3.1.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
2026-09-18 fix(devices): probes sharing one power pin is the wiring, not a conflict
    /devices.html refused to save the esp-garden-hardware carrier's own layout:
    four resistive probes on one switched power bank, GPIO 14. It claimed each
    probe's powerPin separately, so four probes on one MOSFET looked like four
    peripherals on one pin and drew the generic duplicate message -- the one
    that says "one of them just reads or drives garbage", which is true of two
    peripherals and false of a power bank.
    The firmware allows it deliberately; validatePins()' sharing rule cites this
    exact case in its own comment. The page did not know.
    Claims now carry a kind, and the conflict is waived ONLY when every claimant
    on t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
    [devices_model.js]
2026-09-18 docs(tasks): close 018 — the operator changed the flag
2026-09-18 docs: the broker moved to tb.espgarden.com.br, and both boards are on 2.18.1
    Records what ran: the cutover off ThingsBoard Cloud, the move onto a real
    domain, that the devices' pinned CA needed no change (verified against the
    bundle AND against ISRG Root YR alone before either board was touched), that
    ca-export emits the fragile subset instead, and that 2.18.1 now boots on both
    families -- so the tasks.cpp split is no longer a diff nobody has run.
    Also records the two DHCP moves, because a board that changes address with
    nothing announcing it broke every default in this repo that spelled an IP.
2026-09-18 feat(sensors): add io.soilMoisture[i].powerAlways, default false
    The operator connected a resistive probe to Zona 1 of the S3 carrier and
    wants its power held up so the reading is stable. There was no config that
    could say so: an absent powerPin means the firmware never drives the pin at
    all, and on that carrier R9 holds SOIL_PWR_EN low, so "absent" is
    permanently OFF rather than the "permanently powered" the comment claimed.
    Inverting powerOn only moves which phase is energised, and mixing powerOn
    across probes sharing a pin lets the last index win in both directions.
    powerAlways ships false, so every existing board is byte-identical: the
    compiled default is off and each new branch is behi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
    [BuildConfig.h, config.cpp, config_io.cpp, sensors.cpp]
2026-09-18 docs: powerAlways ran, and it takes Zona 1 to the rail
    The A/B, one config key moved and everything else held constant, reproduced
    three times: powerAlways true gives Zona 1 0.00 flat (ADC 4095, var 0.00,
    stepSd 0 over 38 samples), false gives 44.1 at var 0.01-0.29.
    It is pinned from the FIRST sample after boot, not decayed into -- at 25 s
    uptime val, avg and var all read 0.00, where a reading that had fallen 44 to 0
    across those samples would leave the mean mid-range. So this is not the slow
    electrolysis the hardware repo warns about; that one is about the probe's life
    and is still unmeasured. The mechanism proposed instead -- the 50 ms settle
    lands inside the electrode's polarisation tran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
2026-09-18 docs(tasks): the S3 carrier is the garden now, with real pumps
    The operator swapped espgarden1 for espgarden-s3 and confirmed the relays drive
    real pumps. That invalidates the most load-bearing safety assumption in
    CLAUDE.md, which still calls b580 a bench board with nothing on the relay
    outputs and nothing planted.
    The consequence worth acting on: the carrier's INVERTED relay safe state is now
    load-bearing on a live garden and has never been measured. It is read off a
    netlist -- J200 to the module's active-low IN pins, the module's own pull-up
    believed to hold them high through a reset -- and CLAUDE.md says plainly that
    nobody has put a scope on a coil through a boot. On the WROOM boards t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
2026-09-18 fix(devices): carry every unrendered config key through a save
    buildDocument() rebuilt each io.relays, io.soilMoisture and moisture[]
    entry from the page's own model, which makes a rebuilt entry a silent
    DELETE of every key the page has no control for. On 2026-09-18 an
    operator renamed two probes on /devices.html and the saved document came
    back without io.soilMoisture[0].powerAlways, which was holding a probe's
    power bank energised. It was written down as a known hazard one commit
    earlier and cost a live setting the same day.
    Two changes. powerAlways is now read, rendered as a checkbox on the probe
    row and written back as a real boolean beside the power pin it needs; the
    cost is stated whe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
    [devices.js, devices_model.js, devices_render.js, sim_config.py]
2026-09-18 docs(tasks): 021 — the relays were tested, which is not the reset question
2026-09-18 docs: powerAlways did not reproduce the rail, and the headline was wrong
    The operator asked for powerAlways restored after the /devices.html save
    deleted it. Set true again on probe 0, rebooted, and Zona 1 did NOT go to the
    rail: 85.15 falling to 82.32 over 2.5 minutes at var 0.08-0.43. The entry's
    headline claimed continuous power destroys the reading in under a second. That
    is false as a general claim and is corrected in place rather than deleted --
    the 0.00 was real and reproduced three times when it was measured.
    The board was rewired between the two runs: one probe and three floating pins
    became four probes in real soil, and Zona 1's own gated reading moved 44.1 to
    ~82. So it is not th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
2026-09-21 docs: two probes were crossed, and the carrier's silkscreen is why
    The operator suspected moisture1 and moisture3 were swapped on the S3 carrier.
    They were, and neither the firmware nor the netlist was wrong: netlist.ipc
    gives J4-2 -> R11 -> SOIL1 -> U1 pin 26 -> GPIO 1 -> probe index 0, and the
    other three likewise, matching config.json pin for pin. The probes were in the
    wrong terminals.
    No reading could have decided it -- index 0 and index 2 sat at 71.7 and 73.2,
    1.5 points apart. What decided it was a controlled stimulus: the operator
    watered the pot he calls Zona 3 while all four channels sampled at 2 s, and
    only index 0 moved, 72.01 up to 74.53 and back over 118 s.
    Amplitude alone wo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
2026-09-21 docs(tasks): close 011 and 017 — the carrier is the garden, the domain is live
2026-09-21 docs: close 020, and correct the claim that 18:46 was the first relay run
2026-09-22 feat(tooling): relabel two crossed telemetry keys, and refuse the window
    tb_swap_keys.py exchanges moisture1 and moisture3 -- with their Now and Sd
    twins, all six or none -- over the window the crossed probes were wired for.
    Dry run by default; --apply is the only command that writes and needs --yes.
    It is a RELABELLING, not an interpolation: the (timestamp, value) multiset is
    identical afterwards and --verify says so. The operation is a permutation and
    --probe proves on a throwaway device that applying it twice restores the
    original exactly. Values are re-read non-strict and re-emitted verbatim as raw
    JSON literals, so ThingsBoard repeats its own typing decision -- 764 of 909
    moisture1Sd p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
2026-09-22 fix(history): a history.records change must not delete the stored history
    IoHistory::adoptSegmentLocked() dropped and removed any segment whose
    header disagreed with the per-segment capacity derived from
    history.records, so editing the buffer size in /devices.html silently
    wiped every stored record at the next boot.
    recordSize guards a FORMAT and stays absolute: reading 40-byte records
    out of a 48-byte file returns plausible garbage. Capacity guards an
    EVICTION POLICY, and a 48-byte record written into a 375-per-segment
    file is byte-identical to one written into a 1250-per-segment file.
    Segments of different sizes now coexist. A segment is full at
    segmentFillLimit(own, target) -- the small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
    [BuildConfig.h, config.cpp, io_history.cpp, sim_state.py]
2026-09-22 feat(tooling): fit soil drying from the device's own 60 s record
    scripts/drying_fit.py could only read backups/telemetry.sqlite, the 300 s
    ThingsBoard uplink, and hard-coded that period in three places. --history-db
    now reads the device's own /history.json archive through the new
    scripts/drying_sources.py, reusing history_archive.samples_for_probe(), the
    adapter moisture_fit.py --history-db already consumes. Both archives are
    opened read-only.
    Three thresholds were a delta per sample standing in for a rate:
    --step defaulted to 300; it now defaults to the source's observed period,
    which is what carries TAU_UNRESOLVED_STEPS with it (10 min -> 2 min).
    handling_windows() read STEP_MIN_P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
2026-09-22 docs: the Arranjo was still falling, and the brief said it was flat
    The brief handed to the drying fit said "8.92, flat since 09-21 14:46". That
    came off a window= query, which decimates and reports its stride, and the flat
    stretch is a 2.5-point wetting bump between 16:18 and 17:48 inside a continuing
    decline. Re-read from the device, the Arranjo is at 5.10 on 09-22 00:12 against
    29.16 thirty hours earlier: -19.37 points/day and still running.
    So the equilibrium-or-floor question the fit was asked to settle is answered
    with neither, and the last archived reading of 9.01 is ADC 3726 of 4095, nine
    points above the rail. The ASYMPTOTE_MIN_EXTRAPOLATION gate never fired on this
    curve; model re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
2026-09-26 docs: a full flash backup of the garden, and it found a core dump
    The whole 8 MB was read back over USB from b580 on 2.20.0 and verified against
    this tree: app1 is byte-identical to .pio/build/espgarden_s3/firmware.bin, and
    the partition table parsed out of 0x8000 matches esp_garden_8mb.csv entry for
    entry. Nothing was written to the board.
    Two things the read established that this file did not say:
    The coredump partition holds 10 756 bytes of real core dump, so the board has
    panicked or tripped a watchdog at some point. The 2026-09-17 line claiming
    there was no core dump is qualified rather than deleted -- it described that
    session, and nothing read here dates the dump.
    A byte-identical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
2026-09-26 docs: the clone booted on a second S3, and it ran the shrink path
    Wrote the 2026-09-26 full-flash image to a new ESP32-S3 (same part: QFN56
    rev v0.2, 8 MB flash, 8 MB AP_3v3 PSRAM). 39.9 s, hash verified by esptool.
    Every prediction in backups/flash/README.md held.
    Three things the restore established:
    The id arithmetic (mac[0] | mac[1] << 8) predicted cfd0 and the firmware's own
    ID: line agrees -- a third MAC checked. The config was duly rejected and the
    setup portal came up, which also means a clone is INERT on the network by
    construction: it cannot associate, so it cannot publish with the original's
    ThingsBoard token.
    The stored history crossed onto silicon that has never written a rec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
2026-09-26 docs: the S3 garden runs a new module, and four characters did the swap
    The carrier now sockets device cfd0 instead of b580, at 192.168.1.35 on COM5.
    Everything in this file that says b580 describes the retired module; the top of
    "What has actually run" and the Hardware v3 section now say so, and the serial
    port note records that the port belongs to the DevKitC rather than to the
    carrier, so replacing the module moves the number.
    The replacement is the full-flash clone with "id":"b580" overwritten in place
    with "id":"cfd0" inside the LittleFS region, and only that partition rewritten.
    The onboarding route this file documented would have worked and was not used: a
    straight replacement wants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
2026-09-26 feat(tooling): script the full-flash backup and restore over USB
    No web endpoint can read a flash back -- the OTA routes only write, and
    /spiffs/* reaches neither the app, the bootloader nor the partition table -- so
    the 2026-09-26 clone of the garden was done by hand. This is that operation
    written down.
    --plan is the default and a write needs --yes. A backup refuses without
    relay-safety evidence, because download mode stops the app and a reset on a
    board with a running pump is the one thing not to do. A restore verifies by
    re-reading the flash and comparing hashes, never by esptool's exit code. And
    --patch-id rewrites the four-character id inside the image's LittleFS region so
    a clone boo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
    [flash_clone.py, flash_image.py]
2026-09-28 feat(sensors): make the soil moisture sampling period configurable
    io.soilMoisturePeriodSec, 1..10000 s, default 1, editable in /config.html.
    The probe read moves out of the io task onto a moisture task that takes its
    period from the config: io also paces the relay, float, cloud and ET0 events,
    the step publisher and the /data.json cache, none of which may slow down with
    the ADC. The moisture accumulator window follows the period, floored at 1
    because setMaxLen(0) is a silent no-op.
    handleConfigGet() emits the key when the stored document omits it, so the
    field exists in the editor on a board provisioned before it did.
    Not run on hardware, and no period other than the 1 s default has run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
2026-09-28 docs: split the README into docs/, one file per subsystem
    README was 1000 lines and carried every reference section inline. It is now
    135 lines — what the project is, how to build it, how a board is first
    provisioned — plus an index of docs/.
    Moved verbatim, heading levels normalised and cross-links rewritten:
    hardware, configuration, authentication, web interface, soil moisture,
    evapotranspiration, cloud cover, telemetry, task schedule and tooling.
    Checked line by line that nothing was dropped.
    Records the convention in CLAUDE.md: prose lives in docs/, not in code
    comments.
2026-09-28 docs: move CLAUDE.md's reference material into docs/
    CLAUDE.md was 413 925 chars, 2.7x the 150k limit the harness warns about, so
    it cost ~100k tokens of context per session and was at risk of being truncated
    silently. It is now 38 451 chars: project layout, the rules that bite,
    commands, boot order, the scheduler, the config recipe, conventions and the
    checklist — plus an index.
    Everything else moved verbatim into docs/, one file per subsystem. The
    verification log alone was 175 857 chars, 43% of the file. Checked line by
    line that nothing was dropped: 1080 non-trivial lines in, 0 missing. Anchors
    that pointed inside CLAUDE.md were rewritten to the file that now holds them
    and every mark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
2026-09-28 refactor(ui): strip the documentation out of the pages
    The pages carried paragraphs explaining why the firmware works the way it
    does: electrolysis, the classifier's labelling, what a phantom sensor costs,
    which paths address relay index 0. A UI is not documentation and that material
    already lives in docs/.
    devices.html 3555 -> 464 chars of prose, moisture.html 641 -> 190,
    schedules.html 275 -> 129, config.html 181 -> 124. What stays is actionable at
    the point of use: units, what a control does, what a save requires, and the
    validation warnings, which are feedback rather than prose.
    Also removed the multi-line comment blocks from devices_render.js.
    Six envs build, 211 host tests pass, the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
2026-09-29 feat(tooling): deploy firmware and assets over HTTP, keeping the flash
    There was no PC-side uploader in this repo. The only code speaking
    /spiffs/upload and /updateEnable was dev_server.py, which implements them, and
    data/update.js, which is the browser page. Every deploy on record was done with
    a throwaway script, and the verification log shows nine pages sent one at a
    time that way.
    deploy_ota.py sends assets through POST /spiffs/upload and the firmware through
    /updateEnable + /update, so the filesystem partition is never rewritten and
    config, history and the moisture model survive. --plan is the default; a write
    needs --yes.
    It refuses an energised relay, a masked config backup, a prote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
2026-09-29 fix(sensors): no delay in the moisture task, and no invented settle cap
    settleMs was capped at 250 ms because the settle was a delay() inside the 1 Hz
    io task. Moving the probe read to its own task made that argument false, and a
    delay inside a task is not allowed anyway: background tasks are cooperative, so
    a handler that sleeps stalls every other one.
    The moisture task now ticks at a fixed 10 ms and is reentrant. It energises the
    bank, notes a deadline and returns; a later tick reads and de-energises.
    nextSample is stamped at the power-up, so the cadence is exactly
    io.soilMoisturePeriodSec rather than that plus the settle.
    setPeriod() is what a handler can change and enableDelayed() is n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
    [BuildConfig.h, config_io.cpp, devices_model.js, sensors.cpp, tasks.cpp]
2026-09-29 perf(sensors): the moisture task sleeps until its next deadline
    The previous commit polled at 10 ms, which is a lot to ask of a cooperative
    pump on an ESP32 for a sensor read once a second. The floor is now 50 ms, the
    tick the relays already run at, and the handler sets its own period to the time
    until whichever deadline is next instead of polling at all.
    The state machine is unchanged and stays the contract: woken early it returns,
    woken late it acts. The period is only an optimisation.
    Measured over 600 s with the scheduler polled every 1 ms: two wake-ups per
    sample, one when the settle is zero, and the gap exactly the configured period
    in every case. At a 1 s period, 1201 wake-ups inste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
2026-09-29 feat(tooling): refuse a stale asset bundle, and record the 2.22.0 deploy
    scripts/pio_assets.py builds .pio/assets/ only for buildfs, uploadfs and
    uploadfsota, so a plain `pio run` leaves it as it was. CLAUDE.md claimed the
    hook ran on every invocation, which is how a deploy came within one command of
    shipping a devices_model.js edit as the previous bundle. deploy_ota.py now
    refuses any file under data/ newer than the newest built asset, naming the
    command to run. It fired for real and was right.
    Also records what ran on the garden: 2.21.0 -> 2.22.0, five assets and the
    firmware, board down at 7 s and serving at 9 s, history 9232 -> 9233 and the
    filesystem untouched at 712/2432 KB.
    The 60 s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
2026-11-09 feat(sensors): sample the probe bank several times per power-on
    The bank used to be read once, at the end of the settle, and on cfd0
    every change of that settle stepped all four probes by up to ~420 ADC
    counts, always drier for a longer powered time. Nobody knew where the
    output stops moving, and each experiment cost a reboot and a seam in
    the calibration data.
    `io.soilMoistureSampleMs` takes a conversion every N ms while the bank
    is energised, and `io.soilMoistureTailSamples` makes the reading the
    median of the last N. Both default to 2.22.0's behaviour (0 and 1), and
    with the tail at 1 the published value is the same last sample, so the
    curve can be turned on without starting a new calibr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
2026-11-09 docs: record 2.23.0 on cfd0 and the first in-window probe curves
    The OTA and the defaults ran as designed: one sample per probe at
    exactly 2000 ms and readings where 2.22.0 had them. With a sample
    every 100 ms, six steady-state windows put the final sample on 2000 ms
    every time, and no probe plateaus by then: Espada still creeps
    ~16 counts per 100 ms, Arranjo ~19. The first window after boot was
    212 ms late and read ~22 counts drier, so scheduler lateness reaches
    the published value and is now measurable. Window-to-window spread is
    1..3 counts.
    device_http.post_config() was exercised against the garden for the
    first time, so its docstring stops calling it unexercised.
2026-11-09 fix(sensors): publish the probe value at the settle, not at the late wake
    No probe on cfd0 plateaus by 2000 ms. The end-of-window creep is 2-19
    counts per 100 ms, so a final sample taken late reads drier. On 2.22.0,
    22 % of Espada's single-sample publishes sat more than 0.6 points below
    their neighbours (median 0.94, max 3.98); on 2.23.0 it was 16 % of 95.
    - checkInternet calls Ping.ping(addr, 1). With a count of 2, ESP32Ping
    waits 1 s between the pings, which held the cooperative pump for 1.06 s
    every 15 s; one moisture window could not sample until 1062 ms. The
    three addresses are already the retry.
    - The published value is interpolated at exactly settleMs, between the
    last sample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
